ThyFriendlyFox/via/ee-agent-kit/docs/ARCHITECTURE.md

# Architecture

EE Workcenter is a toolchain installer, a Python command line, and a set
of skills that together run 4 gates on a KiCad 10 project. The table
has its 10 parts.

| Part | Folder | Task |
|---|---|---|
| Installer | `install.sh`, `requirements.txt` | Puts KiCad 10, ngspice, Java 21, FreeRouting, and a Python venv on an Ubuntu 24.04 machine. Idempotent. |
| CLI | `tools/workcenter` | Runs the engines against a project and reports 1 record per gate. `design` builds a design file, `render` makes images. Standard library only. |
| Generator | `tools/kicadgen.py` | Turns a Python design (parts from the KiCad libraries, nets, positions) into schematic, board, project, Specctra DSN, and merges the routed session back. Standard library only. |
| Skills | `.claude/skills/*/SKILL.md` | Tell the agent which gate comes next and how to read a report. Loaded by Claude Code from this repository or from a copy. |
| Fixture boards | `tests/boards/*`, `tests/test_gates.py` | The tests of the gates. 1 board passes everything; the others fail 1 named gate. |
| Manifest | `WORKCENTER.md` | The contract a project gets: tools, skills, gates, paths, requirements. |
| Templates | `templates/` | The files a project starts from: the verification package (`workcenter verify --init` copies `templates/verification/`), the brief and facts file for helpers on one package, and a first design file, a version's README and gates report (`templates/project/`). |
| Environment | `environment/`, `Dockerfile` | The 2 ways the installer reaches a machine: a Claude Code cloud environment setup script, or a Docker image on the official KiCad base. |
| Website | `site/` | 1 static page that says what the workcenter is, with real runs of its commands and a fixture board from its design file. Plain HTML, 1 stylesheet, 1 script; no install step. `site/build.sh` writes the folder a host serves. `site/media/` holds the pictures of the root `README.md`, each with the command that draws it. `tests/test_docs.py` holds the site's runs, its links and its build to the code, and each picture to the README that shows it. |
| Kit | `ee-agent-kit/` | How work on this repository is run. Process, not product. |

## Data flow

1. A cloud environment (or a Dockerfile, or CI) runs `install.sh`. It
   writes the KiCad PPA source, installs the packages, downloads the
   FreeRouting JAR, creates the venv, links `workcenter` onto `PATH`,
   and copies `WORKCENTER.md` to `/opt/workcenters/ee/`.
2. An agent opens a board repository in that environment. With 2
   repositories attached, the `attached-repos` skill assigns roles:
   the board is the project, this repository is the workcenter.
3. The agent runs `workcenter gates <project>`.
4. The CLI finds `<name>.kicad_pro` and its siblings, then calls
   `kicad-cli sch erc`, `kicad-cli pcb drc`, `ngspice -b`, and
   `kicad-cli pcb export ...` in that order, each writing into
   `<project>/build/`.
5. The CLI parses each JSON report or log into a gate record and stops
   at the first red gate. All records land in `build/gates.json` and on
   stdout, as text or `--json`.
6. The agent reads the red gate's report, fixes the schematic or board,
   commits, and runs step 3 again.
7. GREEN: `build/fab/` holds gerbers, drill files, the BOM, and the
   schematic PDF. `workcenter render` adds the images. The board is done.

A generated board enters at step 3 from `workcenter design design.py
--route`: the generator loads the libraries, writes the DSN, runs
FreeRouting, merges the session, and writes the `.kicad_*` files that the
gates then read like any other project. With `--seed <board>` the
generator first reads a previous board's tracks and vias (`board_copper`),
keeps the router copper that still fits the design (`seed_wiring`), and
writes it into the DSN, held where it connects and unfixed at its loose ends.

## CLI

| File | Task |
|---|---|
| `tools/workcenter` | `find_project`, 1 `gate_*` function per gate, `gate_render` (with `parts_without_body`), `gate_procure` (parts files, `order_for`), `cmd_gates` for the ordered run, `cmd_design` for design files and `check_design` for `--check`, `cmd_sim` for one deck (`--deck`, `--keep`), `cmd_doctor` for engine status, `emit` for output and exit codes. Tools that are not gates: `cmd_fetch` (a library file and its `sources.csv` row), `cmd_curve` (a PDF's curves on a plot's axes: `outline_middle`, `crossings`), `cmd_ci` (a GitHub workflow replayed), `cmd_mutate` (a firmware's mutation list). |
| `tools/pdfcurve.py` | One PDF page's vector paths and text lines as JSON, with pdfminer under the venv; `curve` reads its output. |
| `tools/kicadgen.py` | `parse`/`dumps` for S-expressions, `load_symbol`/`load_footprint`, `Design` with `schematic()` (stub-and-label, or wired by `SchRouter` when `sch_wires` is set), `board()`, `project()`, `dsn()` (with each layer's hole clearance from `hole_clearances()`), `merge_ses()`, `seed_wiring()`, `write()` (island stitching recorded in `stitches`); `load_design()`, `board_copper()` and `route()` for the CLI; `symbol_add()` for a symbol from a datasheet's pin table. |
| `tools/inspect_board.py` | The engine of `workcenter inspect`: a `Board` read with KiCad's `pcbnew` (items, rule areas, courtyards, the stackup, the project's net classes and `.kicad_dru`), `touch`/`groups` for connectivity, one `cmd_*` per view. The CLI runs it under the venv's Python with its arguments as JSON; it writes only `map`'s images. |
| `tools/stretch.py` | Grows a design file at a cut through Python's `ast`: board x-coordinates in code move, comments and strings never do. Standard library only. |
| `tools/doctools.py` | The document commands: `docs`, `costs`, `pictures`, `version new`, `diagram`, and `gates_report()` for `gates --report`. `register()` adds them to the workcenter's parser with the CLI module as `cli`, so they report through its `Result` and `emit` and reuse `gate_procure` and `gate_render`. Marked blocks (`fill_block`) are the only text they rewrite in a hand-written file. Standard library only. |
| `tools/scene.py` | Assembly scenes: a routed board loaded with KiCad's `pcbnew`, bodies on empty anchor footprints, stills from kicad-cli, the turning GIF from `workcenter render --views spin`. Runs under the venv's Python; a project's scene script imports it. |

## Boundaries

| Boundary | Rule |
|---|---|
| CLI ↔ engines | Subprocess only. The CLI reads the engines' report files; it never imports KiCad or ngspice libraries. A venv package (pcbnew, shapely, pdfminer, PyYAML) runs in a subprocess under the venv's Python and hands back text or JSON. |
| Workcenter ↔ project | The workcenter reads the project and writes only `<project>/build/` or `--out`. Project source files are never modified by a gate run. |
| Kit ↔ code | The kit is read by agents and humans. Nothing executes it. `verify/verify.sh` checks its invariants (placeholders, skill parity). |
| Installer ↔ everything else | Every other part assumes the installer ran. Nothing else installs software. |
