ThyFriendlyFox/via/ee-agent-kit/STATUS.md

# STATUS.md — where the project actually stands

The single source of truth for project state. Claims require evidence: a
passing gate, a linked run, a tag. Updated in the same commit as the
behavior change. The weekly cycle (WEEKLY.md step 5) refreshes it.

| Area | State | Evidence |
|---|---|---|
| `install.sh` on Ubuntu 24.04 | ✅ | CI run 1 on PR #1 green in 69 s; runs end to end in the cloud session. |
| Gates ERC, DRC, SIM, EXPORT | ✅ | `make verify`: fixture `pass-rc-divider` GREEN with `--strict`, `fail-drc-clearance` red at DRC, `fail-sim-spec` red at SIM. `tests/test_simgate.py` (39 tests): an `altermod` line with 2 parameters failing its deck with the one ngspice drops named, an analysis ngspice gave up on fails its deck though a later one completed, a corner ngspice does not finish fails with its first error line and its log named, a complex value is no measure, each way an expect file is refused (a bound that is no finite number and `"at": "nominal"` with no source among them), a value ngspice reads as another number failing its deck, a name printed 2 times judged on each value, a floating node warned and failing `--strict`, a `.spiceinit` in the user's home left out of a deck and of a corner, every warning printed with the verdict as the last line, a count of jobs under 0 a usage error, the verdict lines (`GREEN with N warnings`; `GREEN ... (nothing to run for: erc, drc, export)`; `SKIPPED (SIM: engine missing)` with exit code 2 and never GREEN; `REQUIREMENTS MET` only when every one passes at its corners). |
| SIM corners | ✅ | `sim/corners.json`, `tools/simcorners.py`. `tests/test_corners.py` (83 tests): an `altermod` line with several parameters named, the file's refusals (a range without its source, a `fill:` left in, an unknown key or deck), values found in elements, `.param` lines, a deck's own `.subckt` and 5 forms of `alter`, on a continuation line, behind `r=` and as an expression; each corner's text; 2 parts written from 1 parameter moving apart; each part alone at both ends and half-way; a measure that peaks inside a range closed in on (a series LC's gain 1.0 with its capacitor 13.4 % low, 0.239 and 0.072 at the ends); every combination of the ends (a bridge's 0.25 V with 4 resistors off together, 0.064 V with 1); the warning above 64 runs; a supply moved by its source; seeded draws that repeat, with their temperatures inside the named range; a deck that sets its own temperature and an element held at one; bounds held as written only; the word-named parts a tolerance run left at their written value. Fixtures: `pass-rc-divider` 46 corner runs, `vout` 2.4605 to 2.54175 V inside 2.45 to 2.55, margin 8.25 mV; `fail-sim-corner` inside both bounds as written, 32 corner runs, `vref` 0.4216 V at 85 C with R1 +5 % and 5 more corners, `vout` 2.625 V at R1 -5 %, R2 +5 % and 9 more. On a scratch copy of Last Hit v0.16, 1 % resistors and 20 % capacitors: 12 decks, 678 corner runs where the first search made 153, 0 failures and 22 warnings over the board's 0 to 40 C; over -20 to 85 C, 5 failures: the 6 A current-sense reading 1.0763 V at 85 C with R7 and R16 1 % low (and 8 more corners) against 1.14 to 1.26 V, 3 more bounds of that deck, and the MOSFET deck's transient aborting at -20 C. The second run took 454 s on 4 processors. |
| Frequency plan | ✅ | `sim/frequency-plan.json`, `tools/freqplan.py`, P30. `tests/test_freqplan.py` (43 tests): a source read in every form a deck writes it and named when its frequency is no number, bands from a guard or from Q, a harmonic in a band, 2 sources that can run at 1 frequency, an answer that needs a bounded measure and the element that drives it, a stale answer, a stimulus outside every source, resonances read across the corners, a resonance that meets its source between the ends of its parts (22.0 mV against 17 mV, 13.2 mV at most at the ends), a resonance from a deck with no corner refused, a plan's measure missing at a corner refused. Fixtures: `pass-lc-filter` GREEN with `--strict` (3 decks, 94 corner runs, the 15.9 kHz resonance between 13.26 and 19.84 kHz over its parts' 20 %, the clock's overlap answered by a deck run with L stepped against C); `fail-freq-overlap` red on the plan alone: the load's third harmonic in the band, the rail swinging 6.78 V while its average holds. |
| Deck bundles | ✅ | `workcenter sim --bundle DIR`. 7 tests in `tests/test_simgate.py`: a bundle run from another folder with an empty home gives the gate's numbers, the deck alone does not, a bundle that gives another number is named, a model's own includes come along, a deck that reads a file beside it runs from anywhere, a path with a space runs, a folder that is no bundle is refused and left as it was. On a scratch copy of Last Hit v0.16 the 12 decks' bundles each give the gate's measures from another folder, and no file in them names a path of the machine; run bare, 3 of those decks stop with an error and 3 print other numbers with exit code 0 (M105). |
| `workcenter next` | ✅ | `tools/guide.py`. `tests/test_guide.py` (72 tests): the crowded `altermod` failure sent to the simulate skill's rule, every hint points at a file and a heading that exist, each kind of failure line gets its fix, no sentence it prints is over 20 words, a path to a file answered with its project's folder, a folder with 2 project files told to name 1, a folder that is not there made first, an empty folder given the 2 ways to start and no RUN line, the gates run first and again when an input is newer, a red gate gets its first failure, GREEN with a warning is not done, an absent engine gets the install step and a report from a run without it is run again once it is found, a package is done only with its requirements met, a design file that is refused answered with its first problem, a finished project given no command, the project left as it was, the fixtures walked to their answers. On 2026-11-11 the smallest model took a supply filter from a paragraph to `gates --strict` GREEN with it (131 corner runs; it moved the filter's resonance off the PWM when the plan failed), then a filter board: ERC 0 errors, DRC 0 errors and 0 unconnected, 1 deck over 14 corner runs, 22 gerber files, in 38 tool calls. |
| A first design file | ✅ | `templates/project/design.py` and the generator's refusals. `tests/test_designfile.py` (14 tests): the template generates, routes and passes ERC and DRC as it stands; a part added to it without its simulation is refused; a namespace that is no UUID, `power_nets` that is no dict, a flagged net with no power symbol and a symbol the library lacks each stop with the line to write; a part placed from another origin is a `part:` line with its place in board coordinates; a part that overhangs the edge is kept; a route that joins nothing is exit 1; the `pull:` line ends with its entry; a refused design file is 1 `file:` line with its line number. Both designs of Last Hit v0.16 regenerate to their committed bytes. |
| Documents held to the code | ✅ | `tests/test_docs.py` (21 tests): each example page is what `site/examples.py` writes from the example's files; each value a check's drawing marks is a number of its test circuit's files or of a run on the page; every flag a document gives a command against that command's `--help`, the site's page and `site/media/README.md` among the documents; `--json` on either side of the command; every command in `README.md` and `WORKCENTER.md`, every skill, every tool file, every fixture's row, every cited mistake and process, the repository's name, root `AGENTS.md` equal to `CLAUDE.md` (`make verify` checks that too); each of the 8 runs the README, the site and the Open Graph page show (1 on the example project) against a fresh run of its command, the seconds and the checkout's folder apart; every picture and link in the README and in `site/media/README.md`, each picture in `site/media/` shown there, and the code the site's page and the first picture show a run of lines of the fixture's design file; the count of commands the README states; no commit in the history of the checked-out branch names an assistant as its author or credits one in its message (the owner's decision of 2026-11-11); older branches of the remote still hold such commits until the owner deletes them. |
| Example project, a motherboard | 🚧 | `examples/threadripper-matx/`, Basalt: a microATX board for Threadripper on sTR5 in version folders, built in a loop logged in its `LOOP.md`. v0.1 (the floor plan, the 4844-land socket, 14 phases, every supply in a pour), v0.2 (the DDR5 buses, 576 traces) and v0.3 (77 parts of ports and headers): `workcenter gates` GREEN with no warning on each. The PCI Express and M.2 lanes are not drawn: 151 of 234 route on a scratch copy (its v0.3 README, "Open items"). Not ordered. |
| Example projects | ✅ | `examples/universal-controller/v0.2`, Rosetta on an Xbox 360-style board: `workcenter gates .` GREEN with 6 warnings (silkscreen at the edge: the 2 USB receptacles, the ESP32 module, the regulator); 6 decks, 370 corner runs; `render --strict`; `make -C firmware test`. v0.1 is archived. Not ordered; firmware is the knob's decoder only (its README, "What is open"). Signet, `examples/ring-mouse` (v0.1 to v0.4, a version per pass of its loop): every tile of v0.4 GREEN, the radio with 2 legend warnings (the module's outline over its antenna edge) and the power tile with 1 (the charger's pin-1 mark at a joint pad); 1 deck, 52 corner runs; `make -C firmware test`; `ring.py` refuses a ring whose neighbours miss their shared corner. Not ordered; the module's datasheet and the IMU's axes not read (its README, "Open items"). `examples/fire-alarm-communicator/v0.1`, Herald: `workcenter gates .` GREEN with 7 warnings (the silkscreen of the 5 terminal blocks and the USB receptacle at the edge they face); 8 decks, 573 corner runs; `make -C firmware test` (the inputs, the hook, a DTMF decoder held to ITU-T Q.24's limits, a whole Contact ID call). Not ordered; the station's protocol and the radios' firmware are not written (its README, "What is open"). `examples/anc-speaker/v0.1`, Hush: `workcenter gates .` GREEN with 6 warnings (the silkscreen of the jack and the switch crossing the edge they hang over, and TI's model warning in the deck that checks the fitted one against it); 7 decks, 986 corner runs. Not ordered, no verification package yet (its README, "Open items"). `examples/snapdragon-dev-board/v0.2`, Wyvern, one flat board with a QCS6490 module soldered on by its 662 pads: `workcenter gates .` GREEN with 16 warnings (5 silkscreen outlines at the edge, 4 vias with nothing past them, 7 decks with no temperature term): DRC 0 errors and 0 unconnected; 7 decks, 397 corner runs, a frequency plan with no overlap; v0.1, the Snapdragon 845 module on 3 sockets, is archived; laid out as a board repository (series README, `parts/` priced by `workcenter costs`, `library/sources.csv`, `CONTENTS.md` by `workcenter docs`, pictures by `workcenter pictures`). Not ordered; no firmware (its README, "Open items"). |
| Website | ✅ | `site/`: a home page with 4 runs: the owner's headline under the wordmark, built as a board is; a strip of the 21 agents Via works with; the example project Herald (a drawing of its routed board, copper first, its 127 parts labelled from the design file, 4 at a time, 1 of them swapped for the next every 3 seconds, KiCad's library with 12 datasheets' first pages, its README and its gates report, a 3D model the reader turns, loaded only as the reader nears it, its gates run); a card in 3D for each of Herald, Hush, Signet, Rosetta, Wyvern and Agentcast; the 4 checks as 6 drawings of test circuits a check stopped; and Herald's supervised inputs as code, schematic and routed board. A page for each of the 6 examples in `examples/`, written by `site/examples.py` from its README, its versions' TIMELINE.md or "What changed" sections and its board: a turntable, a board explorer drawn from its `.kicad_pcb`, its checks, its steps and what is open. The redrawn site is on the branch `claude/wonderful-planck-hz2c8o`, in a preview, until it merges; copy written to the website section of `docs/STYLE.md`, no fixture board shown as a product; the Via wordmark; motion with Motion 14.6.0, still for a reader who asks for reduced motion; `og.png` (1280 x 640); live at <https://via-kappa-five.vercel.app>. On 2026-11-11 that address answered 200 with the canonical link and the Open Graph tags of its own address, every file the page names answered 200, and an unknown path answered 404 with the site's own page. Production follows `main`: on 2026-11-11 Vercel built it from `main` after the push that collapsed the branches. On 2026-11-12 <https://via.reagent-systems.com>, the address the canonical link names, answered 200 through Cloudflare, which keeps a stylesheet, a script or a picture 4 hours and the page 0. `tests/test_docs.py`: every link names a file, an id or a path in the tree; `site/build.sh` builds with an address and without one, names `site.css`, `site.js` and `effects.js` with their checksum, copies every file a built page names and every datasheet page a label names, at the size the label reserves, and refuses a folder that is not empty and an address that is none; the image has the size the page states. |
| `kicadgen` design generator | ✅ | `tests/test_kicadgen.py` (87 tests): wired schematics (pin positions at each angle as KiCad's ERC reports them, crossings and ends the router keeps, a wired divider ERC-clean with its declared netlist and no parity warning, labels where asked, off-grid pins refused, the stub-and-label default unchanged, a symbol drawn as banks wired between its banks, an A0 sheet wired across its width), the hand-via check's grid finding what holding each via to everything finds, in the same order, parser, derived symbols, open-pin nets, DSN with planes and fixed wiring, session scale and echo handling, pours filled and stitched, hand routes, rounded corners and stadiums, a radius per corner, board thickness and the two-layer stackup, project footprints, keep-outs in both via placers, non-plated holes in the via check and in the router file, four-layer boards (inner layers, stackup, a plane the router never sees, a real route on three layers, island vias to the plane and clear of tracks on the layers they pass), custom pads mirrored onto the bottom face, sized from their shapes, and handed to the router as their outline, the hand-via check and the design command's refusal, via sizes against the board's rules, the no-`cd` hook, the hook against scripted test edits and the installer of both, per-part 3D bodies, `wrlgen` bodies. Real boards GREEN in their own repository; the latest is 38.0 x 12.7 mm on four layers, two 510 connectors and a 10440 cell in a line, keep-outs under the collars, every chip on the bottom face, and a two-layer 0.8 mm display board standing on its flat end. |
| A generated schematic that simulates | ✅ | `d.sim`, `d.no_sim`, `d.sim_directives`, `d.check_sim` in `kicadgen`; `Design.sim_problems()`; the `sim:` lines of `workcenter design`. `tests/test_simfields.py` (21 tests): the values KiCad reads as numbers, a library read for its subcircuits and models, the fields on each symbol and, hidden, on its footprint, a bound part on a board with no parity warning, each wrong binding's line, a map that is not whole bound by position by KiCad 10.0.8 with exit code 0 and refused by the check, the ERC reporting a library that is not there, the exported netlist run in ngspice against 4 voltages computed by hand, `workcenter design` exit 1 with its `sim:` lines. On a scratch copy of Last Hit v0.16: 0 placeholder lines in the exported netlist where there were 29, and its current-sense reading 1.198 V at 27 C, 1.099 V at 85 C, as the hand-typed deck gives. Not checked: KiCad's own simulator window, which has no command line. |
| Autoroute, generated designs | ✅ | `workcenter design --route --rounds [--seed BOARD]`: DSN writer, FreeRouting, session merge, pour islands stitched or re-routed, each stitching via named with its island, a red run's last line naming its failures. Two round-trip tests make DRC GREEN when FreeRouting is installed. `tests/test_routing.py` (11 tests): each layer's hole clearance read from the fab's rules, written into the DSN as grown via and pad copper and held by every via check; a fixture where the old DSN put a router via 0.3281 mm from an inner track (Sierra wants 0.3302) and the new one keeps 0.3581; a bus routed, a part moved onto a track and routed again from the seed with the five untouched lines kept; the seed's sifting by reason; both net forms read from a board; the stitch and red lines; a T-link the merge keeps. |
| Autoroute, hand-drawn boards | 🚧 | Produces a session from a KiCad-exported DSN; import is manual. ROADMAP item 3, "Headless autoroute for hand-drawn boards". |
| `workcenter render` | ✅ | Schematic, board top and bottom, 3D top, bottom and isometric images with part bodies when `kicad-packages3d` is installed, plus the project's own `wrlgen` bodies; every layer with something on it, one PNG each, and an overview sheet; on request a GIF of the 3D board turning round (FFmpeg). Each 3D view in the board's own stackup colours (since 2026-11-11; green before, whatever the stackup named). PNG through librsvg. `tests/test_gates.py` (27 tests): layers drawn and empty ones skipped on the fixture, the view list, the GIF's frames and loop, the skip without FFmpeg, the parts drawn without a 3D body and `--strict` failing on one, every 3D render asked for the stackup's colours. |
| `workcenter procure` | ✅ | A schematic's BOM priced from parts files: the cheapest order per line at each unit count, totals per supplier, lines not priced, short of stock or checked too long ago. `tests/test_gates.py`: the fixture priced to the cent, the failures and the skip. |
| Skills | ✅ | 9 skills with frontmatter, checked by `make verify`; `kistack` routes to 11 vendored kistack skills. |
| `workcenter placement` (kistack) | ✅ | `tests/test_placement.py` (6 tests): kistack's checks on its own synthetic board read through the pcbnew stand-in, with the answers kistack's tests expect (pin 1 VDD, a decoupler with its ground pad toward the pin, every local link routed together); `move` and unknown checks refused. |
| Pull-resistor check | ✅ | `tests/test_pulls.py` (6 tests): a gate only an MCU pin drives is reported; a pull to a rail or to the gate's own source holds it; a series resistor does not; an output pin drives the net; switches and I2C lines need a level and a declared net is taken; `workcenter design` lists them and fails only with `check_pulls`. On Last Hit v0.10 and v0.11 it reports the button (the MCU's internal pull-up) and the display's I2C lines (pulled up on the display board), and no gate or enable. |
| Fab rule sets | ✅ | `rules/sierra-circuits-web.kicad_dru` with its sources; `tests/test_fab.py` (9 tests): the fixture `fail-fab-sierra` GREEN plain and red with `--fab`, the passing divider within Sierra's limits and left untouched, an unknown fab refused, the board-wide minimums, `Design.fab` writing the rules and refusing a 0.6/0.3 mm via, a 0.3 mm net class still failing at 0.25 mm under the fab, the project rule file never looser than the board (M62). |
| Part sources and vendor models | ✅ | `workcenter sources`: a datasheet row for every part, a spice row for every U, Q and D, each kept file unchanged and printing its revision, each model loading in ngspice with its sub-models; `--fetch` under the workcenter's own name. The SIM gate runs a deck's listed vendor models translated into `build/` and holds each to its datasheet with `warn` bounds. `tests/test_sources.py` (13 tests): the reference prefixes, PSpice RES models folded and tolerances dropped, rows refused, a library that holds what its rows say and every file the command writes, each way one drifts, the skip with no library and the error on a bad row, a fetch from a local server (same, changed, refused, the agent named), a translated model in a deck run from its own folder, a warn bound failing only `--strict`. On Last Hit v0.12 both boards pass with 24 files kept; TI's TLV75533P model is 1.25% high and its light-load dropout ten times the datasheet's, Diodes' ZXCT1009 model inside every row of its table. |
| `workcenter inspect`, `tools/stretch.py`, parts keep-outs | ✅ | `tests/test_inspect.py` (21 tests) on the fixture `inspect-four-layer` (four layers, a 10 mm In2 run, a copper and a parts keep-out, Sierra's rule file, a pour island on purpose): a known run's resistance from first principles, a T-junction without a stackup, the 13 mil inner drill rule inside its 5 µm window, a keep-out and a courtyard overlap by name, a new part from its footprint, a net cut in two, the island, the crossed net left open, the window's items, one PNG per layer, the fixture regenerating byte for byte, `stretch.py` on code and not comments; `tests/test_kicadgen.py`: the parts keep-out in the board, the DRC and `workcenter design`. On Last Hit v0.16 the joint's In2 run reads 56.8 mOhm and C5 to U2 64.3 mOhm. |
| Verification packages | ✅ | `workcenter verify` and P28. `tests/test_verify.py` (32 tests): a complete package passing and its report; a check judged at its measure's least and greatest corner and failing there with the corner named, whatever the deck's own bound says; a requirement whose deck ran no corner judged as written only, not met and failing `--strict`; an expect file that is not JSON as 1 problem line; `--strict` failing a package with no corners; the last line `REQUIREMENTS MET` or `NOT MET`; `--strict` on an OPEN requirement; a quoted number off the run; a rounded quote that matches; a verdict against its check; a requirement with no row; a deck with no writeup; a writeup without its nodal analysis; a dead link; a requirement with no source; the skips with no package and no ngspice; `--init` writing and never overwriting, and leaving the helpers' `BRIEF.md` and `FACTS.md` out; units and checks parsed; the owner's decisions (a withdrawn requirement named and out of the counts, refused in the traceability table, in a requirements table and in an expect bound, its date and who made it required; a restated requirement's dated decision). The Last Hit v0.14 package passes: 60 requirements (40 PASS, 15 FAIL, 5 OPEN), 175 quoted values matching the run; v0.16's with REQ-USB-01 in a Withdrawn table: 64 requirements (56 PASS, 2 FAIL, 6 OPEN), REQ-USB-01 named, 276 quoted values matching the run. |
| Document commands | ✅ | `workcenter docs`, `costs`, `pictures`, `gates --report`, `version new`, `diagram` and `tools/scene.py`. `tests/test_doctools.py` (21 tests): a marker named in a sentence taken as prose, a version's contents and datasheets (series sheets, a part with no row, a stale copy removed, a hand-placed file kept, the refusal without a list), every board of two versions priced to the cent into two marked files and an unclosed block named, the gates report refreshed round hand-written prose, P22's steps on a git repository with its step 4 check, the diagram's routes and legend, the pictures manifest, its framing check and its copies, a scene placed, rendered and turned. On a copy of Last Hit: `costs` reproduces all 26 lists and the 16 versions' totals, `docs v0.16` the datasheet table, `version new v0.17` passes P22 step 4. |
| Datasheets, simulation and CI tools | ✅ | `workcenter fetch`, `curve`, `sim --deck --keep`, `design --check`, `ci`, `mutate`; `kicadgen.py symbol-add`. `tests/test_fetch.py` (6: a file and its row, the append in the file's own line ends, a duplicate refused before any request, a 403 asked once and nothing written, a file that differs left alone, a zip member), `test_curve.py` (7: an outline's middle, crossings in decades, malformed axes, a PDF the test writes listed and mapped through pdfminer, the venv's pins), `test_ci.py` (4: environment carried, `needs` ordered, red at the failing step, what cannot replay, working directories), `test_mutate.py` (3: caught, survived, did not build, a stale `build/` left out, anchors first, a Python list read as a literal), 2 in `test_sources.py` (one deck the gate's way, the hand-run command reproducing it), 4 in `test_kicadgen.py` (`--check` same, differs, the design step's own failure; `symbol-add` on the grid, appended, refused, ERC-clean in a design). On Last Hit v0.16: `fw_is` 0.505 V, `design --check` exit 0, 50 of 50 mutations caught; the board's firmware CI job replayed GREEN on a copy (12 versions); the fuse datasheet fetched once with the SHA256 its row records. |
| Chip gates, from RTL to a mask layout | ✅ | `workcenter chip gates` runs LINT, SIM, SYNTH, LAYOUT, STA, GLSIM, DRC, ANTENNA, LVS and EXPORT on the sky130A process. `tests/test_chipflow.py` (94 tests), `tests/test_chipfront.py` (32) and `tests/test_chipback.py` (45) hold the readers and each gate's judgement to real reports of its engine, kept under `tests/chips/samples/`. `tests/test_chips.py` (15 items) runs 9 fixture chips: 7 are red at 1 gate each, and `pass-counter` and the acceptance processor `pass-acc8` are GREEN with `--strict`. SIM proves the benches on every run: it makes each change of `rtl/mutations.json` in a copy of the RTL, and all 5 and all 18 are caught. `workcenter next` names a chip project's one next step (`tests/test_chipguide.py` (30 tests): its answers alone take the template from its first file to GREEN), and the skills `chip-design` and `chip-gates` hold the procedure. The processor is 760 cells and 132 flops on a die of 152.38 um by 152.38 um with a 40 ns clock. Its run takes 217 s on 4 processors; the least setup slack is 25.1717 ns at `max_ss_n40C_1v60` and the least hold slack 0.2974 ns at `min_ff_n40C_1v95`. Every gate leaves a record of the files it read and wrote, the project's files as its engine lists them, and EXPORT asks all 9 before it hands out the layout: a header changed after LINT passed, a bench's bounds added after SIM passed, or a layout built from an older netlist is refused. `workcenter next` holds the files to the same records before it says a chip is done. A small model built 2 chips of its own with `next` alone on 2026-11-12: an 8-bit PWM that passed all 10 gates and stopped at `--strict`, on a limit the guide did not explain; then, with that mended, a UART transmitter to GREEN with `--strict` in 13 answers. A reviewer who had not written the gates attacked their judgements (P14 step 6): 15 cases, each a test now (M169). GREEN says that the open engines found no fault: no foundry deck runs here. Shipped 2026-11-12. |
| Mistake log and processes | ✅ | `MISTAKES.md` M1 to M180, `PROCESSES.md` P1 to P34; `make verify` checks every entry names an existing process and every process has a "Done when" line. |
| Cloud environment | 🚧 | `environment/setup.sh` written; not yet set on an environment by a human. |
| Docker image | 🚧 | `Dockerfile` written; `release.yml` builds it on the first tag. On 2026-11-11 it was built in a cloud session (with the session proxy's CA added in a scratch Dockerfile), and the example project was designed, routed and gated in it: `workcenter doctor` all engines ok, KiCad 10.0.8, ngspice 44. Before `install.sh` added the full Java runtime on Debian, the image could not route. With ngspice 44, `tests/test_simgate.py::test_a_bundle_that_gives_another_number_than_the_gate_is_named` fails: it expects ngspice 42's 1 error line and gets 2. |
| CI | ✅ | `ci.yml` green on PR #1; runs on every PR and push to `main`. |

States: ✅ done (gated) · 🚧 in progress · ❌ not started · 🧊 frozen/won't do.

## Current week

- **Shipping:** out-of-band — corners, a frequency plan and bundles in the SIM gate, verdicts that say what ran, and `workcenter next`, from an engineer's review of Last Hit v0.16; then what 2 reviews of that work and 2 runs by a small model found. Chip design, from RTL to a mask layout, shipped on 2026-11-12: 10 gates from RTL to a GDSII layout on an open process, an 8-bit processor GREEN with `--strict`, and a small model's own chip built with `next` alone. The repository's public face (the website in `site/`, the Open Graph image, the README's head) shipped out of band on 2026-11-11. Later that day an example project, Rosetta, and a site that moves shipped out of band, and then a second, Signet, a mouse worn as a ring, and a third, Herald, a fire alarm communicator. The same day the owner had the branches collapsed into `main`: it holds the gates work and the site, 55 commits that name the owner alone.
- **Last release:** none
- **Known red:** none locally. The cloud setup script and the Docker build have not run yet.
