ThyFriendlyFox/via/ee-agent-kit/ROADMAP.md

# ROADMAP.md — the source of all work

**This file is not optional.** Every feature the agent builds flows down
from here. If it isn't on this roadmap, it doesn't get built; if it needs
building, it gets added here first. One item ships per weekly cycle
(see `WEEKLY.md`).

`provisional: true` — the queue below was seeded at setup by the agent.
The human re-orders it.

## North star

EE Workcenter is the environment an agent steps into to take a KiCad
project from schematic to fabrication outputs with every gate green,
without a human running a tool by hand. Everything here serves that:
the toolchain installs itself, the gates are the definition of done, and
the skills tell the agent which gate comes next.

The owner's measure, 2026-11-10: a small model reaches the same working
design as a large one, and no electrical engineer has to find afterwards
what the gates left out. So what an engineer would ask lives in a gate
that runs it (corners, the frequency plan), and what comes next lives in a
command that says it (`workcenter next`), never in the reader's judgement.

## Feature Queue — ordered; top unblocked item ships next

### 1. A circuit walked stage by stage
- **Promise:** A command writes 1 page for a power or signal path from the project's decks and their corner records. Each stage is a chain: given, equation, computed value, the deck's measure with its span over the corners, what follows, and what the stage hands on. The range a stage is given is the range the stage before it hands on, and the command fails a page where the 2 differ. A node table gives each node's value under each condition, and every stage states its margin.
- **Evidence:** The page the reviewing engineer wrote by hand for Last Hit v0.16's power path (9 stages and a summary, on the project's branch `community/power-path-breadboard-notes`), written again by the command from the project's files with every number matching a fresh run. The thin margin that page found, a hardware trip at 6.17 A over a firmware limit of 6 A, is named by the command.
- **Use case:** Review a board before the bench (a new use case).
- **Scope guard:** The designer writes each equation in a writeup (P28). The command checks the chain and assembles the page. It derives nothing.
- **Status:** ready

### 2. A bench plan with the readings the decks predict
- **Promise:** A command writes a bench plan for a board, stage by stage: the stand-in for each part a breadboard cannot hold, what the breadboard cannot prove and which deck or board test proves it instead, the stand-ins for the controller's lines, the instruments, and for each test point the reading the decks predict with its span over the corners.
- **Evidence:** The reviewing engineer's breadboard notes for Last Hit v0.16 (the same branch) written again by the command: the stage-by-stage substitutes, the list of what a breadboard cannot prove, and each expected reading taken from a corner record.
- **Use case:** Bring a board up on the bench (a new use case).
- **Scope guard:** A stand-in comes from a table a person fills, each row with its source and what differs from the board's part. The command never invents an equivalence.
- **Status:** ready

### 3. Headless autoroute for hand-drawn boards
- **Promise:** `workcenter autoroute --apply <project>` reads any `.kicad_pcb` (footprints, pads, outline, nets, existing tracks) into the DSN writer that `kicadgen` already has, runs FreeRouting, merges the session into the board file, and the new fixture `route-me` passes DRC with 0 unconnected items afterwards, with no KiCad GUI step.
- **Evidence:** `tests/test_gates.py::test_autoroute_apply_routes_fixture` green in `make verify`; the fixture's DRC report attached to the PR.
- **Use case:** Route a board (`docs/USE-CASES.md`).
- **Scope guard:** No routing heuristics of our own. No GUI automation. The generated-design path already works (`workcenter design --route`); this item is the board-file parser in front of it. Zones and arcs may be out of scope for the first cut and must be reported, not silently dropped.
- **Status:** ready

### 4. Board gates as a reusable GitHub workflow for board repositories
- **Promise:** A board repository that adds 1 workflow calling `ThyFriendlyFox/via/.github/workflows/board-gates.yml@main` gets `workcenter gates` run on every PR, with the gates table in the job summary and a red check on a red gate.
- **Evidence:** A run link from a board repository, plus `tests/boards/pass-rc-divider` run through the workflow in this repository's CI.
- **Use case:** Review a board PR.
- **Scope guard:** No comments posted to the PR; the check and the summary are the output.
- **Status:** ready

### 5. MCP server for hosts that are not Claude Code
- **Promise:** `workcenter mcp` serves `doctor`, `gates`, `erc`, `drc`, `sim`, `export`, and `autoroute` as MCP tools over stdio, and the MCP inspector lists all 7 with their schemas.
- **Evidence:** An inspector screenshot and a test that drives the server with a scripted JSON-RPC session.
- **Use case:** Build another workcenter from this one.
- **Scope guard:** stdio only; no HTTP transport, no auth.
- **Status:** ready

## Later — candidates, not yet specced

- Copper pours in `kicadgen` — a zone per power net with `kicad-cli pcb drc --refill-zones`, so heater returns stop depending on 0.4 mm tracks.
- Pad-entry width check before routing — warn in `workcenter design` when a net class is wider than its narrowest pad allows.
- SIM gate from the schematic — export the SPICE netlist automatically and apply a stimulus template, so a project without a hand-written deck still gets a simulation.
- `workcenter new <name>` — scaffold a board project with the `.gitignore`, `sim/`, and a passing starter board.
- Publish the workcenter as an account-level Claude Code plugin — skills and the MCP server arrive in every cloud session without touching board repositories.
- BOM availability gate — `workcenter procure --strict` already fails on a line short of stock; a gate would run it before export. Needs a project-wide parts file first.
- Digi-Key API refresh for `procure` — re-read every Digi-Key row's breaks and stock through Product Information v4 with the user's own credentials, instead of page by page.
- STEP export in the EXPORT gate by default once the fixture proves it runs headless in CI within the time budget.
- Per-run output folders for the gates, or a lock on `build/`: two runs on one project at once mix their reports (M73).
- `workcenter sources --fetch` compares PDFs by their bytes; onsemi serves each download with a new trailer ID, so an unchanged datasheet reads as changed. Compare the page content, not the trailer.
- `workcenter placement route_check` at a heater class's widths (0.6 mm) fails links the router and the DRC pass on a dense board; let it take a class per net, as the DRC does.
- `workcenter verify` reads a calculation's verdict as written; an equation checker for the calculations (each numbered line recomputed) would close the gap that M71 fell into.
- `design --check` holds the board too: the committed board without its tracks and vias against the board the design file generates. Today it compares the schematic and the project file; a board whose outline was changed by hand to 30 x 20 mm passed the check and the fixture's test (a review of 2026-11-12).
- A first picture for a phone: at 390 px GitHub draws the README's first picture 324 px wide, and its code is 3.7 px high. A second capture with the 3 cards stacked, chosen by a `media` width in the `picture` element.
- A capture held to its page: `hero.png` is a capture of `hero.html`, and a test holds the page, not the picture. A record of the sources' hashes at capture time would fail a stale capture.
- The CLI's counts in the singular: `1 decks`, `1 errors, 1 warnings` are on the README's first screen.
- EXPORT's count of files: `22 gerber files` counts the drill file, the job file and 11 layers with nothing on them for a 2-layer board of 4 parts.
- Deck values held to the schematic: `kicad-cli sch export netlist --format spice` gives every R and C with its value, so a deck element named like a board reference can be compared with the part it models, a derated value needing its reason. Last Hit's decks write C5 as 2.5 uF in two decks and 4.7 uF in a third.
- A maker's own tolerances as corners: the `tolerance` fix deletes the LOT and DEV specs of a vendor model; kept as a side table they would move the model's internal parts too (`alter r.xu4.r1` reaches one). Last Hit's current sense crosses its bound inside 0 to 40 C once the monitor's 1.5 % is counted.
- What a model carries, declared: a `sources.csv` column, or a probe at 2 temperatures, saying whether a model has temperature in it, so a requirement that rests on one that has none is named. The gate today warns only when no measure of a whole deck moves.
- A requirement that rests on a model off its datasheet: a `warn` bound that fails names the model, and every traceability row whose deck includes that model would carry the name. Last Hit's REQ-REG-01 passes by 13 mV on a dropout its own warn bound calls wrong.
- Accepted warnings as a file the gates read: each warning a project keeps, with its reason, who accepted it and when, so `--strict` passes on those and fails on a new one or on an entry that no longer matches.
- Measures from ngspice's own data: a `wrdata` or raw file the gate reads, so a deck's `echo "vout = 2.5"` cannot stand for a measure.
- A rail's impedance deck written from the board: the capacitors with their ESR and bias, the track's resistance from `inspect resistance`, an inductance from its geometry, so the frequency plan's resonances are not typed by hand.
- Ratings as data: each part's absolute maximum, voltage rating and power in a parts column, so a pin's worst net voltage, a capacitor's derating and a resistor's dissipation are checked by a command, not in a calculation's prose.
- The board as one netlist: a generated schematic now carries its models (`d.sim`), so the SIM gate can export the board's netlist with `kicad-cli` and a deck becomes that netlist plus an overlay of sources and measures; the 12 retyped circuits of a project become 1. Until then nothing holds a deck to the board's parts: a small model's filter passed every gate with its op-amp written as 2 controlled sources in the deck. The design template now turns `check_sim` on, so the design file names each part's model or says why it has none; the deck is still typed by hand. On a copy of Last Hit v0.16 the exported netlist gave the current-sense reading of the hand-typed deck, 1.198 V at 27 C and 1.099 V at 85 C.
- A maker's model KiCad cannot read, at a path a schematic can name: the gate translates a vendor's file into `build/`, which is not committed, and `Sim.Library` needs a file the project keeps. A checked, translated copy beside the library row (its source, its fixes and its SHA256 recorded) would let `d.sim` name it; Diodes' current monitor file fails KiCad's parser as shipped.
- Every register of the RTL held to the netlist: SYNTH names a flop that the mapping removes, and says nothing of a flop that Yosys's `synth` pass removed before it. A view of the design before any cleaning would name each register bit the chip does not hold, for an answer in `chip.json`. 2 things make it more than a comparison of names: a state machine that Yosys writes with other bits, and a memory that becomes flops under other names.
- A part's pin map in its library row: a `Pins` cell in `sources.csv` (`1=VOUT 2=GND 3=EN 4=VIN`), so `d.sim` takes a part's binding from the row of its MPN and the map is written once, where the datasheet is open.

## Shipped

| Week | Feature | Release | Evidence |
|---|---|---|---|
| 2026-11-12 | A chip from RTL to a mask layout (queue item 1 of 2026-11-11): `workcenter chip gates` takes RTL, benches, constraints and `chip.json` through LINT, SIM, SYNTH, LAYOUT, STA, GLSIM, DRC, ANTENNA, LVS and EXPORT on the sky130A process; `chip init` and `chip render`; `workcenter next` for a chip; the skills `chip-design` and `chip-gates`; the engines and the process kit by `install.sh --chip` | unreleased | 9 fixture chips (`tests/test_chips.py`, 15 items): 7 red at 1 gate each, `pass-counter` and the acceptance processor `pass-acc8` GREEN with `--strict` (760 cells and 132 flops on a die of 152.38 um by 152.38 um, 217 s on 4 processors, least setup slack 25.1717 ns at `max_ss_n40C_1v60`, least hold slack 0.2974 ns at `min_ff_n40C_1v95`); 171 tests on the readers and each gate's judgement (`tests/test_chipflow.py`, `tests/test_chipfront.py`, `tests/test_chipback.py`) and 30 on the chip's next step (`tests/test_chipguide.py`); a small model's own UART transmitter GREEN with `--strict` in 13 answers of `next`; a reviewer's 15 cases against the gates, each a test (M169). GREEN says the open engines found no fault: no foundry deck runs here |
| 2026-11-12 | Wyvern v0.2 (`examples/snapdragon-dev-board/v0.2`): one flat board with a QCS6490 OSM Size-L module soldered on by its 662 pads, a buck-boost for its 5.0 V, an HD3SS3220 for its USB 3 lane, the RP2350 on the pins; P14, P16 and P28 extended (M166, M163, M164) | unreleased | the example's `workcenter gates v0.2` GREEN with 16 warnings (5 silkscreen outlines at the edge, 4 vias with nothing past them, 7 decks with no temperature term): DRC 0 errors, 0 unconnected, 0 parity; 7 decks, 397 corner runs, a frequency plan with no overlap; `workcenter design --check` same; `workcenter sources` 0 problems; `make verify` GREEN; `DEVLOG.md` 2026-11-12 |
| 2026-11-11 | A fifth example project, Wyvern (`examples/snapdragon-dev-board`): a Teensy-sized 6-layer board carrying a Snapdragon 845 module, an RP2350 on the pins and USB 3.1 with DisplayPort on 1 USB-C port, laid out as a board repository; its frequency plan; P4 step 11 (M146) | unreleased | the example's `workcenter gates v0.1` GREEN with 13 warnings (5 silkscreen outlines at the edge, 2 vias with nothing past them, 6 decks with no temperature term): DRC 0 errors and 0 unconnected; 6 decks, 488 corner runs; `make verify` GREEN; `DEVLOG.md` 2026-11-11 |
| 2026-11-11 | The repository's public face (out of band): the website in `site/`, 1 static page in the look of the apparatus site with real runs of `gates`, `next` and `sim`; the mark; the Open Graph image `site/og.png` with a dark twin; `site/build.sh` for any static host and `site/vercel.json` for Vercel; the README's head with the picture and 2 runs | unreleased | `tests/test_docs.py` (14 tests): each run a document shows against a fresh run of its command, every link on the site, the build with an address and without one, the image's size; 20 mutants, 18 caught and the 2 masks holding; `DEVLOG.md` 2026-11-11 |
| 2026-11-11 | The front page (out of band): the README opens with the fixture board `pass-first-design` as lines of its design file, its schematic and its routed board, then 2 runs, the board turning and its layers; the pictures in `site/media/` with the command that draws each | unreleased | `tests/test_docs.py` (16 tests) and `tests/test_designfile.py`: the fixture against a fresh build, its gates GREEN, the first picture's code against the design file; `DEVLOG.md` 2026-11-11 |
| 2026-11-11 | A small model builds a board with `next` alone (queue item 1 of 2026-11-11): a first design file starts from `templates/project/design.py`; each trap of a first design file stops with the line to write (`file:`, `part:`, "N unrouted", the `pull:` entry); `workcenter next` gives a command that runs in every state; 2 reviews of the SIM gate and of `next` closed (43 findings) | unreleased | The smallest model a session can start took a second-order low-pass on an op-amp from a paragraph to ERC 0 errors, DRC 0 errors and 0 unconnected, SIM 1 deck with 14 corner runs, EXPORT 4 of 4 outputs, in 38 tool calls, reading what `next` named. Its 8 frictions are closed in `tools/kicadgen.py`, `tools/guide.py`, the template and the skills. `tests/test_designfile.py` (14 tests), `test_guide.py` (71), `test_corners.py` (82), `test_simgate.py` (38), `test_freqplan.py` (43), `test_verify.py` (32); `DEVLOG.md` 2026-11-11, the second entry |
| 2026-11-11 | A generated schematic that simulates (queue item 1 of 2026-11-10): `d.sim`, `d.no_sim`, `d.sim_directives` and `d.check_sim` in `kicadgen`; KiCad's Sim fields written on the symbols; `Design.sim_problems()` and the `sim:` lines of `workcenter design`; `simulation_model_issue` raised to an error in the generated project; `workcenter next` answers a refused design file with its first problem | unreleased | `tests/test_simfields.py` (16 tests): the netlist `kicad-cli` exports from a generated design runs in ngspice and gives 4 voltages computed by hand (a divider 2.5 V, a subcircuit on a 5-pin part 1.75 V, a diode 0.692888 V, a MOSFET on); a map that is not whole is bound by position by KiCad with exit code 0 and refused by the check; a design that says nothing writes none of it, and `inspect-four-layer` regenerates to its bytes. On a scratch copy of Last Hit v0.16 with 10 parts declared and the rest left out with a reason: 0 placeholder lines where there were 29, and the exported netlist gives the current-sense reading 1.198 V at 27 C and 1.099 V at 85 C; `DEVLOG.md` 2026-11-11 |
| 2026-11-10 | The SIM gate asks an engineer's questions: corners (`sim/corners.json`: each temperature, each tolerance, a worst case per bound, Monte Carlo draws), a frequency plan (`sim/frequency-plan.json`, P30), bundles that run on any machine (`sim --bundle`); an analysis ngspice gave up on and a malformed expect file refused; verdicts that say what ran (`GREEN with N warnings`, `SKIPPED (SIM: engine missing)`, `REQUIREMENTS MET` or `NOT MET`); `workcenter next`; a root `AGENTS.md`; the documents held to the code by tests | unreleased | `tests/test_corners.py` (58 tests), `test_freqplan.py` (38), `test_simgate.py` (29), `test_guide.py` (42), `test_docs.py` (9), 4 in `test_verify.py`; fixtures `fail-sim-corner`, `pass-lc-filter`, `fail-freq-overlap`; a scratch copy of Last Hit v0.16: 153 corner runs, the reviewing engineer's 85 C finding found by the gate (1.0763 V against 1.14 to 1.26 V), 12 bundles giving the gate's numbers from another folder; `MISTAKES.md` M103 to M114; `DEVLOG.md` 2026-11-10 |
| 2026-11-07 | The Last Hit work's conventions: `templates/project/` (a version's README and gates report), `templates/verification/BRIEF.md` and `FACTS.md` for helpers on one package, the owner's decisions in `workcenter verify` (a Withdrawn table, "the owner's decision of <date>"), P22 and P28 extended, the verification skill's "Helpers" and traps | unreleased | `tests/test_verify.py` (8 new tests, 24 in all); the Last Hit v0.16 package with REQ-USB-01 in a Withdrawn table: 64 requirements, the withdrawn ID named, its old traceability row refused, 276 quoted values matching the run; `MISTAKES.md` M92 to M98; `DEVLOG.md` 2026-11-07 |
| 2026-11-07 | Router and generator gaps: `workcenter design --route --seed <board>` (a previous route held as the router's starting wiring, loose ends unfixed, what no longer fits dropped and counted, M89); each layer's hole clearance in the DSN as grown via and drilled-pad copper and in every via check (the Later item for M79; FreeRouting 1.9.0 ignores a structure `via_wire` clearance and holds a class's to that class); a `stitch:` line per island via; the red last line of `workcenter design` (M85); the merge keeps a T-link onto a hand track | unreleased | `tests/test_routing.py` (11 tests): the M79 fixture's router via 0.3281 mm from an inner track before, 0.3581 after; a moved part rerouted from the seed with the five untouched lines kept. Last Hit v0.16 seeded from v0.15: base board 76 of 87 router tracks kept (63 unseeded), display 116 of 117 (116 unseeded; 85 with the seed all unfixed), DRC 0 errors and 0 unconnected on both either way; `DEVLOG.md` 2026-11-07 |
| 2026-11-11 | Another example project, Basalt (`examples/threadripper-matx`): a microATX Threadripper motherboard in 3 versions built in a logged loop: the floor plan and every supply in a pour, the DDR5 buses drawn by rule, the ports and headers routed by a 2-layer grid router; `kicadgen` wires banked symbols on an A0 sheet and checks a socket's 3457 vias in 0.3 s | unreleased | `workcenter gates` GREEN with no warning on v0.1, v0.2 and v0.3; `make verify` GREEN; `DEVLOG.md` 2026-11-11 |
| 2026-11-11 | An example project, Rosetta (`examples/universal-controller/v0.1`): a controller-shaped 4-layer board with a 5-position knob that picks the console, its decks and its knob decoder; the website shows it with a drawing of the routed board and moves with Motion; `install.sh` installs the full Java runtime where the headless one cannot run FreeRouting | unreleased | the example's `workcenter gates .` GREEN; 6 decks, 370 corner runs; `make -C firmware test`; the Docker image built with the fixed `install.sh` routes the example; `DEVLOG.md` 2026-11-11 |
| 2026-11-11 | A second example project, Signet (`examples/ring-mouse`, v0.1 to v0.4): a mouse worn as a ring, 6 small boards on a hexagonal prism round the finger, soldered edge to edge, kept as version folders from a loop; `workcenter render` and `tools/scene.py` in the stackup's colours; `install.sh`'s PPA key from Launchpad when the keyserver does not answer; P34 | unreleased | every tile of v0.4 GREEN (the radio with 2 legend warnings, the power tile with 1), in `docs/gates.md`; the gauge's deck over 52 corner runs; `make -C firmware test`, 8 strip and 7 air tests; `ring.py` refuses a ring whose neighbours miss their corner; a new test in `tests/test_gates.py` for the stackup colours; `DEVLOG.md` 2026-11-11 |
| 2026-11-11 | A third example project, Herald (`examples/fire-alarm-communicator/v0.1`): a fire alarm communicator on an 84.4 x 64 mm 4-layer board with every part on the front, red with a white legend and black terminals; it captures a panel's dialer, reads 3 supervised inputs, holds a fail-safe trouble relay, and reports over LTE-M and Wi-Fi; its decks and its firmware's DTMF decoder and Contact ID call; `workcenter render` draws a board in its stackup's colours | unreleased | the example's `workcenter gates .` GREEN with 7 warnings; 8 decks, 573 corner runs; `make -C firmware test`; `tests/test_gates.py` (the stackup colours); 5 rounds of the board, 3 reviewed by a fresh reader of the renders; `DEVLOG.md` 2026-11-11 |
| 2026-11-07 | Document curation: `workcenter docs`, `costs`, `pictures`, `gates --report`, `version new`, `diagram`, and `tools/scene.py`, from Last Hit's scripts | unreleased | `tests/test_doctools.py` (20 tests); on a copy of Last Hit: `docs v0.16` and `costs` reproduce the committed `CONTENTS.md` datasheet table and every list and total ($61.76 and $396.86 for v0.16), `version new v0.17` passes P22 step 4, `pictures v0.16` redraws the README's images; `DEVLOG.md` 2026-11-07 |
| 2026-11-07 | Datasheets, simulation and CI from the Last Hit work: `workcenter fetch` (a library file and its `sources.csv` row), `workcenter curve` (a datasheet's curve from the PDF's vectors), `workcenter sim --deck --keep` (one deck the gate's way, and its hand-run command), `workcenter design --check`, `workcenter ci` (a GitHub workflow replayed), `workcenter mutate` (a firmware's mutation list), `kicadgen.py symbol-add` | unreleased | `tests/test_fetch.py`, `test_curve.py`, `test_ci.py`, `test_mutate.py`, and new tests in `test_sources.py` and `test_kicadgen.py` (26 tests); on Last Hit v0.16: `fw_is` 0.505 V through `sim --deck heater_pulse`, `design --check` exit 0, AccuGuard's 1.0 A curve 0.310 s at 2.5 A and 24.2 µs at 17.7 A, 50 of 50 mutations caught, the firmware CI job replayed GREEN on a copy; `DEVLOG.md` 2026-11-07 |
| 2026-11-07 | Board inspection: `workcenter inspect` (map, list, probe, net, islands, resistance, crossed) reads a routed board with KiCad's geometry and the board's own rules; `tools/stretch.py` grows a design at a cut; `d.keepout(..., parts=True)` keeps parts out of an area; P29 | unreleased | `tests/test_inspect.py` (21 tests) on the new fixture `inspect-four-layer`, `tests/test_kicadgen.py` (parts keep-outs, `parse_all`); Last Hit v0.16: its In2 run to the joint 56.8 mOhm, C5 to U2 64.3 mOhm, M90's overlap and M91's keep-out found again; `DEVLOG.md` 2026-11-07 |
| 2026-11-05 | Verification packages: `workcenter verify` (every quoted number against a fresh ngspice run, every traceability check recomputed), `templates/verification/`, P28, the `verification` skill; project-fitted models in `sim/models/`; `"req"` on expect bounds | unreleased | `tests/test_verify.py` (16 tests), `tests/test_sources.py` (the own-model rule); the Last Hit v0.14 package: 60 requirements, 175 quoted values matching the run; `DEVLOG.md` 2026-11-05 |
| 2026-10-29 | Pull-resistor check: `Design.undefined_inputs()`, `check_pulls`, `defined_nets` | unreleased | `tests/test_pulls.py`; Last Hit v0.11 checked; `DEVLOG.md` 2026-10-29 |
| 2026-10-29 | Fabrication house rule sets: `rules/sierra-circuits-web.kicad_dru`, `workcenter drc|gates --fab`, `Design.fab` | unreleased | `tests/test_fab.py` (fixture `fail-fab-sierra` GREEN plain, red with the fab; the board-wide minimums; the project untouched); Last Hit v0.11 checked: 47 errors under Sierra's limits; `DEVLOG.md` 2026-10-29 |
| 2026-10-29 | kistack vendored with the `kistack` skill; `workcenter placement` runs its placement checks headless | unreleased | `tests/test_placement.py`; `third_party/kistack/VENDORED.md`; `DEVLOG.md` 2026-10-29 |
| 2026-10-27 | `workcenter procure` and the `procurement` skill: a schematic's BOM priced from a parts file, cheapest order per line, totals per supplier | unreleased | `tests/test_gates.py` (the fixture priced to the cent at 1 and 10 units; unmatched, unpriced and short-of-stock lines; the skip); the Last Hit parts lists; `DEVLOG.md` 2026-10-27 |
| 2026-10-27 | Wired schematics in `kicadgen` (`sch_wires`, `sch_rot`); `render` names parts drawn without a 3D body; `wrlgen` `leadless` and `gullwing` bodies | unreleased | `tests/test_kicadgen.py` and `tests/test_gates.py` (wired divider ERC-clean with its declared netlist and no parity warning; pin positions at each angle as KiCad's ERC reports them; the bare-part report); Last Hit v0.10's two schematics; `DEVLOG.md` 2026-10-27 |
| 2026-10-23 | `kicadgen` design-as-code generator; `workcenter design --route` headless autoroute for generated boards; `workcenter render`; `board-design` skill | unreleased | `tests/test_kicadgen.py` incl. the routed round trip; the first real board, GREEN in its own repository; `DEVLOG.md` 2026-10-23 |
| 2026-10-22 | Install the kit; `install.sh`; gates ERC, DRC, SIM, EXPORT; fixture boards; skills | unreleased | `make verify` green at the install commit; `DEVLOG.md` 2026-10-22 |

## Explicitly not doing

- Reverse engineering KiCad with REA or similar — KiCad is open source with an official IPC API and CLI. REA belongs to workcenters built on closed tools.
- GUI or screen automation of KiCad — every operation goes through `kicad-cli` or the IPC API.
- Bundling a patched KiCad — the workcenter installs the upstream PPA build or uses the upstream image.
- Installing `kicad-packages3d` by default — 3.3 GB for 3D models no gate reads.

## Queue changes

- 2026-10-22 — queue seeded at setup, 4 items, provisional.
- 2026-10-27 — `workcenter procure` shipped out of band: the user asked for every prototype's parts sourced from Digi-Key with the full cost, as a workcenter skill.
- 2026-10-27 — the Later item "`kicadgen` schematic layout" shipped out of band: the user found the Last Hit schematics unreadable (M51).
- 2026-10-23 — item 1 re-scoped: the generated-design half shipped out of band while building the first board; the remaining half is a `.kicad_pcb` reader in front of the same DSN writer.
- 2026-10-29 — kistack shipped out of band: the user asked for it in the workflow.
- 2026-10-29 — item 3 (fab rule sets) re-scoped from JLCPCB to Sierra Circuits' Web PCB, the user's fab, and shipped; `Design.fab` added so a generated board carries its fab's rules for good. The MCP server moves up to 3.
- 2026-11-05 — verification packages shipped out of band: the user asked for requirements fit for a MIL-STD or DO-160 inspection, simulations traced to the requirements' sources, cited nodal analysis, and this method in the workcenter.
- 2026-10-29 — the pull-resistor check shipped out of band: the user asked for pull-downs wherever one is needed, in case one was missed.
- 2026-11-07 — the Last Hit work's conventions, templates and verification rules shipped out of band: the owner asked for every tool and convention of the Last Hit work in the workcenter.
- 2026-11-07 — router and generator gaps (`design --route --seed`, the inner drill clearance in the DSN from the Later list, the stitching report, the red last line) shipped out of band: the owner asked for every tool and convention of the Last Hit work in the workcenter.
- 2026-11-07 — document curation (`workcenter docs`, `costs`, `pictures`, `gates --report`, `version new`, `diagram`, `tools/scene.py`) shipped out of band: the owner asked for every tool and convention of the Last Hit work in the workcenter.
- 2026-11-07 — `workcenter fetch`, `curve`, `sim --deck`, `design --check`, `ci`, `mutate` and `kicadgen.py symbol-add` shipped out of band: the owner asked for every tool and convention of the Last Hit work in the workcenter.
- 2026-11-07 — board inspection (`workcenter inspect`, `tools/stretch.py`, parts keep-outs, P29) shipped out of band: the owner asked for every tool and convention of the Last Hit work in the workcenter.
- 2026-11-10 — corners, the frequency plan, bundles, the verdict lines and `workcenter next` shipped out of band: an engineer's review of Last Hit v0.16 found what the gates left out, and the owner asked for a core a small model can follow to the same working design as a large one. Items 1 (a generated schematic that simulates) and 2 (a small model builds a board with `next` alone) enter at the top for the same reason; the autoroute, workflow and MCP items move to 3, 4 and 5. Nine candidates join Later.
- 2026-11-11 — item 1 (a generated schematic that simulates) shipped the day after it entered; the small-model run, autoroute, workflow and MCP items are now 1 to 4. Two candidates join Later: a translated model at a path a schematic can name, and a part's pin map in its library row.
- 2026-11-11 — item 1 (a small model builds a board with `next` alone) shipped. 3 items enter above the rest. The owner asked for chip design, from RTL to the mask layout, on its own branch: item 1. The owner pointed at the reviewing engineer's notes on Last Hit's branch `community/power-path-breadboard-notes`: a power path walked stage by stage and a breadboard plan, items 2 and 3. The autoroute, workflow and MCP items are now 4 to 6.
- 2026-11-11 — the repository's public face (the website, the Open Graph image, the README's head) shipped out of band: the owner asked for a professional open-source face that relies on the kit, and for a site in the look of the apparatus site.
- 2026-11-11 — the owner had every branch collapsed into `main`, and every commit name the owner alone (P33). Work still starts on a branch and lands on `main` when `make verify` is GREEN on it. The chip branch (item 1) lands when its gates are tested.
- 2026-11-11 — the front page (a fixture board from a design file, and its pictures at the head of the README) shipped out of band: the owner asked again for the repository to look good.
- 2026-11-11 — an example project shipped out of band: the owner found the site's examples poor and asked for a prototype like Agentcast and Last Hit, a universal controller with a switch that picks the console, with ideas that are hard to do, and a site that moves with Motion.
- 2026-11-11 — the favicon fix shipped out of band: the owner found the favicon was not the site's current logo, the wordmark.
- 2026-11-11 — a second example project shipped out of band: the owner asked for an example of what people can make with the workcenter, a compact board that looks great, made with a loop that keeps iterating: a ring that is a mouse, worn on the finger, its circuit on small boards on the surface of the cylinder, kept the way Last Hit keeps its prototypes.
- 2026-11-11 — Rosetta v0.2 shipped out of band: the owner asked for a proper Xbox 360-style controller, with the joysticks, the Hall-effect sensors and the Bluetooth module on a curved board.
- 2026-11-11 — a third example project shipped out of band: the owner asked for a fire alarm communicator made with Via, compact and good to look at, iterated in a review loop and merged to `main` in its own folder.
- 2026-11-12 — the site's cards for Signet, Herald and Hush shipped out of band: the owner asked for the branches consolidated and for more examples on the site, then for the finished examples' current state, and for Herald in Rosetta's place as the site's example.
- 2026-11-12 — the website's professional copy shipped out of band: the owner found the headlines read like an assistant's, asked for a professional tone and display, and for the page to say what Via does for the reader, without the fixture boards.
- 2026-11-12 — Herald's labelled parts shipped out of band: the owner found the highlighted signal paths made up, and asked for every part labelled with a leader, a few at a time, with its documents and what Via gathered on it.
- 2026-11-12 — a review of the README's front page by a reader who had not written it shipped out of band, with what it found in the tools (the router's 20 s wait, a doubled track segment, `doctor`'s first line). 5 candidates join Later from it.
- 2026-11-12 — Herald as a 3D model on the site, its labels 1 every 3 seconds with their datasheets' first pages, and the owner's headline shipped out of band: the owner asked for the board in 3D without a slower page, the labels played 1 at a time with 2-run leaders, and for the headline, the footer and justified paragraphs in their words.
- 2026-11-12 — item 1 (a chip from RTL to a mask layout) shipped: the chip branch is on `main`. The walked circuit, the bench plan, autoroute, the workflow and the MCP server are now items 1 to 5. A candidate joined Later on the way: every register of the RTL held to the netlist.
- 2026-11-12 — a redrawn website shipped out of band, on a branch: the owner asked for the site to look better, with the text-to-cad site as the reference: a page for each example with how it was built, the agents' strip with every agent text-to-cad lists, and the boards in 3D.
- 2026-11-14 — Herald's section and the 6 boards shipped out of band on the redrawn site's branch, below the agents' strip: the owner liked the redrawn site and asked for the new set of boards and the way the current site shows Herald, below "Works with any agent". `main` merged into the branch for it; each of the 6 examples has a page.
