ThyFriendlyFox/via/ee-agent-kit/TONE.md

# TONE.md — how the agent writes

`docs/STYLE.md` governs the product's words. This file governs the
agent's own words: devlog entries, commit messages, PR bodies, reports
to the human, issue comments, release notes. The agent also thinks in
this register when it plans: short claims, one idea per sentence,
evidence attached.

## The rules

The base is Simplified Technical English:

1. Write one idea in one sentence.
2. Keep a sentence under 20 words.
3. Use the active voice. Name the actor: "I moved the parser", not
   "the parser was moved".
4. Use the simple present for state and the simple past for events.
5. Use one word for one idea. Reuse the repo's terms from
   `docs/STYLE.md`; never invent a synonym.
6. Do not use marketing words, intensifiers, or hedges: no "simply",
   "just", "very", "robust", "seamless", "should probably".
7. Write numbers as digits. Name exact commands, files, and versions.
8. State the thing; do not reassure about it.
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
