ThyFriendlyFox/via/examples/anc-speaker/v0.1/docs/board-3d-iso.png

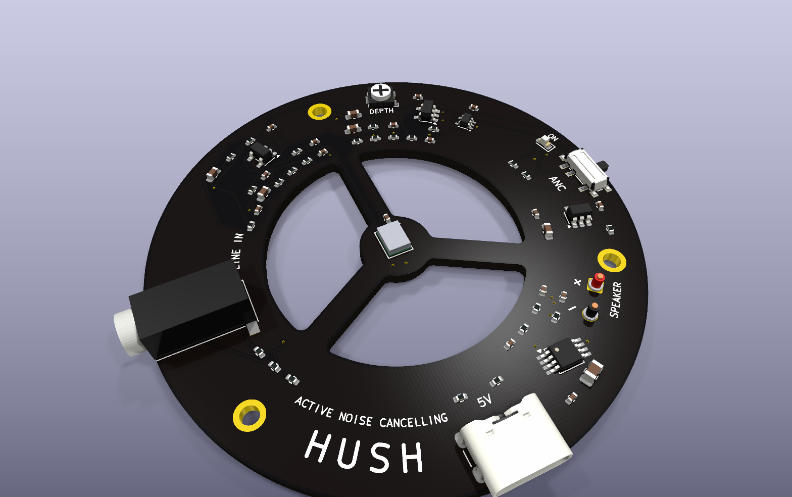
examples/anc-speaker/v0.1/docs/board-3d-iso.png
