ThyFriendlyFox/via/examples/anc-speaker/v0.1/docs/board-bottom.png

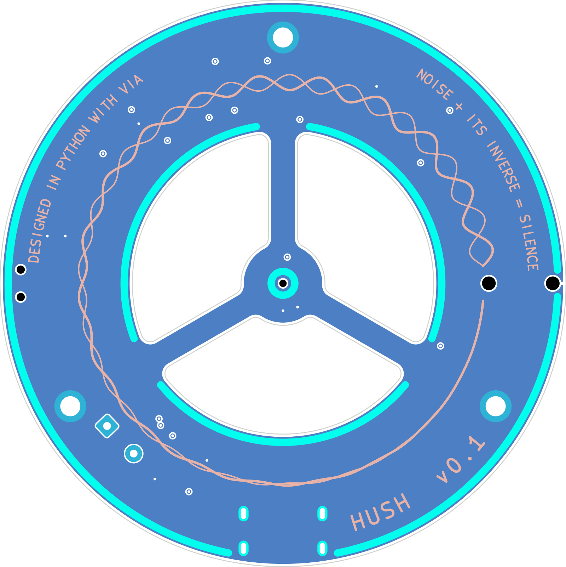
examples/anc-speaker/v0.1/docs/board-bottom.png
