ThyFriendlyFox/via/examples/anc-speaker/v0.1/docs/board-top.png

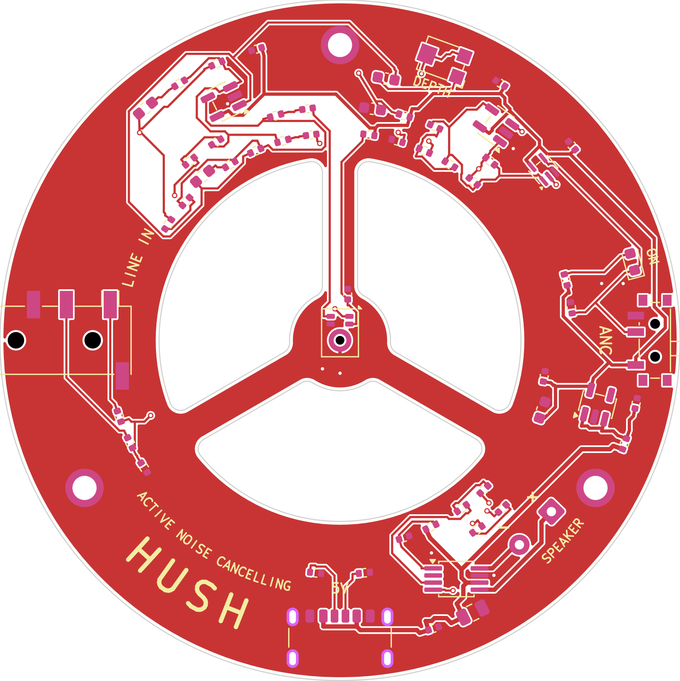
examples/anc-speaker/v0.1/docs/board-top.png
