ThyFriendlyFox/via/examples/anc-speaker/v0.1/docs/layers/hush-B-Cu.png

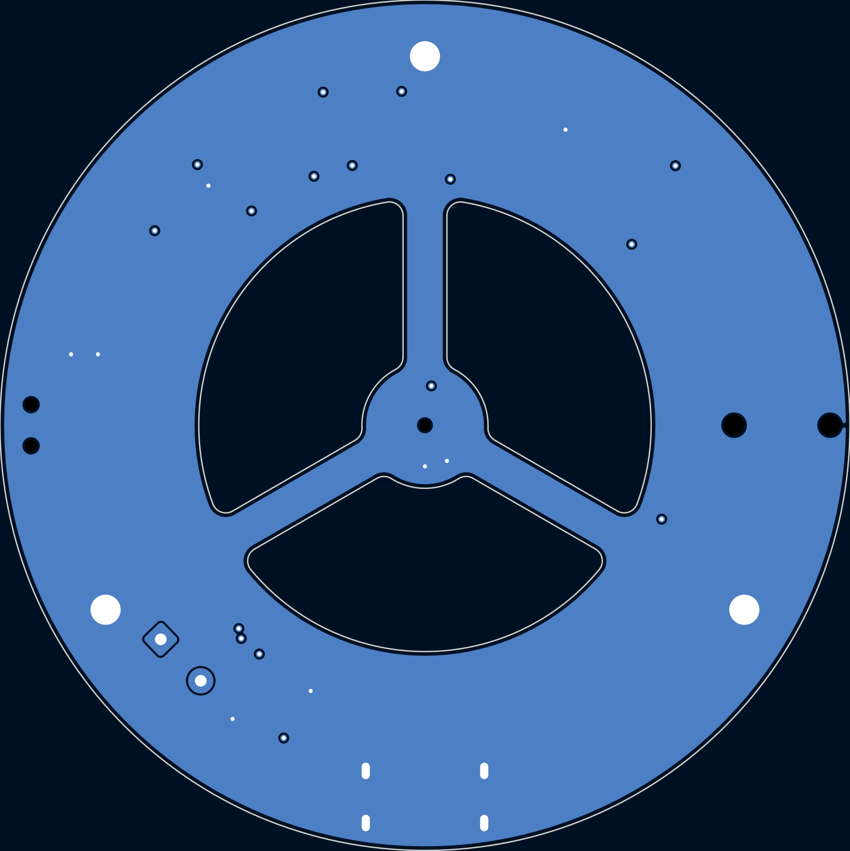
examples/anc-speaker/v0.1/docs/layers/hush-B-Cu.png
