ThyFriendlyFox/via/examples/anc-speaker/v0.1/docs/layers/hush-Edge-Cuts.png

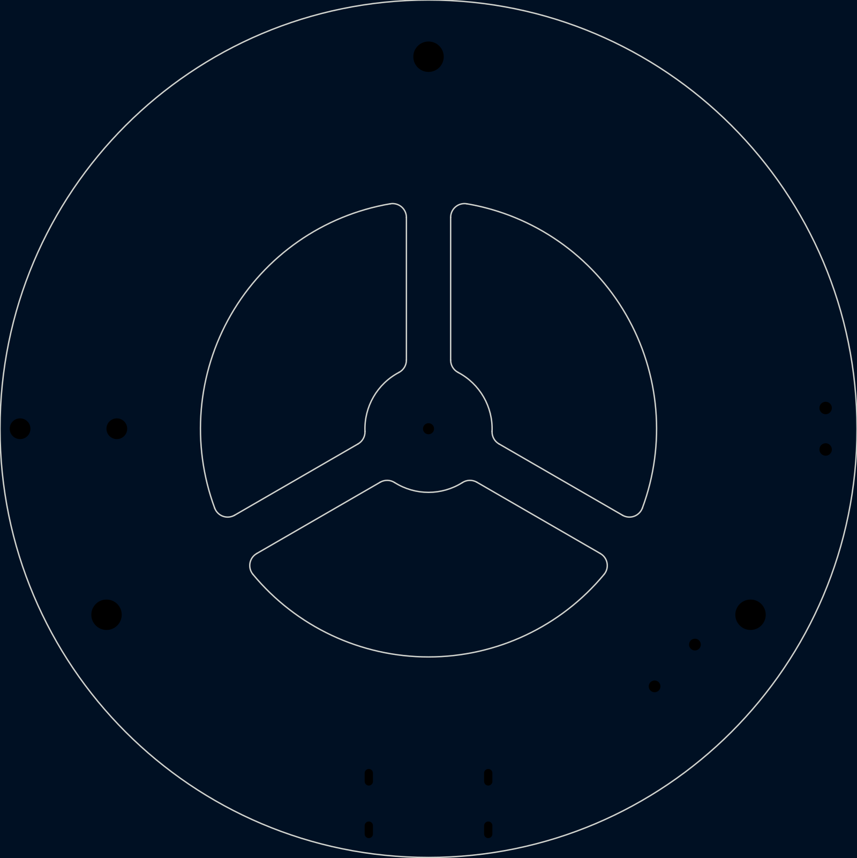
examples/anc-speaker/v0.1/docs/layers/hush-Edge-Cuts.png
