ThyFriendlyFox/via/examples/anc-speaker/v0.1/docs/layers/hush-F-Cu.png

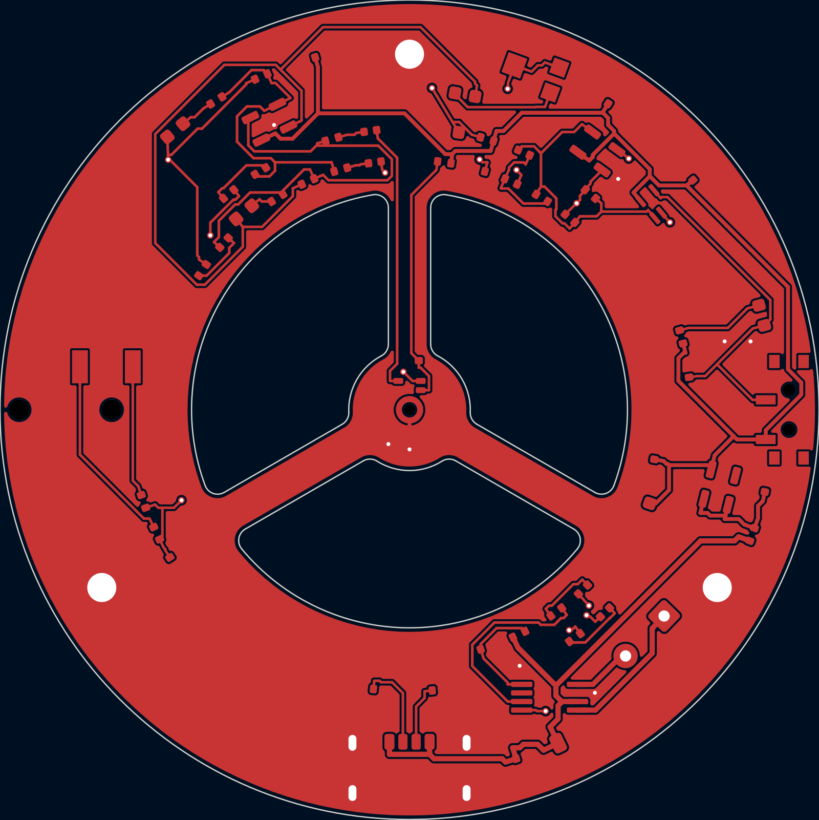
examples/anc-speaker/v0.1/docs/layers/hush-F-Cu.png
