ThyFriendlyFox/via/examples/anc-speaker/v0.1/docs/layers/hush-F-Mask.png

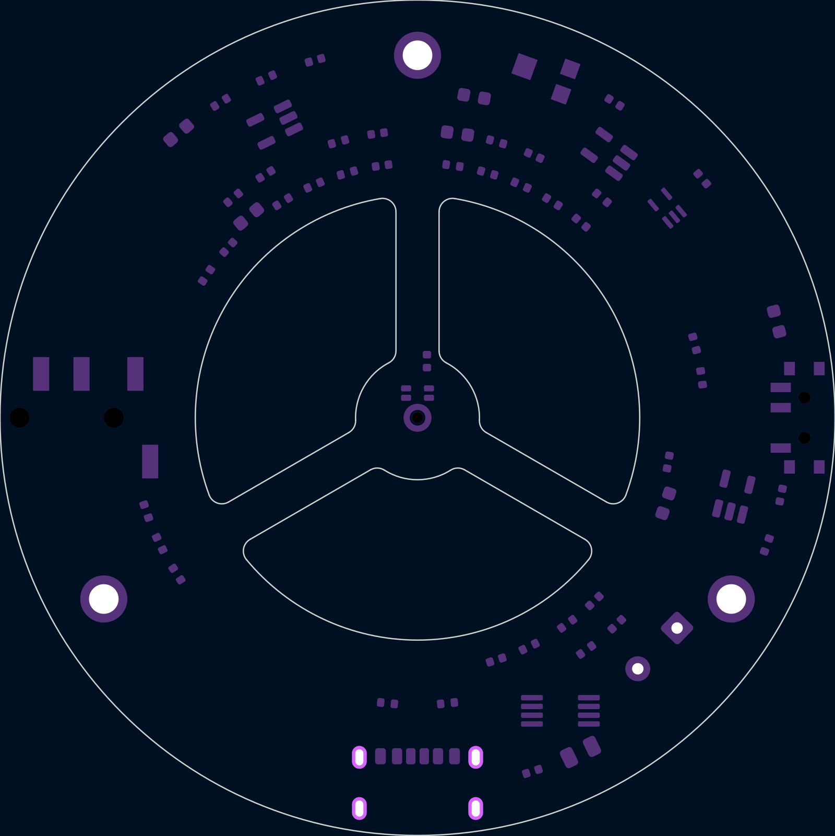
examples/anc-speaker/v0.1/docs/layers/hush-F-Mask.png
