ThyFriendlyFox/via/examples/anc-speaker/v0.1/docs/layers/hush-In2-Cu.png

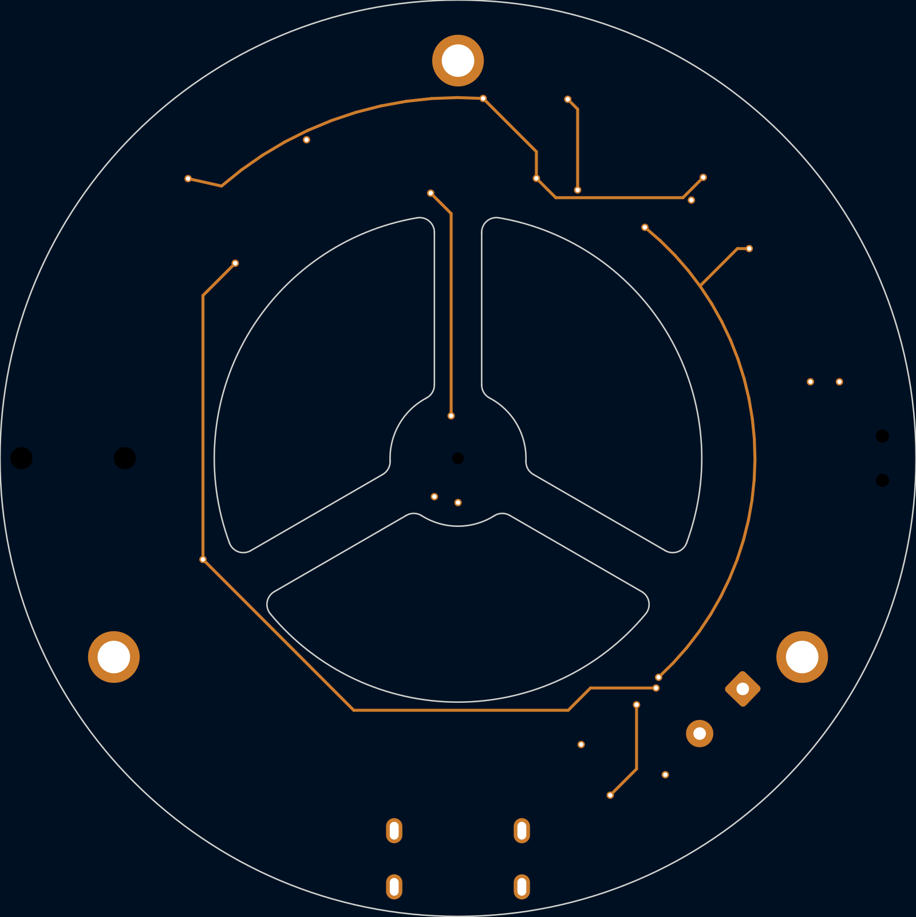
examples/anc-speaker/v0.1/docs/layers/hush-In2-Cu.png
