ThyFriendlyFox/via/examples/ring-mouse/v0.4/docs/cell-schematic.png

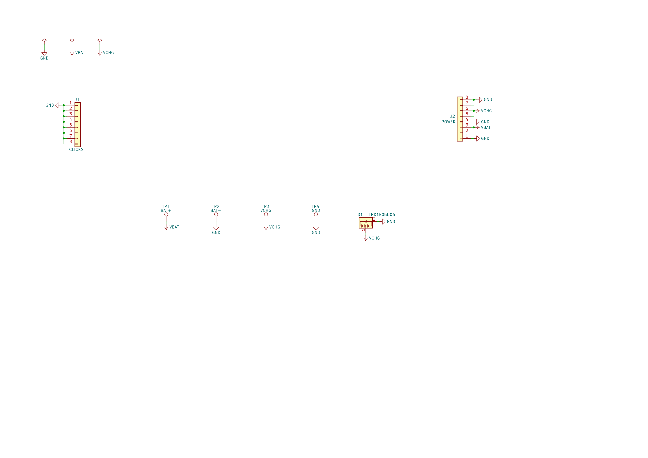
examples/ring-mouse/v0.4/docs/cell-schematic.png
