ThyFriendlyFox/via/examples/ring-mouse/v0.4/docs/clicks-schematic.png

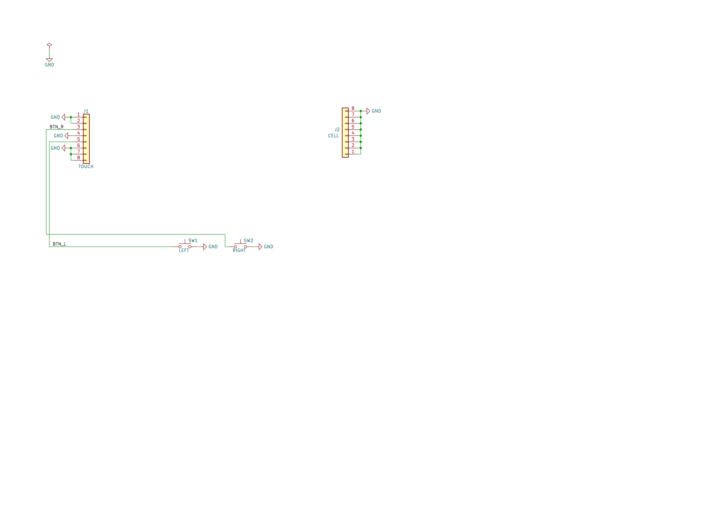
examples/ring-mouse/v0.4/docs/clicks-schematic.png
