ThyFriendlyFox/via/examples/ring-mouse/v0.4/docs/layers-cell.png

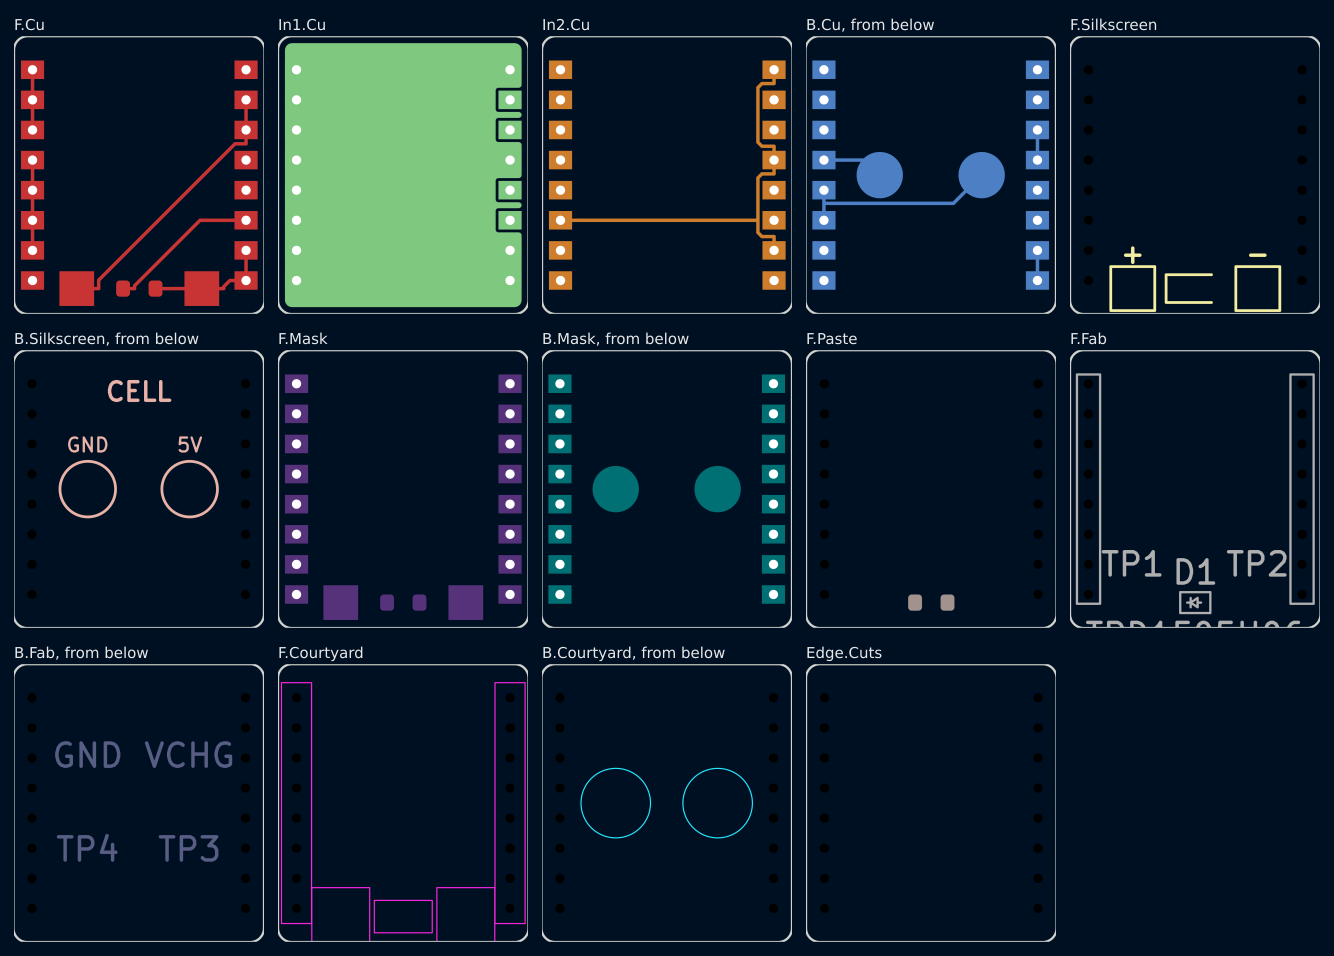
examples/ring-mouse/v0.4/docs/layers-cell.png
