ThyFriendlyFox/via/examples/ring-mouse/v0.4/docs/layers-clicks.png

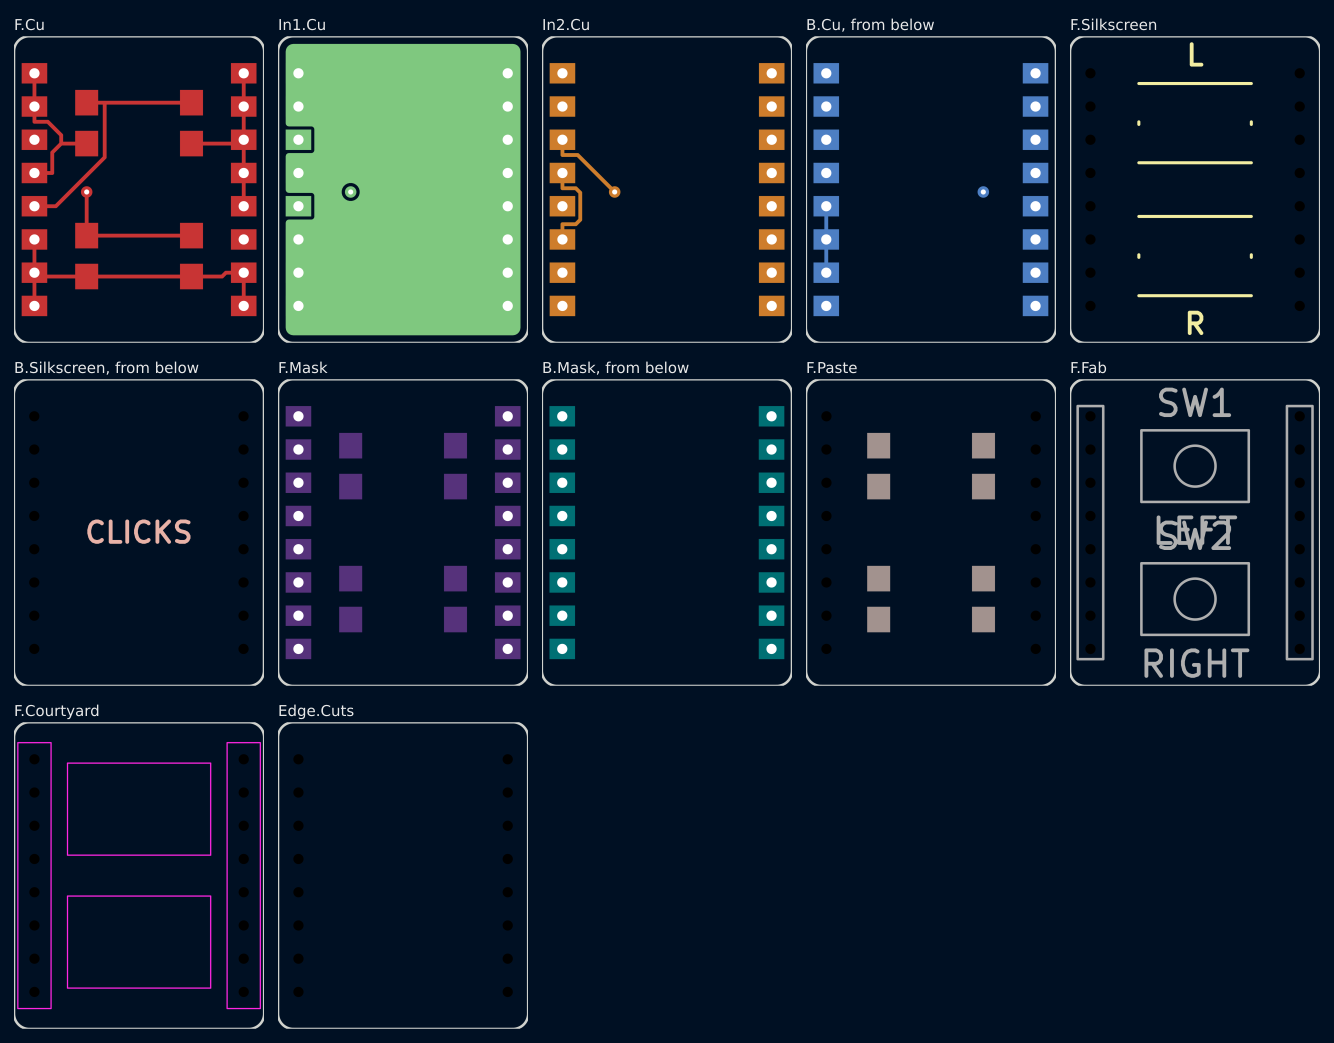
examples/ring-mouse/v0.4/docs/layers-clicks.png
