ThyFriendlyFox/via/examples/ring-mouse/v0.4/docs/layers-motion.png

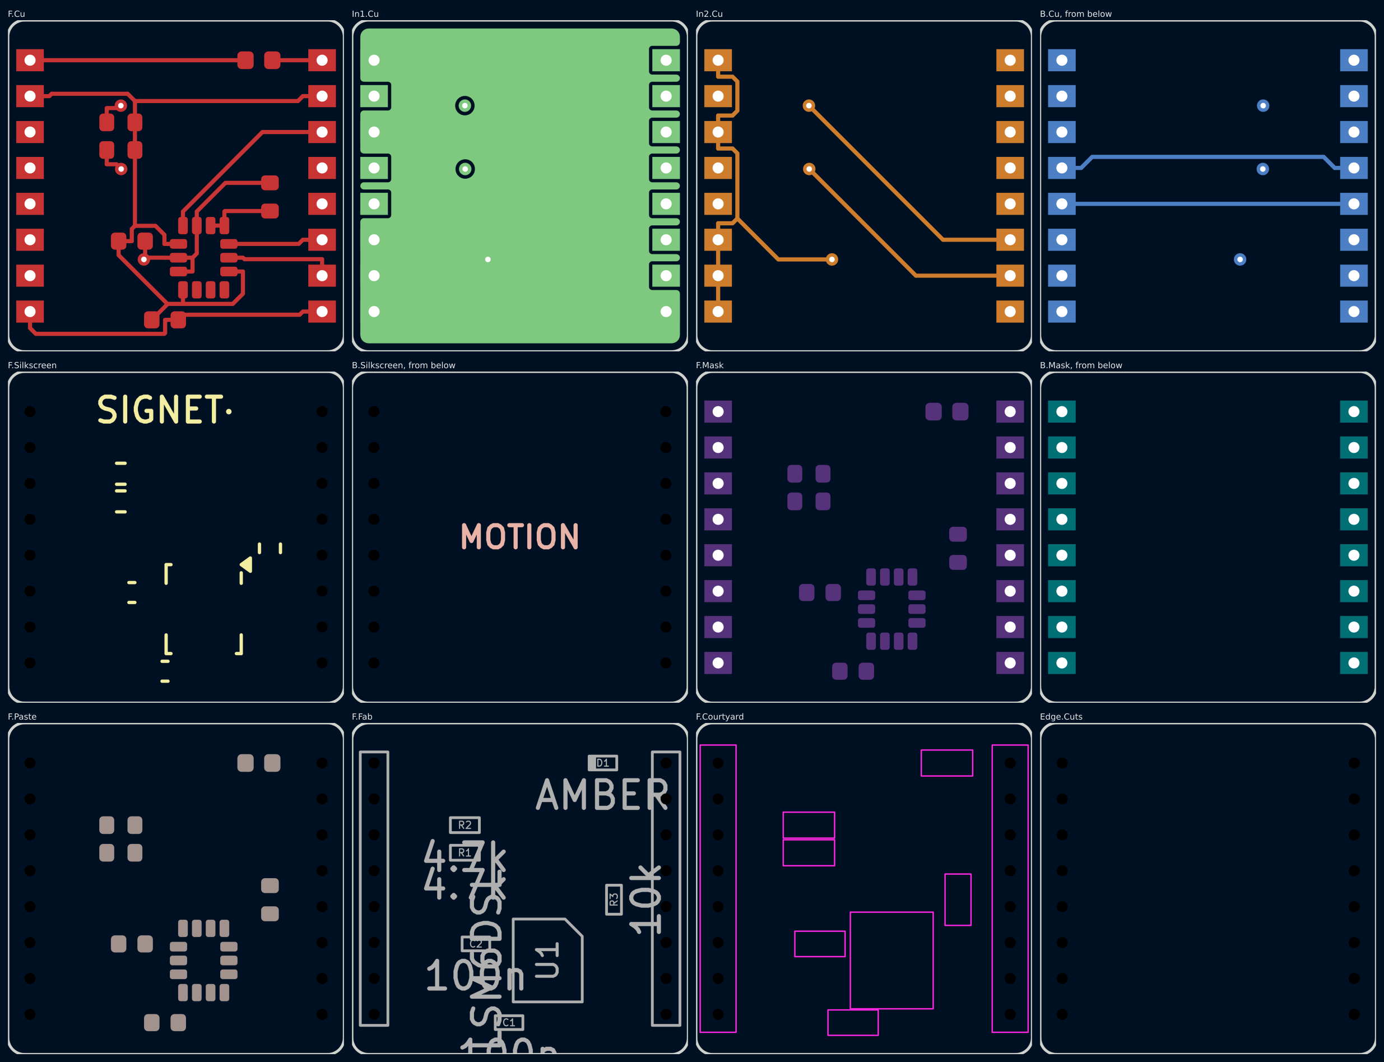
examples/ring-mouse/v0.4/docs/layers-motion.png
