ThyFriendlyFox/via/examples/ring-mouse/v0.4/docs/layers-power.png

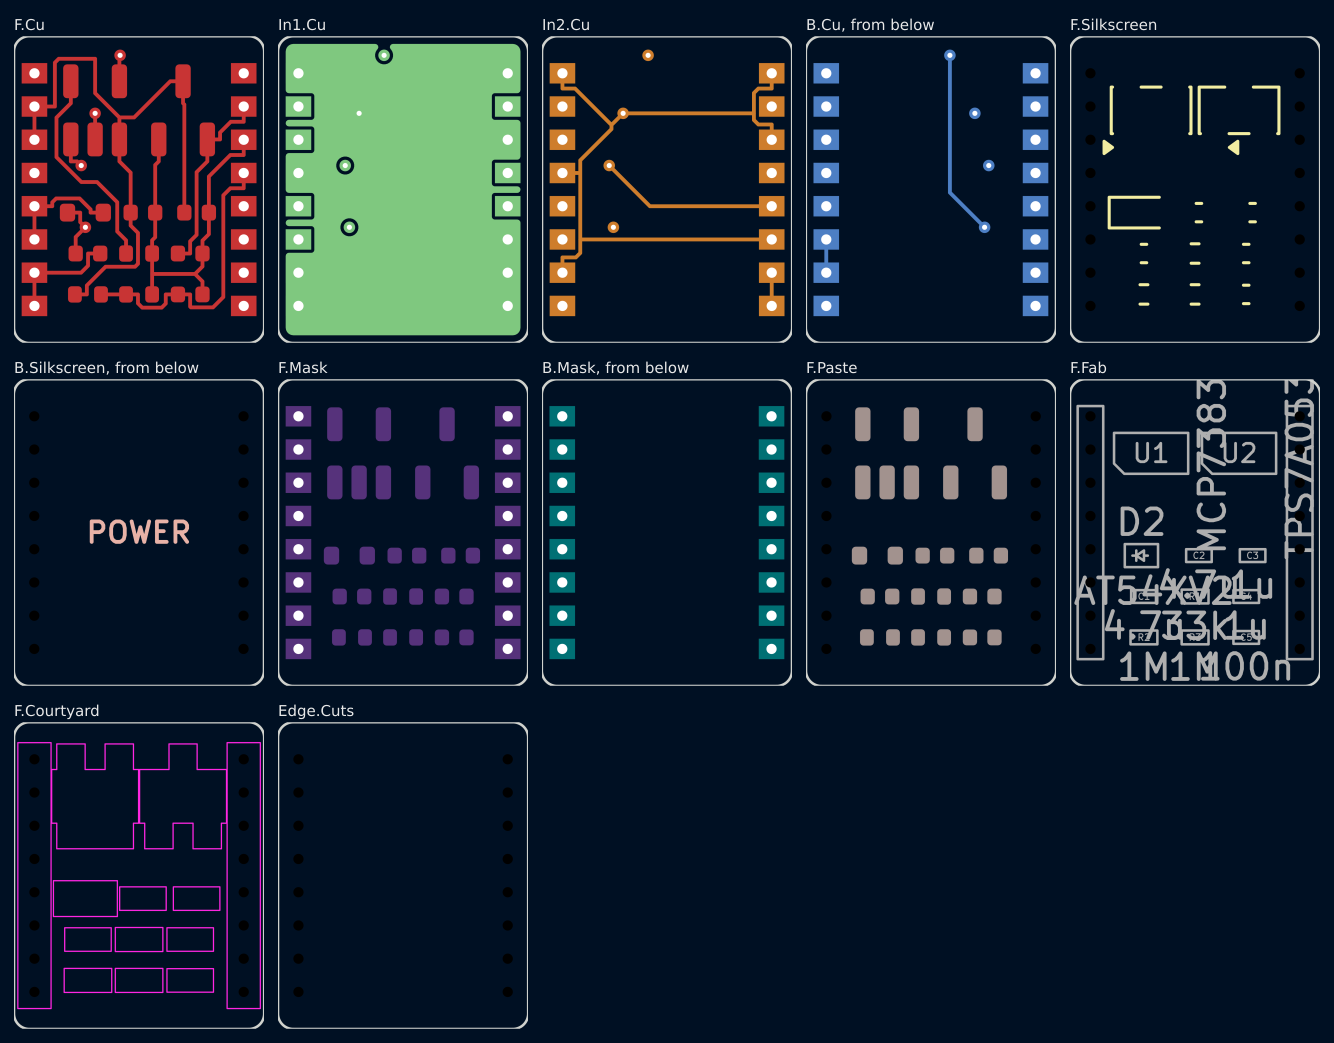
examples/ring-mouse/v0.4/docs/layers-power.png
