ThyFriendlyFox/via/examples/ring-mouse/v0.4/docs/layers-radio.png

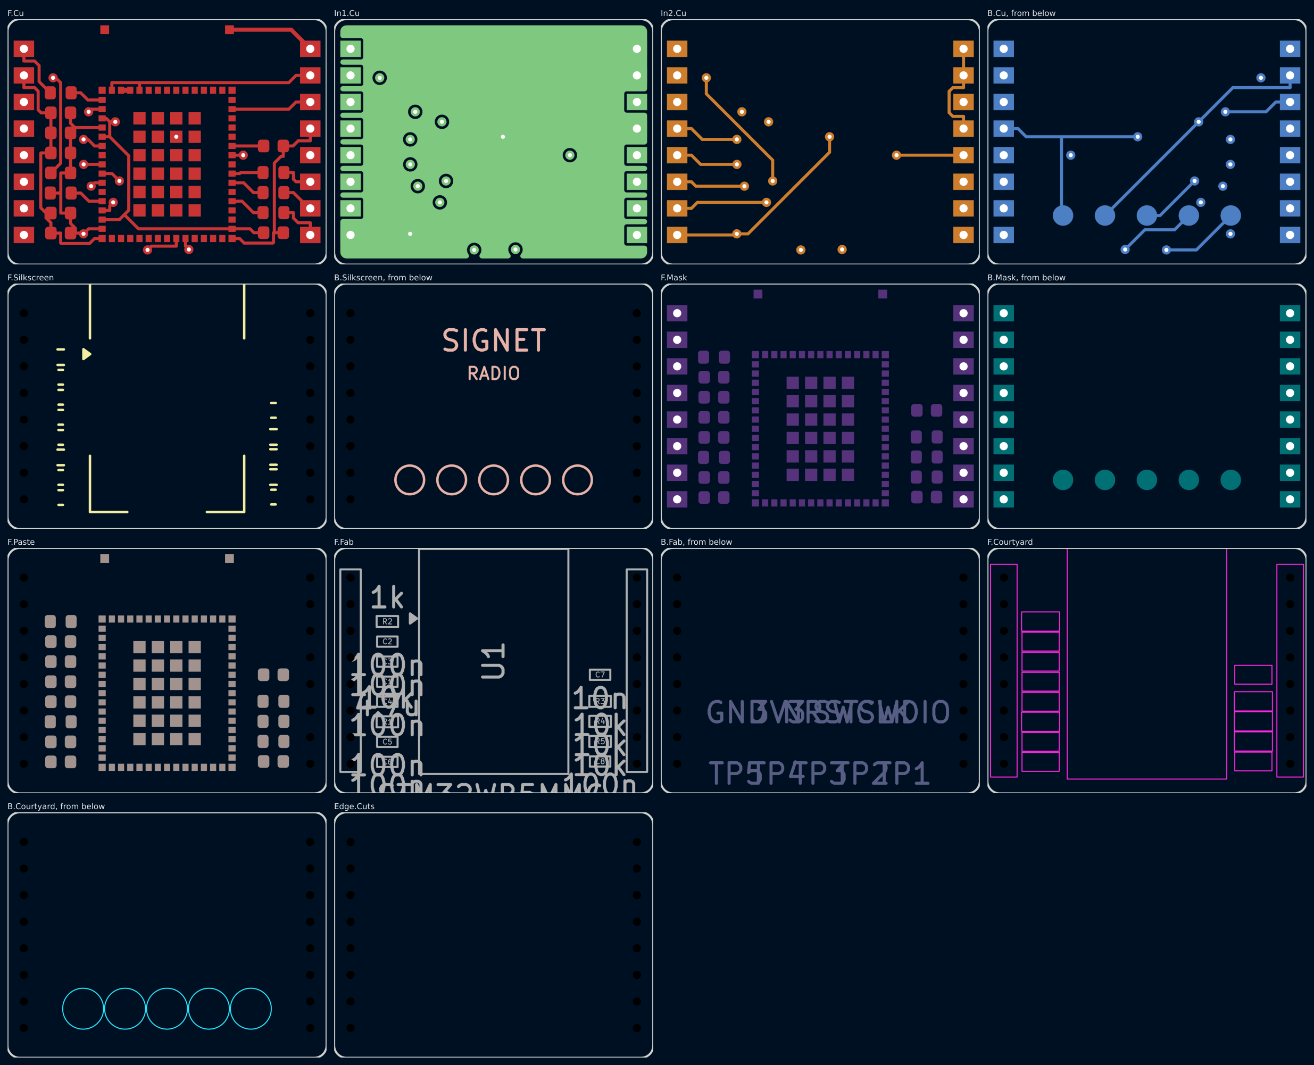
examples/ring-mouse/v0.4/docs/layers-radio.png
