ThyFriendlyFox/via/examples/ring-mouse/v0.4/docs/layers-touch.png

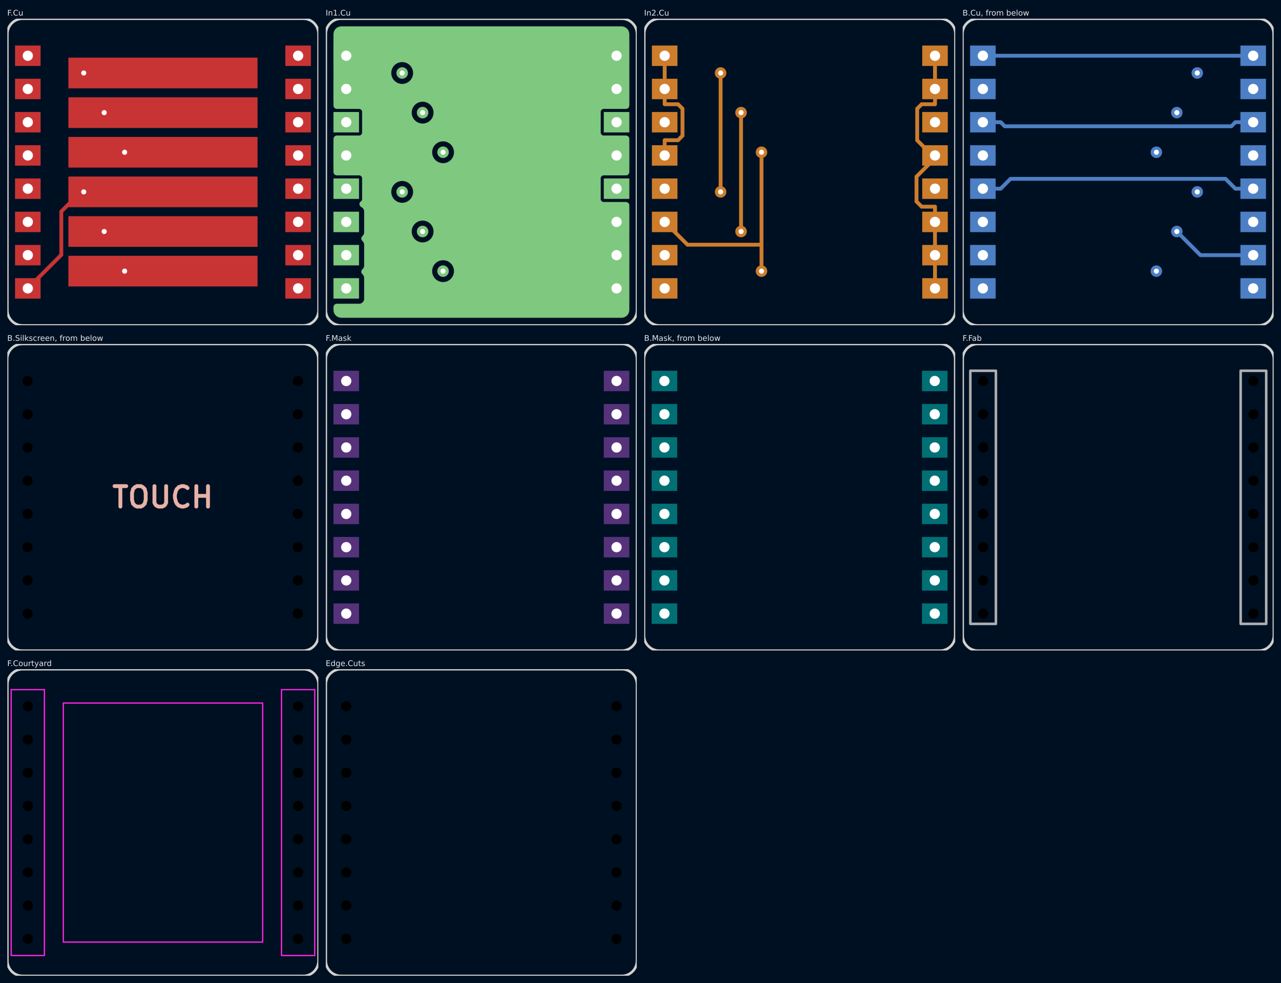
examples/ring-mouse/v0.4/docs/layers-touch.png
