ThyFriendlyFox/via/examples/ring-mouse/v0.4/docs/layers/cell-B-Courtyard.png

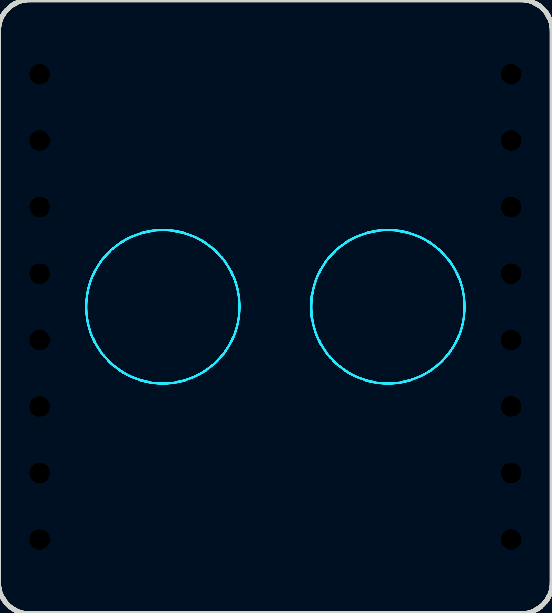
examples/ring-mouse/v0.4/docs/layers/cell-B-Courtyard.png
