ThyFriendlyFox/via/examples/ring-mouse/v0.4/docs/layers/cell-B-Cu.png

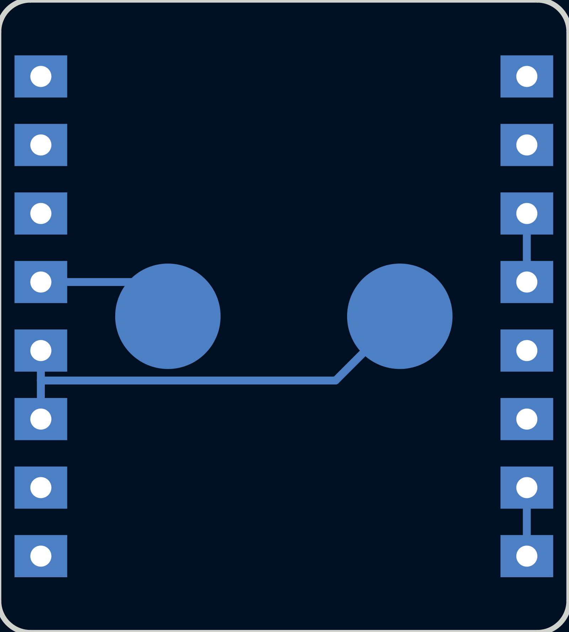
examples/ring-mouse/v0.4/docs/layers/cell-B-Cu.png
