ThyFriendlyFox/via/examples/ring-mouse/v0.4/docs/layers/cell-B-Silkscreen.png

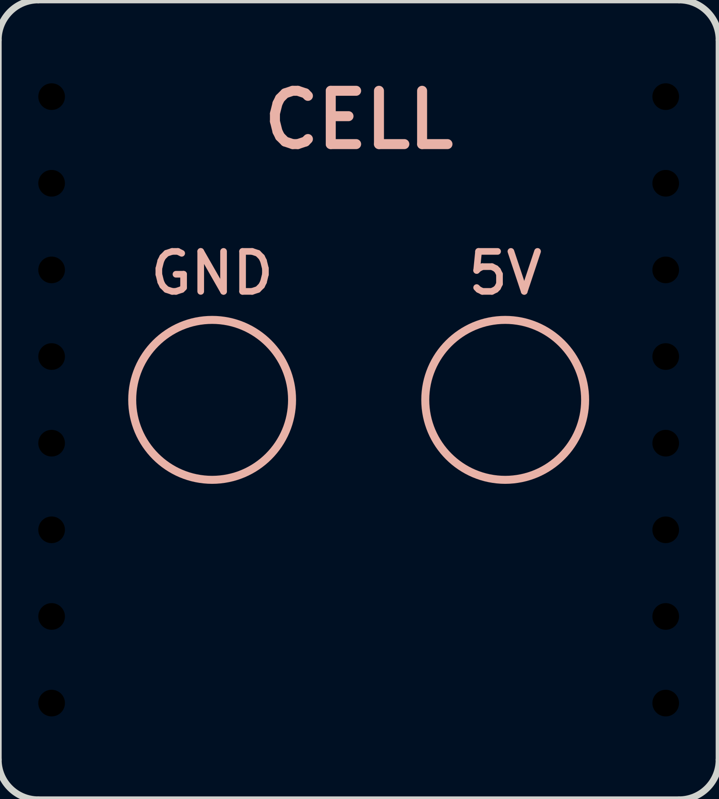
examples/ring-mouse/v0.4/docs/layers/cell-B-Silkscreen.png
