ThyFriendlyFox/via/examples/ring-mouse/v0.4/docs/layers/cell-Edge-Cuts.png

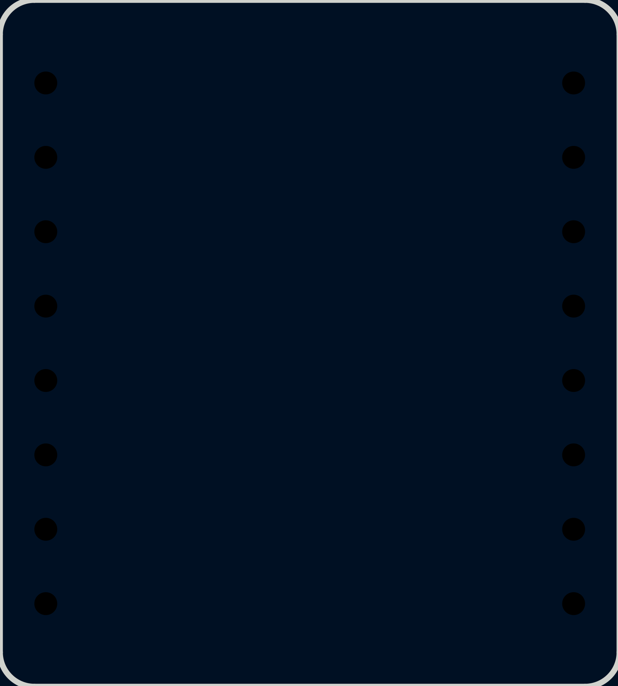
examples/ring-mouse/v0.4/docs/layers/cell-Edge-Cuts.png
