ThyFriendlyFox/via/examples/ring-mouse/v0.4/docs/layers/cell-F-Silkscreen.png

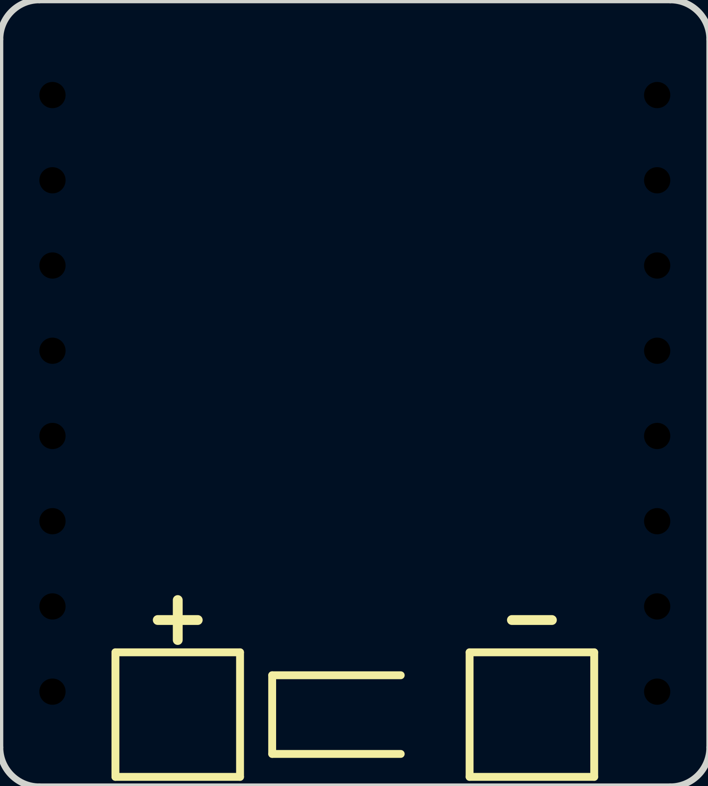
examples/ring-mouse/v0.4/docs/layers/cell-F-Silkscreen.png
