ThyFriendlyFox/via/examples/ring-mouse/v0.4/docs/layers/cell-In1-Cu.png

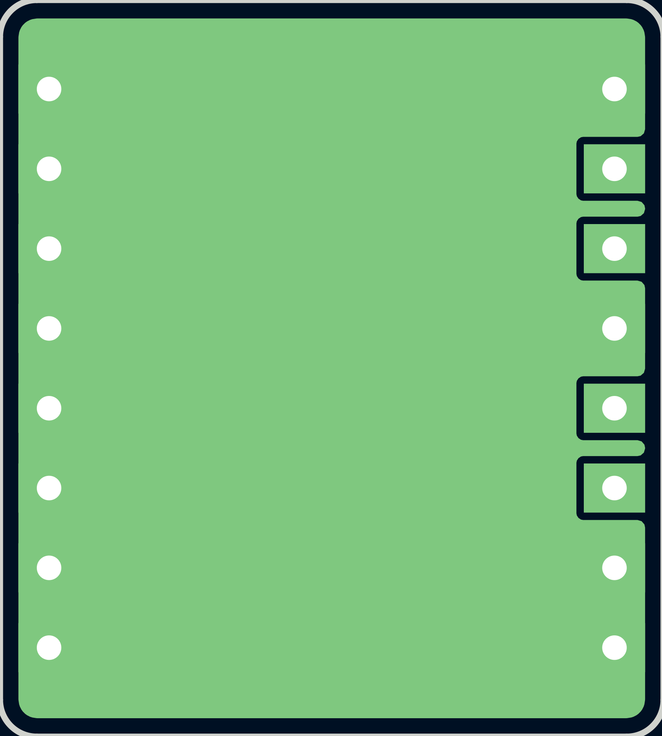
examples/ring-mouse/v0.4/docs/layers/cell-In1-Cu.png
