ThyFriendlyFox/via/examples/ring-mouse/v0.4/docs/layers/clicks-B-Silkscreen.png

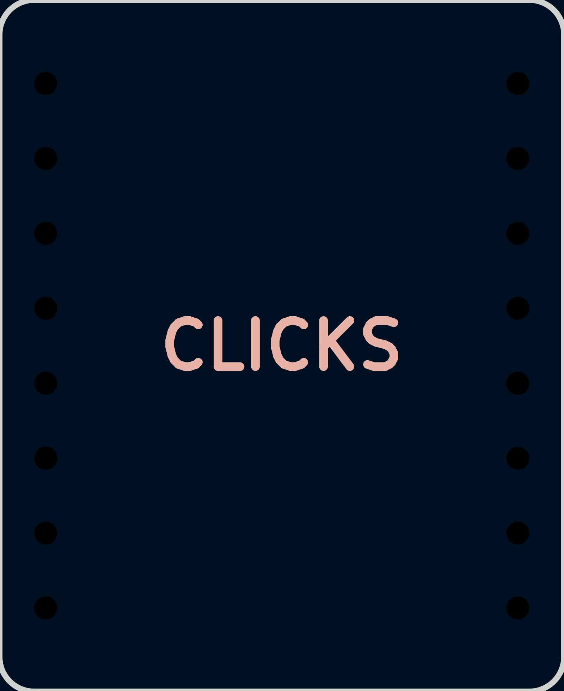
examples/ring-mouse/v0.4/docs/layers/clicks-B-Silkscreen.png
