ThyFriendlyFox/via/examples/ring-mouse/v0.4/docs/layers/clicks-F-Cu.png

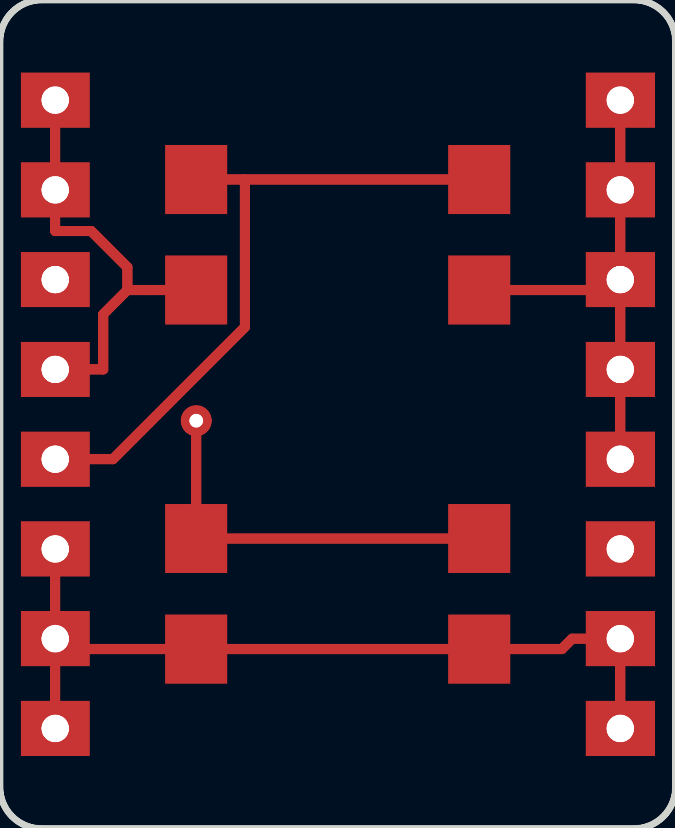
examples/ring-mouse/v0.4/docs/layers/clicks-F-Cu.png
