ThyFriendlyFox/via/examples/ring-mouse/v0.4/docs/layers/clicks-F-Fab.png

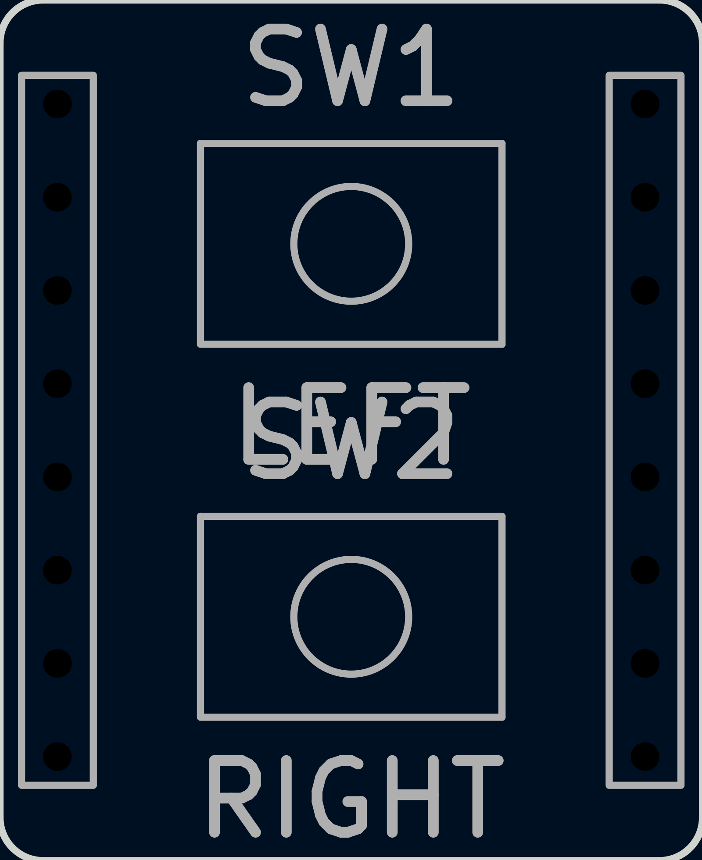
examples/ring-mouse/v0.4/docs/layers/clicks-F-Fab.png
