ThyFriendlyFox/via/examples/ring-mouse/v0.4/docs/layers/clicks-In1-Cu.png

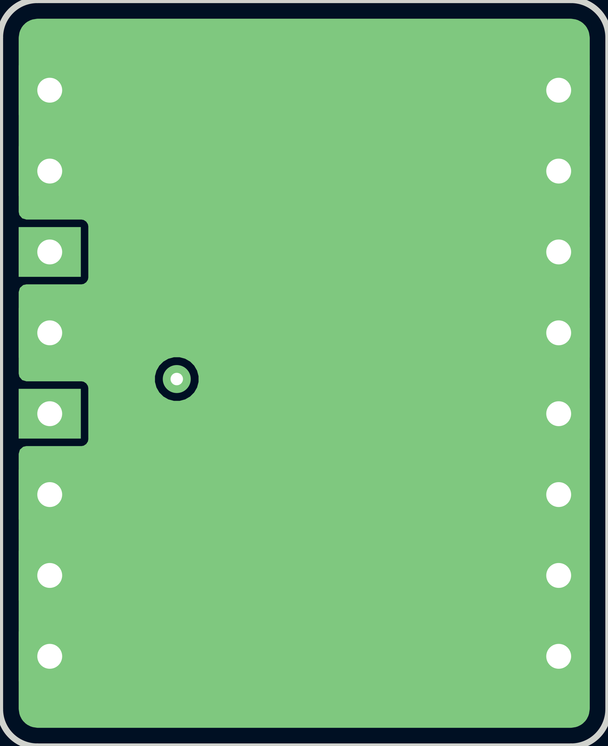
examples/ring-mouse/v0.4/docs/layers/clicks-In1-Cu.png
