ThyFriendlyFox/via/examples/ring-mouse/v0.4/docs/layers/motion-B-Cu.png

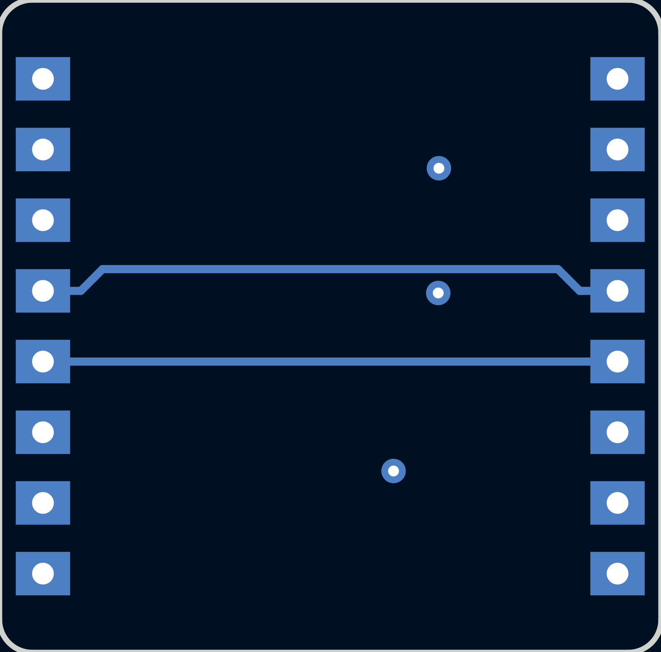
examples/ring-mouse/v0.4/docs/layers/motion-B-Cu.png
