ThyFriendlyFox/via/examples/ring-mouse/v0.4/docs/layers/motion-F-Silkscreen.png

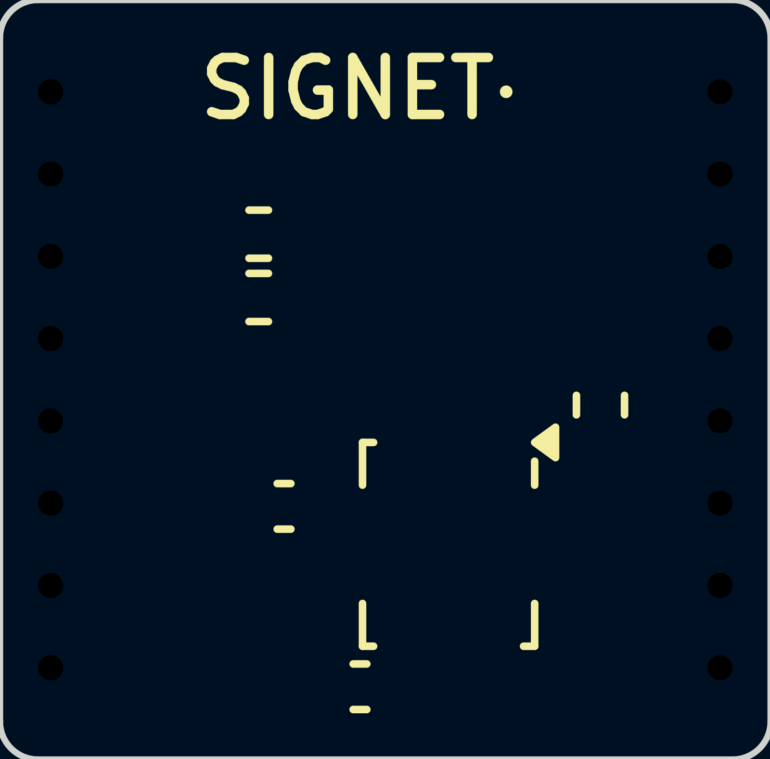
examples/ring-mouse/v0.4/docs/layers/motion-F-Silkscreen.png
