ThyFriendlyFox/via/examples/ring-mouse/v0.4/docs/layers/motion-In1-Cu.png

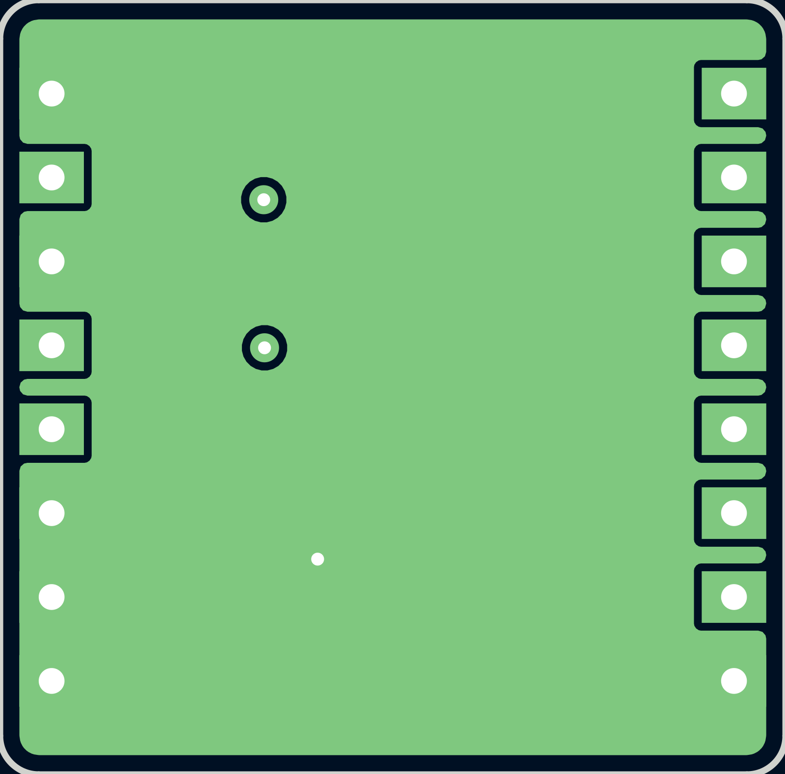
examples/ring-mouse/v0.4/docs/layers/motion-In1-Cu.png
