ThyFriendlyFox/via/examples/ring-mouse/v0.4/docs/layers/power-F-Cu.png

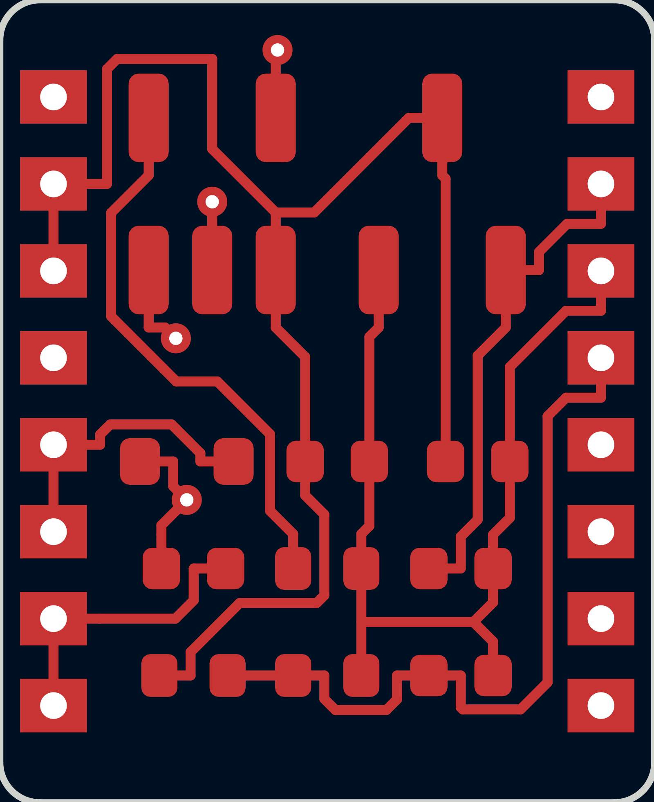
examples/ring-mouse/v0.4/docs/layers/power-F-Cu.png
