ThyFriendlyFox/via/examples/ring-mouse/v0.4/docs/layers/power-In2-Cu.png

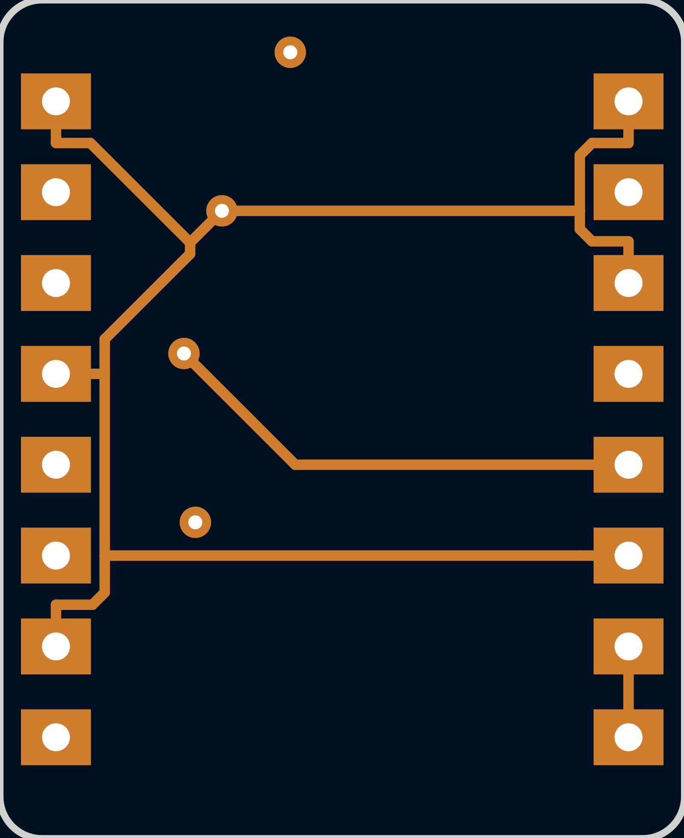
examples/ring-mouse/v0.4/docs/layers/power-In2-Cu.png
