ThyFriendlyFox/via/examples/ring-mouse/v0.4/docs/layers/radio-B-Courtyard.png

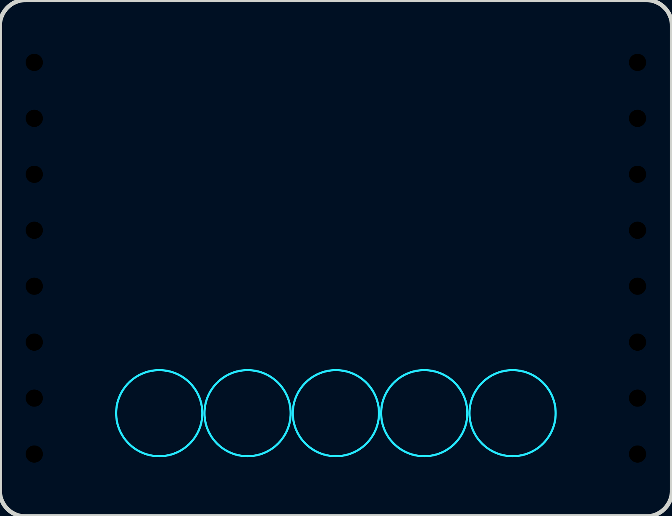
examples/ring-mouse/v0.4/docs/layers/radio-B-Courtyard.png
