ThyFriendlyFox/via/examples/ring-mouse/v0.4/docs/layers/radio-B-Cu.png

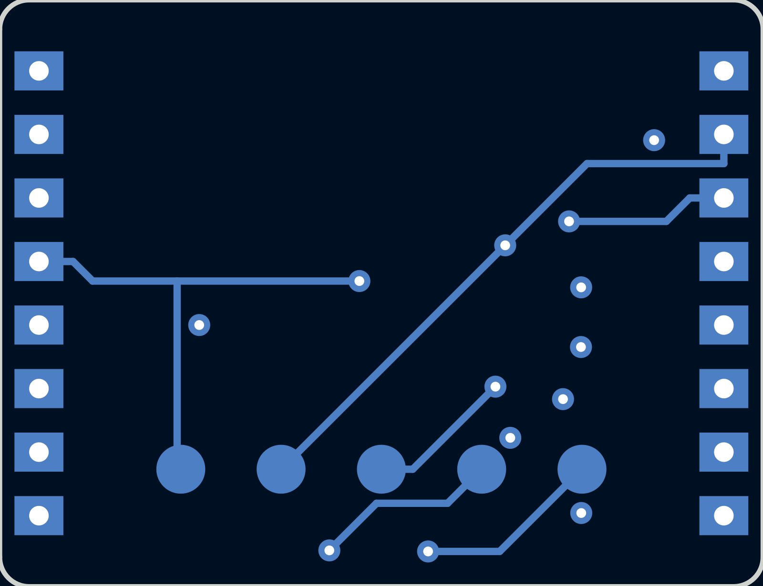
examples/ring-mouse/v0.4/docs/layers/radio-B-Cu.png
