ThyFriendlyFox/via/examples/ring-mouse/v0.4/docs/layers/radio-F-Cu.png

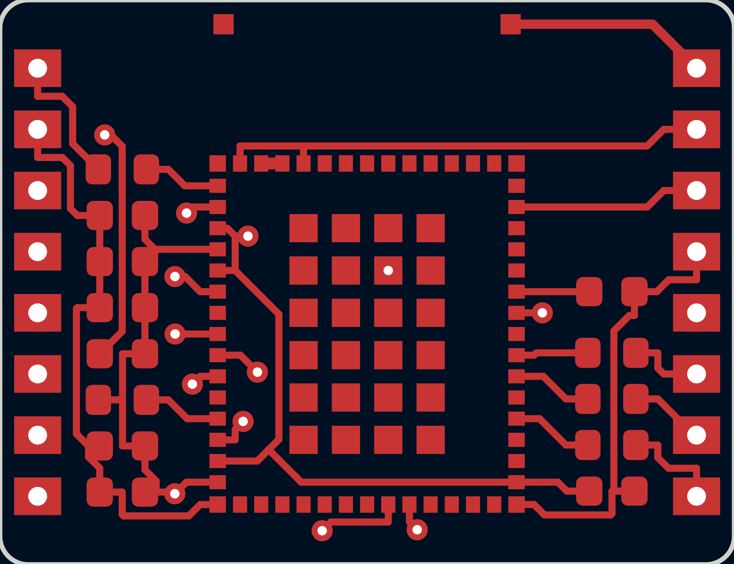
examples/ring-mouse/v0.4/docs/layers/radio-F-Cu.png
