ThyFriendlyFox/via/examples/ring-mouse/v0.4/docs/layers/radio-F-Fab.png

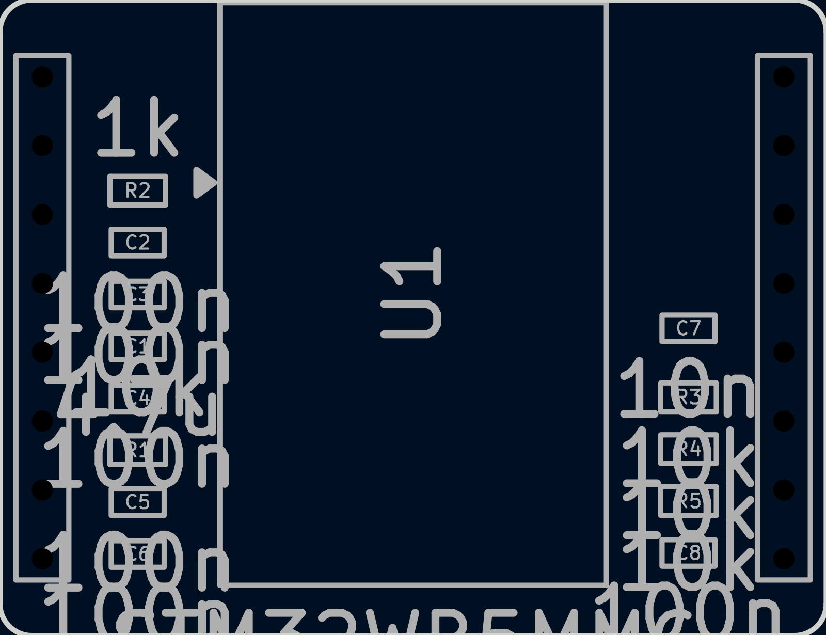
examples/ring-mouse/v0.4/docs/layers/radio-F-Fab.png
