ThyFriendlyFox/via/examples/ring-mouse/v0.4/docs/layers/radio-F-Mask.png

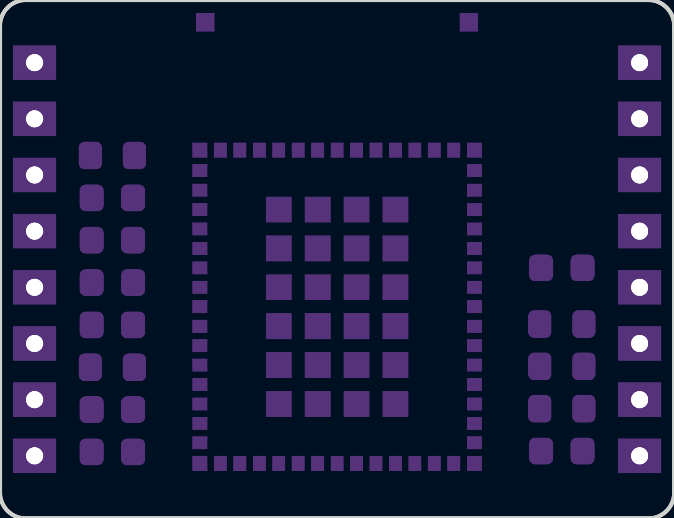
examples/ring-mouse/v0.4/docs/layers/radio-F-Mask.png
