ThyFriendlyFox/via/examples/ring-mouse/v0.4/docs/layers/radio-F-Paste.png

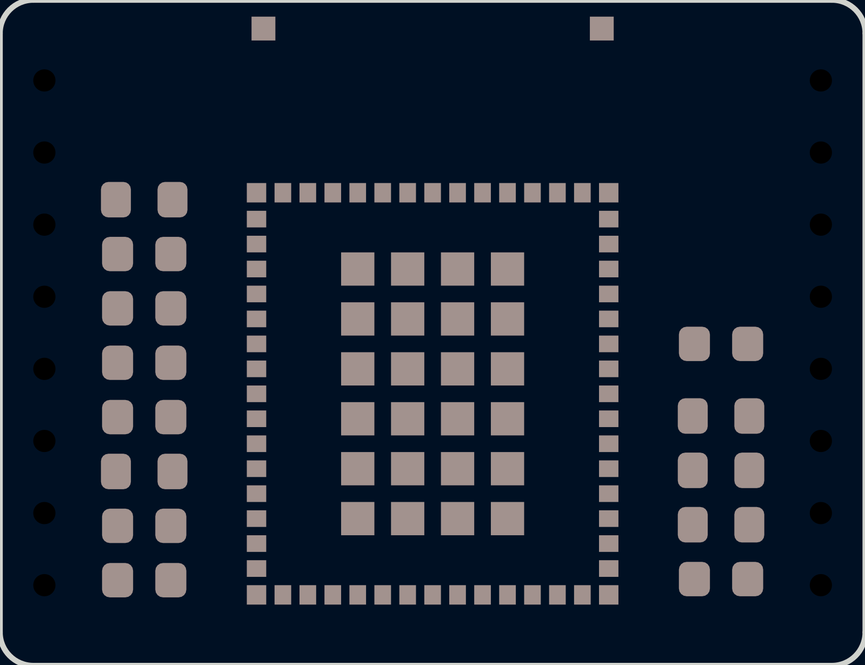
examples/ring-mouse/v0.4/docs/layers/radio-F-Paste.png
