ThyFriendlyFox/via/examples/ring-mouse/v0.4/docs/layers/radio-In1-Cu.png

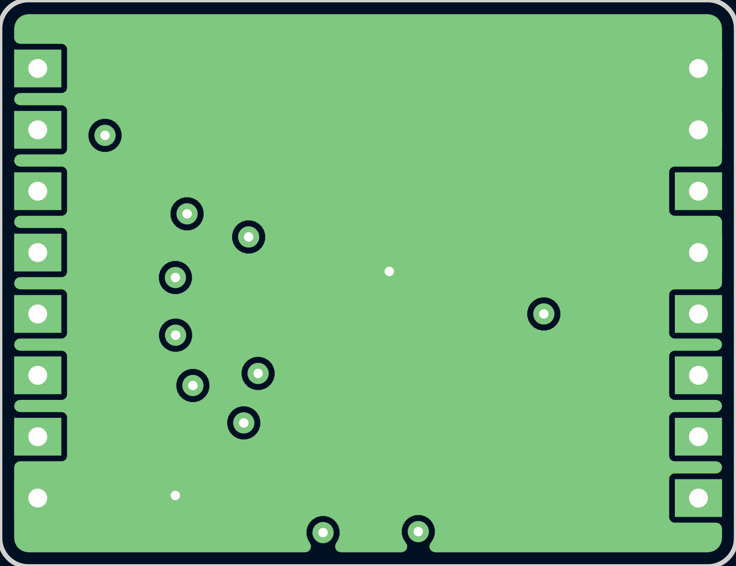
examples/ring-mouse/v0.4/docs/layers/radio-In1-Cu.png
