ThyFriendlyFox/via/examples/ring-mouse/v0.4/docs/motion-schematic.png

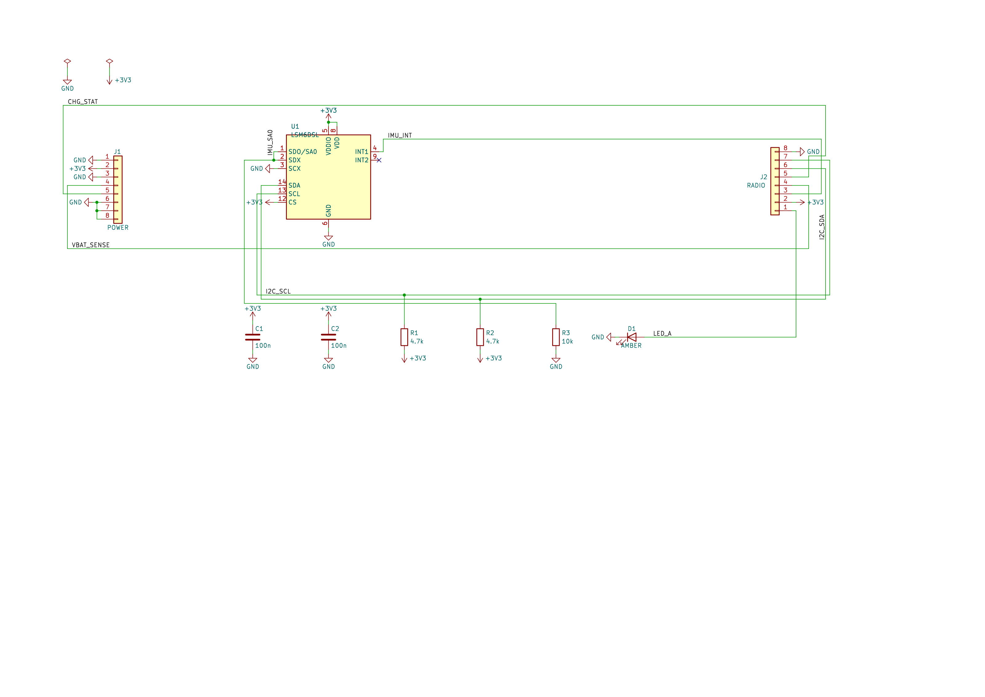
examples/ring-mouse/v0.4/docs/motion-schematic.png
