ThyFriendlyFox/via/examples/ring-mouse/v0.4/docs/power-schematic.png

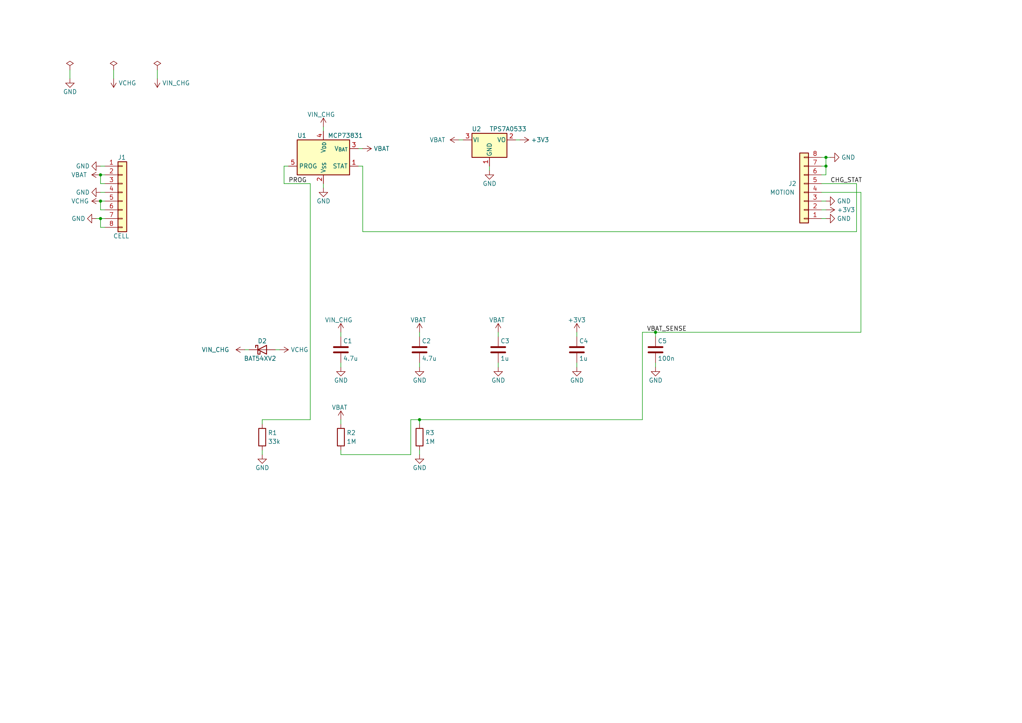
examples/ring-mouse/v0.4/docs/power-schematic.png
