ThyFriendlyFox/via/examples/ring-mouse/v0.4/docs/radio-schematic.png

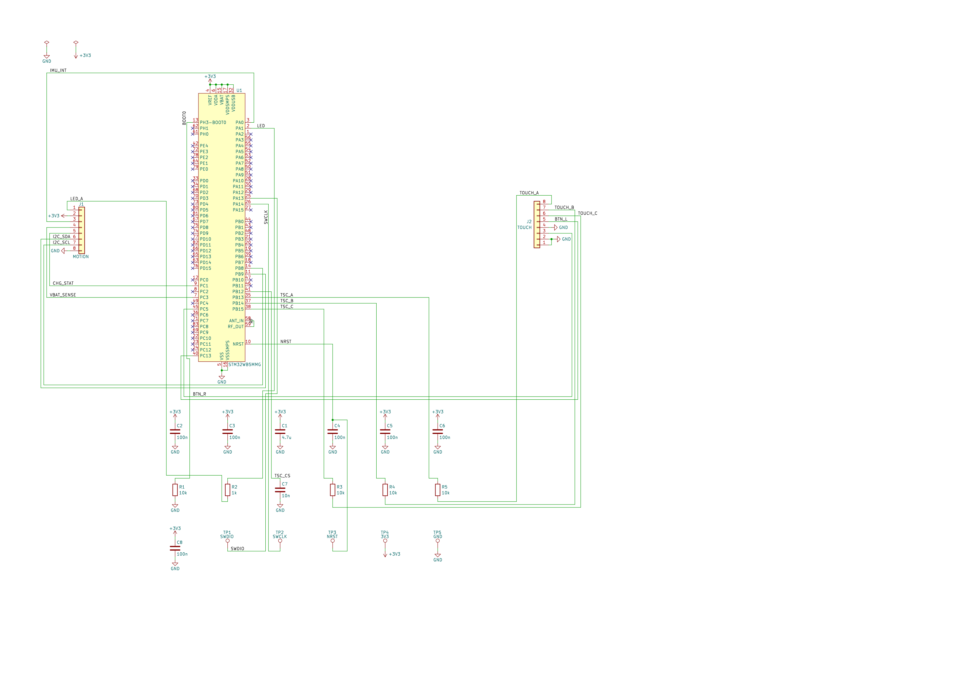
examples/ring-mouse/v0.4/docs/radio-schematic.png
