ThyFriendlyFox/via/examples/ring-mouse/v0.4/docs/touch-board-3d-iso.png

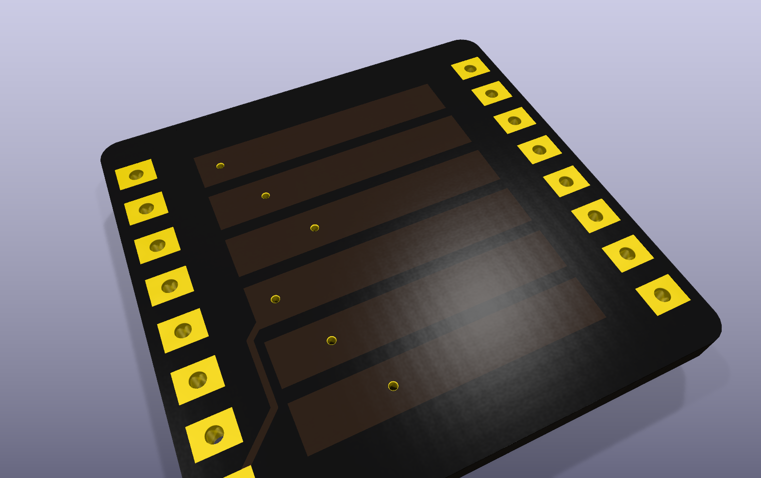
examples/ring-mouse/v0.4/docs/touch-board-3d-iso.png
