ThyFriendlyFox/via/examples/ring-mouse/v0.4/docs/touch-schematic.png

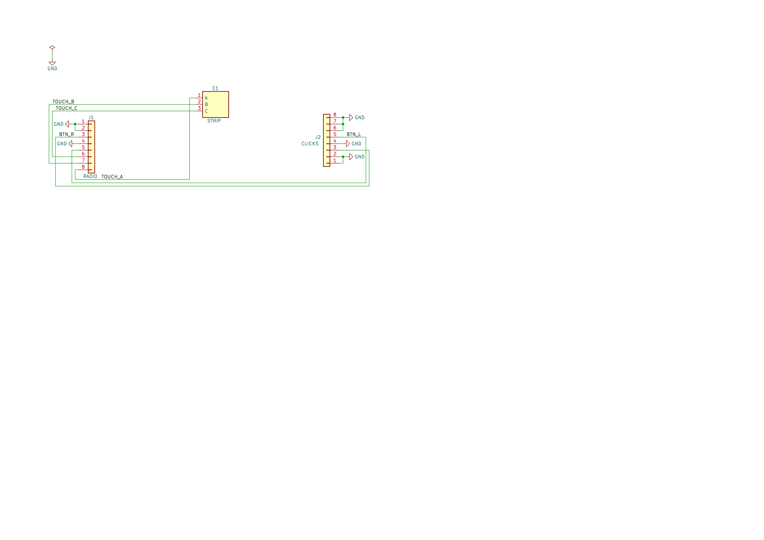
examples/ring-mouse/v0.4/docs/touch-schematic.png
