ThyFriendlyFox/via/examples/snapdragon-dev-board/v0.2/docs/layers/wyvern-B-Fab.png

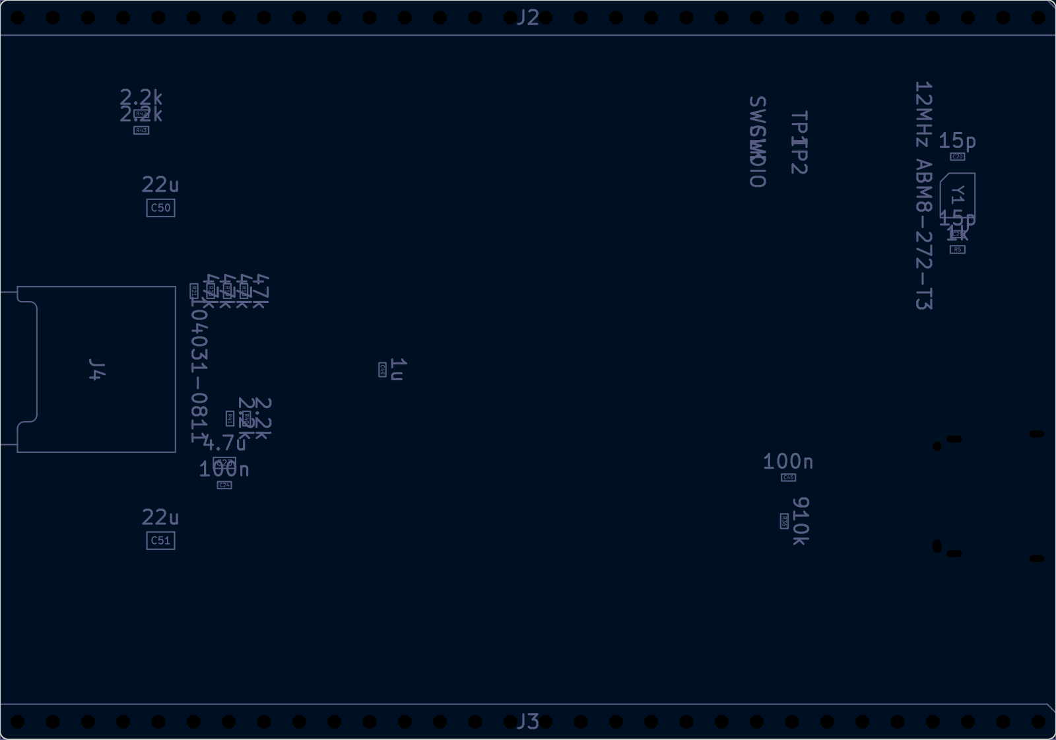
examples/snapdragon-dev-board/v0.2/docs/layers/wyvern-B-Fab.png
