ThyFriendlyFox/via/examples/snapdragon-dev-board/v0.2/docs/layers/wyvern-F-Fab.png

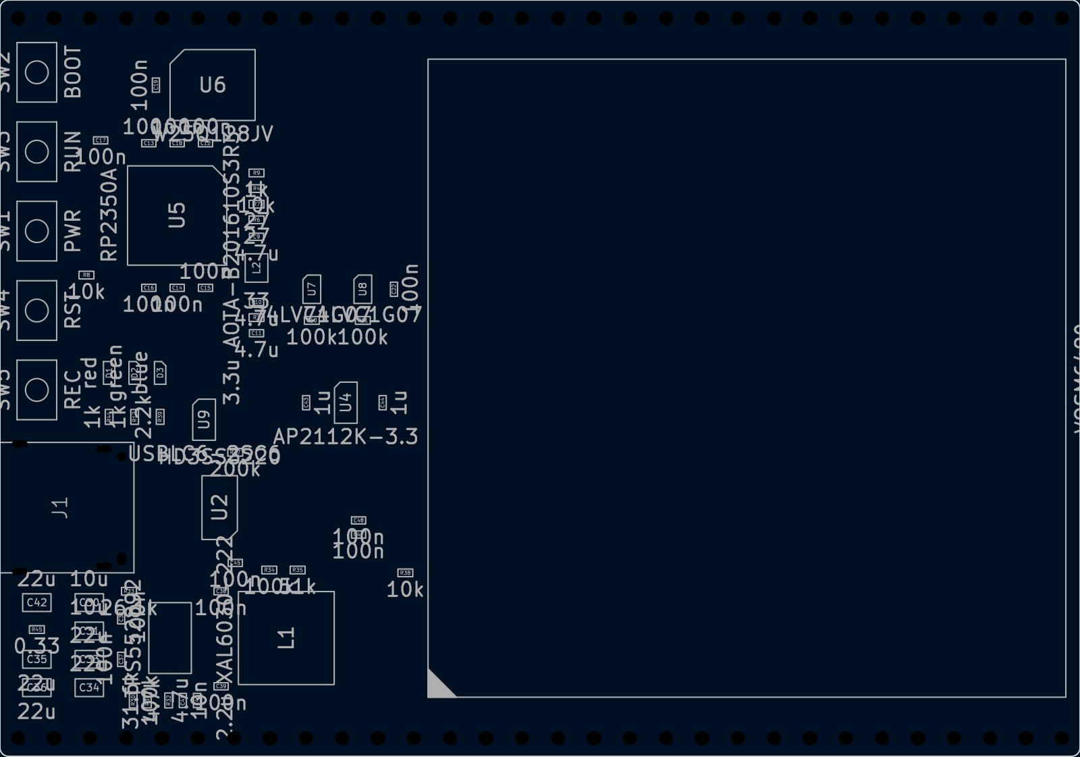
examples/snapdragon-dev-board/v0.2/docs/layers/wyvern-F-Fab.png
