ThyFriendlyFox/via/examples/snapdragon-dev-board/v0.2/docs/layers/wyvern-F-Mask.png

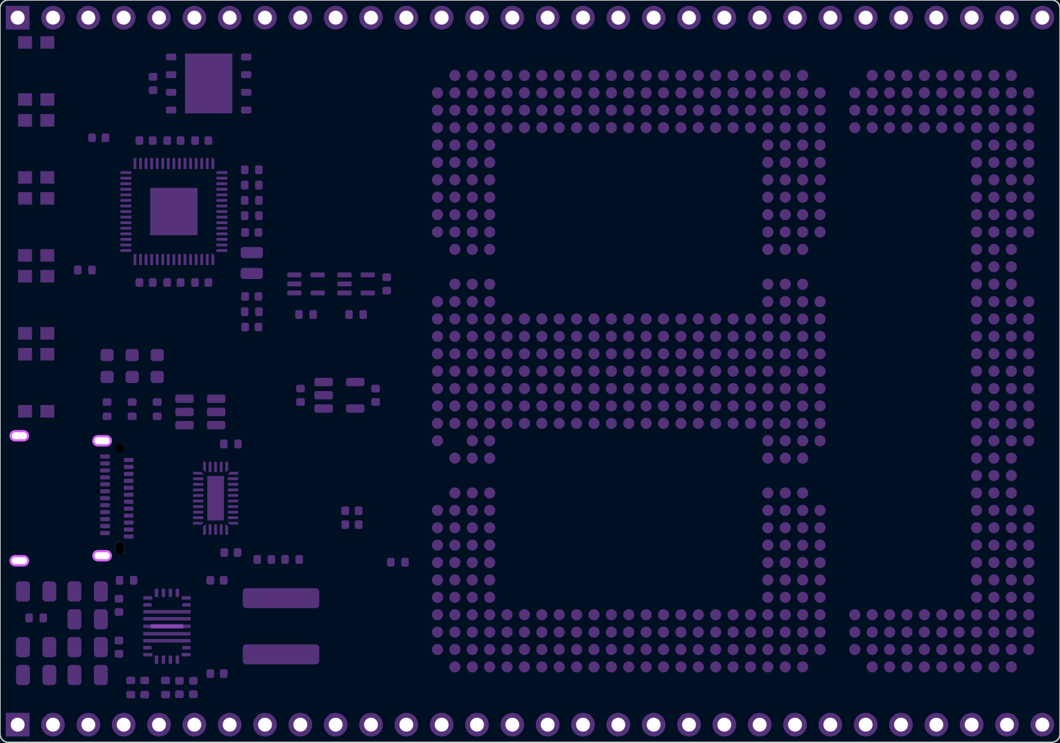
examples/snapdragon-dev-board/v0.2/docs/layers/wyvern-F-Mask.png
