ThyFriendlyFox/via/examples/snapdragon-dev-board/v0.2/docs/layers/wyvern-F-Silkscreen.png

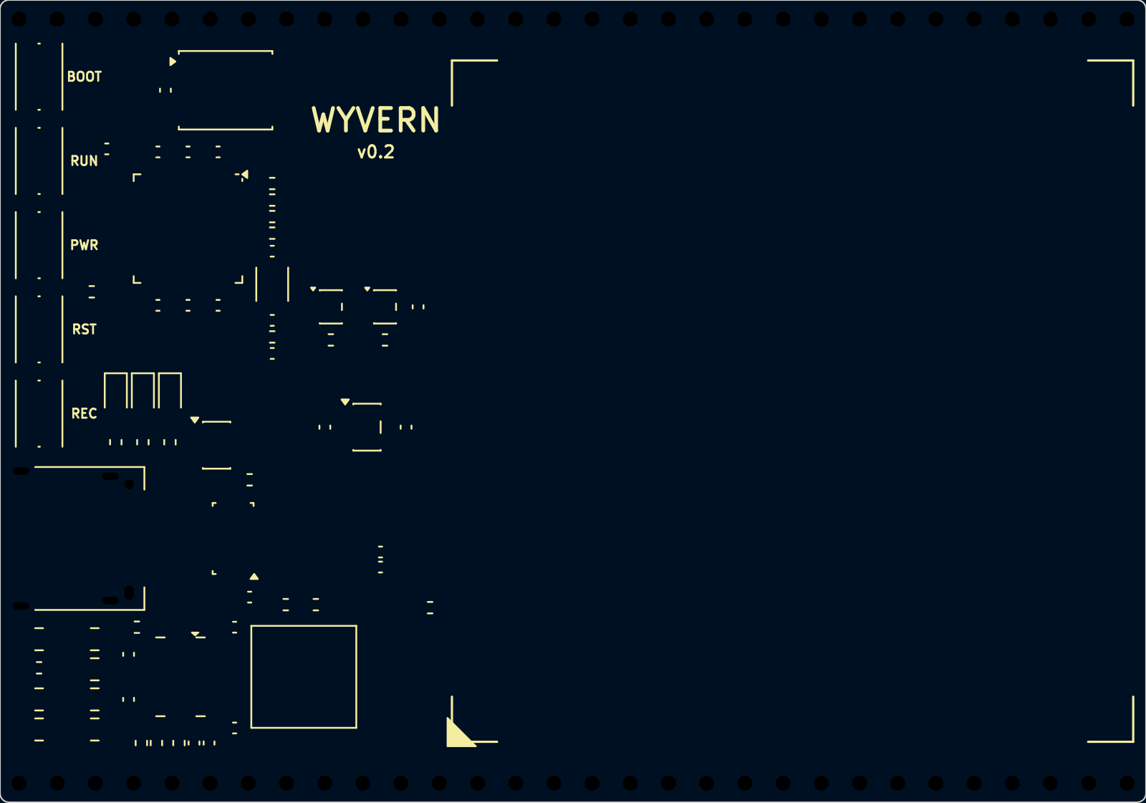
examples/snapdragon-dev-board/v0.2/docs/layers/wyvern-F-Silkscreen.png
