ThyFriendlyFox/via/examples/snapdragon-dev-board/v0.2/docs/layers/wyvern-In1-Cu.png

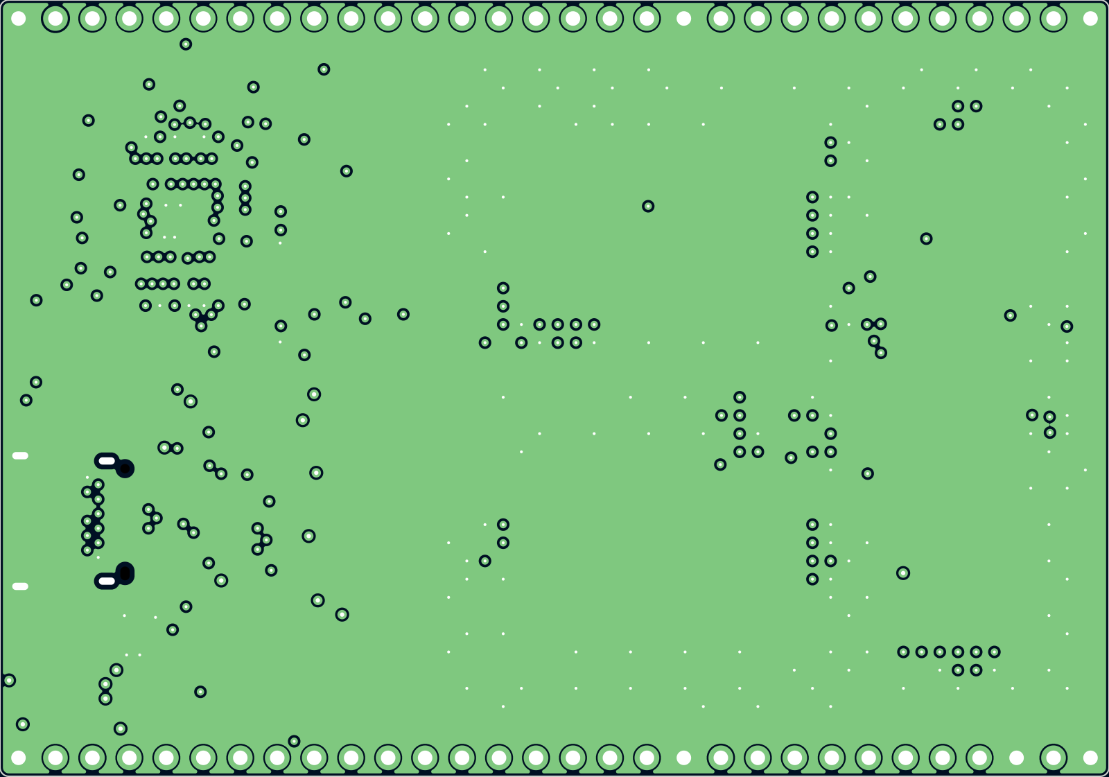
examples/snapdragon-dev-board/v0.2/docs/layers/wyvern-In1-Cu.png
