ThyFriendlyFox/via/examples/snapdragon-dev-board/v0.2/docs/layers/wyvern-In3-Cu.png

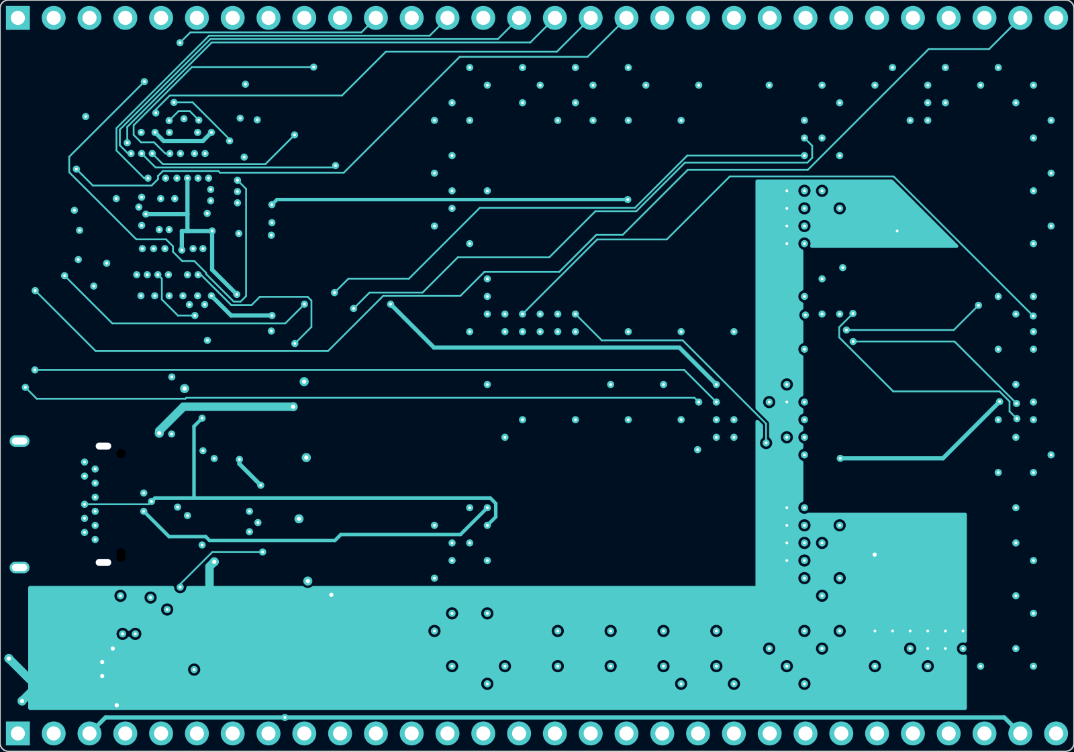
examples/snapdragon-dev-board/v0.2/docs/layers/wyvern-In3-Cu.png
