ThyFriendlyFox/via/examples/threadripper-matx/v0.3/docs/board-3d-iso.png

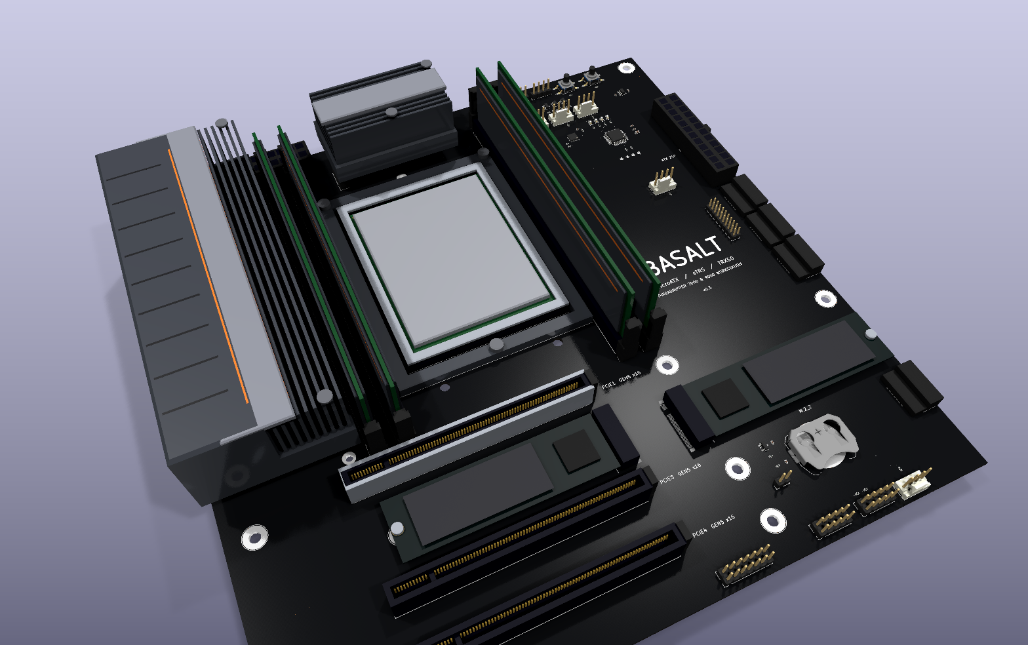
examples/threadripper-matx/v0.3/docs/board-3d-iso.png
