ThyFriendlyFox/via/examples/threadripper-matx/v0.3/docs/schematic.png

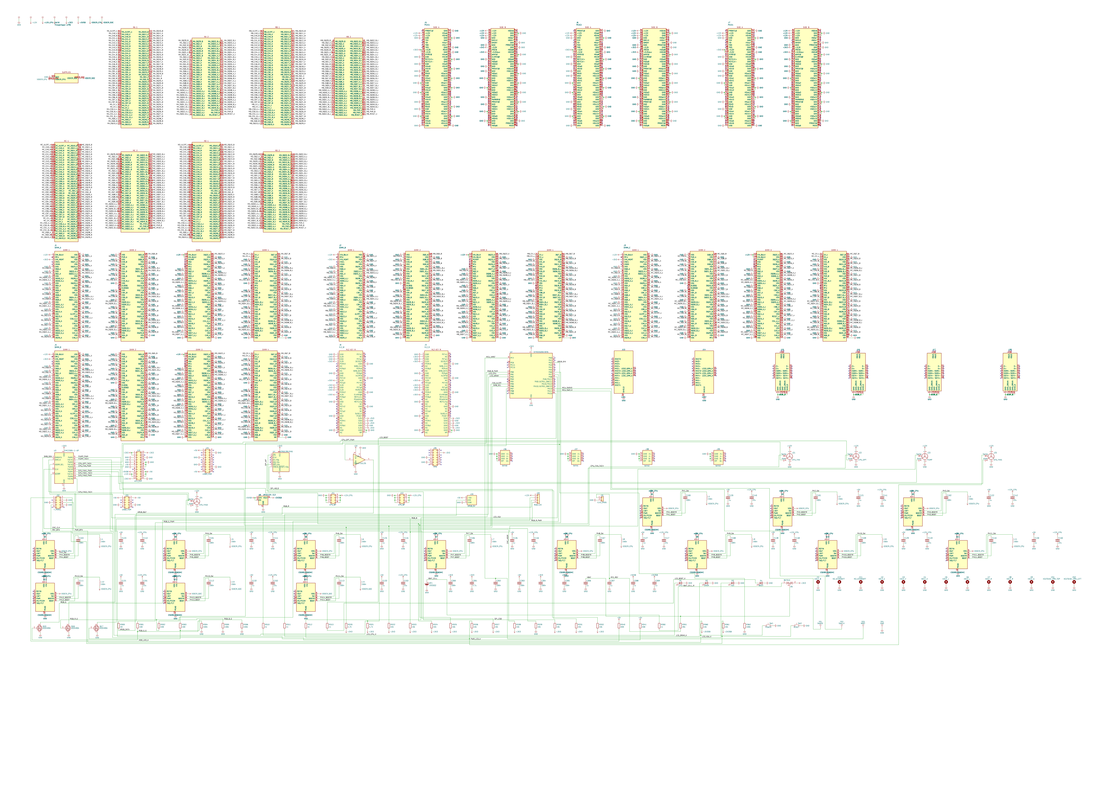
examples/threadripper-matx/v0.3/docs/schematic.png
