ThyFriendlyFox/via/examples/universal-controller/v0.2/docs/board-3d-iso.png

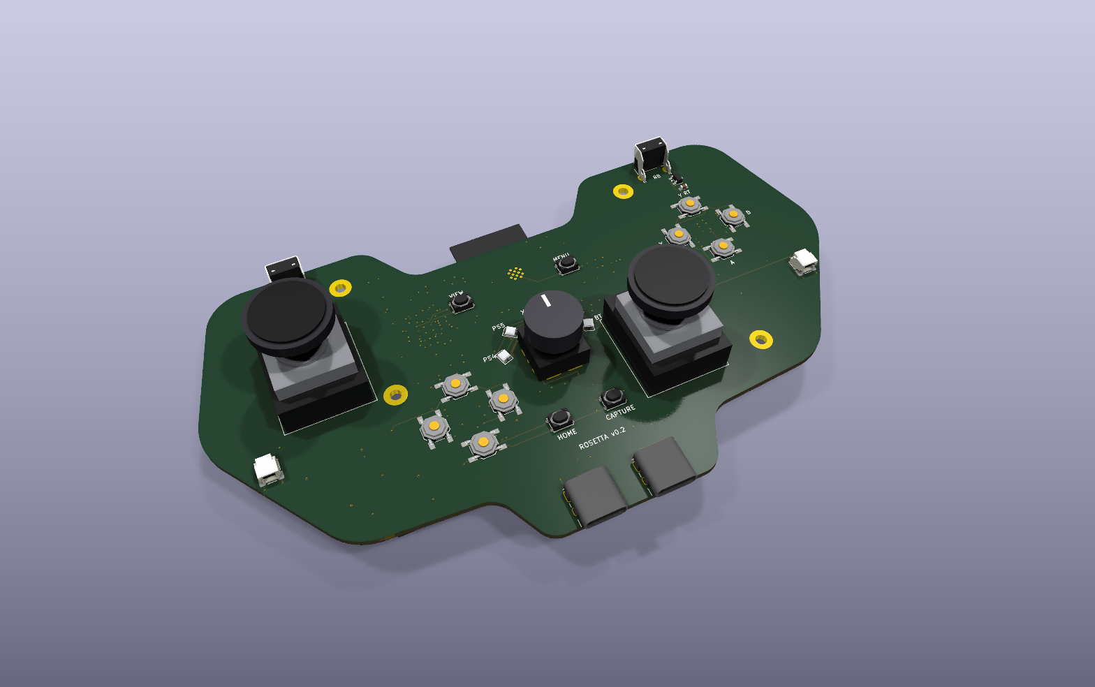
examples/universal-controller/v0.2/docs/board-3d-iso.png
