ThyFriendlyFox/via/site/examples/basalt/bottom.png

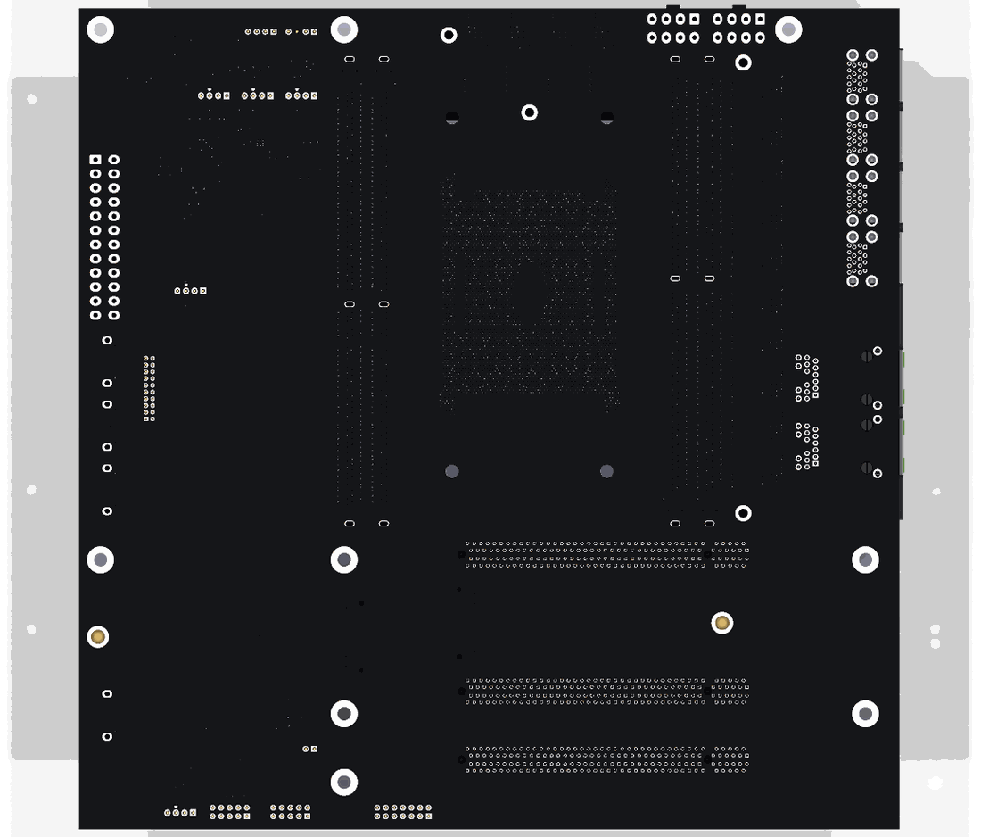
site/examples/basalt/bottom.png
