ThyFriendlyFox/via/site/examples/basalt/card.png

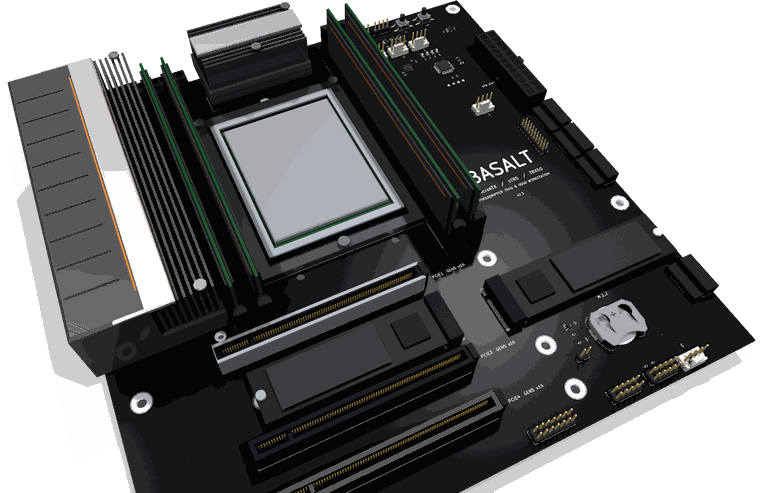
site/examples/basalt/card.png
