ThyFriendlyFox/via/site/examples/basalt/spin.webp

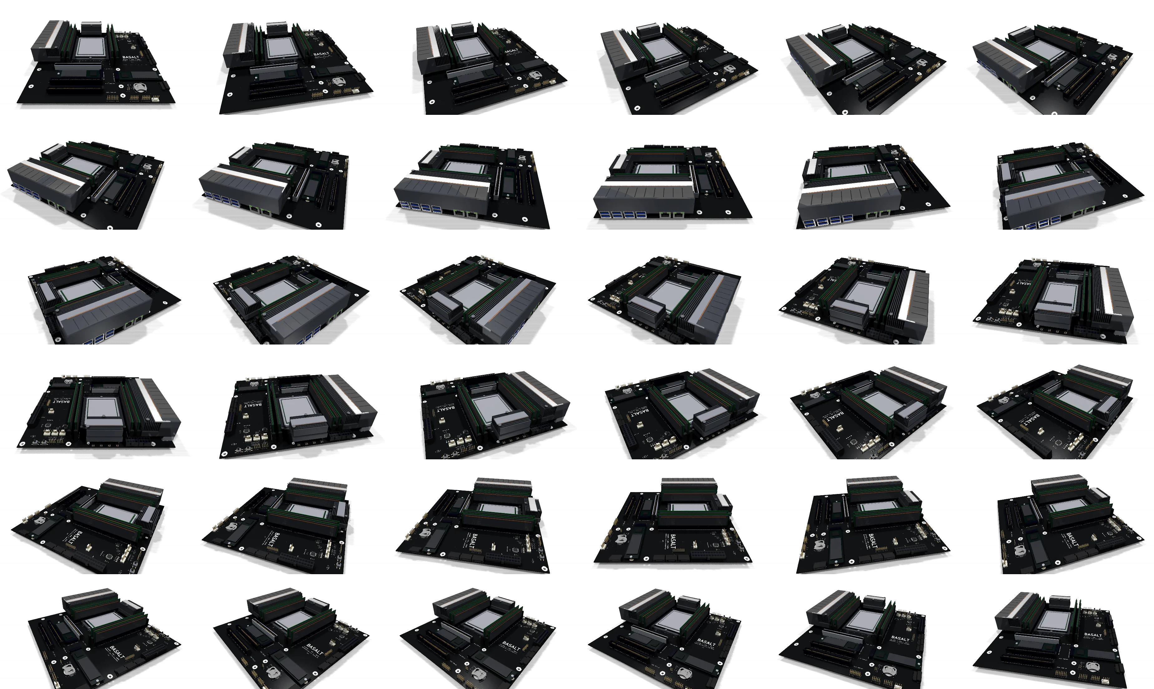
site/examples/basalt/spin.webp
