ThyFriendlyFox/via/site/examples/basalt/top.png

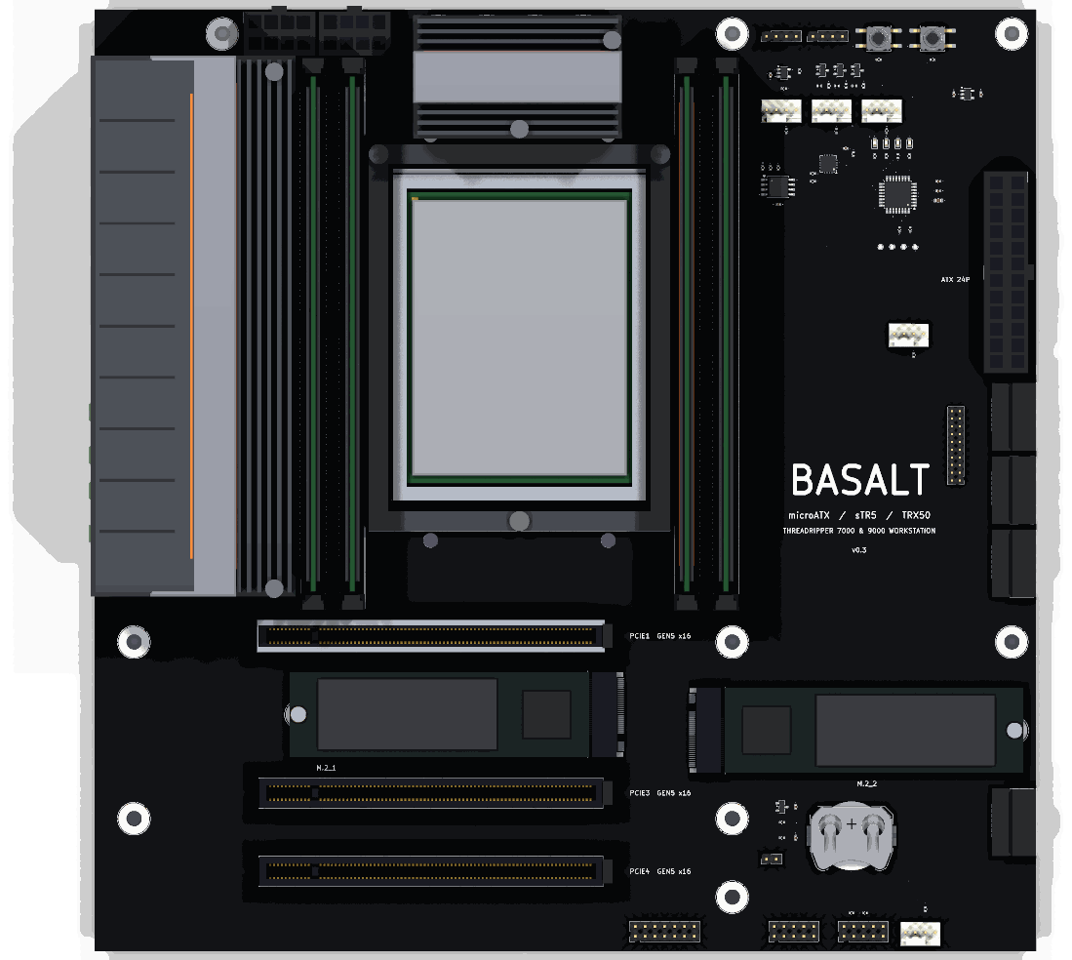
site/examples/basalt/top.png
