ThyFriendlyFox/via/site/examples/herald/bottom.png

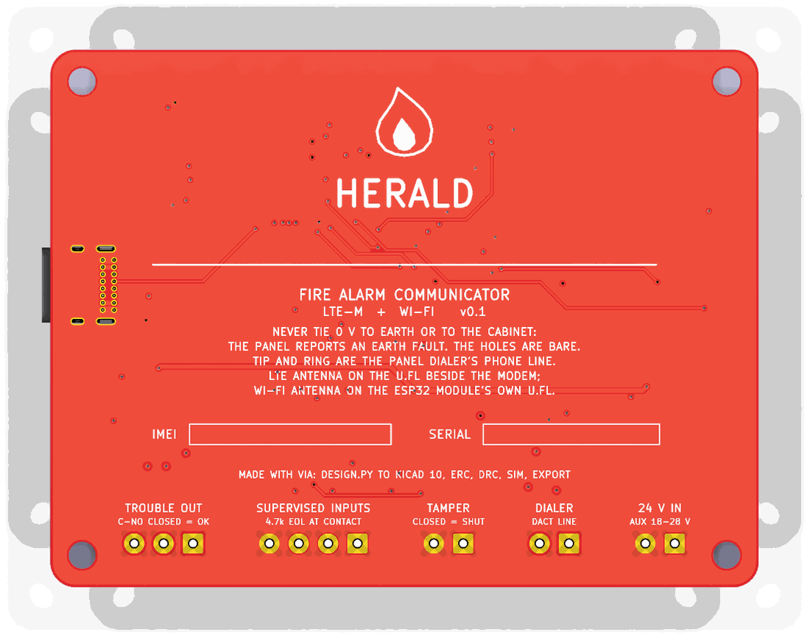
site/examples/herald/bottom.png
