ThyFriendlyFox/via/site/examples/herald/card.png

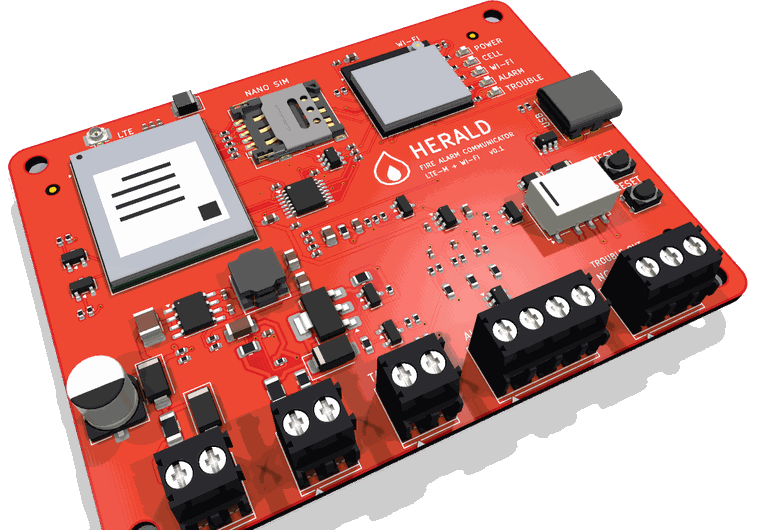
site/examples/herald/card.png
