ThyFriendlyFox/via/site/examples/herald/spin.webp

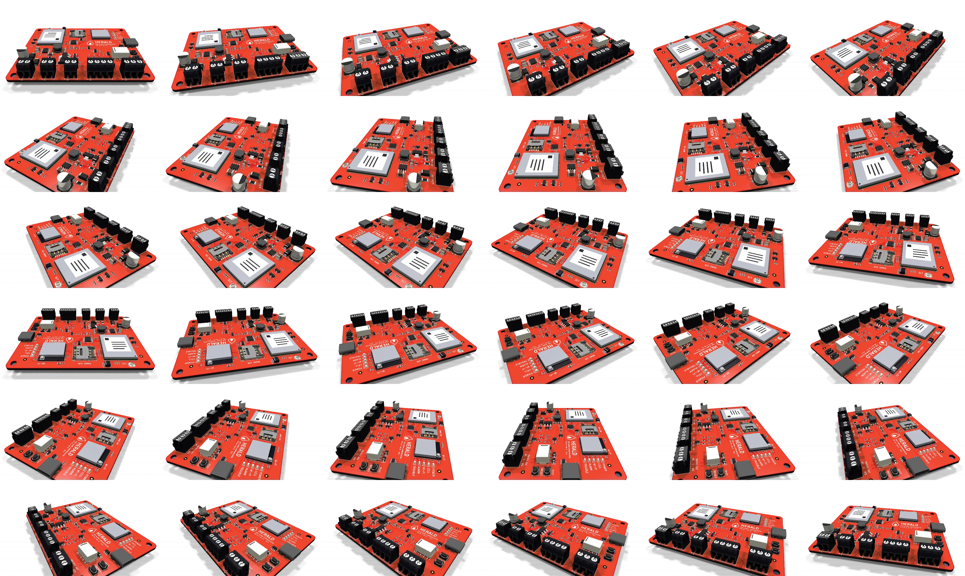
site/examples/herald/spin.webp
