ThyFriendlyFox/via/site/examples/herald/top.png

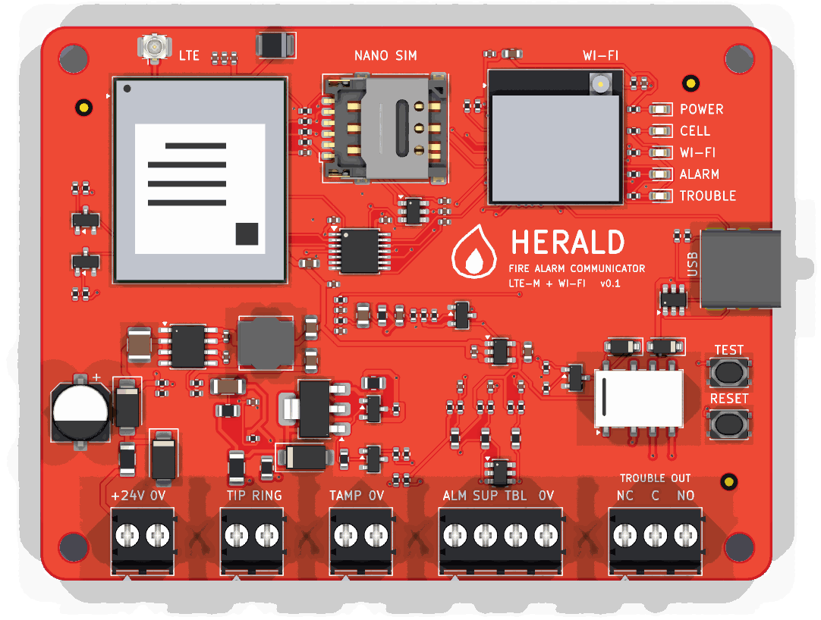
site/examples/herald/top.png
