ThyFriendlyFox/via/site/examples/hush/bottom.png

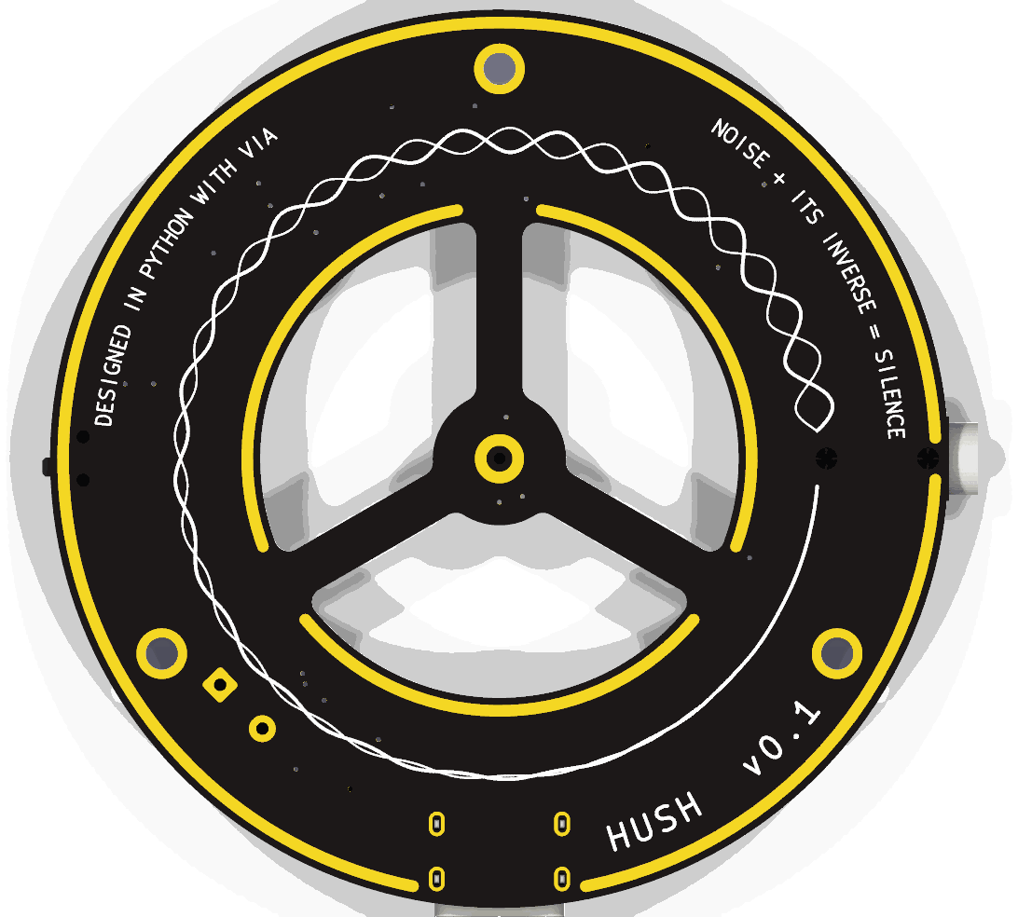
site/examples/hush/bottom.png
