ThyFriendlyFox/via/site/examples/hush/card.png

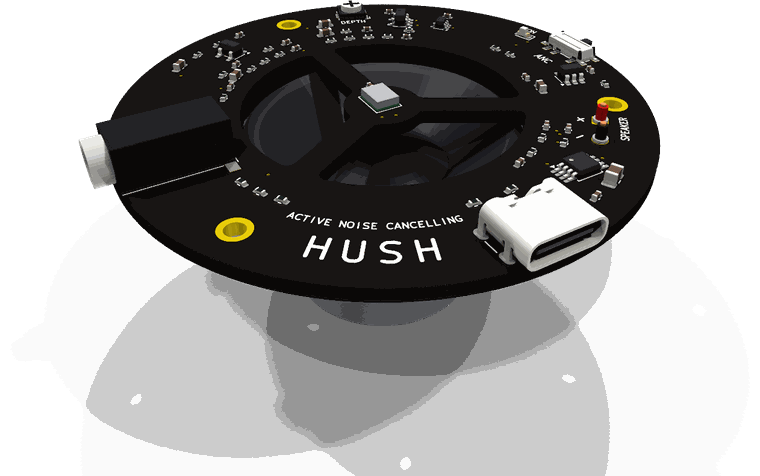
site/examples/hush/card.png
