ThyFriendlyFox/via/site/examples/hush/spin.webp

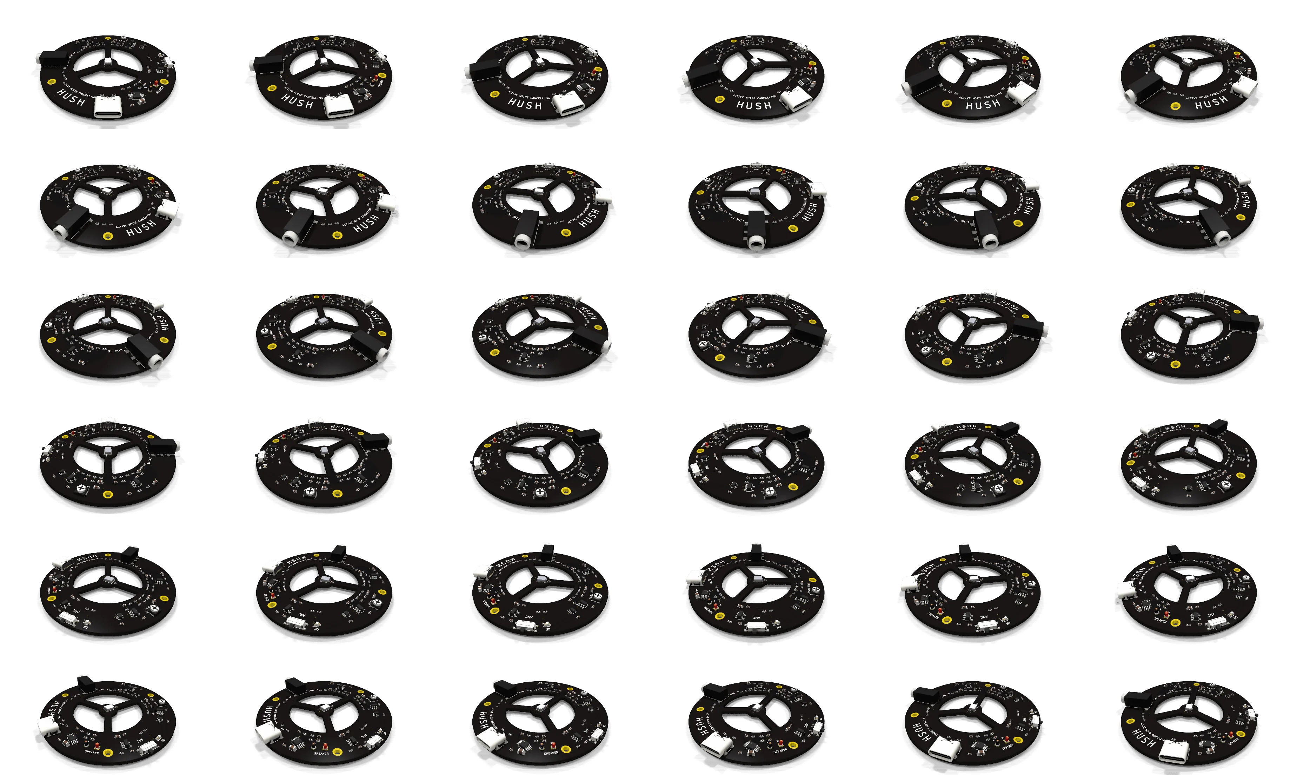
site/examples/hush/spin.webp
