ThyFriendlyFox/via/site/examples/hush/top.png

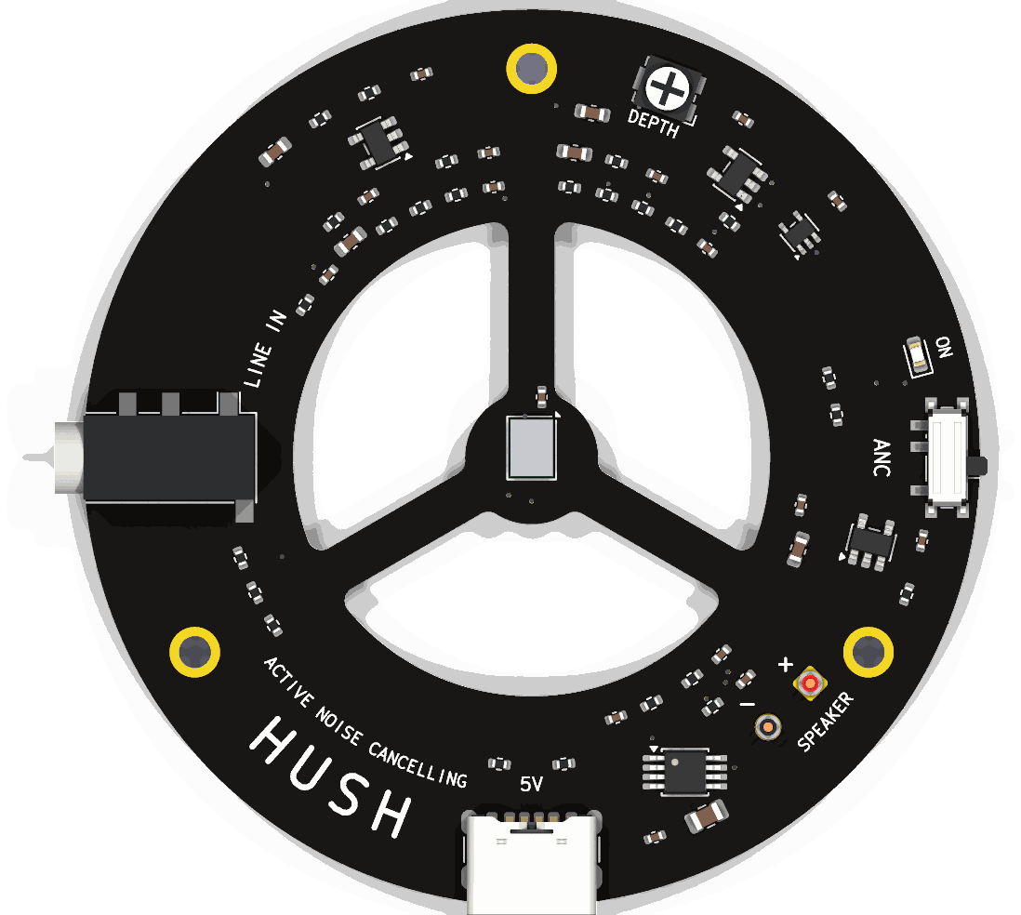
site/examples/hush/top.png
