ThyFriendlyFox/via/site/examples/rosetta/bottom.png

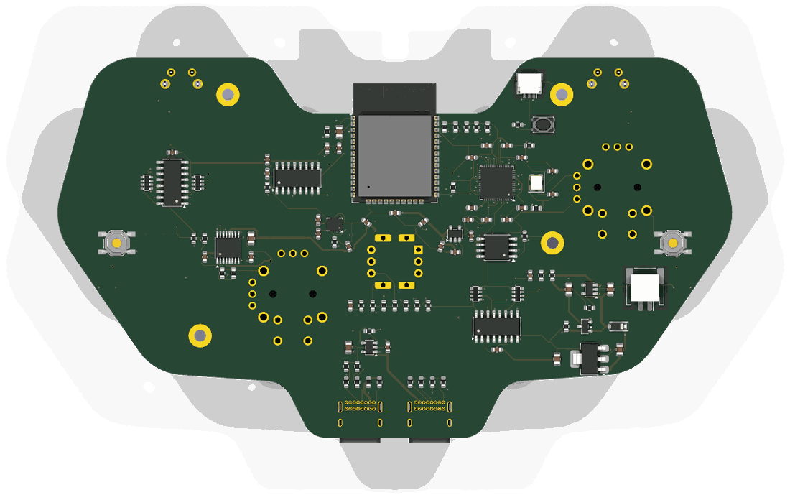
site/examples/rosetta/bottom.png
