ThyFriendlyFox/via/site/examples/rosetta/card.png

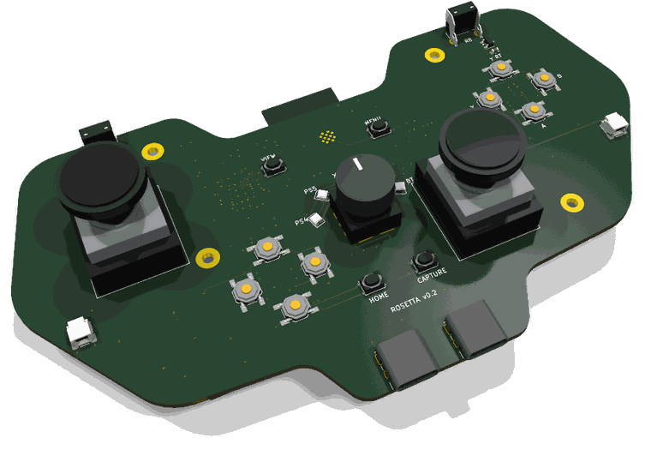
site/examples/rosetta/card.png
