ThyFriendlyFox/via/site/examples/rosetta/top.png

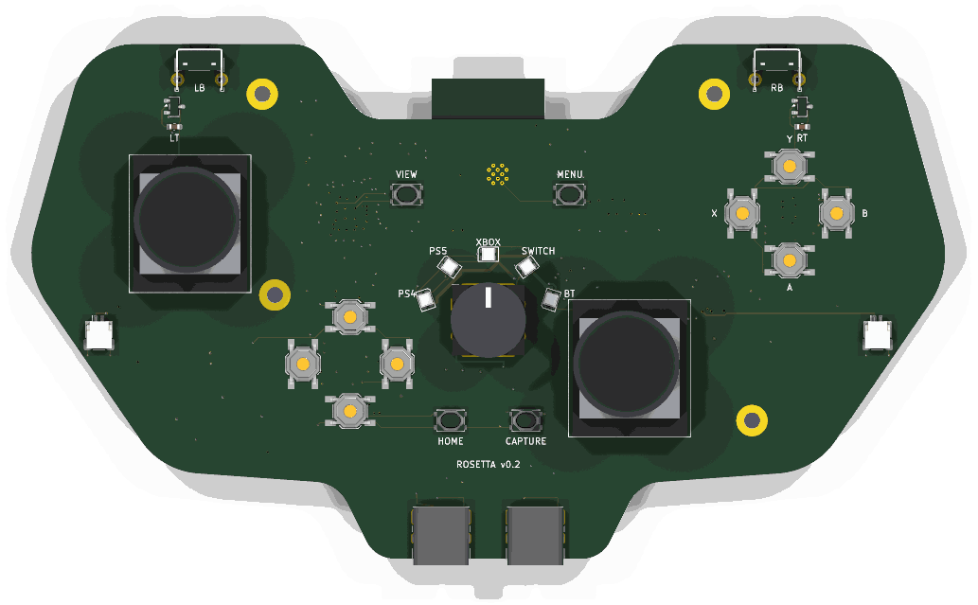
site/examples/rosetta/top.png
