ThyFriendlyFox/via/site/examples/signet/bottom.png

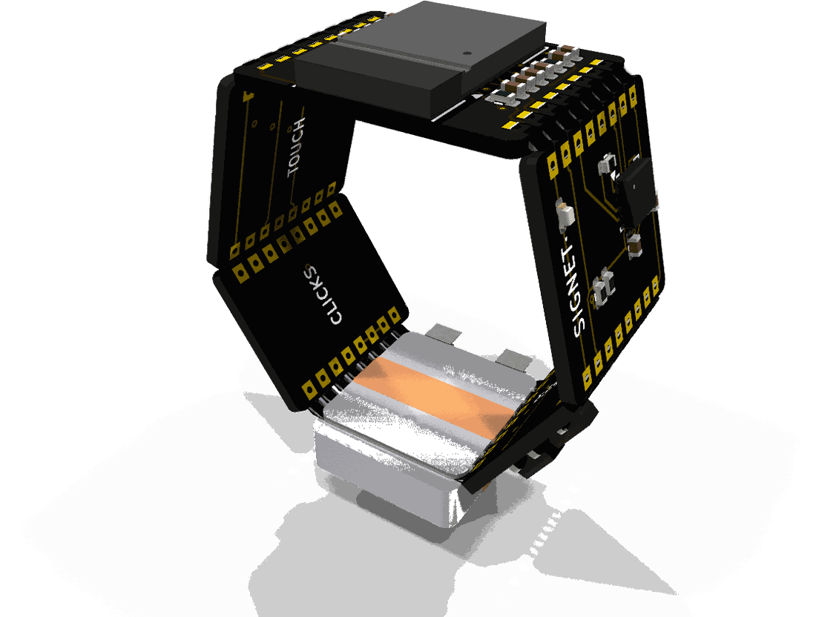
site/examples/signet/bottom.png
