ThyFriendlyFox/via/site/examples/signet/top.png

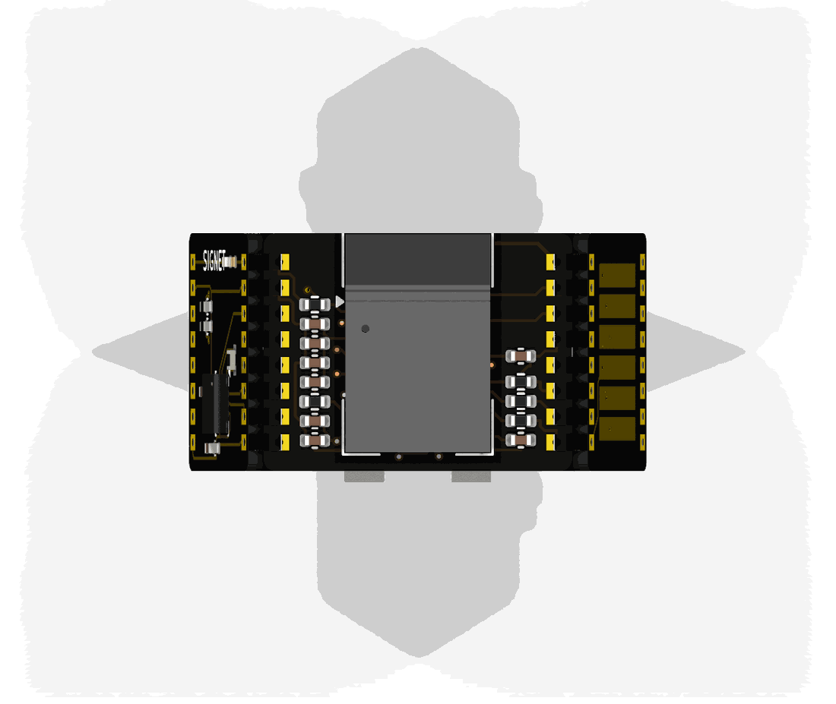
site/examples/signet/top.png
