ThyFriendlyFox/via/site/examples/wyvern/bottom.png

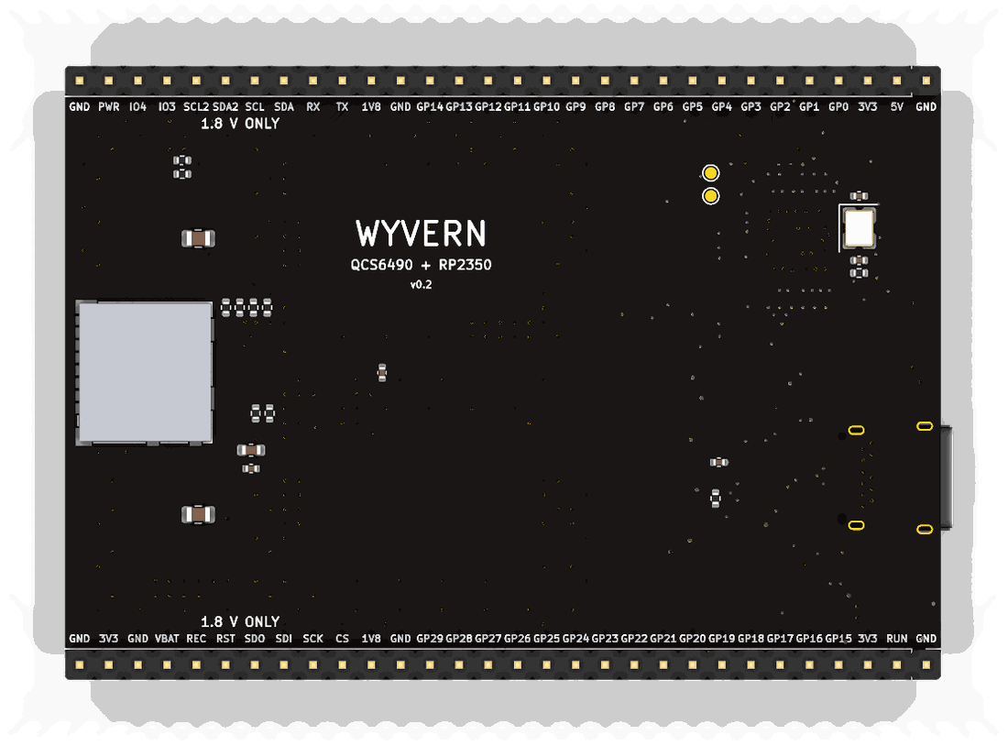
site/examples/wyvern/bottom.png
