ThyFriendlyFox/via/site/examples/wyvern/card.png

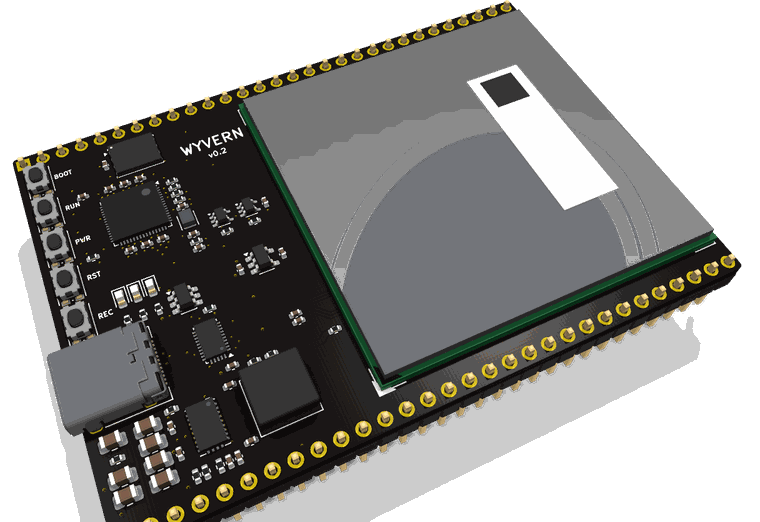
site/examples/wyvern/card.png
