ThyFriendlyFox/via/site/examples/wyvern/top.png

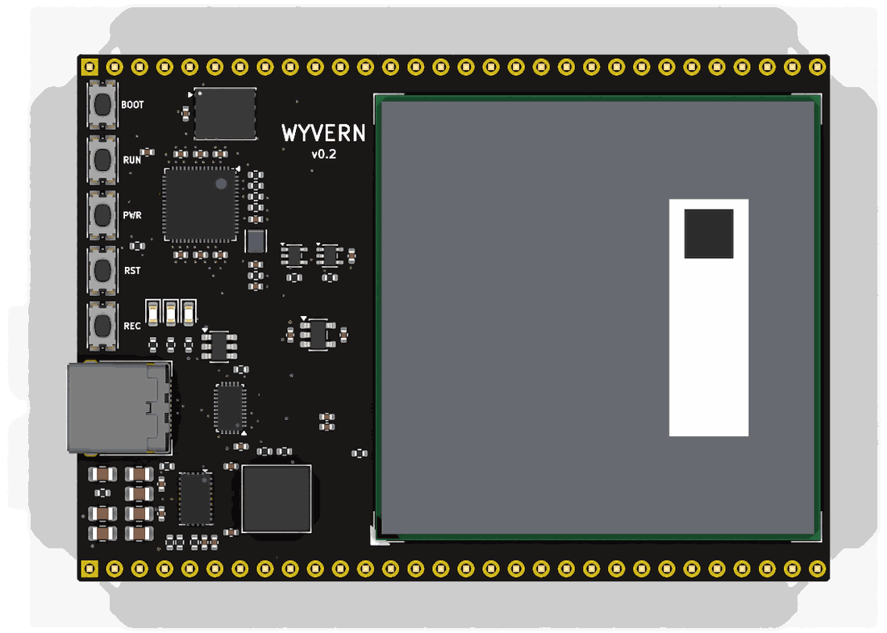
site/examples/wyvern/top.png
