ThyFriendlyFox/via/site/media/diagram-dark.png

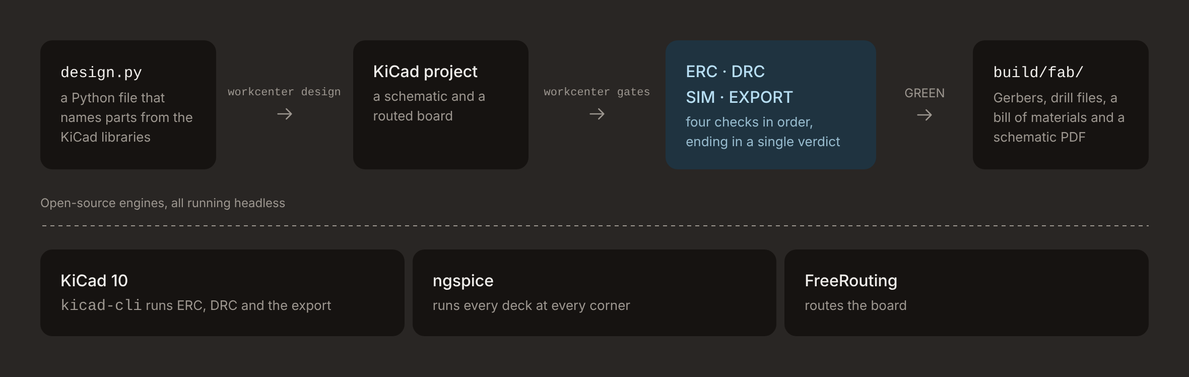
site/media/diagram-dark.png
