ThyFriendlyFox/via/site/media/hero-dark.png

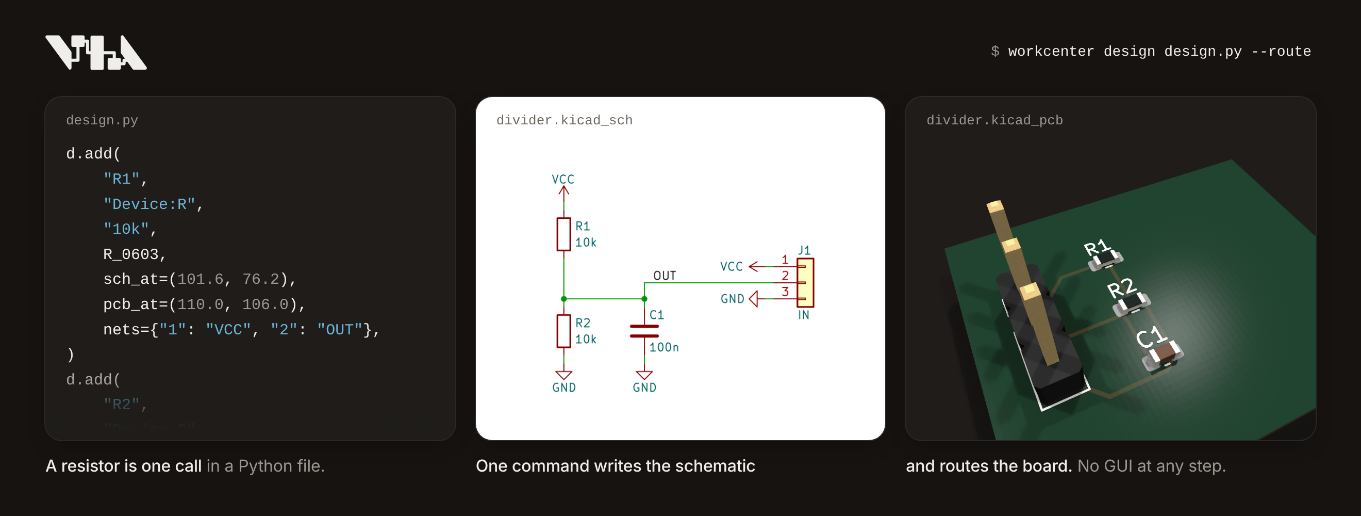
site/media/hero-dark.png
