ThyFriendlyFox/via/site/og.png

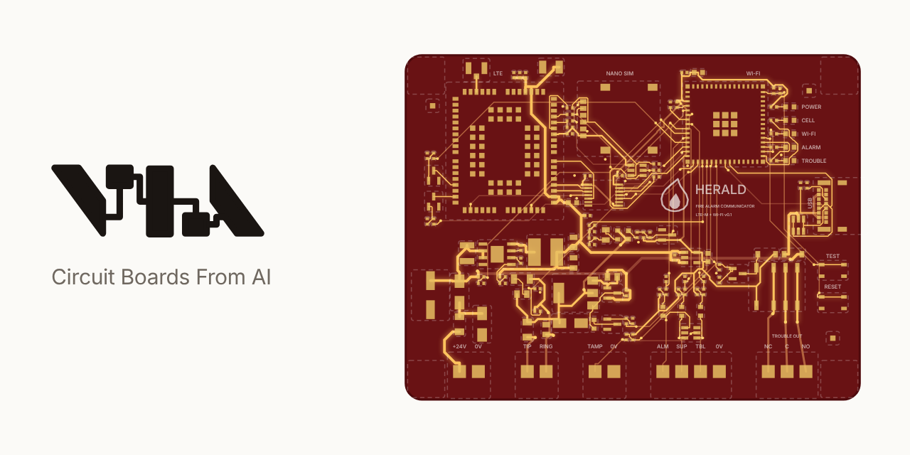
site/og.png
