ThyFriendlyFox/via/site/showcase/agentcast.png

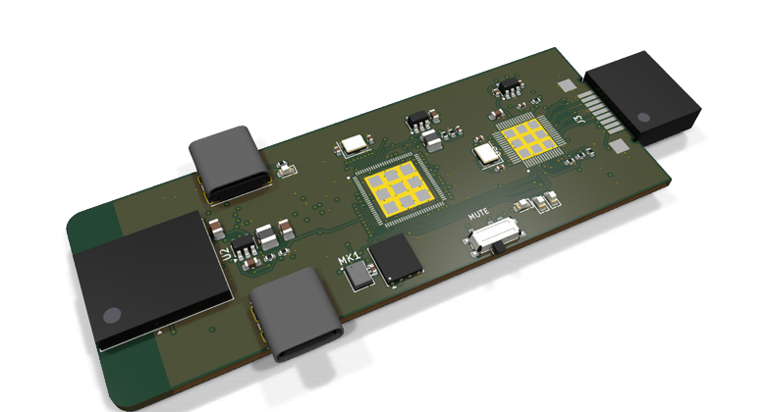
site/showcase/agentcast.png
