ThyFriendlyFox/via/site/showcase/datasheets/1c3925f167f8.png

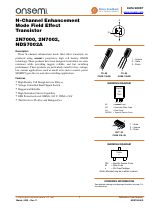
site/showcase/datasheets/1c3925f167f8.png
