ThyFriendlyFox/via/site/showcase/datasheets/3f67e1783915.png

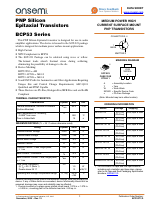
site/showcase/datasheets/3f67e1783915.png
