ThyFriendlyFox/via/site/showcase/datasheets/7ef8a9f9193f.png

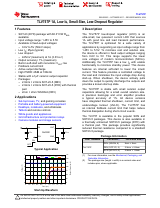
site/showcase/datasheets/7ef8a9f9193f.png
