ThyFriendlyFox/via/site/showcase/datasheets/742bdb9cdfd8.png

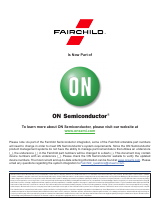
site/showcase/datasheets/742bdb9cdfd8.png
