ThyFriendlyFox/via/site/showcase/datasheets/776b8935614d.png

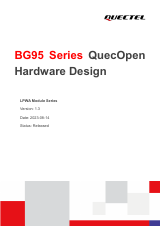
site/showcase/datasheets/776b8935614d.png
