ThyFriendlyFox/via/site/showcase/datasheets/18655e3f2cb4.png

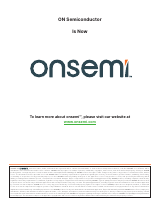
site/showcase/datasheets/18655e3f2cb4.png
