ThyFriendlyFox/via/site/showcase/datasheets/c9af4c04793f.png

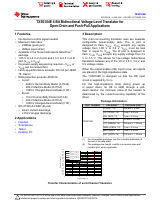
site/showcase/datasheets/c9af4c04793f.png
