ThyFriendlyFox/via/site/showcase/datasheets/c34bda30695a.png

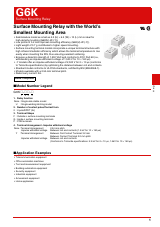
site/showcase/datasheets/c34bda30695a.png
