ThyFriendlyFox/via/site/showcase/datasheets/e6a4317b54dc.png

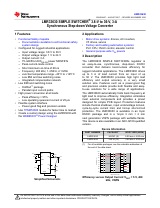
site/showcase/datasheets/e6a4317b54dc.png
