ThyFriendlyFox/via/site/showcase/datasheets/ff93b62cf93b.png

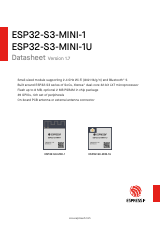
site/showcase/datasheets/ff93b62cf93b.png
