ThyFriendlyFox/via/site/showcase/herald-schematic.png

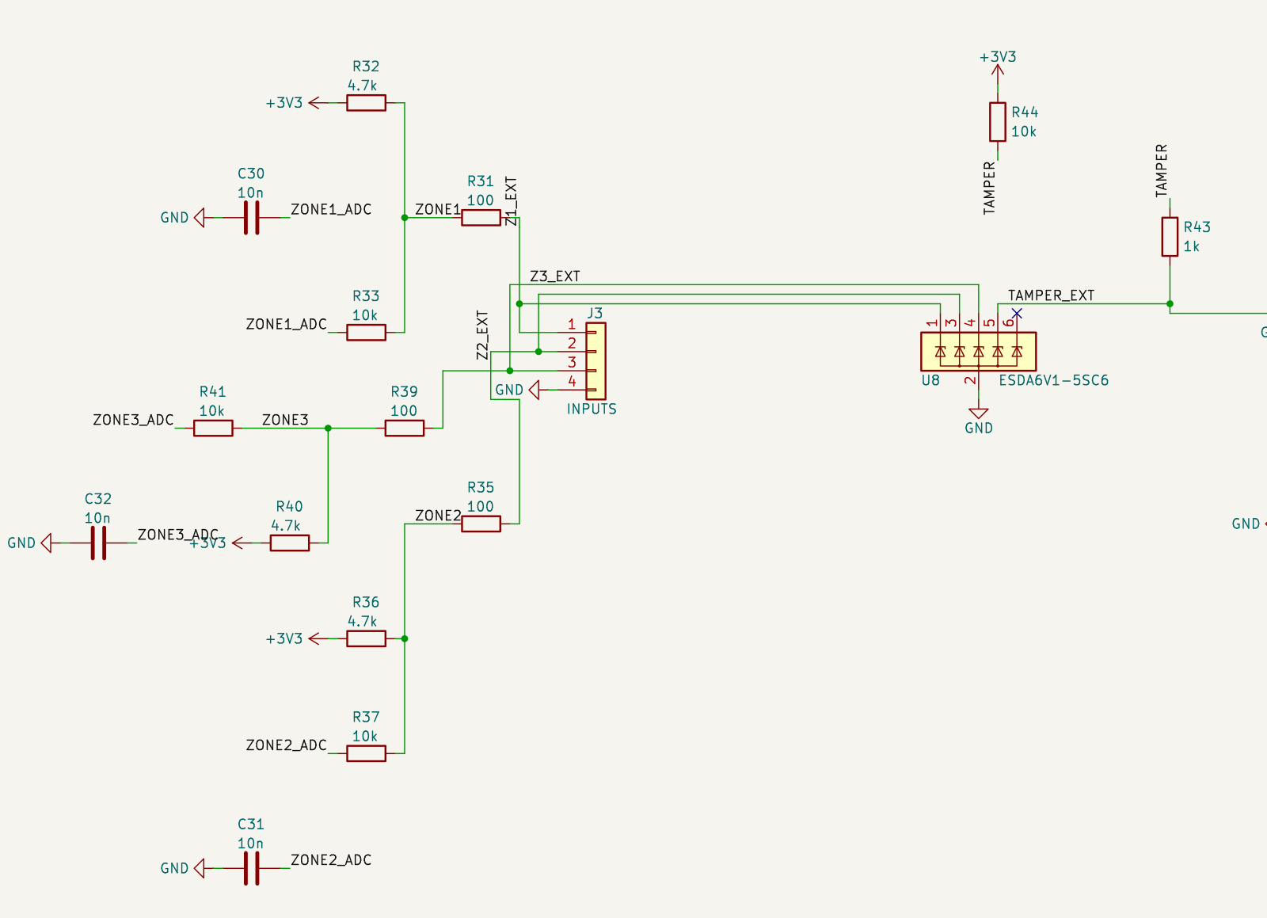
site/showcase/herald-schematic.png
