ThyFriendlyFox/via/site/showcase/herald-top.png

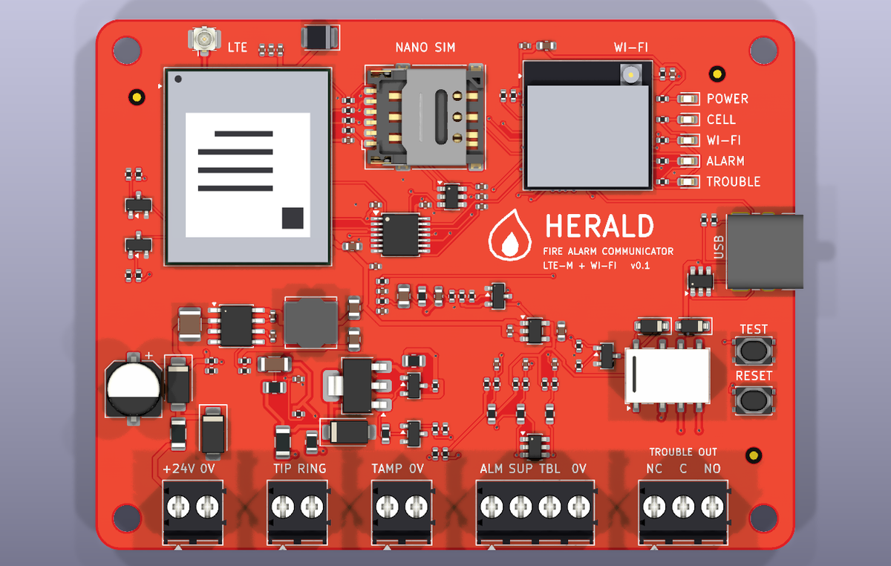
site/showcase/herald-top.png
