ThyFriendlyFox/via/examples/snapdragon-dev-board/parts/lists/v0.2.md

# Parts: wyvern

From the schematic (`wyvern.kicad_sch`, grouped by value and footprint) and `catalog.csv`, `v0.2.csv`. Prices in USD, as each supplier's page showed them on the date in the row, before shipping and tax.

## On the board

| Refs | Qty | Value | Part | Supplier | Supplier number | Unit at 1 | Stock | Checked | Note |
|---|---|---|---|---|---|---|---|---|---|
| C9-C11,C40 | 4 | 4.7u | Murata GRM155R61A475MEAAD | Digi-Key | [490-14306-1-ND](https://www.digikey.com/en/products/detail/murata-electronics/GRM155R61A475MEAAD/6234735) | $0.12 | 0 | 2026-11-11 | 10 V X5R 0402, the size Raspberry Pi's RP2350 design uses. Out of stock: 10,000 expected 16-Mar-2027; read through the fetch tool's summary of the page |
| C12-C19,C22,C24,C32,C37-C39,C45-C48 | 18 | 100n | Murata GRM155R71C104KA88D | Digi-Key | [490-3261-1-ND](https://www.digikey.com/en/products/result?keywords=GRM155R71C104KA88D) | $0.10 | 0 | 2026-11-11 | 16 V X7R. Out of stock: 10,000 expected 16-Dec-2026; read through the fetch tool's summary of the page |
| C20,C21 | 2 | 15p | Murata GRM1555C1H150JA01D | Digi-Key | [490-5888-1-ND](https://www.digikey.com/en/products/result?keywords=GRM1555C1H150JA01D) | $0.10 | 405,009 | 2026-11-11 | 50 V C0G, the crystal's load; read through the fetch tool's summary of the page |
| C23 | 1 | 4.7u | Murata GRM188R61A475KE15D | Digi-Key | [490-10477-2-ND](https://www.digikey.com/en/products/result?keywords=GRM188R61A475KE15D) | not priced | 0 | 2026-11-11 | Not priced: obsolete on Digi-Key, reel only; no 0603 4.7 uF 10 V X5R in its place read yet |
| C30,C31 | 2 | 10u | Murata GRM21BR61C106KE15L | Digi-Key | [490-3886-1-ND](https://www.digikey.com/en/products/result?keywords=GRM21BR61C106KE15L) | $0.12 | 0 | 2026-11-11 | 16 V X5R on the USB-C 5 V input. Out of stock: 3,000 expected 19-Feb-2027; read through the fetch tool's summary of the page |
| C33-C36,C42,C50,C51 | 7 | 22u | Murata GRM21BR61A226ME51L | Digi-Key | [490-10511-1-ND](https://www.digikey.com/en/products/result?keywords=GRM21BR61A226ME51L) | $0.20 | 0 | 2026-11-11 | 10 V X5R, bulk on rails of 5 V and under (v0.1's 3.8 V, v0.2's 5 V and VBUS). Out of stock, no date given; read through the fetch tool's summary of the page |
| C41 | 1 | 10n | Murata GRM155R71H103KA88D | Digi-Key | [490-4516-1-ND](https://www.digikey.com/en/products/result?keywords=GRM155R71H103KA88D) | $0.10 | 3,397,145 | 2026-11-12 | 50 V X7R, the buck-boost's compensation; read through the fetch tool's summary of the page |
| C43,C44,C49 | 3 | 1u | Murata GRM155R61A105KE15D | Digi-Key | [490-3890-2-ND](https://www.digikey.com/en/products/result?keywords=GRM155R61A105KE15D) | not priced | 0 | 2026-11-11 | Not priced: obsolete on Digi-Key, reel only. The page names YAGEO CC0402KRX5R6BB105 and KEMET C0402C105K8PACTU in its place; their voltage and dielectric are not yet read from their datasheets |
| D1 | 1 | red | Lite-On LTST-C191KRKT | Digi-Key | [160-1447-1-ND](https://www.digikey.com/en/products/result?keywords=LTST-C191KRKT) | $0.15 | 1,334,425 | 2026-11-11 | v0.2's power light, 3.3 V through 1k; on v0.1, the red of the PMI8998's RGB light; read through the fetch tool's summary of the page |
| D2 | 1 | green | Lite-On LTST-C191KGKT | Digi-Key | [160-1446-1-ND](https://www.digikey.com/en/products/detail/liteon/LTST-C191KGKT/386835) | $0.15 | 2,228,010 | 2026-11-11 | The GP25 light; on v0.1 also the green of the PMI8998's RGB light; read through the fetch tool's summary of the page |
| D3 | 1 | blue | Lite-On LTST-C191TBKT | Digi-Key | [160-1647-1-ND](https://www.digikey.com/en/products/detail/liteon/LTST-C191TBKT/388530) | $0.25 | 276,683 | 2026-11-11 | Vf 3.3 V typical; read through the fetch tool's summary of the page |
| J1 | 1 | 12401610E4#2A | Amphenol ICC 12401610E4#2A | Digi-Key | [12401610E4#2ACT-ND](https://www.digikey.com/en/products/result?keywords=12401610E4%232A) | $1.43 | 79,753 | 2026-11-11 | USB 3.1 Gen 2 Type-C receptacle, top mount dual SMT; read through the fetch tool's summary of the page |
| J2,J3 | 2 | 1x30 header | Sullins PRPC030SAAN-RC | Digi-Key | [35-PRPC030SAAN-RC-ND](https://www.digikey.com/en/products/result?keywords=PRPC030SAAN-RC) | $0.55 | 2,413 | 2026-11-12 | 1 x 30, 0.1 in, soldered underneath, pins down; read through the fetch tool's summary of the page |
| J4 | 1 | 104031-0811 | Molex 1040310811 | Digi-Key | [WM6357CT-ND](https://www.digikey.com/en/products/result?keywords=1040310811) | $2.21 | 29,741 | 2026-11-11 | Push-pull, 1.42 mm, card detect; read through the fetch tool's summary of the page |
| L1 | 1 | 2.2u XAL6030-222 | Coilcraft XAL6030-222MEC | Coilcraft |  | not priced |  | 2026-11-12 | Not priced: Digi-Key returned no results for XAL6030-222MEC (its XAL6030 search lists only XAL6030-102MEC); Coilcraft's page refused the fetch (HTTP 403) and Mouser's search returned HTTP 503. 2.2 uH, Isat 15.9 A (Coilcraft Document 887) |
| L2 | 1 | 3.3u AOTA-B201610S3R3 | Abracon AOTA-B201610S3R3-101-T | Digi-Key | [535-AOTA-B201610S3R3-101-TCT-ND](https://www.digikey.com/en/products/result?keywords=AOTA-B201610S3R3-101-T) | $0.21 | 3,426 | 2026-11-11 | The polarised 0806 inductor Raspberry Pi's RP2350 design asks for; read through the fetch tool's summary of the page |
| R3 | 1 | 33 | YAGEO RC0402FR-0733RL | Digi-Key | [311-33.0LRCT-ND](https://www.digikey.com/en/products/detail/yageo/RC0402FR-0733RL/726593) | $0.10 | 568,273 | 2026-11-11 | 1 % 1/16 W; read through the fetch tool's summary of the page |
| R4,R8,R38 | 3 | 10k | YAGEO RC0402FR-0710KL | Digi-Key | [311-10.0KLRCT-ND](https://www.digikey.com/en/products/result?keywords=RC0402FR-0710KL) | $0.10 | 6,509,272 | 2026-11-11 | 1 % 1/16 W; read through the fetch tool's summary of the page |
| R5,R9,R12,R44 | 4 | 1k | YAGEO RC0402FR-071KL | Digi-Key | [311-1.00KLRCT-ND](https://www.digikey.com/en/products/result?keywords=RC0402FR-071KL) | $0.10 | 2,715,933 | 2026-11-11 | 1 % 1/16 W; read through the fetch tool's summary of the page |
| R6,R7 | 2 | 27 | YAGEO RC0402FR-0727RL | Digi-Key | [YAG3086CT-ND](https://www.digikey.com/en/products/result?keywords=RC0402FR-0727RL) | $0.10 | 459,607 | 2026-11-11 | 1 % 1/16 W; read through the fetch tool's summary of the page |
| R10,R11,R30,R34 | 4 | 100k | YAGEO RC0402FR-07100KL | Digi-Key | [311-100KLRCT-ND](https://www.digikey.com/en/products/result?keywords=RC0402FR-07100KL) | $0.10 | 4,532,396 | 2026-11-11 | 1 % 1/16 W; read through the fetch tool's summary of the page |
| R18-R21 | 4 | 47k | YAGEO RC0402FR-0747KL | Digi-Key | [311-47.0KLRCT-ND](https://www.digikey.com/en/products/result?keywords=RC0402FR-0747KL) | $0.10 | 440,041 | 2026-11-11 | 1 % 1/16 W; read through the fetch tool's summary of the page |
| R31 | 1 | 31.6k | YAGEO RC0402FR-0731K6L | Digi-Key | [YAG3115CT-ND](https://www.digikey.com/en/products/result?keywords=RC0402FR-0731K6L) | $0.10 | 1,202,391 | 2026-11-12 | 1 % 1/16 W; read through the fetch tool's summary of the page |
| R32 | 1 | 4.7k | YAGEO RC0402FR-074K7L | Digi-Key | [311-4.7KLRCT-ND](https://www.digikey.com/en/products/result?keywords=RC0402FR-074K7L) | $0.10 | 6,665 | 2026-11-12 | 1 % 1/16 W; read through the fetch tool's summary of the page |
| R33 | 1 | 26.1k | YAGEO RC0402FR-0726K1L | Digi-Key | [311-26.1KLRCT-ND](https://www.digikey.com/en/products/result?keywords=RC0402FR-0726K1L) | $0.10 | 121,475 | 2026-11-12 | 1 % 1/16 W; read through the fetch tool's summary of the page |
| R35 | 1 | 51k | YAGEO RC0402FR-0751KL | Digi-Key | [311-51.0KLRCT-ND](https://www.digikey.com/en/products/result?keywords=RC0402FR-0751KL) | $0.10 | 338,264 | 2026-11-12 | 1 % 1/16 W; read through the fetch tool's summary of the page |
| R36 | 1 | 910k | YAGEO RC0402FR-07910KL | Digi-Key | [YAG3257CT-ND](https://www.digikey.com/en/products/result?keywords=RC0402FR-07910KL) | $0.10 | 0 | 2026-11-12 | 1 % 1/16 W. Out of stock: 10,000 past due, expected 09-Nov-2026; read through the fetch tool's summary of the page |
| R37 | 1 | 200k | YAGEO RC0402FR-07200KL | Digi-Key | [311-200KLRCT-ND](https://www.digikey.com/en/products/result?keywords=RC0402FR-07200KL) | $0.10 | 1,147,977 | 2026-11-12 | 1 % 1/16 W; read through the fetch tool's summary of the page |
| R39-R43 | 5 | 2.2k | YAGEO RC0402FR-072K2L | Digi-Key | [311-2.20KLRCT-ND](https://www.digikey.com/en/products/result?keywords=RC0402FR-072K2L) | $0.10 | 6,075 | 2026-11-11 | 1 % 1/16 W; read through the fetch tool's summary of the page |
| R45 | 1 | 0.33 | Panasonic ERJ-2BQFR33X | Digi-Key | [P.33AKCT-ND](https://www.digikey.com/en/products/result?keywords=ERJ-2BQFR33X) | $0.35 | 225,526 | 2026-11-12 | 1 % 1/6 W thick film, the VBUS damper's resistor; YAGEO RL0402FR-070R33L was out of stock; read through the fetch tool's summary of the page |
| SW1 | 1 | PWR | C&K KMR221GLFS | Digi-Key | [108-KMR221GLFSCT-ND](https://www.digikey.com/en/products/result?keywords=KMR221GLFS) | $0.67 | 106,572 | 2026-11-11 | C&K KMR2, 4.6 x 2.8 mm; read through the fetch tool's summary of the page |
| SW2 | 1 | BOOT | C&K KMR221GLFS | Digi-Key | [108-KMR221GLFSCT-ND](https://www.digikey.com/en/products/result?keywords=KMR221GLFS) | $0.67 | 106,572 | 2026-11-11 | C&K KMR2, 4.6 x 2.8 mm; read through the fetch tool's summary of the page |
| SW3 | 1 | RUN | C&K KMR221GLFS | Digi-Key | [108-KMR221GLFSCT-ND](https://www.digikey.com/en/products/result?keywords=KMR221GLFS) | $0.67 | 106,572 | 2026-11-11 | C&K KMR2, 4.6 x 2.8 mm; read through the fetch tool's summary of the page |
| SW4 | 1 | RST | C&K KMR221GLFS | Digi-Key | [108-KMR221GLFSCT-ND](https://www.digikey.com/en/products/result?keywords=KMR221GLFS) | $0.67 | 106,572 | 2026-11-12 | C&K KMR2, 4.6 x 2.8 mm; read through the fetch tool's summary of the page |
| SW5 | 1 | REC | C&K KMR221GLFS | Digi-Key | [108-KMR221GLFSCT-ND](https://www.digikey.com/en/products/result?keywords=KMR221GLFS) | $0.67 | 106,572 | 2026-11-12 | C&K KMR2, 4.6 x 2.8 mm; read through the fetch tool's summary of the page |
| U1 | 1 | VOSM6490 | Vantron VOSM6490 | Vantron |  | not priced |  | 2026-11-12 | Not priced: Vantron sells it by quote; Digi-Key's search returned no results. Its datasheet (V1.5, Ordering Information) lists VOSM6490 as the one module configuration: 8 GB LPDDR5, 64 GB eMMC, no wireless |
| U2 | 1 | HD3SS3220 | Texas Instruments HD3SS3220RNHR | Digi-Key | [296-48293-1-ND](https://www.digikey.com/en/products/result?keywords=HD3SS3220RNHR) | $4.17 | 1,254 | 2026-11-12 | USB Type-C DRP port controller with a SuperSpeed 2:1 mux; read through the fetch tool's summary of the page |
| U3 | 1 | TPS552892 | Texas Instruments TPS552892RYQR | Digi-Key | [296-TPS552892RYQRCT-ND](https://www.digikey.com/en/products/result?keywords=TPS552892RYQR) | $8.18 | 0 | 2026-11-12 | Buck-boost, 3 to 36 V in, 8 A. Out of stock: 2,442 expected 30-Nov-2026 and 558 on 13-Jan-2027; read through the fetch tool's summary of the page |
| U4 | 1 | AP2112K-3.3 | Diodes AP2112K-3.3TRG1 | Digi-Key | [AP2112K-3.3TRG1DICT-ND](https://www.digikey.com/en/products/result?keywords=AP2112K-3.3TRG1) | $0.28 | 406,515 | 2026-11-11 | SOT-25, the same 5 pins; read through the fetch tool's summary of the page |
| U5 | 1 | RP2350A | Raspberry Pi RP2350A |  |  | not priced |  | 2026-11-11 | Not priced: Digi-Key's search returned no listing under this name; Raspberry Pi sells it through its approved resellers |
| U6 | 1 | W25Q128JV | Winbond W25Q128JVPIQ | Digi-Key | [256-W25Q128JVPIQ-TUBE-ND](https://www.digikey.com/en/products/detail/winbond-electronics/W25Q128JVPIQ/6819668) | $6.27 | 27,700 | 2026-11-11 | Tube; read through the fetch tool's summary of the page |
| U7,U8 | 2 | 74LVC1G07 | Texas Instruments SN74LVC1G07DCKR | Digi-Key | [296-8486-1-ND](https://www.digikey.com/en/products/detail/texas-instruments/SN74LVC1G07DCKR/377457) | $0.10 | 0 | 2026-11-11 | Out of stock: 3,000 expected 25-Jan-2027; read through the fetch tool's summary of the page |
| U9 | 1 | USBLC6-2SC6 | STMicroelectronics USBLC6-2SC6 | Digi-Key | [497-5235-1-ND](https://www.digikey.com/en/products/detail/stmicroelectronics/USBLC6-2SC6/1040559) | $0.54 | 27,230 | 2026-11-11 | USB 2 ESD; read through the fetch tool's summary of the page |
| Y1 | 1 | 12MHz ABM8-272-T3 | Abracon ABM8-272-T3 | Digi-Key | [535-ABM8-272-T3CT-ND](https://www.digikey.com/en/products/result?keywords=ABM8-272-T3) | $0.69 | 23,471 | 2026-11-11 | The crystal Raspberry Pi tuned the RP2350's oscillator to; read through the fetch tool's summary of the page |

## Off the board, per unit

| Refs | Qty | Value | Part | Supplier | Supplier number | Unit at 1 | Stock | Checked | Note |
|---|---|---|---|---|---|---|---|---|---|
|  | 1 | PCB 76.2 x 53.34 mm, 6 layers, 1.6 mm | Sierra Circuits bare board to this version's gerbers |  |  | not priced |  | 2026-11-12 | Not priced: Sierra's Web PCB quotes by order; the board is made to its limits (rules/sierra-circuits-web.kicad_dru), with the vias under the module tented |
|  | 1 | Heatsink for the module, 40 x 40 mm, with thermal tape | no part chosen |  |  | not priced |  | 2026-11-12 | Not chosen: the VOSM6490 is rated 5 V / 3 A and its maker gives no thermal figures; a stick-on heatsink on its shield is the bench answer (README, Open items) |

## Cost

| Units | Digi-Key | Total | Per unit |
|---|---|---|---|
| 1 | $34.18 | $34.18 | $34.18 |
| 10 | $260.05 | $260.05 | $26.01 |

Each line orders the cheapest quantity that covers the need: at least the first price break, in whole packs, and more where a higher break costs less in all.

## Not priced

- C23: GRM188R61A475KE15D, at Digi-Key
- C43,C44,C49: GRM155R61A105KE15D, at Digi-Key
- L1: XAL6030-222MEC, at Coilcraft
- U1: VOSM6490, at Vantron
- U5: RP2350A, no supplier
- PCB 76.2 x 53.34 mm, 6 layers, 1.6 mm: bare board to this version's gerbers, no supplier
- Heatsink for the module, 40 x 40 mm, with thermal tape: no part chosen, no supplier

## Short of stock

- C9-C11,C40: 0 in stock at Digi-Key, 40 needed for 10
- C12-C19,C22,C24,C32,C37-C39,C45-C48: 0 in stock at Digi-Key, 180 needed for 10
- C30,C31: 0 in stock at Digi-Key, 20 needed for 10
- C33-C36,C42,C50,C51: 0 in stock at Digi-Key, 70 needed for 10
- R36: 0 in stock at Digi-Key, 10 needed for 10
- U3: 0 in stock at Digi-Key, 10 needed for 10
- U7,U8: 0 in stock at Digi-Key, 20 needed for 10
