ThyFriendlyFox/via/examples/snapdragon-dev-board/parts/catalog.csv

Value | Footprint | Qty | Manufacturer | MPN | Supplier | SKU | Pack | Breaks | Stock | Checked | URL | Note
0 | Resistor_SMD:R_0402_1005Metric |  | YAGEO | RC0402JR-070RL | Digi-Key | 311-0.0JRCT-ND |  | 1:0.10 10:0.01 25:0.0076 50:0.0066 100:0.0057 250:0.0048 500:0.00422 1000:0.00372 5000:0.00283 | 0 | 2026-11-11 | https://www.digikey.com/en/products/result?keywords=RC0402JR-070RL | Jumper. Out of stock: 10,000 were due 09-Nov-2026; read through the fetch tool's summary of the page
0.33 | Resistor_SMD:R_0402_1005Metric |  | Panasonic | ERJ-2BQFR33X | Digi-Key | P.33AKCT-ND |  | 1:0.35 10:0.193 25:0.1576 50:0.1374 100:0.1214 250:0.10516 500:0.09582 1000:0.08839 5000:0.07649 | 225526 | 2026-11-12 | https://www.digikey.com/en/products/result?keywords=ERJ-2BQFR33X | 1 % 1/6 W thick film, the VBUS damper's resistor; YAGEO RL0402FR-070R33L was out of stock; read through the fetch tool's summary of the page
100k | Resistor_SMD:R_0402_1005Metric |  | YAGEO | RC0402FR-07100KL | Digi-Key | 311-100KLRCT-ND |  | 1:0.10 10:0.023 25:0.0168 50:0.0134 100:0.0108 250:0.00828 500:0.00688 1000:0.00577 5000:0.00405 | 4532396 | 2026-11-11 | https://www.digikey.com/en/products/result?keywords=RC0402FR-07100KL | 1 % 1/16 W; read through the fetch tool's summary of the page
100k NCP15WF104 | Resistor_SMD:R_0402_1005Metric |  | Murata | NCP15WF104F03RC | Digi-Key | 490-4803-1-ND |  | 1:0.12 5:0.104 10:0.097 25:0.0892 50:0.0842 100:0.0795 500:0.07014 1000:0.06666 5000:0.0597 | 647846 | 2026-11-11 | https://www.digikey.com/en/products/result?keywords=NCP15WF104F03RC | 100k NTC, B 4250 K. Not for new designs: Murata's NCU15WF104F60RC is the listed successor; read through the fetch tool's summary of the page
100n | Capacitor_SMD:C_0402_1005Metric |  | Murata | GRM155R71C104KA88D | Digi-Key | 490-3261-1-ND |  | 1:0.10 10:0.025 50:0.0164 100:0.0139 500:0.0097 | 0 | 2026-11-11 | https://www.digikey.com/en/products/result?keywords=GRM155R71C104KA88D | 16 V X7R. Out of stock: 10,000 expected 16-Dec-2026; read through the fetch tool's summary of the page
104031-0811 | Connector_Card:microSD_HC_Molex_104031-0811 |  | Molex | 1040310811 | Digi-Key | WM6357CT-ND |  | 1:2.21 10:1.878 25:1.76 50:1.6758 100:1.5957 250:1.49572 500:1.4243 1000:1.35632 | 29741 | 2026-11-11 | https://www.digikey.com/en/products/result?keywords=1040310811 | Push-pull, 1.42 mm, card detect; read through the fetch tool's summary of the page
10k | Resistor_SMD:R_0402_1005Metric |  | YAGEO | RC0402FR-0710KL | Digi-Key | 311-10.0KLRCT-ND |  | 1:0.10 10:0.023 25:0.0168 50:0.0134 100:0.0108 250:0.00828 500:0.00688 1000:0.00577 5000:0.00405 | 6509272 | 2026-11-11 | https://www.digikey.com/en/products/result?keywords=RC0402FR-0710KL | 1 % 1/16 W; read through the fetch tool's summary of the page
10n | Capacitor_SMD:C_0402_1005Metric |  | Murata | GRM155R71H103KA88D | Digi-Key | 490-4516-1-ND |  | 1:0.10 10:0.022 50:0.0146 100:0.0124 500:0.00862 | 3397145 | 2026-11-12 | https://www.digikey.com/en/products/result?keywords=GRM155R71H103KA88D | 50 V X7R, the buck-boost's compensation; read through the fetch tool's summary of the page
10u | Capacitor_SMD:C_0805_2012Metric |  | Murata | GRM21BR61C106KE15L | Digi-Key | 490-3886-1-ND |  | 1:0.12 10:0.069 50:0.048 100:0.0414 500:0.03062 | 0 | 2026-11-11 | https://www.digikey.com/en/products/result?keywords=GRM21BR61C106KE15L | 16 V X5R on the USB-C 5 V input. Out of stock: 3,000 expected 19-Feb-2027; read through the fetch tool's summary of the page
12401610E4#2A | Wyvern:USB_C_Receptacle_Amphenol_12401610E4-2A_Ring6mil |  | Amphenol ICC | 12401610E4#2A | Digi-Key | 12401610E4#2ACT-ND |  | 1:1.43 10:1.217 25:1.1408 50:1.0862 100:1.0343 250:0.96952 500:0.92322 | 79753 | 2026-11-11 | https://www.digikey.com/en/products/result?keywords=12401610E4%232A | USB 3.1 Gen 2 Type-C receptacle, top mount dual SMT; read through the fetch tool's summary of the page
12MHz ABM8-272-T3 | Crystal:Crystal_SMD_3225-4Pin_3.2x2.5mm |  | Abracon | ABM8-272-T3 | Digi-Key | 535-ABM8-272-T3CT-ND |  | 1:0.69 10:0.601 25:0.5684 50:0.5448 100:0.5223 250:0.49396 500:0.47352 1000:0.45393 | 23471 | 2026-11-11 | https://www.digikey.com/en/products/result?keywords=ABM8-272-T3 | The crystal Raspberry Pi tuned the RP2350's oscillator to; read through the fetch tool's summary of the page
15p | Capacitor_SMD:C_0402_1005Metric |  | Murata | GRM1555C1H150JA01D | Digi-Key | 490-5888-1-ND |  | 1:0.10 10:0.023 50:0.0152 100:0.0129 500:0.00898 | 405009 | 2026-11-11 | https://www.digikey.com/en/products/result?keywords=GRM1555C1H150JA01D | 50 V C0G, the crystal's load; read through the fetch tool's summary of the page
1k | Resistor_SMD:R_0402_1005Metric |  | YAGEO | RC0402FR-071KL | Digi-Key | 311-1.00KLRCT-ND |  | 1:0.10 10:0.023 25:0.0168 50:0.0134 100:0.0108 250:0.00828 500:0.00688 1000:0.00577 5000:0.00405 | 2715933 | 2026-11-11 | https://www.digikey.com/en/products/result?keywords=RC0402FR-071KL | 1 % 1/16 W; read through the fetch tool's summary of the page
1u | Capacitor_SMD:C_0402_1005Metric |  | Murata | GRM155R61A105KE15D | Digi-Key | 490-3890-2-ND |  |  | 0 | 2026-11-11 | https://www.digikey.com/en/products/result?keywords=GRM155R61A105KE15D | Not priced: obsolete on Digi-Key, reel only. The page names YAGEO CC0402KRX5R6BB105 and KEMET C0402C105K8PACTU in its place; their voltage and dielectric are not yet read from their datasheets
1x24 header | Connector_PinHeader_2.54mm:PinHeader_1x24_P2.54mm_Vertical |  | Sullins | PRPC024SAAN-RC | Digi-Key | 35-PRPC024SAAN-RC-ND |  | 1:0.45 10:0.384 100:0.3261 500:0.29102 1000:0.27712 5000:0.24736 | 887 | 2026-11-11 | https://www.digikey.com/en/products/result?keywords=PRPC024SAAN-RC | 1 x 24, 0.1 in, soldered underneath, pins down; read through the fetch tool's summary of the page
1x30 header | Connector_PinHeader_2.54mm:PinHeader_1x30_P2.54mm_Vertical |  | Sullins | PRPC030SAAN-RC | Digi-Key | 35-PRPC030SAAN-RC-ND |  | 1:0.55 10:0.469 100:0.3985 500:0.35562 1000:0.33864 5000:0.30227 10000:0.28785 | 2413 | 2026-11-12 | https://www.digikey.com/en/products/result?keywords=PRPC030SAAN-RC | 1 x 30, 0.1 in, soldered underneath, pins down; read through the fetch tool's summary of the page
2.2k | Resistor_SMD:R_0402_1005Metric |  | YAGEO | RC0402FR-072K2L | Digi-Key | 311-2.20KLRCT-ND |  | 1:0.10 10:0.023 25:0.0168 50:0.0134 100:0.0108 250:0.00828 500:0.00688 1000:0.00577 5000:0.00405 | 6075 | 2026-11-11 | https://www.digikey.com/en/products/result?keywords=RC0402FR-072K2L | 1 % 1/16 W; read through the fetch tool's summary of the page
2.2u XAL4020-222 | Inductor_SMD:L_Coilcraft_XAL4020-XXX |  | Coilcraft | XAL4020-222MEB | Coilcraft |  |  |  |  | 2026-11-11 | https://www.coilcraft.com/en-us/products/power/shielded-inductors/molded-inductor/xal/xal4020/ | Not priced: Digi-Key had no exact match and Coilcraft's page refused the fetch (HTTP 403); Coilcraft sells direct
2.2u XAL6030-222 | Inductor_SMD:L_Coilcraft_XAL6030-XXX |  | Coilcraft | XAL6030-222MEC | Coilcraft |  |  |  |  | 2026-11-12 | https://www.coilcraft.com/en-us/products/power/shielded-inductors/molded-inductor/xal/xal6030/ | Not priced: Digi-Key returned no results for XAL6030-222MEC (its XAL6030 search lists only XAL6030-102MEC); Coilcraft's page refused the fetch (HTTP 403) and Mouser's search returned HTTP 503. 2.2 uH, Isat 15.9 A (Coilcraft Document 887)
200k | Resistor_SMD:R_0402_1005Metric |  | YAGEO | RC0402FR-07200KL | Digi-Key | 311-200KLRCT-ND |  | 1:0.10 10:0.023 25:0.0168 50:0.0134 100:0.0108 250:0.00828 500:0.00688 1000:0.00577 5000:0.00405 | 1147977 | 2026-11-12 | https://www.digikey.com/en/products/result?keywords=RC0402FR-07200KL | 1 % 1/16 W; read through the fetch tool's summary of the page
22u | Capacitor_SMD:C_0805_2012Metric |  | Murata | GRM21BR61A226ME51L | Digi-Key | 490-10511-1-ND |  | 1:0.20 10:0.113 50:0.0802 100:0.07 500:0.05298 | 0 | 2026-11-11 | https://www.digikey.com/en/products/result?keywords=GRM21BR61A226ME51L | 10 V X5R, bulk on rails of 5 V and under (v0.1's 3.8 V, v0.2's 5 V and VBUS). Out of stock, no date given; read through the fetch tool's summary of the page
26.1k | Resistor_SMD:R_0402_1005Metric |  | YAGEO | RC0402FR-0726K1L | Digi-Key | 311-26.1KLRCT-ND |  | 1:0.10 10:0.023 25:0.0168 50:0.0134 100:0.0108 250:0.00828 500:0.00688 1000:0.00577 5000:0.00405 | 121475 | 2026-11-12 | https://www.digikey.com/en/products/result?keywords=RC0402FR-0726K1L | 1 % 1/16 W; read through the fetch tool's summary of the page
27 | Resistor_SMD:R_0402_1005Metric |  | YAGEO | RC0402FR-0727RL | Digi-Key | YAG3086CT-ND |  | 1:0.10 10:0.023 25:0.0168 50:0.0134 100:0.0108 250:0.00828 500:0.00688 1000:0.00577 5000:0.00405 | 459607 | 2026-11-11 | https://www.digikey.com/en/products/result?keywords=RC0402FR-0727RL | 1 % 1/16 W; read through the fetch tool's summary of the page
3.3n | Capacitor_SMD:C_0402_1005Metric |  | Murata | GRM155R71H332KA01D | Digi-Key | 490-3248-1-ND |  | 1:0.10 10:0.02 50:0.0134 100:0.0113 500:0.00786 | 100727 | 2026-11-11 | https://www.digikey.com/en/products/result?keywords=GRM155R71H332KA01D | 50 V X7R, the buck's soft start; read through the fetch tool's summary of the page
3.3u AOTA-B201610S3R3 | Inductor_SMD:L_Abracon_AOTA-B201610S |  | Abracon | AOTA-B201610S3R3-101-T | Digi-Key | 535-AOTA-B201610S3R3-101-TCT-ND |  | 1:0.21 10:0.173 100:0.142 1000:0.11674 | 3426 | 2026-11-11 | https://www.digikey.com/en/products/result?keywords=AOTA-B201610S3R3-101-T | The polarised 0806 inductor Raspberry Pi's RP2350 design asks for; read through the fetch tool's summary of the page
31.6k | Resistor_SMD:R_0402_1005Metric |  | YAGEO | RC0402FR-0731K6L | Digi-Key | YAG3115CT-ND |  | 1:0.10 10:0.023 25:0.0168 50:0.0134 100:0.0108 250:0.00828 500:0.00688 1000:0.00577 5000:0.00405 | 1202391 | 2026-11-12 | https://www.digikey.com/en/products/result?keywords=RC0402FR-0731K6L | 1 % 1/16 W; read through the fetch tool's summary of the page
33 | Resistor_SMD:R_0402_1005Metric |  | YAGEO | RC0402FR-0733RL | Digi-Key | 311-33.0LRCT-ND |  | 1:0.10 10:0.023 25:0.0168 50:0.0134 100:0.0108 250:0.00828 500:0.00688 1000:0.00577 5000:0.00405 | 568273 | 2026-11-11 | https://www.digikey.com/en/products/detail/yageo/RC0402FR-0733RL/726593 | 1 % 1/16 W; read through the fetch tool's summary of the page
374k | Resistor_SMD:R_0402_1005Metric |  | YAGEO | RC0402FR-07374KL | Digi-Key | YAG3136CT-ND |  | 1:0.10 10:0.023 25:0.0168 50:0.0134 100:0.0108 250:0.00828 500:0.00688 1000:0.00577 5000:0.00405 | 26956 | 2026-11-11 | https://www.digikey.com/en/products/result?keywords=RC0402FR-07374KL | 1 % 1/16 W; read through the fetch tool's summary of the page
4.7k | Resistor_SMD:R_0402_1005Metric |  | YAGEO | RC0402FR-074K7L | Digi-Key | 311-4.7KLRCT-ND |  | 1:0.10 10:0.023 25:0.0168 50:0.0134 100:0.0108 250:0.00828 500:0.00688 1000:0.00577 5000:0.00405 | 6665 | 2026-11-12 | https://www.digikey.com/en/products/result?keywords=RC0402FR-074K7L | 1 % 1/16 W; read through the fetch tool's summary of the page
4.7u | Capacitor_SMD:C_0402_1005Metric |  | Murata | GRM155R61A475MEAAD | Digi-Key | 490-14306-1-ND |  | 1:0.12 10:0.066 50:0.0456 100:0.0394 500:0.02904 | 0 | 2026-11-11 | https://www.digikey.com/en/products/detail/murata-electronics/GRM155R61A475MEAAD/6234735 | 10 V X5R 0402, the size Raspberry Pi's RP2350 design uses. Out of stock: 10,000 expected 16-Mar-2027; read through the fetch tool's summary of the page
4.7u | Capacitor_SMD:C_0603_1608Metric |  | Murata | GRM188R61A475KE15D | Digi-Key | 490-10477-2-ND |  |  | 0 | 2026-11-11 | https://www.digikey.com/en/products/result?keywords=GRM188R61A475KE15D | Not priced: obsolete on Digi-Key, reel only; no 0603 4.7 uF 10 V X5R in its place read yet
47k | Resistor_SMD:R_0402_1005Metric |  | YAGEO | RC0402FR-0747KL | Digi-Key | 311-47.0KLRCT-ND |  | 1:0.10 10:0.023 25:0.0168 50:0.0134 100:0.0108 250:0.00828 500:0.00688 1000:0.00577 5000:0.00405 | 440041 | 2026-11-11 | https://www.digikey.com/en/products/result?keywords=RC0402FR-0747KL | 1 % 1/16 W; read through the fetch tool's summary of the page
51k | Resistor_SMD:R_0402_1005Metric |  | YAGEO | RC0402FR-0751KL | Digi-Key | 311-51.0KLRCT-ND |  | 1:0.10 10:0.023 25:0.0168 50:0.0134 100:0.0108 250:0.00828 500:0.00688 1000:0.00577 5000:0.00405 | 338264 | 2026-11-12 | https://www.digikey.com/en/products/result?keywords=RC0402FR-0751KL | 1 % 1/16 W; read through the fetch tool's summary of the page
74LVC1G07 | Package_TO_SOT_SMD:SOT-353_SC-70-5 |  | Texas Instruments | SN74LVC1G07DCKR | Digi-Key | 296-8486-1-ND |  | 1:0.1 10:0.069 25:0.0604 100:0.0509 250:0.04628 500:0.04348 1000:0.04119 | 0 | 2026-11-11 | https://www.digikey.com/en/products/detail/texas-instruments/SN74LVC1G07DCKR/377457 | Out of stock: 3,000 expected 25-Jan-2027; read through the fetch tool's summary of the page
910k | Resistor_SMD:R_0402_1005Metric |  | YAGEO | RC0402FR-07910KL | Digi-Key | YAG3257CT-ND |  | 1:0.10 10:0.023 25:0.0168 50:0.0134 100:0.0108 250:0.00828 500:0.00688 1000:0.00577 5000:0.00405 | 0 | 2026-11-12 | https://www.digikey.com/en/products/result?keywords=RC0402FR-07910KL | 1 % 1/16 W. Out of stock: 10,000 past due, expected 09-Nov-2026; read through the fetch tool's summary of the page
AP2112K-3.3 | Package_TO_SOT_SMD:SOT-23-5 |  | Diodes | AP2112K-3.3TRG1 | Digi-Key | AP2112K-3.3TRG1DICT-ND |  | 1:0.28 10:0.191 25:0.1692 50:0.1558 100:0.1447 | 406515 | 2026-11-11 | https://www.digikey.com/en/products/result?keywords=AP2112K-3.3TRG1 | SOT-25, the same 5 pins; read through the fetch tool's summary of the page
BOOT | Button_Switch_SMD:SW_Push_1P1T_NO_CK_KMR2 |  | C&K | KMR221GLFS | Digi-Key | 108-KMR221GLFSCT-ND |  | 1:0.67 10:0.576 25:0.5368 100:0.4792 250:0.44384 500:0.41906 1000:0.39622 2500:0.36914 | 106572 | 2026-11-11 | https://www.digikey.com/en/products/result?keywords=KMR221GLFS | C&K KMR2, 4.6 x 2.8 mm; read through the fetch tool's summary of the page
DF40HC(3.0)-100DS-0.4V | Wyvern:Hirose_DF40HC(3.0)-100DS-0.4V_2x50_P0.4mm_SOM |  | Hirose | DF40HC(3.0)-100DS-0.4V(51) | Digi-Key | 26-DF40HC(3.0)-100DS-0.4V(51)CT-ND |  | 1:3.51 10:2.982 25:2.7944 50:2.661 100:2.5339 250:2.3752 500:2.26184 1000:2.2338 | 0 | 2026-11-11 | https://www.digikey.com/en/products/result?keywords=DF40HC%283.0%29-100DS-0.4V%2851%29 | The 3.0 mm stack with the SOM's DF40C-100DP-0.4V(51). Out of stock, no date (12 weeks' lead time); read through the fetch tool's summary of the page
EDL | Button_Switch_SMD:SW_Push_1P1T_NO_CK_KMR2 |  | C&K | KMR221GLFS | Digi-Key | 108-KMR221GLFSCT-ND |  | 1:0.67 10:0.576 25:0.5368 100:0.4792 250:0.44384 500:0.41906 1000:0.39622 2500:0.36914 | 106572 | 2026-11-11 | https://www.digikey.com/en/products/result?keywords=KMR221GLFS | C&K KMR2, 4.6 x 2.8 mm; read through the fetch tool's summary of the page
HD3SS3220 | Package_DFN_QFN:Texas_RNH0030A_WQFN-30-1EP_2.5x4.5mm_P0.4mm_EP1.2x3.2mm |  | Texas Instruments | HD3SS3220RNHR | Digi-Key | 296-48293-1-ND |  | 1:4.17 10:3.15 25:2.894 100:2.6128 250:2.47864 500:2.4619 1000:2.32254 | 1254 | 2026-11-12 | https://www.digikey.com/en/products/result?keywords=HD3SS3220RNHR | USB Type-C DRP port controller with a SuperSpeed 2:1 mux; read through the fetch tool's summary of the page
PWR | Button_Switch_SMD:SW_Push_1P1T_NO_CK_KMR2 |  | C&K | KMR221GLFS | Digi-Key | 108-KMR221GLFSCT-ND |  | 1:0.67 10:0.576 25:0.5368 100:0.4792 250:0.44384 500:0.41906 1000:0.39622 2500:0.36914 | 106572 | 2026-11-11 | https://www.digikey.com/en/products/result?keywords=KMR221GLFS | C&K KMR2, 4.6 x 2.8 mm; read through the fetch tool's summary of the page
REC | Button_Switch_SMD:SW_Push_1P1T_NO_CK_KMR2 |  | C&K | KMR221GLFS | Digi-Key | 108-KMR221GLFSCT-ND |  | 1:0.67 10:0.576 25:0.5368 100:0.4792 250:0.44384 500:0.41906 1000:0.39622 2500:0.36914 | 106572 | 2026-11-12 | https://www.digikey.com/en/products/result?keywords=KMR221GLFS | C&K KMR2, 4.6 x 2.8 mm; read through the fetch tool's summary of the page
RP2350A | Package_DFN_QFN:QFN-60-1EP_7x7mm_P0.4mm_EP3.4x3.4mm |  | Raspberry Pi | RP2350A |  |  |  |  |  | 2026-11-11 | https://www.digikey.com/en/products/result?keywords=RP2350A | Not priced: Digi-Key's search returned no listing under this name; Raspberry Pi sells it through its approved resellers
RST | Button_Switch_SMD:SW_Push_1P1T_NO_CK_KMR2 |  | C&K | KMR221GLFS | Digi-Key | 108-KMR221GLFSCT-ND |  | 1:0.67 10:0.576 25:0.5368 100:0.4792 250:0.44384 500:0.41906 1000:0.39622 2500:0.36914 | 106572 | 2026-11-12 | https://www.digikey.com/en/products/result?keywords=KMR221GLFS | C&K KMR2, 4.6 x 2.8 mm; read through the fetch tool's summary of the page
RUN | Button_Switch_SMD:SW_Push_1P1T_NO_CK_KMR2 |  | C&K | KMR221GLFS | Digi-Key | 108-KMR221GLFSCT-ND |  | 1:0.67 10:0.576 25:0.5368 100:0.4792 250:0.44384 500:0.41906 1000:0.39622 2500:0.36914 | 106572 | 2026-11-11 | https://www.digikey.com/en/products/result?keywords=KMR221GLFS | C&K KMR2, 4.6 x 2.8 mm; read through the fetch tool's summary of the page
SWCLK | TestPoint:TestPoint_Pad_D1.0mm |  |  |  | none |  |  |  |  | 2026-11-11 |  | Copper on the board: a 1 mm pad for the RP2350's SWD probe; nothing to buy
SWDIO | TestPoint:TestPoint_Pad_D1.0mm |  |  |  | none |  |  |  |  | 2026-11-11 |  | Copper on the board: a 1 mm pad for the RP2350's SWD probe; nothing to buy
TPS552892 | Wyvern:Texas_RYQ0021A_VQFN-HR-21_5x3mm_P0.5mm |  | Texas Instruments | TPS552892RYQR | Digi-Key | 296-TPS552892RYQRCT-ND |  | 1:8.18 10:6.331 25:5.8696 100:5.3619 250:5.23108 | 0 | 2026-11-12 | https://www.digikey.com/en/products/result?keywords=TPS552892RYQR | Buck-boost, 3 to 36 V in, 8 A. Out of stock: 2,442 expected 30-Nov-2026 and 558 on 13-Jan-2027; read through the fetch tool's summary of the page
TPS62130 | Package_DFN_QFN:VQFN-16-1EP_3x3mm_P0.5mm_EP1.68x1.68mm |  | Texas Instruments | TPS62130RGTR | Digi-Key | 296-37682-1-ND |  | 1:1.99 10:1.467 25:1.3356 100:1.1913 250:1.12252 500:1.08172 | 0 | 2026-11-11 | https://www.digikey.com/en/products/detail/texas-instruments/TPS62130RGTR/2833429 | Out of stock: 2,000 expected 04-Jan-2027; read through the fetch tool's summary of the page
USBLC6-2SC6 | Package_TO_SOT_SMD:SOT-23-6 |  | STMicroelectronics | USBLC6-2SC6 | Digi-Key | 497-5235-1-ND |  | 1:0.54 10:0.329 50:0.2384 100:0.2088 500:0.15662 | 27230 | 2026-11-11 | https://www.digikey.com/en/products/detail/stmicroelectronics/USBLC6-2SC6/1040559 | USB 2 ESD; read through the fetch tool's summary of the page
VOL- | Button_Switch_SMD:SW_Push_1P1T_NO_CK_KMR2 |  | C&K | KMR221GLFS | Digi-Key | 108-KMR221GLFSCT-ND |  | 1:0.67 10:0.576 25:0.5368 100:0.4792 250:0.44384 500:0.41906 1000:0.39622 2500:0.36914 | 106572 | 2026-11-11 | https://www.digikey.com/en/products/result?keywords=KMR221GLFS | C&K KMR2, 4.6 x 2.8 mm; read through the fetch tool's summary of the page
VOSM6490 | Wyvern:OSM_L_LGA-662_45x45mm_P1.25mm |  | Vantron | VOSM6490 | Vantron |  |  |  |  | 2026-11-12 | https://vantrontech.us/product/3339-VOSM6490QualcommQCS6490Module | Not priced: Vantron sells it by quote; Digi-Key's search returned no results. Its datasheet (V1.5, Ordering Information) lists VOSM6490 as the one module configuration: 8 GB LPDDR5, 64 GB eMMC, no wireless
W25Q128JV | Package_SON:WSON-8-1EP_6x5mm_P1.27mm_EP3.4x4.3mm |  | Winbond | W25Q128JVPIQ | Digi-Key | 256-W25Q128JVPIQ-TUBE-ND |  | 1:6.27 10:5.841 25:5.666 50:5.5334 100:5.401 300:5.193 500:5.09742 1000:4.96927 | 27700 | 2026-11-11 | https://www.digikey.com/en/products/detail/winbond-electronics/W25Q128JVPIQ/6819668 | Tube; read through the fetch tool's summary of the page
blue | LED_SMD:LED_0603_1608Metric |  | Lite-On | LTST-C191TBKT | Digi-Key | 160-1647-1-ND |  | 1:0.25 10:0.17 100:0.1193 500:0.09586 1000:0.08809 2000:0.08147 | 276683 | 2026-11-11 | https://www.digikey.com/en/products/detail/liteon/LTST-C191TBKT/388530 | Vf 3.3 V typical; read through the fetch tool's summary of the page
green | LED_SMD:LED_0603_1608Metric |  | Lite-On | LTST-C191KGKT | Digi-Key | 160-1446-1-ND |  | 1:0.15 10:0.104 100:0.0715 500:0.05666 1000:0.05171 2000:0.04747 | 2228010 | 2026-11-11 | https://www.digikey.com/en/products/detail/liteon/LTST-C191KGKT/386835 | The GP25 light; on v0.1 also the green of the PMI8998's RGB light; read through the fetch tool's summary of the page
red | LED_SMD:LED_0603_1608Metric |  | Lite-On | LTST-C191KRKT | Digi-Key | 160-1447-1-ND |  | 1:0.15 10:0.104 100:0.0715 500:0.05666 1000:0.05171 2000:0.04747 | 1334425 | 2026-11-11 | https://www.digikey.com/en/products/result?keywords=LTST-C191KRKT | v0.2's power light, 3.3 V through 1k; on v0.1, the red of the PMI8998's RGB light; read through the fetch tool's summary of the page
