ThyFriendlyFox/via/examples/snapdragon-dev-board/parts/offboard/v0.2.csv

Value | Footprint | Qty | Manufacturer | MPN | Supplier | SKU | Pack | Breaks | Stock | Checked | URL | Note
PCB 76.2 x 53.34 mm, 6 layers, 1.6 mm |  | 1 | Sierra Circuits | bare board to this version's gerbers |  |  |  |  |  | 2026-11-12 | https://www.protoexpress.com/ | Not priced: Sierra's Web PCB quotes by order; the board is made to its limits (rules/sierra-circuits-web.kicad_dru), with the vias under the module tented
Heatsink for the module, 40 x 40 mm, with thermal tape |  | 1 |  |  |  |  |  |  |  | 2026-11-12 |  | Not chosen: the VOSM6490 is rated 5 V / 3 A and its maker gives no thermal figures; a stick-on heatsink on its shield is the bench answer (README, Open items)
