ThyFriendlyFox/via/examples/fire-alarm-communicator/v0.1/models/pt15_3_bk.step

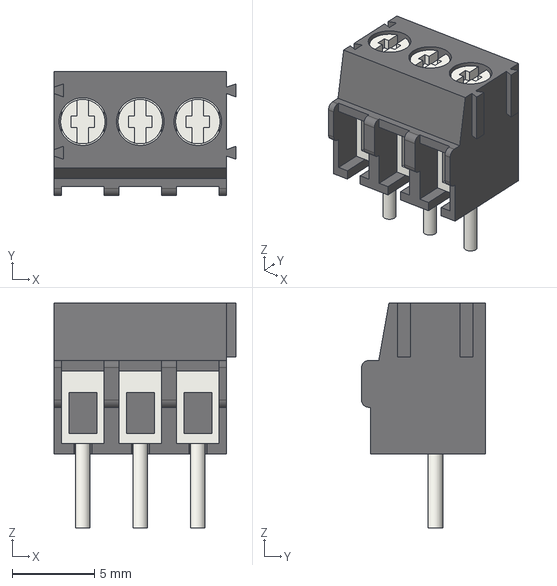
[picture p211: CAD file, 2026-11-14]
examples/fire-alarm-communicator/v0.1/models/pt15_3_bk.step
11.1 x 7.55 x 13.7 mm
