ThyFriendlyFox/via/examples/fire-alarm-communicator/v0.1/models/pt15_4_bk.step

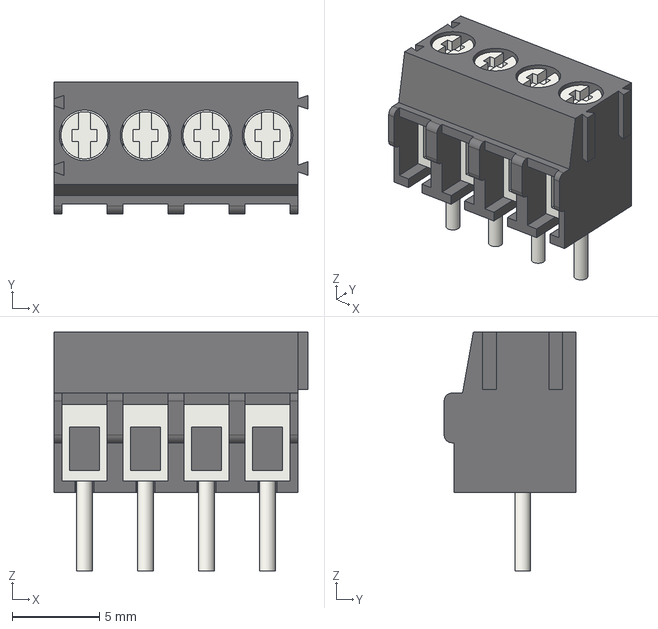
[picture p212: CAD file, 2026-11-14]
examples/fire-alarm-communicator/v0.1/models/pt15_4_bk.step
14.6 x 7.55 x 13.7 mm
