ThyFriendlyFox/via/examples/fire-alarm-communicator/v0.1/models/pt15_2_bk.step

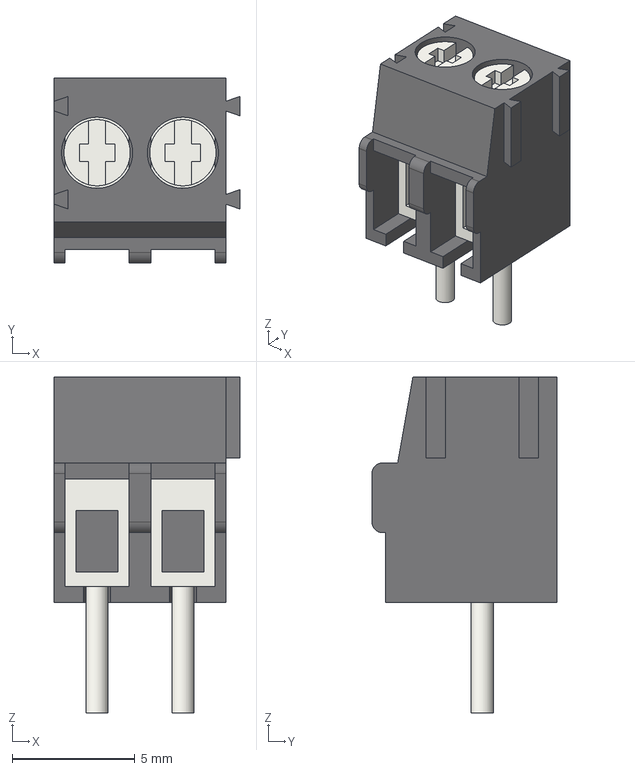
[picture p213: CAD file, 2026-11-14]
examples/fire-alarm-communicator/v0.1/models/pt15_2_bk.step
7.57 x 7.55 x 13.7 mm
