ThyFriendlyFox/via/examples/anc-speaker/v0.1/docs/assembly-back.png

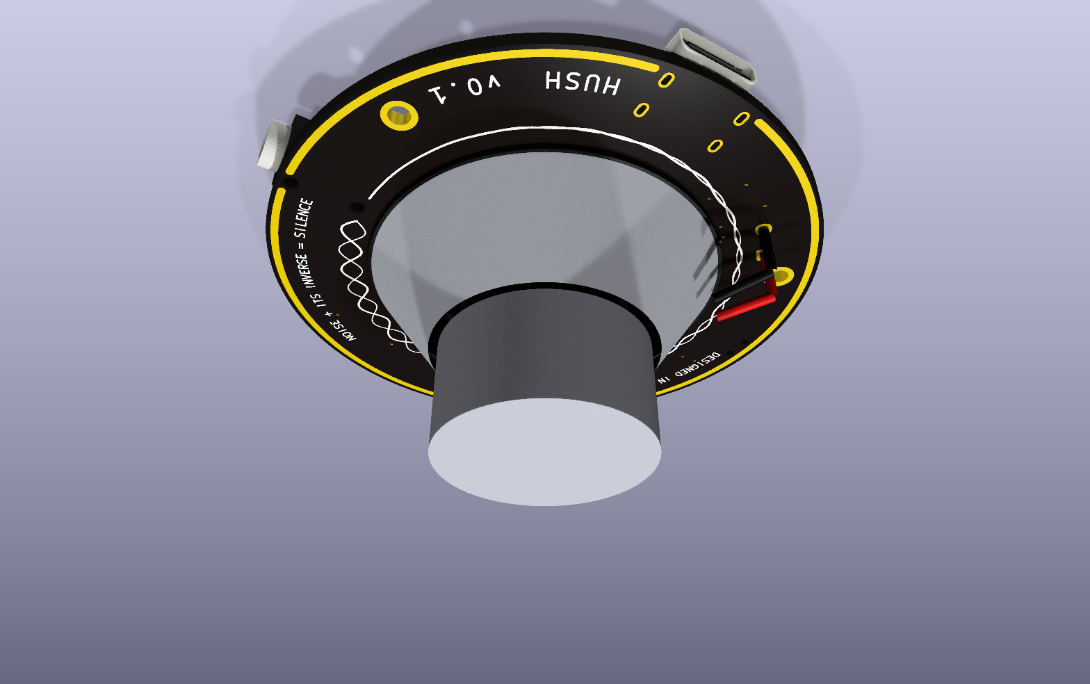
examples/anc-speaker/v0.1/docs/assembly-back.png
