ThyFriendlyFox/via/examples/anc-speaker/v0.1/docs/assembly-front.png

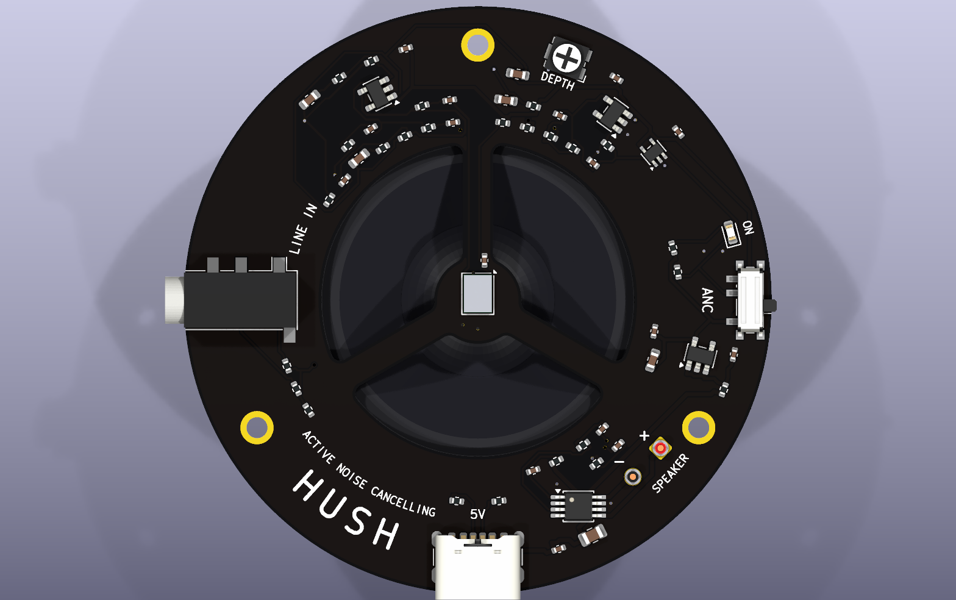
examples/anc-speaker/v0.1/docs/assembly-front.png
