ThyFriendlyFox/via/templates/verification/system/README.md

# The system

Block diagram

<!-- fill: draw block-diagram.svg from block-diagram.json (`workcenter diagram system/block-diagram.json --out system/block-diagram.svg --png`): every block, every power path with its net name, the switches, and where each current is measured. Then write one caption per mode below. -->

## Modes

Each caption says where the charge comes from, which path it takes,
which parts conduct, which parts are off, and what stops the mode.

### Charging

<!-- fill -->

### In use

<!-- fill -->

### Idle

<!-- fill -->

### Shutdown

<!-- fill -->

### Faults

<!-- fill: one caption per fault: what detects it, how fast, and which switch opens. -->

## Frequencies on the board

<!-- fill: a table of every periodic signal and switching edge: its frequency, its source, and why it is there. -->
