ThyFriendlyFox/via/templates/verification/calculations/README.md

# Calculations

Each calculation that no simulation covers: the inputs and their
sources, the equations with their sources, and the result against its
requirement.

<!-- fill: for example the power budget of each mode, the standby current and the shelf time, the charge time, each part's temperature rise, each conductor's current, and each capacitor's voltage against its rating. -->
