ThyFriendlyFox/via/ee-agent-kit/CHANGELOG.md

# Changelog

All notable changes to EE Workcenter are documented here.
Format: [Keep a Changelog](https://keepachangelog.com/) · Versioning: [SemVer](https://semver.org/).

## [Unreleased]
### Changed
- The Open Graph image shows Herald's board as the home page draws it, from its file, its copper over the board on the page's own paper, where it showed KiCad's 3D render in a frame on KiCad's lavender. `draw_face.py` writes the drawing into `og.html` too; `showcase/herald.png`, which only `og.html` showed, is gone.
- The website's Herald section labels 4 of its parts at all times, 2 to a side, where it labelled a group of up to 4, 1 every 3 s, and then cleared them: every 3 s the sides take turns, and a side's older label gives way to its next part, which takes its number. A side's labels stand in the order of their parts down the board, or the other way up where their leaders would cross; a label that stays slides to its place with its leader. Beside the board a label stands at most half the board's height and ends in an ellipsis where it is cut, at the owner's word: 40 of the 127 are cut at 1280 px, and a side's 2 always fit, so the board never moves. Each label's number orders it only where the labels stack under the board: beside it, the number had put label 1 on top whatever its part's place. The hero's paragraph and the design-as-code section's headline are the owner's words of 2026-11-14 ("Via is our dream for lowering the difficulty to getting to electronics design ...", "How a Python File Becomes a Board"), the only exceptions in `docs/STYLE.md` with the hero's headline.
- The website is redrawn, with the text-to-cad site as the owner's reference. Under the owner's headline, "Circuit Boards From AI", the home page opens with the wordmark built as a board is: sketched, its corners set, its copper laid, its traces run. Then the install line and a strip of the 21 agents Via works with, which drifts and which a mouse, a swipe or the arrow keys move. Below the strip: Herald's section as it was (its labelled parts, its hard parts, its 3D model, its gates run), then the 6 boards as cards in 3D, each linked to its own page. The 4 checks are 6 drawings in ink on dotted paper, each of a check catching a fault in a test circuit, with the numbers its run printed: an ERC fault from Rosetta's first wired sheet, a 0.05 mm clearance, a reference that leaves its window at 85 C, a harmonic on a filter's peak, a route, the fab's layers; then `workcenter next` and the 2 runs of the gates. The sections "Process", "Simulation" and "Works with any agent" leave the page; the strip and the drawings say what they said. The accent is a steel blue. The 404 page and the README's first picture carry the wordmark.
- Each of the 6 examples in `examples/` has its own page, written by `site/examples.py` from the example's files: the newest README's name, line and first paragraph, "What is hard about it" and "What is open" or "Open items"; every version's steps, from its `TIMELINE.md` (a new one for Rosetta v0.1) or the README's "What changed" sections; the checks of its last run or of `docs/gates.md`; and the board file. Each page has the board in 3D that a drag turns (KiCad's turning render, the backdrop taken out by `site/showcase/key.py`), its front and back, a board explorer drawn from its `.kicad_pcb` (every copper layer on and off, zoom and pan, a net followed through its tracks, vias and pads, a part named), its checks, its steps and what is open. Signet, 6 boards in folders of their own, gives each board's verdict and no explorer; its turning render cuts the ring off at the top and the bottom, so its page leads with the ring at an angle instead. Hush's ring shows the page through its 3 openings: `key.py` takes out the backdrop a board with openings encloses, with the shadow round it. Each picture is in 256 colours, at most twice as wide as a page shows it: a card is 23 to 78 KB, from up to 944 KB. `site/examples.html` lists them.
- `tests/test_docs.py` holds the new pages: their runs against fresh runs (8 runs in 3 documents), every link and picture of each page, the build's copy and checksum of each page's stylesheet and scripts, each example page against what `site/examples.py` writes, and each value a check's drawing marks against its test circuit's files or a run on the page.
- `workcenter design --route` and `workcenter autoroute` start FreeRouting with `-dct 0`. Release 1.9.0 waited 20 s before each route for a click on a dialog that asks to confirm the start, on a headless display too. The same session file comes out: a board of 4 parts routes in 6 s where it took 25 s, and each test that routes loses the wait. The landmine map said that 1.9.0 has no network code; its log shows a version check that fails, and the row says so now.
- `workcenter doctor`: the first line names what is absent (`workcenter ee: degraded, without freerouting`), and an absent Claude Code hook no longer makes it `degraded`. After a clean `sudo ./install.sh` the line read `degraded` for 2 hooks that the install does not write. Each hook keeps its line.
- The README's front page after a review by a reader who had not written it (32 findings, M160): what `--help` prints, the row "Decks" (nothing holds a deck typed by hand to the schematic's parts yet), the first board in a folder outside the checkout, what `autoroute` writes, when the image is published, the part bodies that the 3D views need, 4 rows more in the repository map, the kit's terms. `hero.png`, `hero-dark.png` and the 2 pictures of the diagram are drawn again, the diagram from the site's new words. `site/media/README.md` fetches the 3 part bodies at 1 commit of KiCad's library, each held to its SHA256, into a folder of `mktemp`. STATUS.md: 2 stale pointers to roadmap items, its stale counts of tests, and the range of the mistake log.
- `tests/test_docs.py` gains 3 tests and holds more: the README's quick start runs line by line as written, in a copy, and ends as its comments say; each count of tests that STATUS.md states is what pytest collects, and its ranges of mistakes and processes are the logs'; each pointer to a roadmap item carries the item's number and its title. A link with a `#` part is held to its file. `tests/test_designfile.py` holds the fixture's 2 bounds and the 4 numbers of its row to the corner runs.
- P5 gains 2 steps (M160): a sentence about what a command prints is checked against that command's output, and a pointer to a roadmap item gives its title. P8 gains 2 (M159, M161): commands that depend on each other are joined with `&&`, and a read-only repository is read with `git --no-optional-locks`. P9 gains 2 (M158, M161): the texts of an edit end on a visible character, and a script that holds shell text or a heredoc runs from a file. P7 gains 1 (M167): a number a gate prints about a file is counted in that file.
### Added
- The SIM gate fails a deck with more than 1 parameter on an `altermod` line and names the ones ngspice drops: ngspice 42 applies the first and says nothing of the rest, so a corner that switches a part to its maximum model moved 1 parameter of 5 in Last Hit's heater deck from v0.14 to v0.16 (M172). `workcenter next` points at the simulate skill's rule.
- Wyvern v0.2 (`examples/snapdragon-dev-board/v0.2`): one flat board, 76.2 x 53.34 mm, 6 layers, 2 rows of 30 pins. A Qualcomm QCS6490 on Vantron's VOSM6490 is soldered straight on by its 662 OSM Size-L pads, generated from SGET's contact map (`osm_l.py`) and equal pad for pad to Antmicro's open footprint; its symbol draws the 662 pins as 13 banks. A TPS552892 buck-boost holds the module's 5.0 V from any USB-C cable, an HD3SS3220 owns the plug's CC and switches the module's USB 3 lane to the plug's side, and the RP2350 block is v0.1's, turned a quarter turn. `workcenter gates v0.2` is GREEN with 16 warnings: DRC 0 errors, 0 unconnected, 0 parity; 7 decks, 397 corner runs, and a frequency plan with no overlap. The website's Wyvern card shows v0.2.
- `kicadgen` writes an A0 sheet (`sheet="A0"`): a processor of a thousand pins drawn as banks, with its memory and expansion slots, does not fit A1.
- `kicadgen` wires a symbol drawn as banks (2 or more body rectangles side by side, none touching another) round each bank on its own. The wiring blocked the banks' whole bounding box, and a pin that faced the next bank had no free cell beside its end, so the sheet stopped with "cell beside its end is taken". A symbol with any other drawing, a connector's pin rectangles inside its outline among them, keeps its one box.
- `Design.check_vias` holds each via to the pads, vias and tracks filed in its cell of a grid, each item filed within the farthest distance any rule asks of a via. It held every via to every item, and a processor socket's 3457 vias took 63 s; they take 0.3 s, with the same 27 problems in the same order when 9 vias were moved onto others.
- Another example project, `examples/threadripper-matx`: Basalt, a microATX motherboard for an AMD Threadripper on sTR5, kept as version folders and built in a loop logged in its `LOOP.md`. v0.1 places the 4844-land socket (a stand-in pin map; AMD's is under NDA), 4 DDR5 slots, 3 PCI Express x16 slots, 2 M.2 sockets and 14 phases, with every supply in a pour drawn by the design; v0.2 draws the 4 memory channels' 576 traces by rule; v0.3 adds 77 parts of ports and headers (SATA, 5 fan headers and an EMC2305, RGB and ARGB headers and an STM32G0B1 to drive them, the CMOS battery, front panel, USB and TPM headers, the BIOS flash) routed by the project's own 2-layer grid router. Each version `workcenter gates` GREEN with no warning.
- Another example project, `examples/anc-speaker/v0.1`: Hush, a speaker that cancels noise. A ring 62 mm across sits on the face of a 40 mm driver; a MEMS mic on its hub listens 4 mm in front of the cone, and an analog feedback loop (a balanced error amplifier, an integrator with a lead network, a class-D amplifier) plays the inverse wave. Music from a line input plays through the loop as its target. 4 layers, 62 parts, all on the front; the back is a whole ground pour with the noise and its inverse drawn round it, shrinking to one line, and gold rims round the windows over the cone. 7 decks hold the cancelling (3 dB at 50 Hz to 12 dB from 200 to 300 Hz at every corner, 18.8 dB on a 150 Hz hum), the loop's margins, the music's response, the rail against the amplifier's switching, and the 2 models written for it, over 986 corner runs. An assembly scene puts the ring on its driver.
- The website's words are rewritten for the person deciding whether to use Via: each headline is 1 plain sentence that says what the reader gets ("Four checks before any board is released"), with no slogans, under the owner's own hero headline, "Circuit Boards From AI" on 3 lines, and the text names each check by what it does. The fixture boards are gone from the page: the hero shows Herald, the design-as-code section shows Herald's supervised inputs as code, schematic and routed board, and the gallery holds the 6 example boards with a specification line each. The 2 runs on a test circuit that fails at 85 °C stay, captioned as a test circuit. The Open Graph image carries the headline and Herald; the 404 page carries the wordmark. `docs/STYLE.md` gains a section with the website's rules.
- The website's example is Herald, the fire alarm communicator, where Rosetta was. Its board is drawn from its design file and routed board (`site/showcase/draw_face.py`), the copper first: every track of the 3 signal layers in copper of its own depth, swept in a layer at a time, the parts as faint outlines. Every one of its 127 parts is labelled in turn, 1 label every 3 seconds while the board is on screen, a section of the design file at a time, with a leader from the part to its label in 2 runs, a diagonal and then a level line: the value, footprint and nets from the design file, the description and datasheet from KiCad's library with the datasheet's first page beside it where its maker serves the PDF to a script (`site/showcase/datasheets.py`), the problem it answers and the reason for it from the README, and each deck that varies it with what the deck measured at every corner of the gates' report. A click on a part shows its section's labels at once. Below it: 8 hard parts, Herald as a 3D model the reader turns, and the gates run on it. The model is KiCad's VRML export of the routed board as a 0.6 MB meshopt GLB (`site/showcase/make_glb.mjs`), shown with model-viewer 4.4.0 (Apache-2.0) vendored in `site/vendor/`; the page loads neither until the reader comes within 600 px of it, and KiCad's render of the top stands in until the model draws. Paragraphs are justified to their column. The footer says the site is built under the MIT License.
- The website's section of boards built with Via ("Boards, not demos.") has a card for Herald, Hush and Signet, beside Rosetta, Wyvern and Agentcast: 4 to a row on a wide screen. Each card is cropped from the example's own 3D render and links to its README. `site/README.md` gives the steps that put the next example on the page.
- A third example project, `examples/fire-alarm-communicator/v0.1`: Herald, a fire alarm communicator. An 84.4 x 64 mm 4-layer board, 127 parts, all on the front, red with a white legend, black terminals, and a back that tells an installer what to wire. It answers a fire panel's dialer as its phone line (a current-limited loop feed, off-hook sense, tones from a PWM pin, DTMF read by an ADC), reads 3 supervised inputs, holds a fail-safe trouble relay, and reports over a Quectel BG95-M1 (LTE-M) with an ESP32-S3's Wi-Fi as the second path. 8 decks hold the inputs, the hook, the DTMF path and the tones at every corner (573 runs); the first tone filter read 28 mV on the line and the deck found it. The firmware's Goertzel decoder takes and refuses what ITU-T Q.24 Table A-1 says, and a host test plays a whole Contact ID call through it. `design.py` lays the schematic out with each support part beside the pin it serves, and draws until the generator's wiring accepts the sheet.
- A second example project, `examples/ring-mouse`: Signet, a mouse worn as a ring, kept as version folders the way Last Hit keeps its prototypes (v0.1 to v0.4, each from a pass of a loop in `LOOP.md`). The ring is 6 small 4-layer boards on the faces of a hexagonal prism round the index finger, each soldered to the next by a row of 8 plated edge pads: an STM32WB5MMG for Bluetooth LE and a touch controller, a 3-channel scroll strip read as a 3-phase encoder, 2 click switches, an LSM6DSL for an air mouse, a charger, a 3.3 V rail, a cell gauge with its deck (52 corner runs) and a 20 mAh pouch cell. Each tile is its own KiCad project from its own `design.py`, GREEN; `ring.py` holds the ring's geometry and checks that every 2 neighbours share their inner corner; an assembly on `tools/scene.py` draws the ring with its solder and its cell; the firmware's scroll decoder and air mouse are C with host tests.
- Rosetta v0.2 (`examples/universal-controller/v0.2`): the example controller laid out like an Xbox 360 pad's main board, 148 x 82 mm, 6 layers, 135 parts, GREEN. The thumbsticks solder on: a project footprint for the ALPS RKJXV122400R written from its catalog's mounting-hole drawing (`footprints/make_footprints.py`), which Hall-effect drop-in sticks share, with the drawing's prohibited wiring area as keep-outs. Linear Hall sensors on the shoulder horns read the triggers, right-angle bumpers stand on the horns' edge, 2 rumble motors plug in at the grips, and both USB-C ports open through a tab at the bottom. The site shows v0.2; v0.1 stays as the archived first version.
- An example project, `examples/universal-controller/v0.1`: Rosetta, a game controller with a 5-position knob that picks a PS4, a PS5, an Xbox, a Switch or Bluetooth. A routed 4-layer board in a controller's outline (160 x 92 mm, 140 parts): an RP2040, an ESP32 for Bluetooth Classic and BLE with its antenna over the notch between the grips, a USB host port that relays a console's signature to a licensed donor, Hall-effect sticks and triggers on a 12-bit ADC, trigger motors, 2 haptic drivers, an IMU, a ring of RGB LEDs round the knob. 6 decks hold each knob position inside its window at every corner (370 runs), with the ADC's worst input leakage; the knob's decoder is C with host tests. The outline is a filleted polygon (`ControllerDesign`) whose inset is exact, so the router's boundary, the pours and the DRC agree.
- The website shows the example: a drawing of the routed board written from its design file and its board (`site/showcase/draw_face.py`), with the knob turnable to each console, the path its data takes, and the readings the decks measured; KiCad's 3D renders, front and back; the gates run on it; a strip of boards built with Via. The page moves with Motion 14.6.0 (motion.dev, MIT), vendored in `site/vendor/`: the logo draws itself, sections rise into view, runs type out, the board leans toward the pointer. A reader who asks for reduced motion gets the page still. The header, the footer and the Open Graph image carry the Via wordmark.
- Another example project, `examples/snapdragon-dev-board/v0.1`: Wyvern, a development board the size of a Teensy (60.96 x 30.48 mm, 2 rows of 24 pins) with a Snapdragon 845 on it. The Snapdragon arrives on Lantronix's Open-Q 845 uSOM on 3 DF40 sockets, its 300 pins named from the public datasheet; an RP2350 under the module drives the pins at 3.3 V, and the Snapdragon resets and flashes it over USB. One USB-C port carries power, USB 3.1 and DisplayPort: its 4 SuperSpeed pairs and its USB 2 pair are drawn by hand in the design file as coupled 90 ohm pairs over ground on a 6-layer board in black mask and ENIG, wired the way a plug turned over sees them so no 2 pairs cross. A TPS62130 makes the module's 3.8 V. 6 decks with a frequency plan: the buck's power-save pulses against the USB cable's resonance, and the cable's peak impedance against the buck's negative input resistance at the module's boot peak. It is laid out as a board repository is (a series README, a version folder, `parts/`, `docs/gates.md`, pictures with the module on its sockets).

### Fixed
- `workcenter costs` and `gates --report` take a block marker only alone on its line, as they write it. A sentence that names the marker (`` the `<!-- workcenter costs -->` markers ``) failed `costs` with `has no closing marker` (M176).
- A phone showed the new page with the stylesheet of the page before: the custom domain's cache keeps a stylesheet or a script 4 hours and asks again for each page (M157). `site/build.sh` names `site.css`, `site.js` and `effects.js` with their checksum, and a test holds the built page to it.
- A custom pad reaches the router as its outline, the hull of its shapes turned with the pad. It went as a rectangle, and a mic's sealing ring covered its other 4 pads, which the router then left open (M140).
- A part bound to a model (`d.sim`) carries its Sim fields on its footprint too, hidden. The DRC's parity check warned `Missing symbol field 'Sim.Library' in footprint` for each one (M141).
- The website said Rosetta v0.2 is a 4-layer board, in its section and on its card. Its board has 6 copper layers, and the page says 6.
- `workcenter render` and `tools/scene.py` draw a board in its stackup's colours (`--use-board-stackup-colors`): kicad-cli drew every board in its preset's green with tin pads, whatever its stackup named (M134). A test holds every 3D render the gate asks for to the flag.
- `install.sh` fetches the KiCad PPA's signing key from Launchpad's API when keyserver.ubuntu.com does not answer; some proxies reset every connection to the keyserver. The fingerprint check decides either way (M133).
- The site's favicon is the Via wordmark of `site/logo.svg`, centred in a square. It was the old mark, a via in cross-section, after the header and the footer moved to the wordmark. `favicon-32.png` and `apple-touch-icon.png` are drawn again from it; the touch icon's wordmark is 148 px wide on its 180 px square.
- `install.sh` fetches the KiCad PPA's signing key from Launchpad's API when keyserver.ubuntu.com does not answer, and checks it against the same fingerprint. A cloud session's network reset every connection to the keyserver, and the install stopped before apt.
- `install.sh` installs `openjdk-21-jre` when the Java runtime has no `libawt_xawt.so`. Debian's headless runtime, the base of the official KiCad image and so of the Dockerfile, has none, and FreeRouting stopped there with a `HeadlessException`: the image could not route. Ubuntu's headless runtime carries the library and is left as it is.

### Changed
- P4 gains step 10: a part of 0.65 mm pitch or finer stands at a multiple of 90 degrees (M142). P19 reads a custom pad's padstack in the router file (M140). P27 holds a model written for the project to its own deck first, bounds a loop deck's operating point, and fixes a stalled deck's step control instead of skipping it at the corners (M139, M143, M144). P30 searches a rail's peak from below where its L and C can put it (M145). 2 rows in the landmine map: FreeRouting at an angle, ngspice's step control in a loop.
- P3 step 4: a keep-out added to a placed board is checked for the pads inside its polygon, on every layer, a ground pad's via included (M137, M138).
- P34 (the form of a new product) is new: the form in 2 sentences in the first message, before the first design file, and boards that join into a solid checked by the project's own code for shared corners (M129, M130). P4 gains a step for a route that leaves a link open (M132); P23 a step for an assembly's first body and a line on stackup colours (M131, M134).
- P4 (before every route) gains step 11: each supply pin of a fine-pitch part gets a way out before the first route, past its pad or inward to a via inside the ring of pads, with no other net's pad across it; where none is left, the rail is drawn by hand (M146); step 6 says a seeded route can lose connections its seed had. M147 to M149 record a route started against P4's step 6, `cd` and `pkill -f` against P8, and back-face rotations against P19.
- P31 (work handed to helpers) gains 3 steps after a message to 2 helpers started a copy of each (M125): the signal that the health gate runs is a lock file the brief names, no message goes to a helper that a workflow runs, and a helper has stopped when its task says so. The root `README.md` links each document it names, and its table of parts has a header row.
- `README.md` opens with a board: the first picture, 2 runs of the gates, the board turning and the sheet of its layers. What the workcenter does is a table, a diagram shows how a run goes, and the quick start takes a first board from the template to its gates. The 24 commands and the repository map fold away; a test holds that count to the CLI's own.
- The SIM gate's corner search, after 2 reviews found bounds that held at every run the gate made and failed between them. Each part runs alone at both ends of its tolerance and half-way to each, and a measure that peaks between the ends is followed toward its peak: a series LC's gain at 10 kHz is 0.147 as written, 0.239 and 0.072 at the ends of its 20 % capacitor, and 1.0 with the capacitor 13.4 % low, against a 0.5 ceiling. Every combination of the ends runs when that is 64 runs or fewer: a bridge whose imbalance is 0.064 V at most with 1 resistor off reads 0.25 V with 4 off together. Above 64 runs the gate runs 1 worst case for each bound and warns that 2 parts off together can hide a miss, until the project names `monte_carlo`. Fixture `pass-rc-divider` runs 46 corners where it ran 18 (M116).
- A tolerance moves every place a deck writes a part's value: on a continuation line, behind `r=`, `c=` or `l=`, in atto (`5a`), as `{expr}`, `'expr'` or a parameter's name. An expression is scaled where it stands, so 2 resistors written from 1 `.param` move apart (2.375 and 2.625 V on a divider that read 2.5 V at every corner before). `tolerance.parts` also takes the DC value of a V or I source, and a `.param`, which moves as one with the parts written from it. A name there that no corner can move fails the deck. A value set again in `.control` follows its part through `alter r 1k`, `alter r = 1k`, `alter @r[resistance] = 1k`, `alter r resistance = 1k` and `alterparam`; one set from a variable fails the deck with the line.
- The SIM gate fails a deck on 6 things it passed in silence: a value ngspice reads as another number (`4k7` is 4 k, M117); an element held at its own temperature (`temp=`) in a project with temperature corners; a deck that sets a temperature among its netlist lines, which now runs at each temperature the project names; a name printed 2 times with 2 values, each of which is judged; a bound that is NaN or infinite; `"at": "nominal"` with no `source`.
- The frequency plan reads a periodic source in every form a deck writes it: `SINE`, a braced argument with spaces or parentheses in it (read before as 1000 MHz, or as no source), a quoted argument, a comma, a stimulus on a V, I or B source. A comment that holds a stimulus is no source. A source whose frequency is no number in the text (a parameter, an expression, a PWL that repeats, SFFM, AM, a B source of `time`) is named in a warning. A deck that answers an overlap is also run with L stepped against C between their ends, 2 % of a value at a step: a 16 kHz clock on a filter whose resonance crosses it inside its parts' 20 % moves the rail 22.0 mV against a 17 mV bound, and 13.2 mV at most at the ends. A resonance read from a deck that runs no corner fails the plan, as does a measure of the plan that some corner does not print.
- `workcenter verify` judges a requirement's check at the corners whatever its deck's own bound says: `warn` and `"at": "nominal"` are about that bound. A requirement whose deck ran no corner is "judged as written only": the summary and the last line count it, the requirements are not met, and `--strict` fails with the deck and the reason. An expect file that is not JSON is 1 problem line; it ended in a traceback.
- `workcenter gates` and each gate print every failure and every warning (5 of each were printed), and the verdict is the last line with `--report` too. A project with decks and no board ends `GREEN ... (nothing to run for: erc, drc, export)`: a small model read the plain `GREEN` as a finished board. A failure names how many more corners miss (`(and 9 more corners)`). `workcenter sim --deck` prints each bounded value's `margin`, its least distance to a limit over the corners. `--jobs` takes a whole number, 0 or more; `--jobs -1` ended in a traceback.
- A bundle (`sim --bundle`) holds the other files of the deck's folder, and its `run.sp` changes to its own folder before it reads the deck: a deck that reads a file beside it (`source print_it.sp`, a file source) ran at the gate and stopped in its bundle. An include path with a space is written in quotes, at a corner and in a bundle. `DIR/<deck>/` that holds no `run.sp` is refused; the command replaced any folder of that name. A missing include is a problem line.
- `workcenter design` stops a first design file's traps with the line to write, after a small model met each one on its first board: `Design("name")` with no namespace or with a string; `power_nets` as a list; a flagged net `power_nets` does not name; a power symbol KiCad's library lacks; a part with every pad outside the outline, placed from (0, 0) instead of the board's corner (a `part:` line with the place in board coordinates); a route that joins nothing, where FreeRouting exits 0 ("N unrouted", exit 1). The `pull:` line ends with the `defined_nets` entry it asks for. A design file the generator refuses is 1 `file:` line with the file's line number and exit 1, in place of a traceback.
- `workcenter next` gives a command that runs in every state. A path to a file is answered with the project's folder; before, each later answer named paths under the file. The first answer has no RUN line, since 2 commands joined by "or" are not a command. A folder with 2 project files is told to name 1, and a folder that is not there to make it. A report from a run without an engine is run again once the engine is found; it asked for the install for good. A finished project gets no RUN line. `next` leaves no bytecode in the project. Every sentence it prints is 20 words or fewer, and a test holds that.
- The `simulate` skill's "Corners", "The frequency plan" and "A deck on another machine", the `verification` and `board-gates` skills, `WORKCENTER.md` and `CONFIGURATION.md` say what the gate does after these changes. P7, P8, P9, P14 and P31 gain steps (M116 to M120).
- The SIM gate fails a deck when one of its analyses stops (`doAnalyses: TRAN:  Timestep too small`, `tran simulation(s) aborted`). ngspice exits 0 when a later analysis completes, and the measures taken on the cut-short vectors passed (M103). A complex value (`h = 1.63e+00,-1.69e-01`) is no longer read as its real part.
- The SIM gate refuses an expect file it cannot hold a deck to: an unknown key (`"mx"`), a bound with neither `min` nor `max`, a `min` above its `max`, a limit written as text, a measure named with a capital, which ngspice never prints (M104). A misspelt key passed as a bound that held nothing.
- Every ngspice run of the SIM gate has its own home folder, so a `.spiceinit` in the user's home changes no deck. The gate warns on a deck with no expect bound, on an operating point ngspice doubts (`Warning: singular matrix`, `source stepping failed`), on a project with no `sim/corners.json`, and on periodic sources with no `sim/frequency-plan.json`; `--strict` fails on each.
- Verdicts say what ran. `workcenter gates` prints `GREEN with N warnings` when a gate named warnings and `SKIPPED (SIM: engine missing)` with exit code 2 when an engine is absent; it printed `GREEN` for both (M106, M109). Each gate's warnings print under it as `- warning:` lines. `workcenter verify` ends with `REQUIREMENTS MET (n of n pass)` or `REQUIREMENTS NOT MET (...)`; it printed `PASS` beside failed requirements. The gates report carries the same verdict and a "Corner runs" column in its deck table.
- `workcenter verify` judges each traceability check at the least and the greatest value the corners gave and names the corner in a failure; `--strict` fails a package whose project has no `sim/corners.json`.
- P7, P12, P14, P27 and P28 gain steps: a parser keeps a sample of each way its tool fails, and a file a person writes is read against the keys it may hold (M103, M104); a gate tells a skip with nothing to run from an absent engine (M106); a report gives each verdict as the command printed it, the whole line (M109); a deck leaves the project as a bundle (M105); `sim/corners.json` is written before a requirement is judged (M107). `AGENTS.md` gains invariants 13 to 16 and six landmines about ngspice and expect files.
- A run ngspice did not finish names its first error line and its log in the failure (`cross: at R2 -5 %: ngspice exit 0, 1 error lines: Error: measure  v_at  when(WHEN) : out of interval (log <path>)`); it gave only the count, and a reader opened each corner's log to find the one.
- `workcenter sim --deck` lists the R, C and L elements no tolerance moved (`at its written value in every run: LCABLE`), and the deck's corner record carries them as `fixed`.
- The `simulate` skill measures a resonance's half height above the rail's low-frequency floor; taken from zero the crossing does not exist on a rail with series resistance, and the `meas` fails at a corner. It also says where a limit "at every moment" is measured from, what a changed part value brings with it, and what the source of a frequency from a spec is.
- `--json` is read before the command or after it. `workcenter gates <project> --json`, as the `board-gates` skill writes it, ended in a usage error with exit code 2 (M18, M114). `tests/test_docs.py` holds each flag a document gives a command to that command's own `--help`; P10 gains the step.
- The repository's name is `ThyFriendlyFox/via` in `environment/setup.sh`, in the name `workcenter fetch` gives a server, and in `ROADMAP.md`.
- `README.md` lists every command, the corners, the frequency plan and the repository's folders; `tests/test_docs.py` fails when a command, a skill, a tool file or a fixture is missing from the documents that list them.
- `workcenter docs` lists a firmware's mutation list (`firmware/mutations.py` or `.json`, what `workcenter mutate` runs) and the version's `pictures.json` in `CONTENTS.md`; both were left out, found moving Last Hit v0.16 onto the workcenter's commands.
- P8, P18, P23 and P27 gain a step each from the Last Hit v0.16 mistakes: a helper writes only under its worktree (M102); the mutation list reruns after every firmware change (M101); an assembly scene draws every body its boards name, through `tools/scene.py` (M99); a curve's value comes from `workcenter curve`, the middle of the drawn line (M100).
- P22: `workcenter version new` makes the next version's folder, the version's README keeps the layout of `templates/project/README-version.md`, and generated tables are never edited by hand: the cost totals in every copy that carries the `workcenter costs` markers (M97), the gates tables through `workcenter gates --report`, `CONTENTS.md` and `datasheets/` through `workcenter docs`.
- P28 and the `verification` skill: a measurement behind a series part lists every current through it in both directions (M92); every track resistance a deck uses comes from `workcenter inspect resistance` (M93); one deck runs by hand only through `workcenter sim --deck` (M94); a fuse is checked at every event that moves charge through it (M95); helpers work from a brief that asks questions, names files that exist and points at one facts file (M95, M96, M98). The skill gains a "Helpers" section with two checks for a brief, and the traps.
- The router keeps each layer's hole clearance: `kicadgen` reads the fab's layer rules (`Design.hole_clearances()`, Sierra's 13 mil inner drill to copper) and writes every via and drilled pad into the DSN with its copper grown by that rule on the layers where it exceeds the copper clearance (a 0.6/0.25 mm via is 0.6104 mm on In2 at 0.15 mm). FreeRouting 1.9.0 ignores a `via_wire` clearance in the DSN's structure and applies one in a net class to that class's own pairs only, both measured on a fixture. Hand vias, the via placers and island stitching hold the same rule (M79, P17).
- `workcenter design` ends a red run (exit 1) with a line that names each failure and says the files are written for inspection only and a CI regenerate check fails on that exit code; `--json` adds `red` (M85).
- P23 runs through `workcenter pictures <version>` and its `pictures.json`: the framing check is `--frames 4`, the assembly a scene script on `tools/scene.py`; the `board-gates`, `verification` and `procurement` skills name the new commands.
- The `simulate` skill runs a deck by hand only through `workcenter sim --deck`, reads a datasheet's curve with `workcenter curve` and fetches a new model with `workcenter fetch`; the `procurement` skill keeps a chosen part's datasheet with `workcenter fetch --row`. P14 names `design --check` and `ci`, P18 `mutate`, P27 `fetch`.
- `kicadgen.parse_all` parses every top-level form of a file, as its docstring said; it returned only the first, so a rule file read through it lost every rule after `(version 1)`.
- `workcenter design` lists each part whose courtyard enters a parts keep-out as a `part:` line and exits 1 (M87).
- `install.sh`: apt's progress lines reach the log as they happen (the filter flushes per line and matches apt's `Get:<n>` lines, which it never did), and a silent mirror times out after 60 s and is retried (M86).
- P4 reads a route's verdict from `workcenter design`'s exit code, which is 1 on a refused hand via although every file is written; P14 runs a board repository's own CI checks locally before the push (M85).
- `workcenter sources` refuses a `sources.csv` row with more fields than its header (an unquoted comma in a note) instead of dropping the extra fields (M76).
- P8 names `pgrep -f` in a wait loop beside `pkill -f`; P9 writes a rewritten file to a new file first and reads a script's ranges from the file it edits; the verification skill's ngspice traps add `let`'s missing SI suffixes and `meas` results living in their own plot (M74 to M80).
- P28 and the verification skill: a limit computed from parts' values carries their tolerances; a fitted model's value away from the datasheet's rows is no maximum; a stand-in never clamps at an absolute maximum, and every output driving a capacitor has its peak current bounded; citations in code comments come from the document's text too (M81 to M84).

### Added
- `workcenter chip`: a chip project from RTL to a GDSII layout on the sky130A process. `chip init <dir> --top NAME` starts a project from the template. `chip gates <project>` runs 10 gates in order and stops at the first that fails: LINT (Verilator), SIM (Icarus Verilog), SYNTH (Yosys), LAYOUT (OpenROAD, Magic), STA (OpenSTA, at every corner the project names), GLSIM (the benches on the routed netlist), DRC (Magic and KLayout), ANTENNA, LVS (Netgen) and EXPORT. Each gate also runs alone (`chip sta <project>`). Each gate writes `build/chip/<gate>/passed.json` when it passes: the hash of each file it read or wrote. EXPORT copies the layout into `build/chip/tapeout/` only when all 9 gates before it passed the files as they are now: the RTL and each header it includes, the benches and their bounds, the constraints, `chip.json`, the mapped netlist the layout was built from, and the layout. A file that changed while a gate ran fails that gate, and a file that came after a gate passed fails EXPORT. A record takes the project's files from the engine itself (Verilator's XML, the list Icarus Verilog writes, the rule Yosys writes), so a header is held however the RTL names it, and it names a file the same way wherever `--out` points. LINT fails text that speaks to 1 engine alone: a `lint_off` comment in any spelling, a `verilator_config` block, an `` `ifdef `` on `VERILATOR`, `SYNTHESIS`, `YOSYS` or `__ICARUS__`, `translate_off`, `full_case`, and `$readmemh` in the RTL. It holds the constraints to a delay for setup and for hold on each bit of each port, each option 1 time, and no margin that gives time away (a clock uncertainty under 0, a late derate under 1). SIM refuses a bench that reads a file while it runs. The layout build reads every library corner the project's ranges select; it repairs slew and capacitance after the placement with a wire capacitance measured on routed wires, and antennas after the global route. SYNTH maps without the cells the process kit lists as not to use, counts the flops of the netlist and names each flop the mapping removed. SIM proves the benches: it makes each change of `rtl/mutations.json` in a copy of the RTL, and a change that every bench passes on, or one that does not compile, fails the gate; a change is made in a file the RTL alone reads. `workcenter next <project>` names a chip project's one next step, from `chip.json` to GREEN, and says a chip is done only when each gate's record holds the files as they are and `build/chip/tapeout/` holds what its manifest names; the skills `chip-design` and `chip-gates` write the project and drive the gates. 1 layout has 1 hash: the GDS carries no date of the run. `chip render <project>` draws the layout. The engines install on request: `sudo ./install.sh --chip`. `tests/chips/` holds 9 fixture chips. The acceptance processor, 760 cells on a die of 152.38 um by 152.38 um, is GREEN with `--strict` in 217 s on 4 processors (the roadmap's item "A chip from RTL to a mask layout", shipped 2026-11-12).
- The landmine map gains 6 rows: 6 ways OpenSTA, OpenROAD, Magic and Netgen let a fault read as none.
- The fixture board `tests/boards/pass-first-design`: the first design file, built. Its `design.py` is `templates/project/design.py` to the byte, its schematic and its project file are what `workcenter design` writes from that file, and its board is the routed result of the same command. It is the 1 fixture that goes from a design file through all 4 gates: GREEN with `--strict`, 46 corner runs on a deck with 2 bounds. `tests/test_designfile.py` compares the 2 files with a fresh build and runs the fixture's gates.
- `site/media/`: the pictures of the root `README.md`, with the command that draws each in its own `README.md`. `hero.png` and its dark twin show 12 lines of the fixture's design file, its schematic and its routed board in 3D. `board-spin.gif` turns the board, `layers.png` is the sheet of every layer, and `diagram.png` with its dark twin is the site's diagram. `site/index.html` takes `?theme=dark` and `?shot=diagram` for the captures. `tests/test_docs.py` grows from 15 to 16 tests: the code a page shows is a run of lines of the design file, every picture in the folder is shown by its README, and every link of both READMEs names a file.
- The site's page gains a section, "A Python file becomes a board.": the 3 cards of the README's first picture, as HTML. `site/build.sh` copies the 2 pictures the section shows, and the page states each picture's size.
- A commit names the repository's owner as its author. `tests/test_docs.py` fails on a commit of the checkout that names an assistant as author or committer, or whose message credits one; it proves itself first on a history it builds. The root instruction files, `ee-agent-kit/AGENTS.md`, `CONTRIBUTING.md` and `TONE.md` say so (the owner's decision of 2026-11-11). P33 holds the steps for rewriting a history that is already pushed (M123).
- The website, `site/`, live at <https://via-kappa-five.vercel.app>: 1 static page that says what the workcenter is, with 4 real runs (`gates` GREEN and red, `next`, `sim` at its corners) and the project's aim with its dated evidence, in the look of the apparatus site: paper and ink, 1 ink-blue accent, Inter at weights 400 and 500, light and dark. Plain HTML, 1 stylesheet and 1 script; no install step. `site/build.sh OUT [ORIGIN]` writes the folder a host serves and puts the site's address into the canonical link and the Open Graph tags, or leaves those lines out when it has none. `site/vercel.json` is the Vercel project's whole configuration. The mark is a via in cross-section; it is the favicon as SVG and as PNG, and a phone's touch icon. `site/og.png` (1280 x 640) is the Open Graph image and the repository's social preview; `site/og-dark.png` is its dark twin. The README opens with that picture, 2 runs, and a CI and a license badge, and gains The website, Where things stand and License. `tests/test_docs.py` grows from 9 to 14 tests: each run a document shows is compared with a fresh run of its command, so the 46 corner runs on the page cannot go stale.
- `tools/hooks/install_hooks.py` installs both agent hooks into a user's settings: the one that refuses `cd` and the one that refuses a test edited by a script. It knew only the first, so a session with 2 repositories ran without the second (M119). `workcenter doctor` gains the `test hook` row. A settings file with the first hook gets the second on the next run.
- `templates/project/design.py`: the smallest complete design file, a divider with a filter capacitor behind a 3-pin header. As it stands it generates, routes (21 segments) and passes ERC and DRC with 0 errors and 0 warnings. It turns `check_sim` on: a part added to it says how it simulates, or why it does not, before a file is written. A small model had proved a filter with its op-amp written as 2 controlled sources in the deck, and every gate passed.
- Tests that hold what the reviews found, each seen to fail on broken code: `tests/test_designfile.py` (14 tests), and new tests in `test_corners.py` (82 in all), `test_simgate.py` (38), `test_freqplan.py` (43), `test_guide.py` (71) and `test_verify.py` (32). The contract review's 6 mutants, each a stated behaviour broken in 1 line, all passed the suite before and are all caught now.
- A generated schematic that simulates (`kicadgen`): `d.sim(ref, library, name, pins, params)` binds a part to a `.subckt` or a `.model` in a file, `d.sim(ref, device, params)` gives it a value of its own, `d.no_sim(ref, reason)` leaves it out, `d.sim_directives` puts SPICE lines on the sheet. The generator writes KiCad's Sim fields on the symbols, so `kicad-cli sch export netlist --format spice` writes a netlist ngspice runs, and raises `simulation_model_issue` to an error in the project so the ERC gate reports a model KiCad cannot load. `Design.sim_problems()` refuses, without KiCad, a map that leaves out a pin of the symbol or a node of the model (KiCad 10.0.8 binds such a node by position with exit code 0), a node the model does not have, a file or a name that is not there, and a 4-terminal MOSFET model on a 3-pin part; `workcenter design` prints each as a `sim:` line and exits 1. `d.check_sim` asks for a `sim` or a `no_sim` on every part but an R, C or L whose value KiCad reads as a number. A design that says nothing about simulation regenerates byte for byte. `workcenter next` answers a refused design file with its first problem, where it said to regenerate.
- Corners in the SIM gate (`sim/corners.json`, `tools/simcorners.py`): each deck runs as written, then at each temperature (`.options temp`), at each end of each tolerance (R, C and L by kind for an element named like a board reference, any element or `.param` by name under `parts`), at a worst case per bound chosen from those runs, and at seeded Monte Carlo draws. A bound holds when it holds at every corner; a failure names the corner (`diode_ref:vref=0.4215933 at 85 C, R1 +5 %`). A range without its `source` is refused, a deck that sets its own temperature fails its temperature corners, and a deck no measure of which moves with temperature is named. `"at": "nominal"` and `warn` bounds hold as written only; `decks.<deck>.skip` says why a deck has no corners. Each corner is a copy of the deck in `build/sim/corners/<deck>/<corner>/` (M107).
- The frequency plan in the SIM gate (`sim/frequency-plan.json`, `tools/freqplan.py`): the board's periodic sources with their ranges, and its resonances read from `.ac` deck measures at every corner. The gate fails on a source's harmonic inside a resonance's band and on 2 sources that can run at 1 frequency, until an `overlaps` entry names a bounded measure and the deck element that drives it there. A deck stimulus outside every source's range fails. P30 (M108).
- `workcenter sim <project> --bundle DIR`: each deck as a folder that plain ngspice runs on any machine (`run.sp`, the deck, `models/` with each model translated as the gate reads it, the bounds, the gate's measures, a README with the ngspice version and each model's revision). The command runs each folder from a copy in another place and fails when a measure differs from the gate's (M105).
- `workcenter sim --nominal` (the decks as written only, named as such in the result) and `--jobs N` (corners run side by side).
- `workcenter next <project>` (`tools/guide.py`): the one next step for a project, as `NEXT`, `RUN`, `WHY`, `READ` and `DONE WHEN` lines, from the folder's state and its last gate run; for the first failure or warning it names the fix and the section of a skill or process to read. Exit 0 when nothing is left. `--trust-design` skips the regenerate check.
- `AGENTS.md` at the repository's root, the same text as `CLAUDE.md`, for a host that reads that name; `make verify` holds the 2 files equal.
- `templates/project/corners.json` and `frequency-plan.json`: both files with every key and `fill:` where a source goes; the gate refuses a `fill:` left in place.
- Fixtures `fail-sim-corner` (2 decks inside their bounds as written, outside at 85 C and at 5 % resistors), `pass-lc-filter` (a filter whose resonance a clock's harmonic meets, answered by a deck that drives it there) and `fail-freq-overlap` (a load at a third of a filter's resonance with only its average bounded); `pass-rc-divider` gains corners and temperature coefficients.
- P30 (a frequency plan) and P31 (work handed to helpers); `MISTAKES.md` M103 to M115.
- `workcenter verify` reads the owner's decisions. A requirement the owner withdrew sits in the requirements' Withdrawn table (`| ID | Date | Decision | By |`): the summary names it, the counts leave it out, and a traceability row, an expect bound or a requirements table that still names it fails the check. A requirement the owner restated names "the owner's decision of <date>" in its Source, and the date is checked.
- `templates/project/README-version.md` and `templates/project/gates.md`: the layout of a version's README (the status table, "What changed", the standing sections, Decisions, Open items) and of its gates report, with the marker comments `workcenter gates --report` fills.
- `templates/verification/BRIEF.md` and `FACTS.md`: the brief and the facts file for helpers who write parts of one verification package at the same time. `workcenter verify --init` leaves them out of the package.
- `workcenter design --route --seed <board>`: a previous routed board's router tracks and vias go to FreeRouting held (`shove_fixed`), so the paths that still fit stay and only the rest are routed; seed copper that hangs from nothing goes in unfixed, for the router to reuse or remove. Hand copper, stitching vias, lost nets and arcs are left out, and copper that now meets another net's pad or copper, a keepout or the board edge is dropped, each counted on a `seed:` line with how many seed tracks the new route kept (`kicadgen.board_copper()`, `Design.seed_wiring()`, M89).
- `workcenter design` prints each via it drops through a pour's island after routing as a `stitch:` line: the net, the island's layer and pads, the layer the via reaches (`Design.stitches`; `--json` `stitches`).
- `workcenter docs <version>`: the version's `CONTENTS.md` (its README's sections, design and KiCad files, scene scripts, decks, verification package, firmware, pictures, parts lists) and `datasheets/`, each part's datasheet copied from the library by `sources.csv` with its revision, or why there is none; `library/series.csv` names a part a series sheet covers; a stale copy is removed.
- `workcenter costs <repo>`: `procure` on every board of every version with `parts/version/<id>.csv`, `parts/catalog.csv` and `parts/offboard/<id>.csv`, the lists in `parts/lists/`, the totals table in every `<!-- workcenter costs -->` block and the list links in every `<!-- workcenter costs lists -->` block (M97).
- `workcenter pictures <version>`: P23 in one command from a `pictures.json` (written with defaults when absent): each board's stills and layers with `render --strict`, its turning GIFs, the scene scripts, the copies into `docs/` and `docs/layers/`; `--frames N` draws the framing check into `build/pictures/check/` and leaves `docs/` alone.
- `tools/scene.py`: an assembly scene (a routed board, bodies made or loaded and placed at board coordinates, stills from named views, a turning GIF), so a project's assembly script holds only its placements.
- `workcenter gates <project> --report <file>`: the gates table and the deck list written between `<!-- workcenter gates NAME -->` and `<!-- workcenter decks NAME -->` markers in a report, the prose kept.
- `workcenter version new <repo> <vNEXT> [--from <vPREV>]`: P22's mechanical steps (the copy without `build/`, both README banners, the root README's row and the previous row's commit, `CLAUDE.md`'s version references, the parts files) and a list of what stays by hand.
- `workcenter diagram <spec.json> --out <file.svg> [--png]`: a block diagram from a spec (blocks, rails, arrows styled by what flows, board groups, a legend); the starter spec `templates/verification/system/block-diagram.json`, which `verify --init` copies.
- `workcenter sim <project> --deck NAME`: one deck the gate's way, with every value it printed beside its bound; `--keep` runs each deck from `sim/run/<deck>/` (a deck run in place copied there with its folder's `.spiceinit`), leaves the folder, and prints the one command that reruns it by hand (M94).
- `workcenter fetch <url> --to <library>/<maker>/<file>`: one datasheet, model or body fetched once under the workcenter's own name; prints its `sources.csv` row (URL, file, SHA256, today, a model's `.SUBCKT`, the lines that may carry its revision); `--row` with `--mpn` appends it in the file's own line ends and refuses a second row of one kind for one part; `--member` reads a file out of a zip.
- `workcenter curve <pdf> --page N`: a page's vector paths grouped by kind, stroke width, paint and colour, with candidate frames and numeric labels; with `--frame`, `--x` and `--y`, each curve inside the frame on the plot's axes, `--at` and `--at-y` interpolated in decades on a log axis, a line drawn as a filled outline reduced to its middle. `tools/pdfcurve.py` reads the PDF with pdfminer under the venv.
- `workcenter design <design.py> --check`: regenerate into a temporary folder and compare the `.kicad_pro` and `.kicad_sch` with the design's own, as a board repository's CI does; exit 1 on a difference or on the design step's own failure (M85).
- `workcenter ci [repo]`: a repository's GitHub workflow replayed here, `run` steps in order under `bash -e` from the repository root, `$GITHUB_ENV` and `$GITHUB_PATH` carried between steps, `${{ env.X }}` read, `needs` ordered, install and upload steps skipped by name (`--skip`), each step's script and log in `build/ci/`; `CI REPLAY GREEN` only when every step it ran exited 0. PyYAML reads the workflow under the venv.
- `workcenter mutate <firmware> --mutations <file>`: each mutation in the project's list (JSON, or a Python file's `MUTATIONS` read as a literal) in its own copy of the firmware without `build/`; every anchor checked first, the tests run unmutated first, a survivor or a mutant a compiler stops fails the run; `--jobs` runs several at once. P18 step 4 names it.
- `python3 tools/kicadgen.py symbol-add <lib.kicad_sym> --from <pins.csv>`: a one-unit symbol from a datasheet's pin table, each pin on its side on the 1.27 mm grid, the body sized round its names, appended without touching the symbols already there.
- The venv gets pdfminer.six 20260107 and PyYAML 6.0.3 (`curve`, `ci`); a test fails where the venv is installed and either is missing or off its pin.
- `workcenter inspect <view> <board>`: a routed board read with KiCad's own geometry (`tools/inspect_board.py` under the venv). `map --box X0 X1 Y0 Y1` draws one PNG per copper layer of a window (pads with names and nets, tracks, vias, pours, keep-outs, courtyards, a 1 mm grid; back and inner layers seen from the top); `list` prints the items in a window, or `--json`; `probe` places a via, a track or a part (`--part REF --at X,Y`, a new one with `--footprint`) and lists every conflict: copper clearance by net class, hole to copper with the project's `.kicad_dru` layer rules, hole to hole, the edge, courtyard overlaps, keep-outs by name (M90, M91); `net` gives a net's connected groups; `islands` a pour's pieces and the islands no via reaches (M88); `resistance` a copper path's resistance from the stackup's thicknesses and the via barrels (M93); `crossed` the nets that crossed a window on an old board and which the new board leaves open (M89).
- `python3 tools/stretch.py design.py --cut X --grow G`: grows a design at a cut, moving every board x-coordinate east of it in the code, never in a comment or a string, and listing every number it left for a look by hand.
- `kicadgen`: `d.keepout(..., parts=True)` keeps footprints out of an area, written to KiCad as a rule area with footprints disallowed, and `copper=False` lets tracks and vias through it; `Design.check_parts()` (M87).
- P29 (placing a part on a routed board) and the `board-design` skill's inspection steps; fixture `tests/boards/inspect-four-layer`, generated from its own `design.py`.
- The venv's Pillow (12.3.0) pinned in `requirements.txt`, for `inspect map`.
- `workcenter verify <project>`: checks a verification package (`verification/`, P28): the files it holds, a requirements table with a source, method and inspection clause on every row, a writeup with every section for each circuit and for every deck, links that lead somewhere, a traceability row for every requirement; runs the SIM gate and compares every number quoted beside a `deck.meas` with the run (to half a unit of the quoted digit, SI prefixes understood) and recomputes each traceability check against its verdict. `--strict` fails on a FAIL or OPEN requirement; `--init` writes the skeleton from `templates/verification/`; `--package` names another folder. Writes `build/verify.json`.
- The `verification` skill and P28: conditions, sourced requirements judged at the corners, one cited nodal analysis per deck, models fitted to datasheets where the maker publishes none, a standards map (DO-160G, MIL-STD-461G, MIL-STD-810H, IEC 61000-4-2, USB, UM10204, EEE-INST-002 derating) with the editions read.
- The SIM gate takes a model under the deck's own folder (`sim/models/`) as the project's own: no library row is asked for it. An expect bound may name its requirement (`"req"`).
- `workcenter sources <project> --parts FILE`: every part on the schematic against the nearest `library/sources.csv` (datasheet, SPICE model and STEP rows: URL, file, revision as printed, date, `.SUBCKT`, ngspice fixes, SHA256): a datasheet for each part, a model or a note for each U, Q and D, each file present, unchanged and printing its revision, each model loading in ngspice with its sub-models, a model older than its datasheet named. `--fetch` reads each URL again under the workcenter's own name and records a refusal. P27, the `simulate` skill.
- The SIM gate runs a deck that includes a listed vendor model from `build/sim/run/<deck>/`, with the model translated where its row says (`res-model` folds PSpice RES models into their resistors, `tolerance` drops LOT and DEV, `ps` or `lt` mode in a `.spiceinit`); a model changed since its row fails the deck. An expect bound with `warn` holds a model to its datasheet and fails only `--strict`.
- The pull-resistor check: `kicadgen.Design.undefined_inputs()` finds every net with a gate, logic input, switch or I2C line that no output drives and no resistor holds at a rail (or a gate at its own source). `workcenter design` prints each as a `pull:` line and fails on them when the design sets `check_pulls`; `defined_nets` names a net held elsewhere with the reason. P16 step 5.
- Fabrication house rule sets in `rules/` (KiCad `.kicad_dru`), the first Sierra Circuits' Web PCB (`sierra-circuits-web`: 4 mil trace and gap, 6 mil hole and ring, 13 mil inner drill to copper, 5 mil legend text). `workcenter drc --fab NAME` and `gates --fab NAME` check a project against one on a copy; `kicadgen.Design.fab` writes it into the project as `<name>.kicad_dru` and raises the board's own minimums to its board-wide ones, so the via check refuses a via the fab would. Fixture `fail-fab-sierra`.
- kistack (American Embedded's KiCad agent skills) vendored at `641ade9` in `third_party/kistack/`, without its logo; the `kistack` skill names which of its skills to read at which step and where this workcenter's rules override it (no getting round bot protection, the design file is the source of truth, FreeRouting routes, the gates decide done).
- `workcenter placement <check> <board> [args]`: kistack's layout-placement checks (`pin_sides`, `placement_audit`, `route_check`, `local_search`, `group_search`) on a board file, headless. `tools/kistack_board.py` answers kistack's IPC reader from the file with pcbnew, since KiCad 10.0 has no headless API server. `move` is refused.
- The venv gets shapely, numpy and pygerber (kistack's placement checks and Gerber review).
- `kicadgen`: project symbol libraries (`Design.symbol_dirs`, a `sym-lib-table` in the generated project, `pins --lib NAME=FILE`), for a part the KiCad library lacks or draws only in several units, such as a dual common-drain MOSFET.
- `workcenter procure <project> --parts FILE --boards 1,10`: prices the schematic's BOM from parts files and writes `procure/bom.csv`, `parts.csv` and `parts.md` with the cheapest order per line and totals per supplier; fails on a line with no part or no price, `--strict` also on a line short of stock or a price older than 90 days. The `procurement` skill and P25 say how a parts file is filled (M54, M55).
- `kicadgen`: wired schematics (`Design.sch_wires`): a grid router (`SchRouter`) draws each net's wires round the parts, with junctions at tees, power symbols pointing away from their pins, and each net's name on its wire; `sch_rot` turns a symbol, `sch_label_nets` keeps labels for chosen nets, `sheet` picks the paper. Off by default, so existing schematics regenerate byte for byte (M51, P24).
- `workcenter render` names every part the 3D views draw without a body; `render --strict` fails on one (M52).
- `wrlgen`: `leadless` (QFN, DFN, SON) and `gullwing` (SOT-23, SOT-523, SC-70) bodies for packages whose library body KiCad does not ship.
- `tools/kicadgen.py`: design a KiCad 10 schematic and board in Python from the installed libraries; writes project, schematic, board, Specctra DSN; merges a routed session.
- `workcenter design <design.py> [--route]`: build a design file, optionally route it headless with FreeRouting.
- `workcenter render <project>`: schematic, board top and bottom, 3D top and isometric images.
- `board-design` skill.
- `install.sh` installs librsvg (`rsvg-convert`) for PNG output.
- `install.sh`, gates ERC, DRC, SIM, EXPORT, fixture boards, skills, kit, CI, cloud environment setup script, Dockerfile (2026-10-22).
- `kicadgen`: parts on the bottom face (`pcb_layer`), free silkscreen text (`d.text`), design-rule overrides (`d.rules`), per-part zone connection (`zone_connect`).
- `kicadgen`: copper pours (`d.zone`), filled headless on write; the router sees them as planes.
- `kicadgen`: hand-routed copper (`d.track`, `d.via`) passed to the router as fixed wiring; `stitch_pads` and `reserve_vias` for ground vias beside pads.
- `kicadgen`: after routing, pour islands are read with KiCad's `pcbnew` module and stitched with vias; `workcenter design --route --rounds N` reserves a via beside what is left and routes again.
- `install.sh` creates the venv with `--system-site-packages` so the workcenter's Python sees `pcbnew`.
- `kicadgen`: project footprint libraries (`Design.footprint_dirs`, an `fp-lib-table` in the generated project, `footprint --lib NAME=DIR`); stadium outlines (corner radius up to half the short side); circle courtyards read as centre and radius (M24).
- `tools/wrlgen.py`: `connector-510` (M7 x 0.5 internal thread), `cartridge-510`, `pouch-cell`, `display-module` presets; material transparency.
- `PROCESSES.md` P18 (firmware that drives power) with M32; `board-design` skill: ground corridors against split pours.
- `.claude/settings.json`: a PreToolUse hook (`tools/hooks/no_cd.py`) refuses a Bash command that runs `cd` (P8, M31).
- `tools/hooks/install_hooks.py`: puts the no-cd hook into a Claude Code settings file, user-wide by default, merged and idempotent; run by hand, never by `install.sh`. `workcenter doctor` reports whether the user-wide hook is there (M35).
- `kicadgen`: keep-out areas (`Design.keepout(polygon, layers, name)`, with `Design.circle(cx, cy, r)` for round ones): a KiCad rule area with no tracks or vias, a Specctra keepout for the router, and a refusal in the via check.
- `kicadgen`: `Design.corner_radius` rounds the board corners (Edge.Cuts arcs, polygon boundary in the DSN, rounded default pour, corner-aware via check); `Design.model()` attaches a 3D body to a part's footprint.
- `tools/wrlgen.py`: parametric VRML bodies in KiCad's 0.1 inch units: `usb-c-vertical`, `threaded-stud`.
- `workcenter render` adds `board-3d-bottom.png`.
- `kicadgen`: `Design.check_vias()` lists every via that hits a pad or track of another net on any layer, another via, a keep-out (by name) or the board edge; `workcenter design` prints the list before routing and exits 1 when it is not empty (M40, M41).
- `tools/hooks/no_script_test_edits.py`: a PreToolUse hook that refuses a Bash command writing under `tests/` by script (P9 step 6, M43).
- `kicadgen`: `Design.corner_radius` takes four radii (top-left, top-right, bottom-right, bottom-left), so a board can be a half circle at one end and flat at the other; `Design.thickness` sets the finished board and writes a stackup on two layers too (a 0.8 mm daughter board).
- `PROCESSES.md` P21 (moving files in a project): self-relative paths listed before the move, every README command run after it, each folder diffed against its source commit (M44).
- `kicadgen`: `Design.check_via_rules()` lists every via size (default, net class, hand via) below the board's minimum hole, via or annular ring; `workcenter design` runs it before routing and exits 1 (M46, `PROCESSES.md` P3 step 5). `Design.board_rules()` is the rule set the project file carries.
- `PROCESSES.md` P7 also covers handing a tool a rotation or an axis; the `board-design` skill writes down KiCad 10's model rotation convention (M47).
- `PROCESSES.md` P22 (versions of a project): every new feature is a new version folder, copied before the first edit (M48).
- `PROCESSES.md` P13 walks a new process through the case that caused it; P22's check allows the archive banner it asks for (M49).
- `workcenter render`: every layer with something on it, one PNG each with the outline (bottom layers seen from below), in `build/render/layers/`, and an overview sheet `layers.png`; `--views spin` writes `board-spin.gif`, the 3D board turning round (`--spin-frames`, `--spin-tilt`, `--spin-zoom`, `--spin-pivot`); `--views` picks what to draw. `install.sh` installs FFmpeg for the GIF; `workcenter doctor` reports it.
- `PROCESSES.md` P23 (pictures of a finished board version): every board's layer sheet and turning GIF, from below too when it has parts on both faces, the assembly's GIF, the framing checked on four test frames, all in the version's `docs/` and README.
- `docs/CONFIGURATION.md`: the `tools/workcenter` flag table whole again, with `--rounds` and the render flags; a test fails a PR whose flag has no row (M50, P10).
- `kicadgen`: four-layer (and any even count) boards: `Design.copper_layers` adds `In1.Cu`.. with a 1.6 mm stackup; `Design.plane_layers` gives an inner layer whole to a pour, which the router never sees; through pads and vias carry copper on every routing layer in the DSN; island stitching lands vias on any layer and keeps clear of other nets' copper on the layers a via passes.
- `docs/CONFIGURATION.md` names the FreeRouting pin that `install.sh` has carried since the 1.9.0 pin (M21).
- `ee-agent-kit/MISTAKES.md` (every mistake, its cost, its process) and `ee-agent-kit/PROCESSES.md` (binding checklists P1 to P21); `make verify` checks that each mistake names an existing process and each process has a "Done when" line.
### Changed
- `autoroute` skill: FreeRouting's result shifts with every hand track added, even far from the nets it then drops; find the culprit on a scratch copy and copy a routing run's own tracks for a net the next run drops (Last Hit v0.11).
- M53 records a sixth `cd`.
- `PROCESSES.md` P20 (swapping a part) step 3: list what the old part did besides its ratings (protection, how it was held and connected) and name the part that does each now (M56).
- `install.sh` prints apt progress and runs it non-interactively; the KiCad download from the PPA is slow on GitHub runners and a silent step was cancelled as hung.
- `workcenter render` leaves the fabrication layer out of the 2D top image.
- `merge_ses` drops the router's echoes of fixed wires and splits a track where the router joined onto it.
- `autoroute` skill: the generated-design path is headless end to end; the hand-drawn path still supplies the DSN.
- `doctor` reports `rsvg-convert` and the KiCad symbol libraries.
### Deprecated
### Removed
- `site/og-dark.png`, and the dark twin of `og.html`: the README shows the board's pictures in its place.
### Fixed
- The session merge writes a track segment 1 time. FreeRouting 1.9.0 writes 2 wires of a net that share a stretch; each was split at the other's end, and the board file held the shared piece 2 times. The fixture `pass-first-design` held 22 segments, 21 of them distinct; it holds 21 now. KiCad's DRC reports no such double.
- The session merge keeps a short link that leaves a hand track at an angle, the joint of a T the router makes onto it. It took the link for an echo of the track and dropped it, and the wire after it ended off the track's centre line: Last Hit v0.16 routed with the new DSN showed one dangling HS_IN track.
- A fab's rule file no longer loosens a board: in KiCad a custom rule overrides every net class's clearance, so the Sierra set's board-wide 4 mil clearance and 6 mil hole had let pours fill 0.1 mm from pads and a 0.25 mm minimum hole pass at 0.1524 mm. Its board-wide limits are now the board's own minimums (`kicadgen.fab_project_rules`, the `--fab` copy's project file) and only its layer and condition rules are copied, each raised to the board's own setting (M62).
- `kicadgen`'s via check holds two nets to the larger of their net classes' clearances, as KiCad's DRC does, not to the board default (M62).
- FreeRouting session coordinates are read at the scale the session's placement block implies, not the declared resolution.
- FreeRouting pinned to 1.9.0: 2.1.0 hangs after routing in proxied environments because its GitHub version check fails.
- `kicadgen`'s via check treats a non-plated hole as board edge, as the DRC does; island stitching had put a via 0.2 mm from a receptacle's peg hole (M26).
- Island stitching after routing keeps its vias out of keepouts; one keepout check (`Design.in_keepout`) now serves both via placers (M30).
- The router sees a non-plated hole grown to the board-edge clearance the DRC applies to it, not the hole clearance (M33).
- Island stitching runs once per poured net, not once per zone: a net with two zones got two vias on one spot (M37).
- A custom pad on the bottom face is mirrored with its shapes, not only its position; its size is read from its shapes, not its anchor (M38).
- The generator's pad boxes leave out paste-only apertures, and measure a round pad as a circle, not as its box.
### Security
