ThyFriendlyFox/via/examples/ring-mouse/v0.1/radio/signet_radio.kicad_pcb

## KiCad design examples/ring-mouse/v0.1/radio/signet_radio.kicad_pcb (2026-11-14, an earlier design)

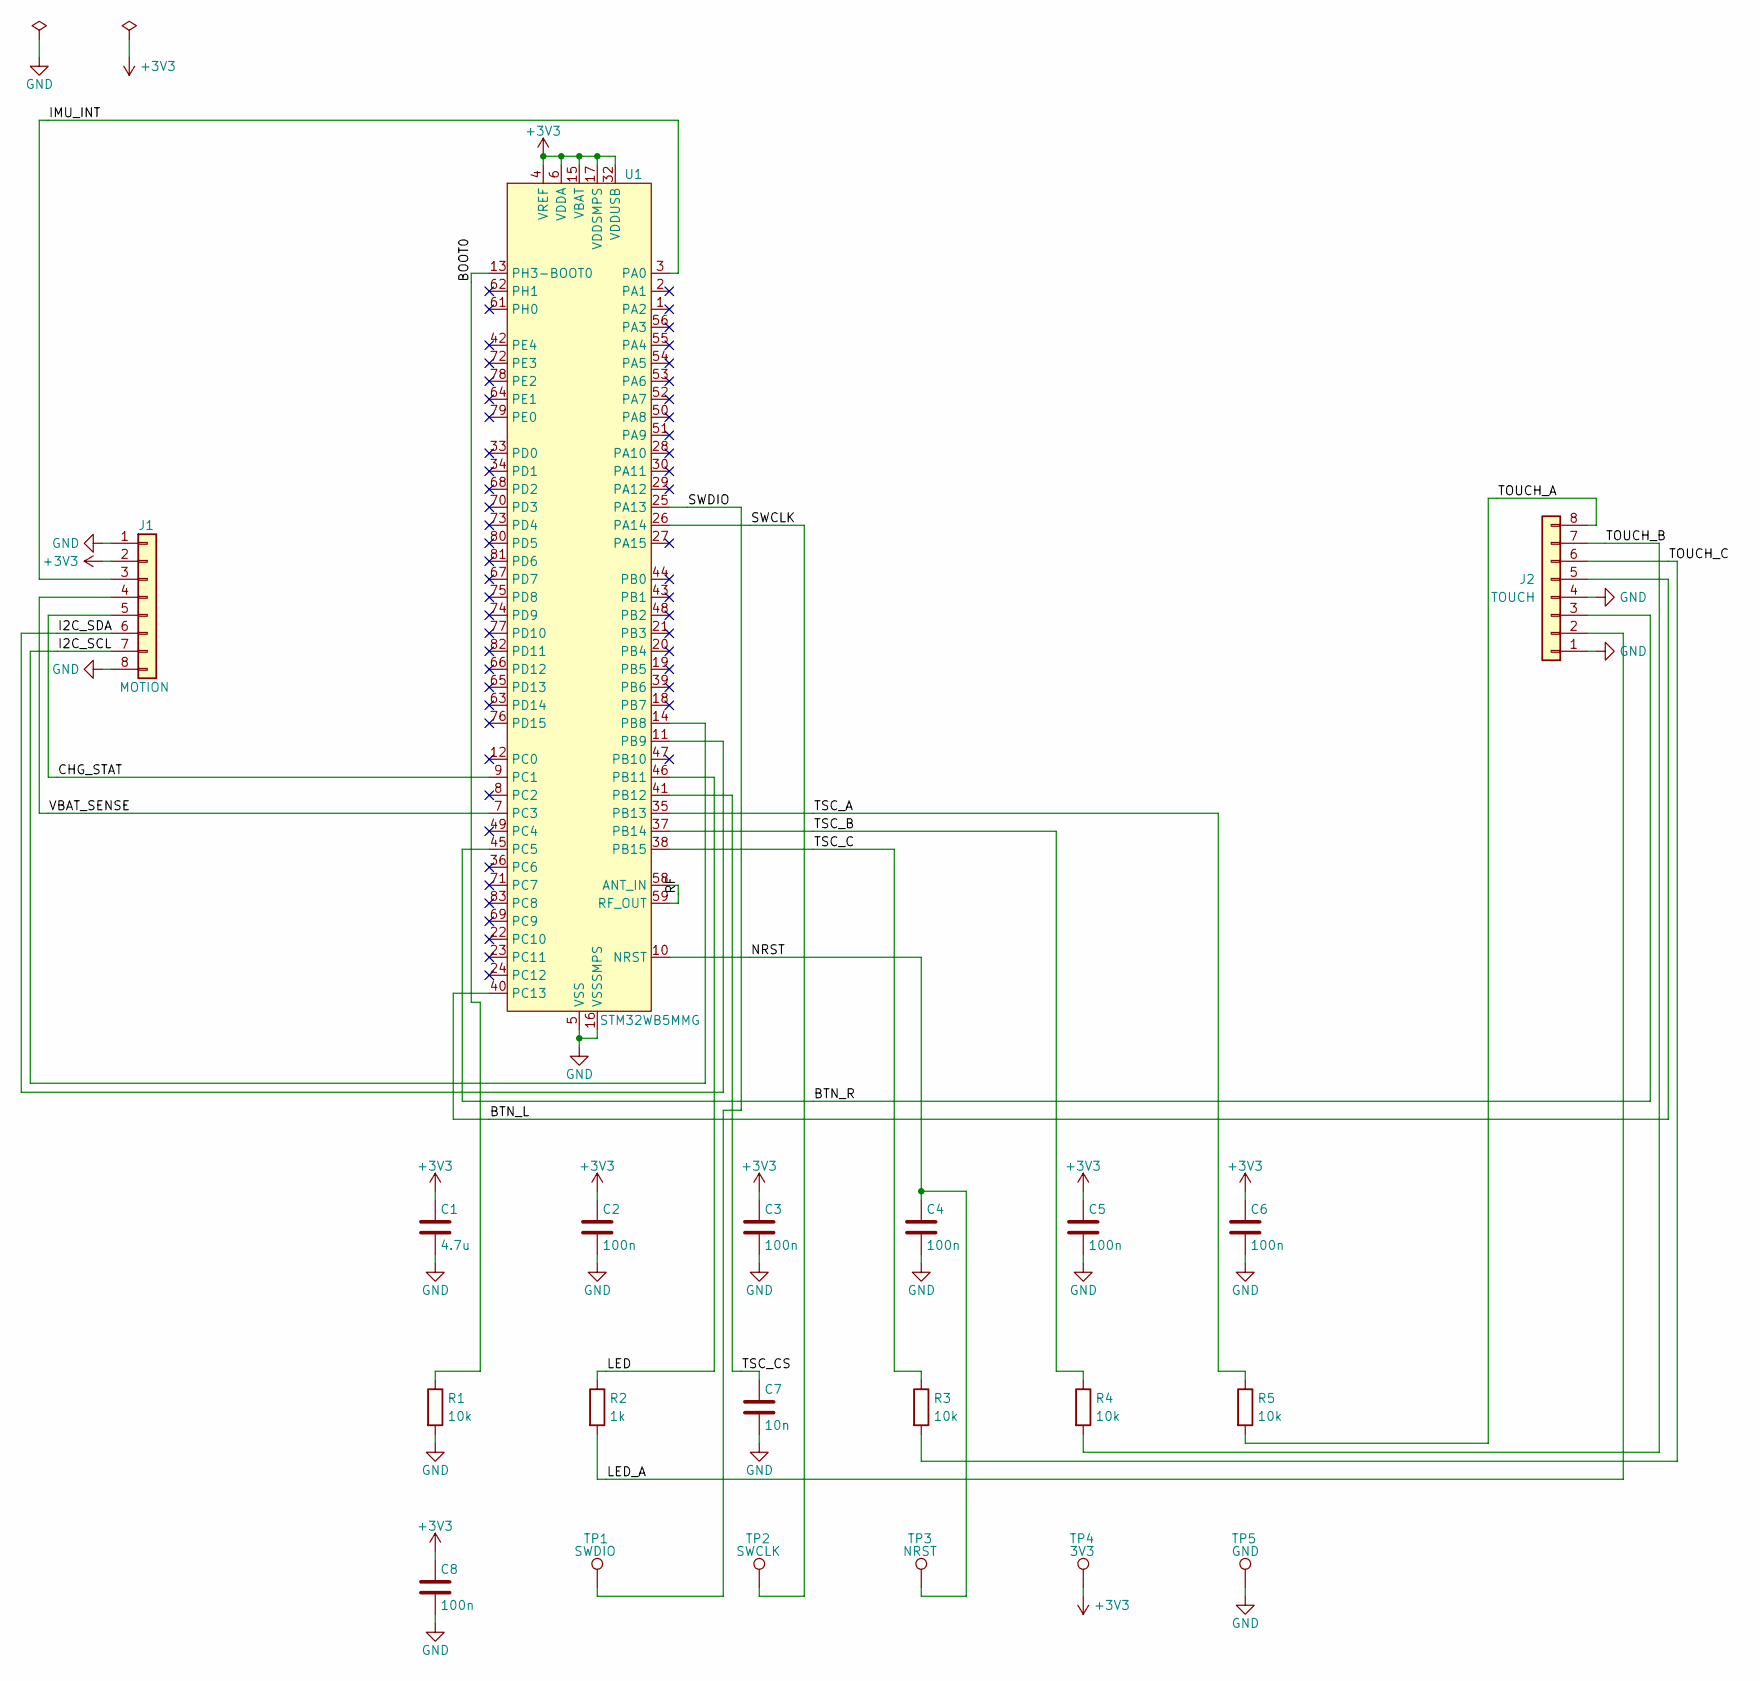
[picture p216: schematic signet_radio.kicad_sch]

Parts:
C1: 4.7u; C_0402_1005Metric
C2, C3, C4, C5, C6, C8: 100n; C_0402_1005Metric
C7: 10n; C_0402_1005Metric
J1: MOTION; Joint_Edge_1x08_P1.3mm
J2: TOUCH; Joint_Edge_1x08_P1.3mm
R1, R3, R4, R5: 10k; R_0402_1005Metric
R2: 1k; R_0402_1005Metric
TP1: SWDIO; TestPoint_Pad_D1.0mm
TP2: SWCLK; TestPoint_Pad_D1.0mm
TP3: NRST; TestPoint_Pad_D1.0mm
TP4: 3V3; TestPoint_Pad_D1.0mm
TP5: GND; TestPoint_Pad_D1.0mm
U1: STM32WB5MMG; ST-SiP-LGA-86-11x7.3mm

Connections:
+3V3: C1.1, C2.1, C3.1, C5.1, C6.1, C8.1, J1.2, TP4.1, U1.4 (VREF), U1.6 (VDDA), U1.15 (VBAT), U1.17 (VDDSMPS), U1.32 (VDDUSB)
/BOOT0: R1.1, U1.13 (PH3-BOOT0)
/BTN_L: J2.5, U1.40 (PC13)
/BTN_R: J2.3, U1.45 (PC5)
/CHG_STAT: J1.5, U1.9 (PC1)
/I2C_SCL: J1.7, U1.14 (PB8)
/I2C_SDA: J1.6, U1.11 (PB9)
/IMU_INT: J1.3, U1.3 (PA0)
/LED: R2.1, U1.46 (PB11)
/LED_A: J2.2, R2.2
/NRST: C4.1, TP3.1, U1.10 (NRST)
/RF: U1.58 (ANT_IN), U1.59 (RF_OUT)
/SWCLK: TP2.1, U1.26 (PA14)
/SWDIO: TP1.1, U1.25 (PA13)
/TOUCH_A: J2.8, R5.2
/TOUCH_B: J2.7, R4.2
/TOUCH_C: J2.6, R3.2
/TSC_A: R5.1, U1.35 (PB13)
/TSC_B: R4.1, U1.37 (PB14)
/TSC_C: R3.1, U1.38 (PB15)
/TSC_CS: C7.1, U1.41 (PB12)
/VBAT_SENSE: J1.4, U1.7 (PC3)
GND: C1.2, C2.2, C3.2, C4.2, C5.2, C6.2, C7.2, C8.2, J1.1, J1.8, J2.1, J2.4, R1.2, TP5.1, U1.5 (VSS), U1.16 (VSSSMPS), U1.31 (VSS), U1.57 (VSS), U1.60 (VSS), U1.84 (VSS), U1.86 (VSS)

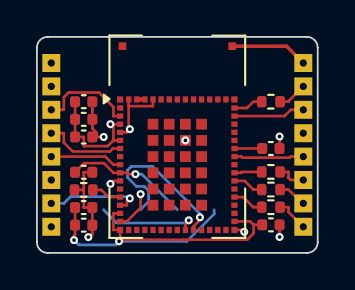
[picture p217: board signet_radio.kicad_pcb from above]

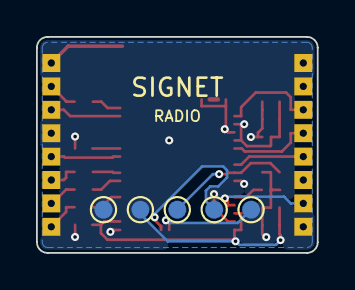
[picture p218: board signet_radio.kicad_pcb from below]

Board: 4 copper layers, 15.6 x 12.0 mm, 21 parts (5 on the bottom side), 23 nets.
