ThyFriendlyFox/via/examples/ring-mouse/v0.2/power/signet_power.kicad_pcb

## KiCad design examples/ring-mouse/v0.2/power/signet_power.kicad_pcb (2026-11-14, an earlier design)

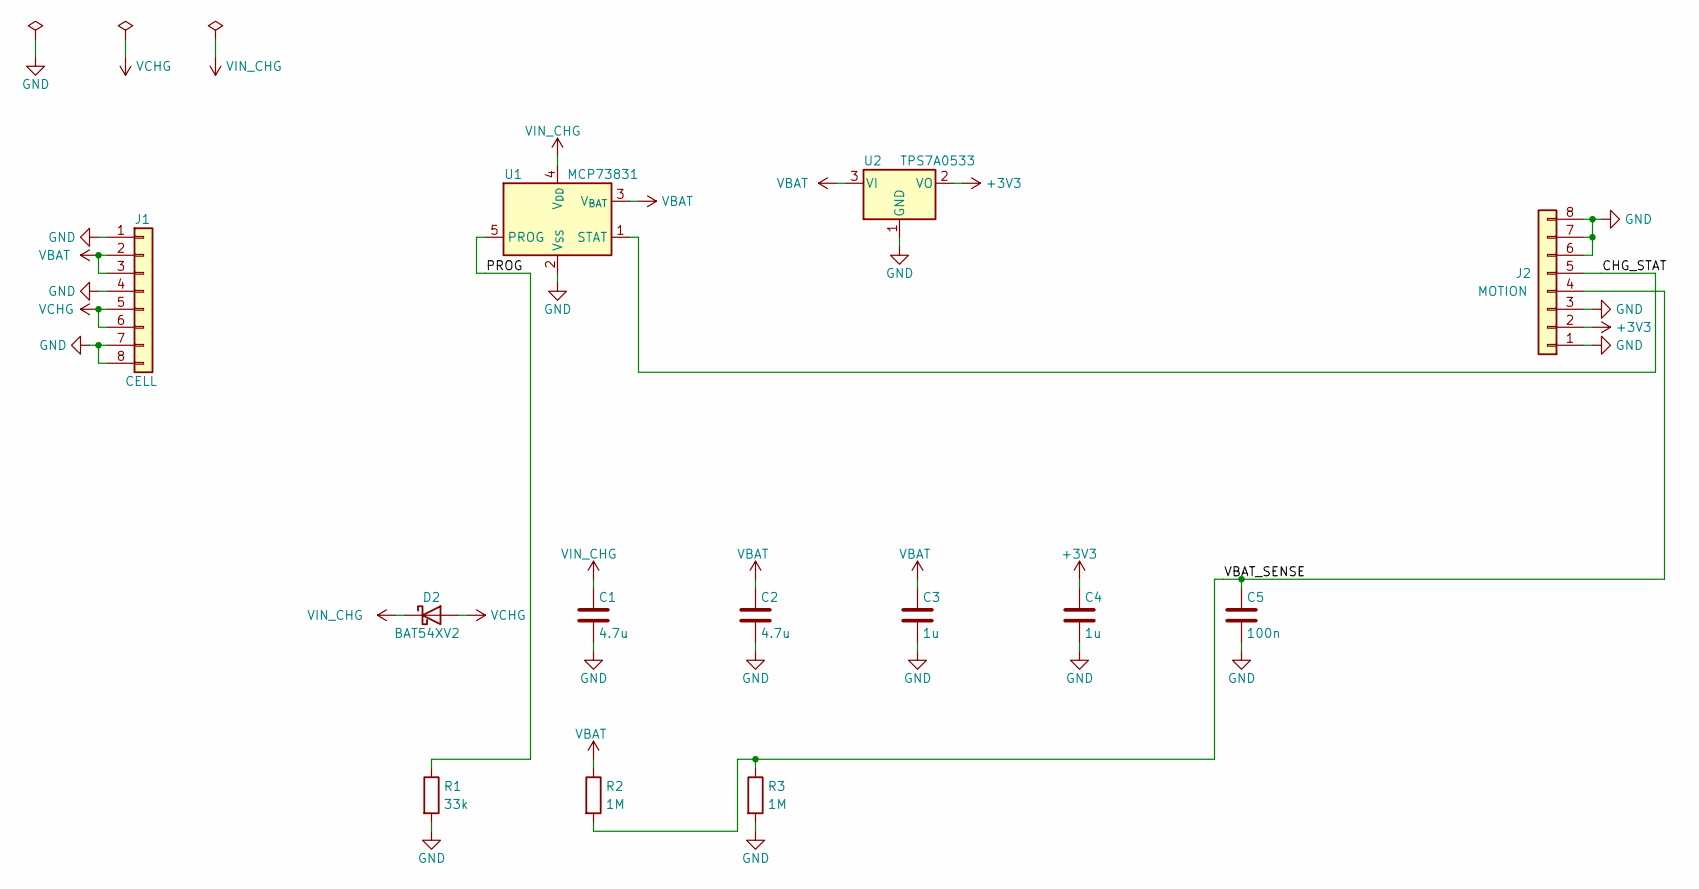
[picture p219: schematic signet_power.kicad_sch]

Parts:
C1, C2: 4.7u; C_0402_1005Metric
C3, C4: 1u; C_0402_1005Metric
C5: 100n; C_0402_1005Metric
D2: BAT54XV2; D_SOD-523
J1: CELL; Joint_Edge_1x08_P1.3mm
J2: MOTION; Joint_Edge_1x08_P1.3mm
R1: 33k; R_0402_1005Metric
R2, R3: 1M; R_0402_1005Metric
U1: MCP73831; SOT-23-5
U2: TPS7A0533; SOT-23-3

Connections:
+3V3: C4.1, J2.2, U2.2 (VO)
/CHG_STAT: J2.5, U1.1 (STAT)
/PROG: R1.1, U1.5 (PROG)
/VBAT_SENSE: C5.1, J2.4, R2.2, R3.1
GND: C1.2, C2.2, C3.2, C4.2, C5.2, J1.1, J1.4, J1.7, J1.8, J2.1, J2.3, J2.6, J2.7, J2.8, R1.2, R3.2, U1.2 (V_{SS}), U2.1 (GND)
VBAT: C2.1, C3.1, J1.2, J1.3, R2.1, U1.3 (V_{BAT}), U2.3 (VI)
VCHG: D2.2 (A), J1.5, J1.6
VIN_CHG: C1.1, D2.1 (K), U1.4 (V_{DD})

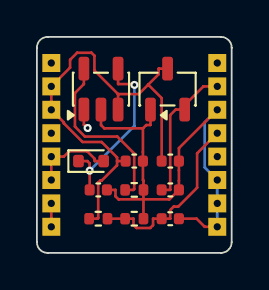
[picture p220: board signet_power.kicad_pcb from above]

Board: 4 copper layers, 10.8 x 12.0 mm, 13 parts (0 on the bottom side), 8 nets.
