ThyFriendlyFox/via/examples/ring-mouse/v0.1/clicks/signet_clicks.kicad_pcb

## KiCad design examples/ring-mouse/v0.1/clicks/signet_clicks.kicad_pcb (2026-11-14, an earlier design)

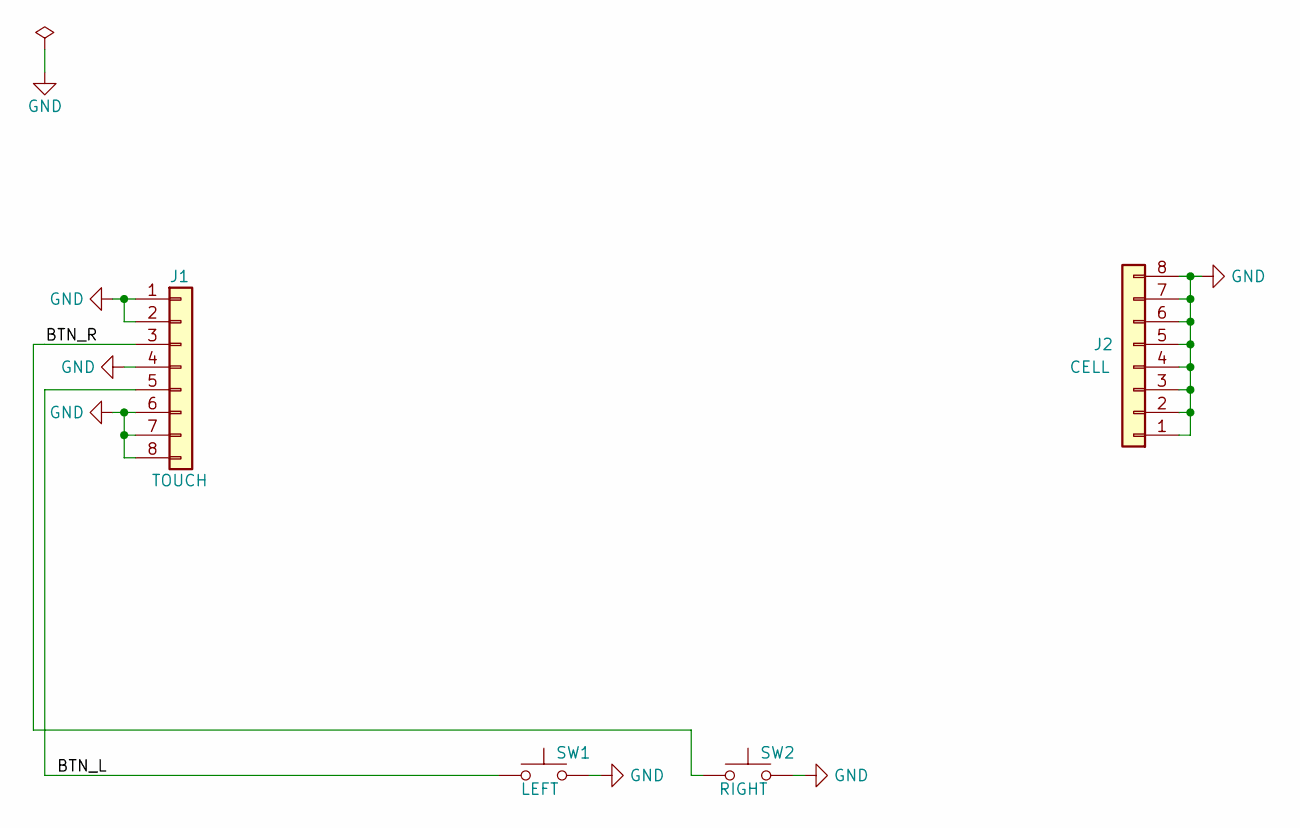
[picture p224: schematic signet_clicks.kicad_sch]

Parts:
J1: TOUCH; Joint_Edge_1x08_P1.3mm
J2: CELL; Joint_Edge_1x08_P1.3mm
SW1: LEFT; SW_Push_1P1T_NO_CK_KMR2
SW2: RIGHT; SW_Push_1P1T_NO_CK_KMR2

Connections:
/BTN_L: J1.5, SW1.1
/BTN_R: J1.3, SW2.1
GND: J1.1, J1.2, J1.4, J1.6, J1.7, J1.8, J2.1, J2.2, J2.3, J2.4, J2.5, J2.6, J2.7, J2.8, SW1.2, SW2.2

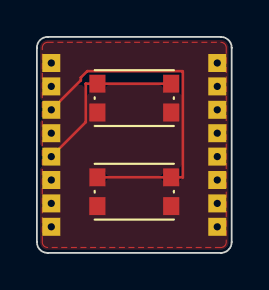
[picture p225: board signet_clicks.kicad_pcb from above]

Board: 2 copper layers, 10.8 x 12.0 mm, 4 parts (0 on the bottom side), 3 nets.
