ThyFriendlyFox/via/examples/snapdragon-dev-board/v0.2/wyvern.kicad_pcb

## KiCad design examples/snapdragon-dev-board/v0.2/wyvern.kicad_pcb (2026-11-14)

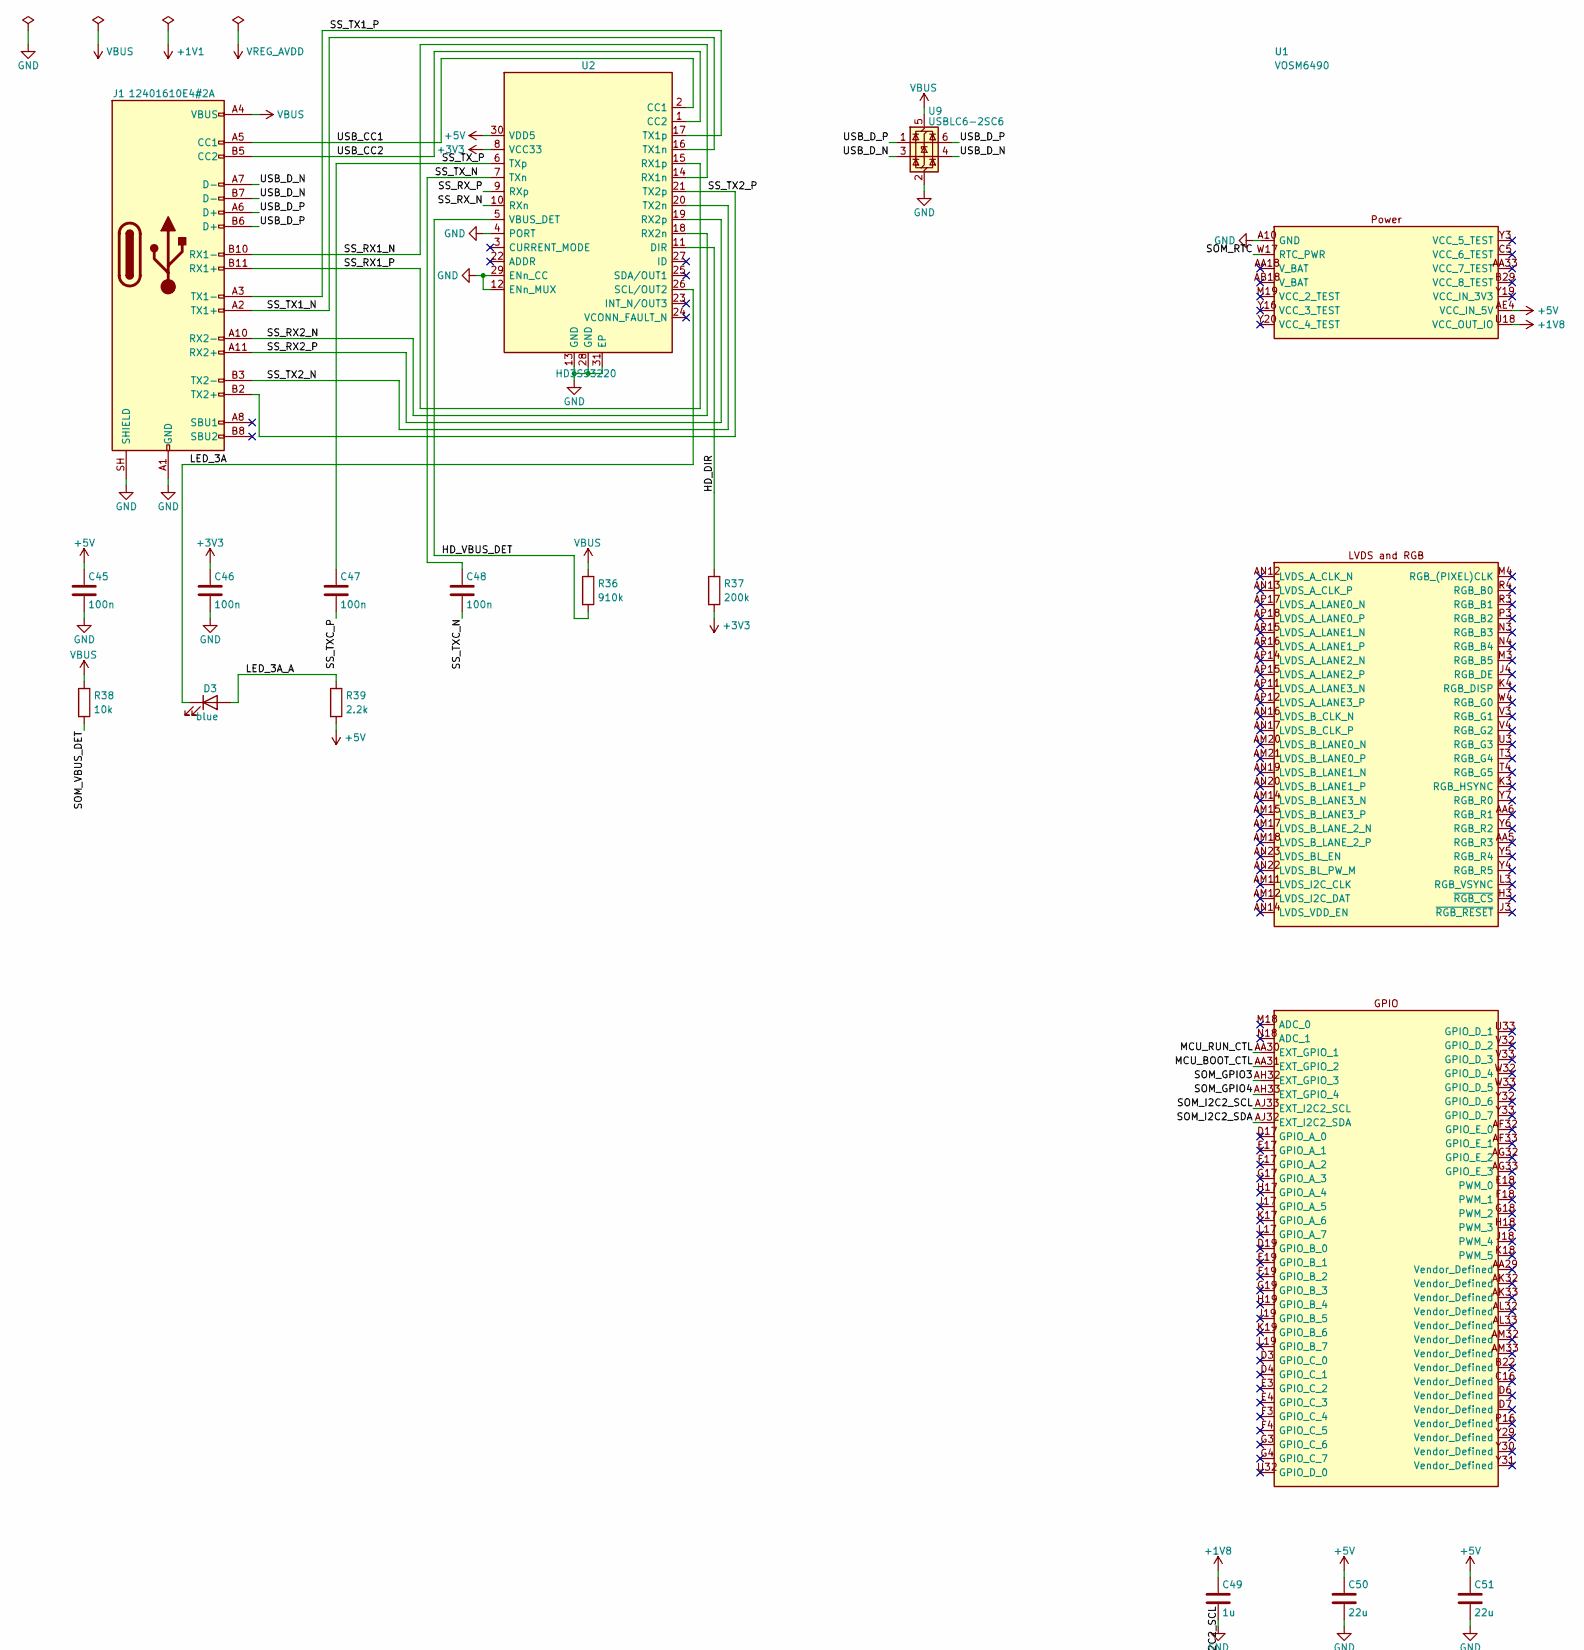
[picture p226: schematic wyvern.kicad_sch, part in row 1, column 1]

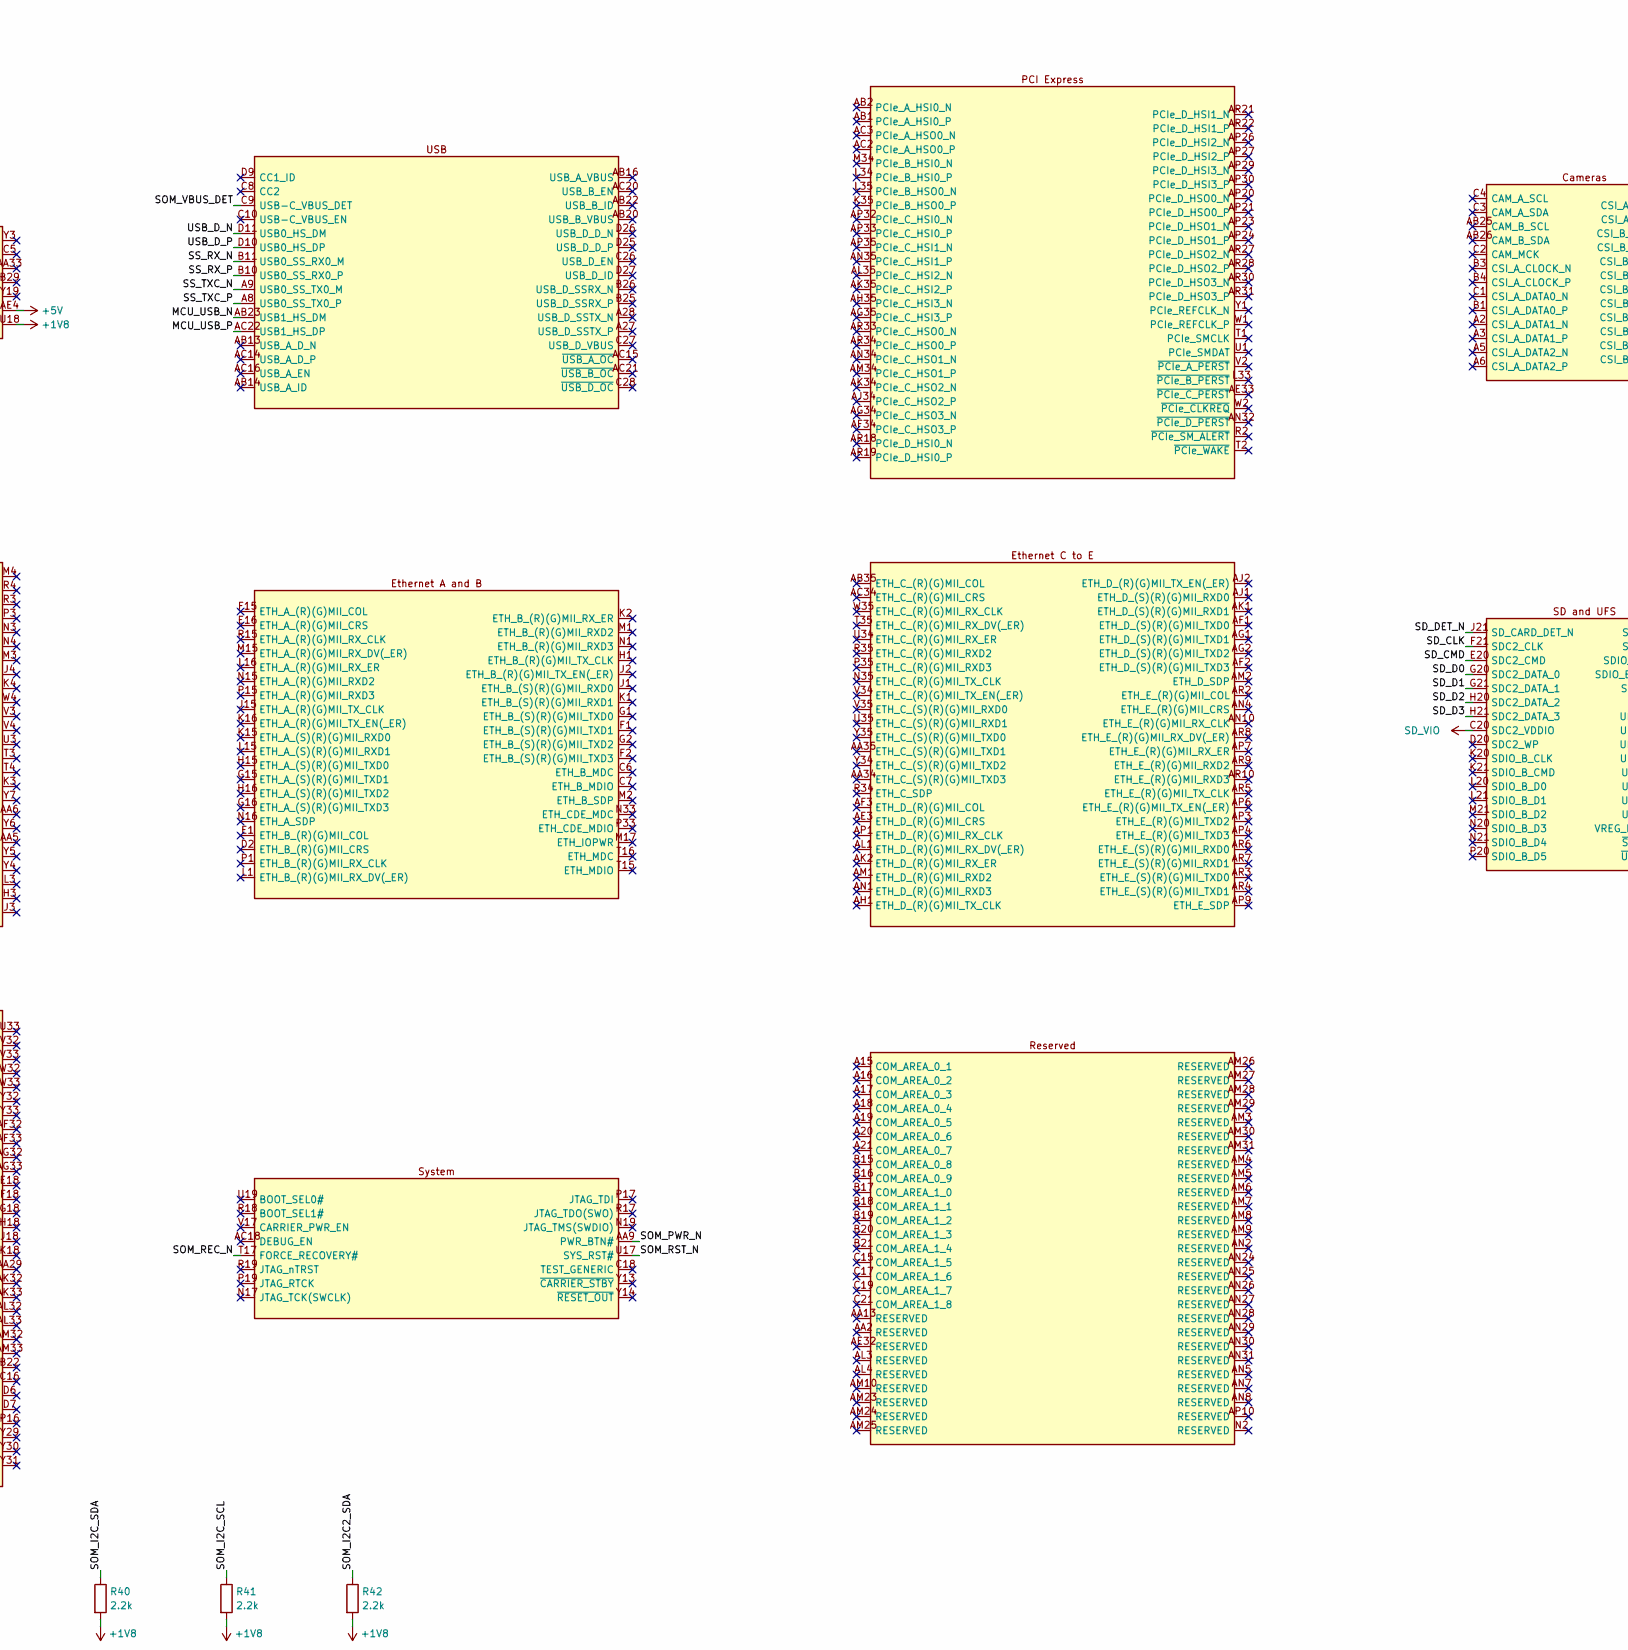
[picture p227: schematic wyvern.kicad_sch, part in row 1, column 2]

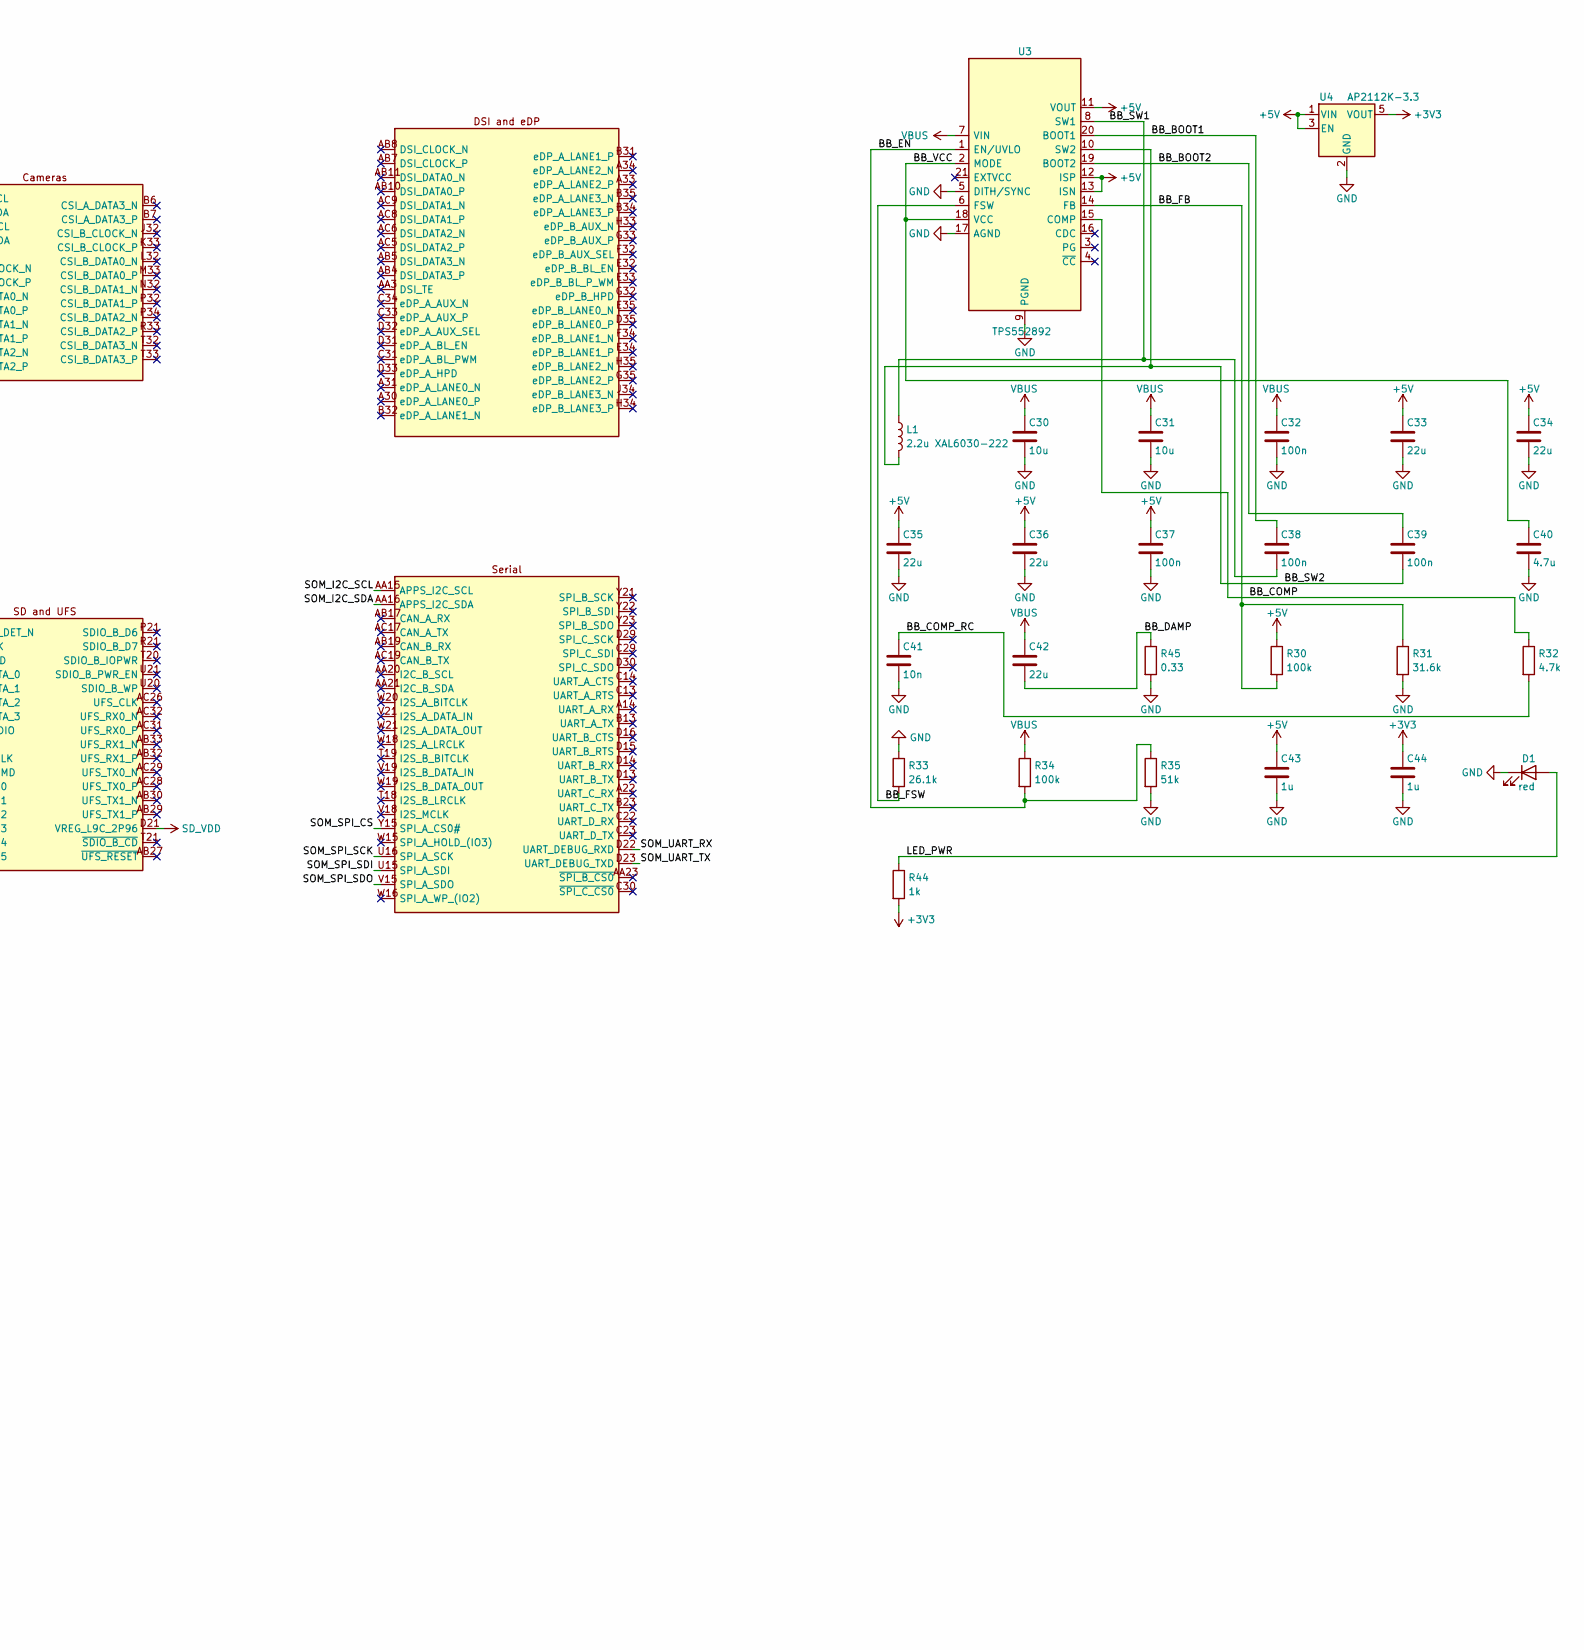
[picture p228: schematic wyvern.kicad_sch, part in row 1, column 3]

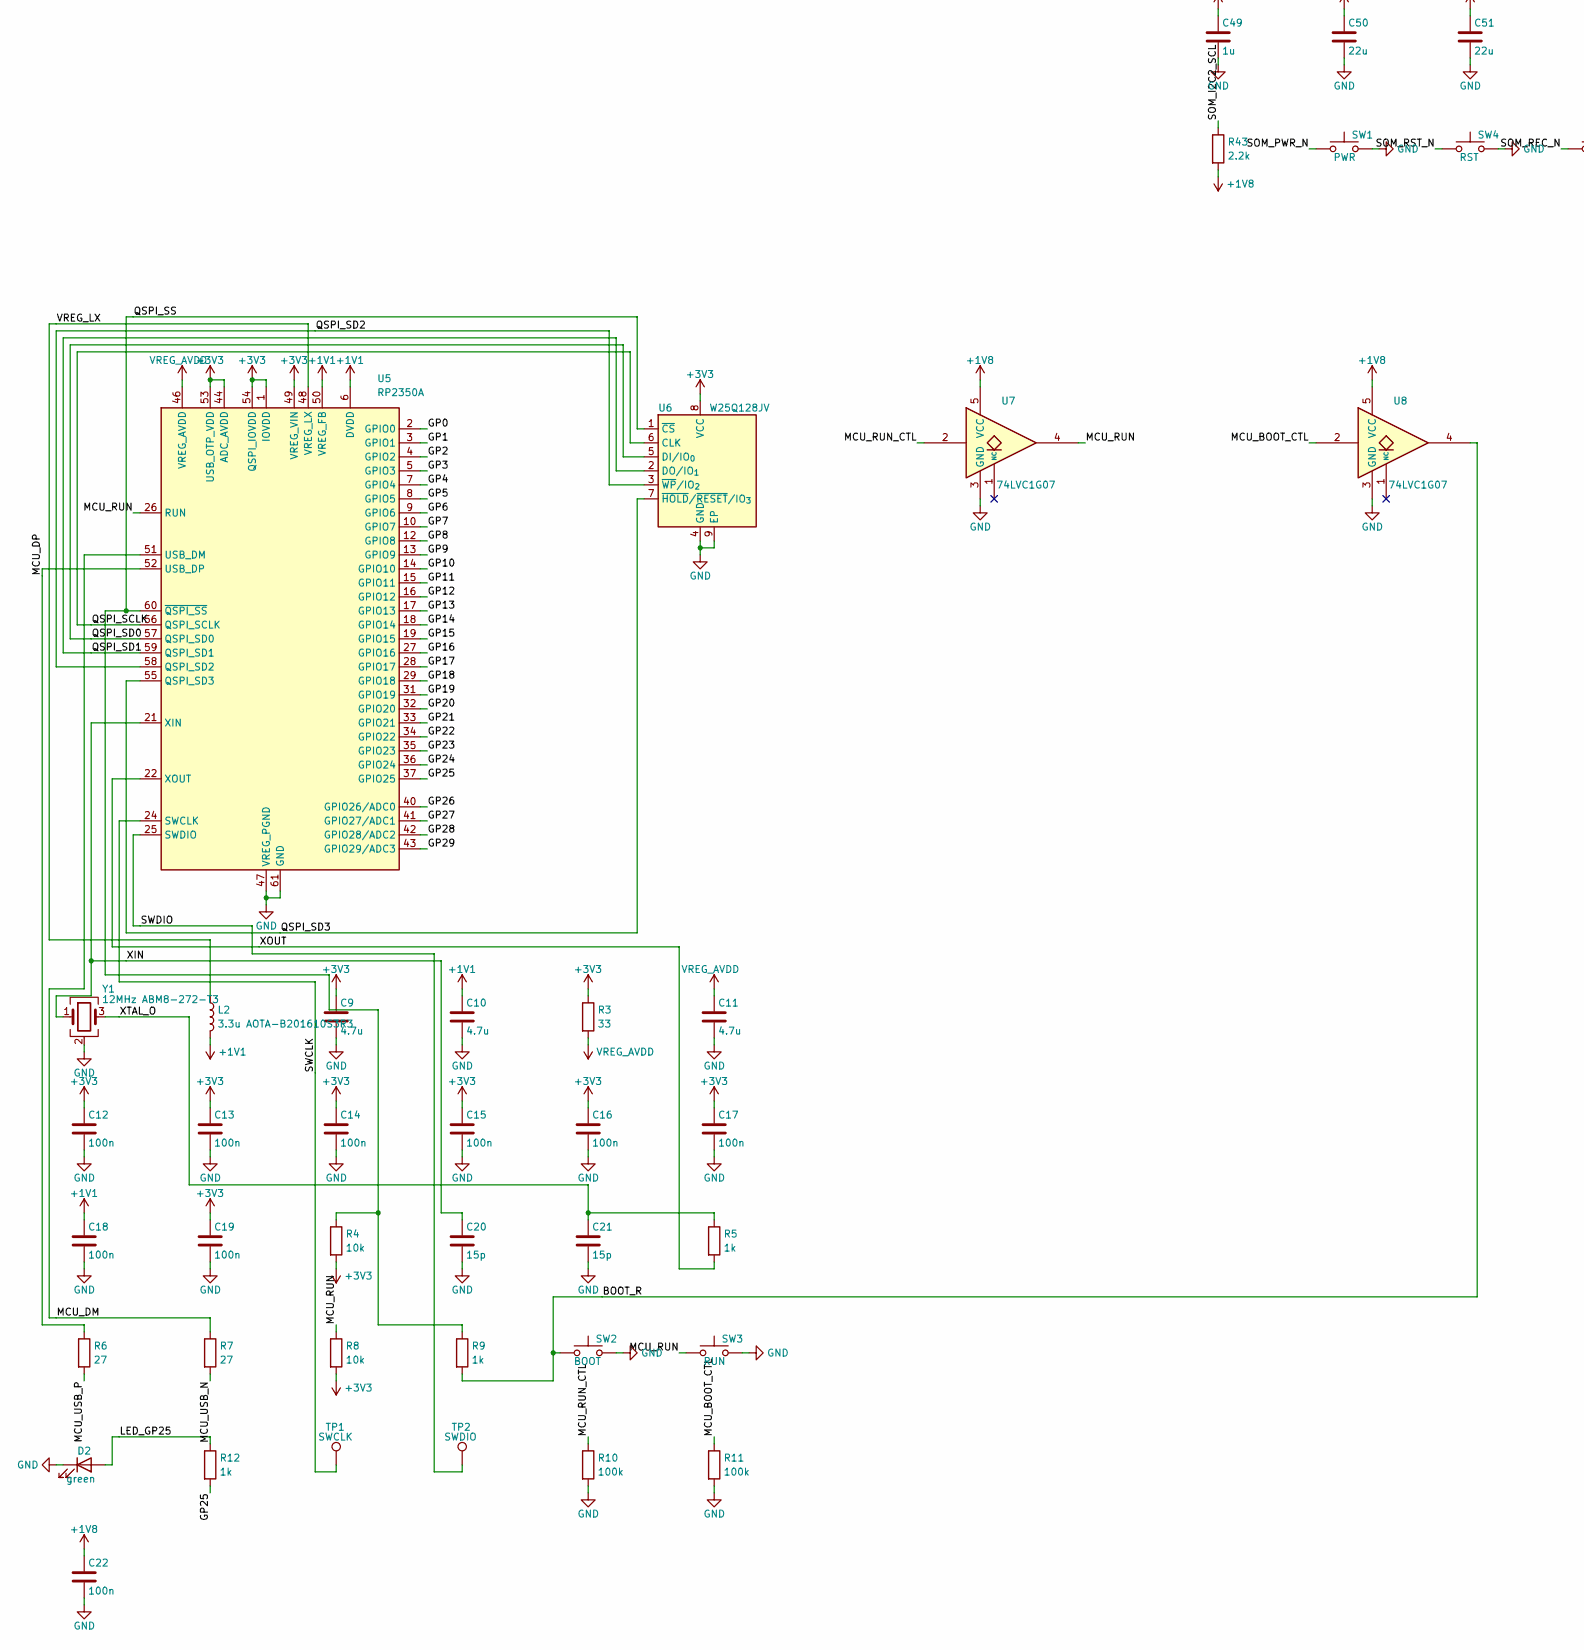
[picture p229: schematic wyvern.kicad_sch, part in row 2, column 1]

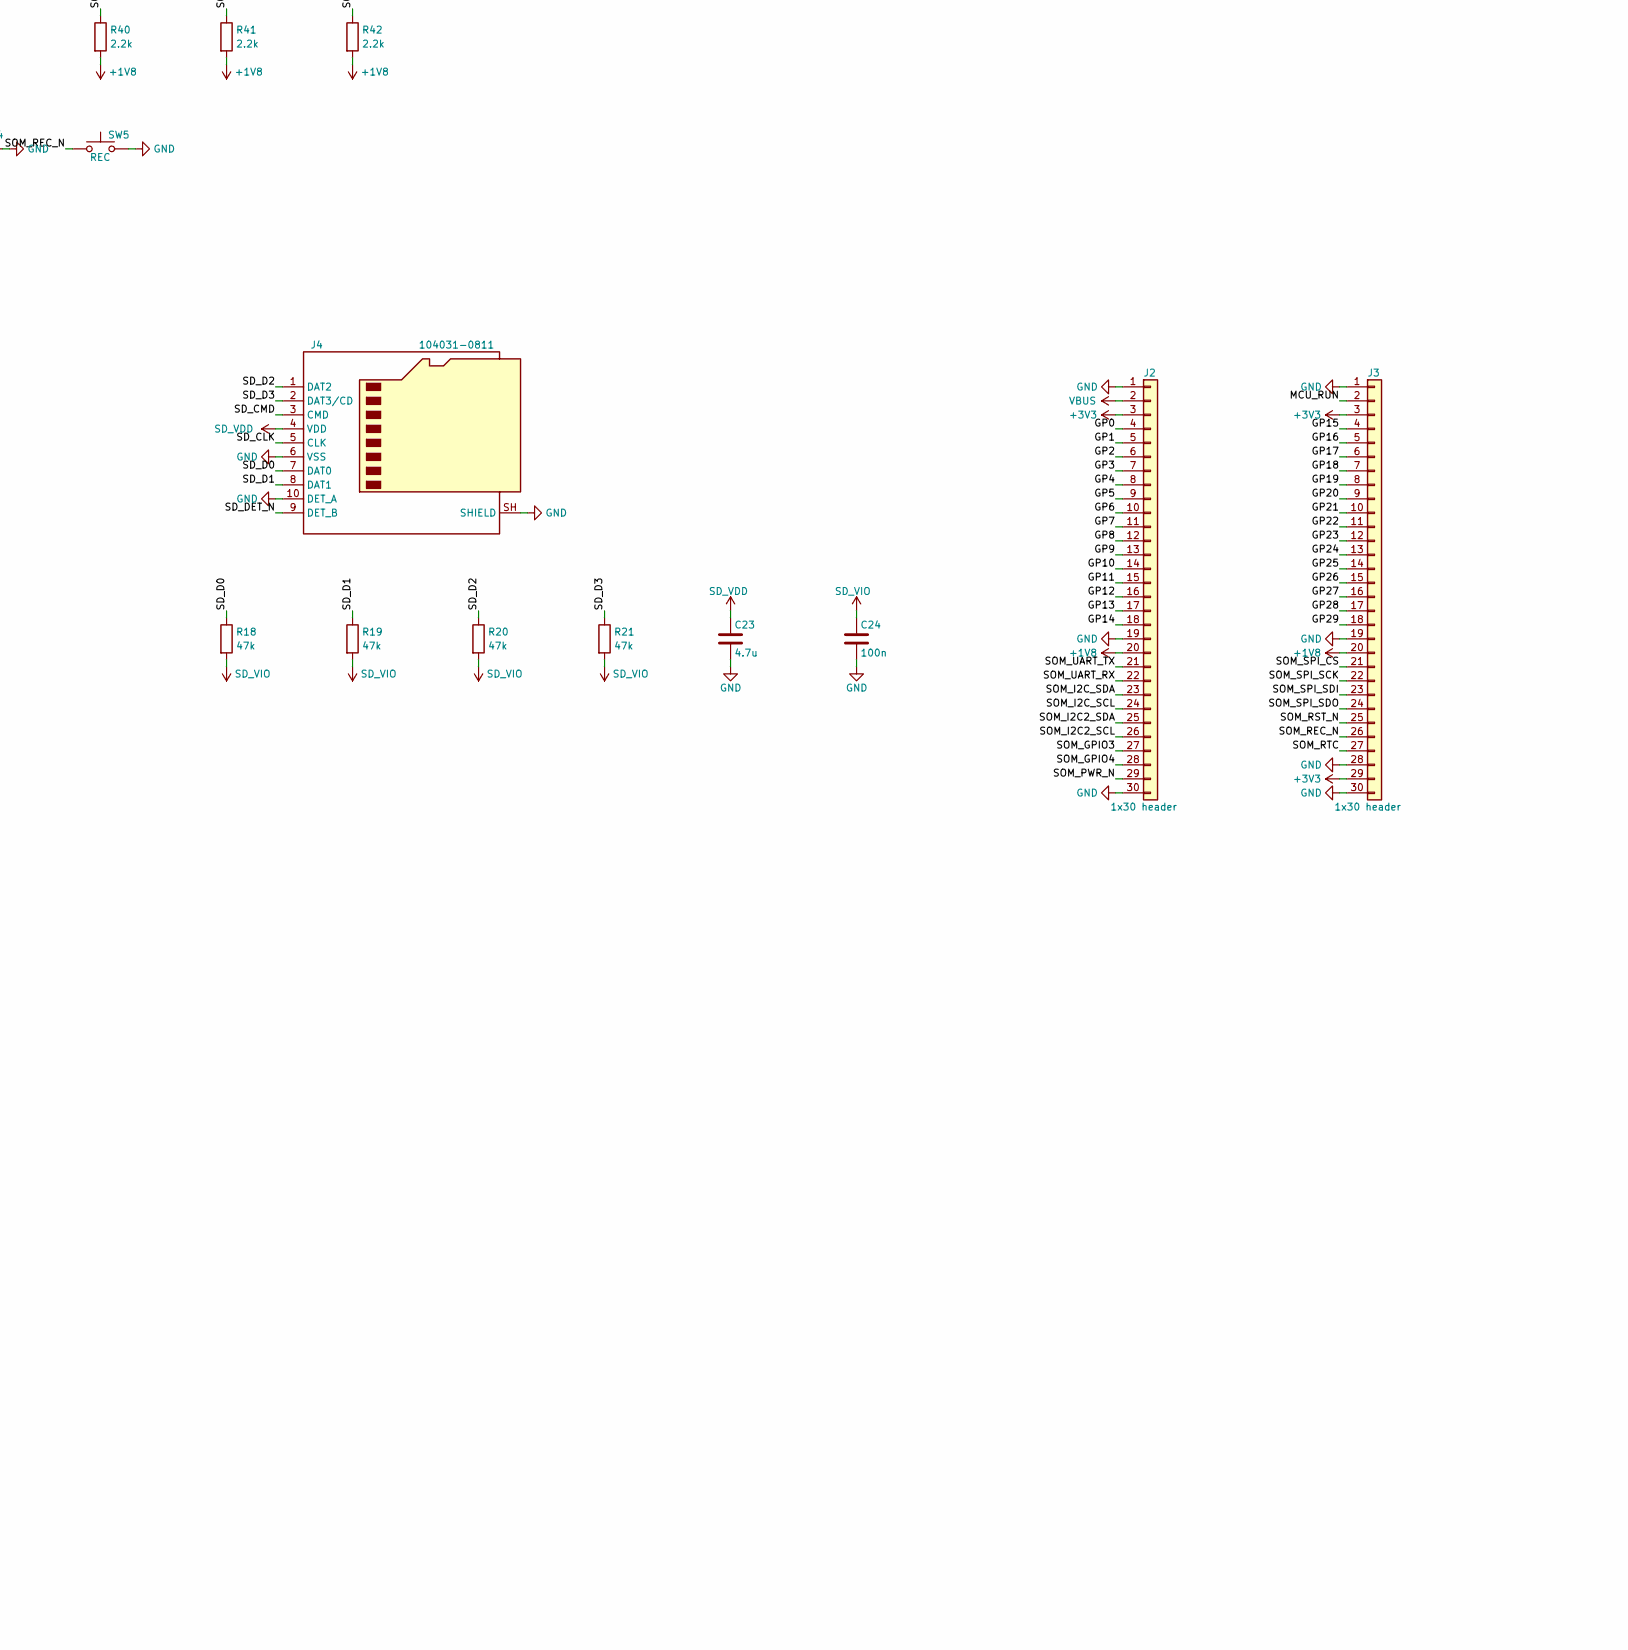
[picture p230: schematic wyvern.kicad_sch, part in row 2, column 2]

Parts:
C9, C10, C11, C40: 4.7u; C_0402_1005Metric
C12, C13, C14, C15, C16, C17, C18, C19, C22, C24, C32, C37, C38, C39, C45, C46, C47, C48: 100n; C_0402_1005Metric
C20, C21: 15p; C_0402_1005Metric
C23: 4.7u; C_0603_1608Metric
C30, C31: 10u; C_0805_2012Metric
C33, C34, C35, C36, C42, C50, C51: 22u; C_0805_2012Metric
C41: 10n; C_0402_1005Metric
C43, C44, C49: 1u; C_0402_1005Metric
D1: red; LED_0603_1608Metric
D2: green; LED_0603_1608Metric
D3: blue; LED_0603_1608Metric
J1: 12401610E4#2A; USB_C_Receptacle_Amphenol_12401610E4-2A_Ring6mil
J2, J3: 1x30 header; PinHeader_1x30_P2.54mm_Vertical
J4: 104031-0811; microSD_HC_Molex_104031-0811
L1: 2.2u XAL6030-222; L_Coilcraft_XAL6030-XXX
L2: 3.3u AOTA-B201610S3R3; L_Abracon_AOTA-B201610S
R3: 33; R_0402_1005Metric
R4, R8, R38: 10k; R_0402_1005Metric
R5, R9, R12, R44: 1k; R_0402_1005Metric
R6, R7: 27; R_0402_1005Metric
R10, R11, R30, R34: 100k; R_0402_1005Metric
R18, R19, R20, R21: 47k; R_0402_1005Metric
R31: 31.6k; R_0402_1005Metric
R32: 4.7k; R_0402_1005Metric
R33: 26.1k; R_0402_1005Metric
R35: 51k; R_0402_1005Metric
R36: 910k; R_0402_1005Metric
R37: 200k; R_0402_1005Metric
R39, R40, R41, R42, R43: 2.2k; R_0402_1005Metric
R45: 0.33; R_0402_1005Metric
SW1: PWR; SW_Push_1P1T_NO_CK_KMR2
SW2: BOOT; SW_Push_1P1T_NO_CK_KMR2
SW3: RUN; SW_Push_1P1T_NO_CK_KMR2
SW4: RST; SW_Push_1P1T_NO_CK_KMR2
SW5: REC; SW_Push_1P1T_NO_CK_KMR2
TP1: SWCLK; TestPoint_Pad_D1.0mm
TP2: SWDIO; TestPoint_Pad_D1.0mm
U1: VOSM6490; OSM_L_LGA-662_45x45mm_P1.25mm
U2: HD3SS3220; Texas_RNH0030A_WQFN-30-1EP_2.5x4.5mm_P0.4mm_EP1.2x3.2mm
U3: TPS552892; Texas_RYQ0021A_VQFN-HR-21_5x3mm_P0.5mm
U4: AP2112K-3.3; SOT-23-5
U5: RP2350A; QFN-60-1EP_7x7mm_P0.4mm_EP3.4x3.4mm
U6: W25Q128JV; WSON-8-1EP_6x5mm_P1.27mm_EP3.4x4.3mm
U7, U8: 74LVC1G07; SOT-353_SC-70-5
U9: USBLC6-2SC6; SOT-23-6
Y1: 12MHz ABM8-272-T3; Crystal_SMD_3225-4Pin_3.2x2.5mm

Connections:
+1V1: C10.1, C18.1, L2.2, U5.6 (DVDD), U5.23 (DVDD), U5.39 (DVDD), U5.50 (VREG_FB)
+1V8: C22.1, C49.1, J2.20, J3.20, R40.2, R41.2, R42.2, R43.2, U1.U18 (VCC_OUT_IO), U7.5 (VCC), U8.5 (VCC)
+3V3: C9.1, C12.1, C13.1, C14.1, C15.1, C16.1, C17.1, C19.1, C44.1, C46.1, J2.3, J3.3, J3.29, R3.1, R4.2, R8.2, R37.2, R44.2, U2.8 (VCC33), U4.5 (VOUT), U5.1 (IOVDD), U5.11 (IOVDD), U5.20 (IOVDD), U5.30 (IOVDD), U5.38 (IOVDD), U5.44 (ADC_AVDD), U5.45 (IOVDD), U5.49 (VREG_VIN), U5.53 (USB_OTP_VDD), U5.54 (QSPI_IOVDD), U6.8 (VCC)
+5V: C33.1, C34.1, C35.1, C36.1, C37.1, C43.1, C45.1, C50.1, C51.1, R30.1, R39.2, U1.AE4 (VCC_IN_5V), U1.AF4 (VCC_IN_5V), U1.AG4 (VCC_IN_5V), U1.AH3 (VCC_IN_5V), U1.AH4 (VCC_IN_5V), U1.AJ3 (VCC_IN_5V), U1.AJ4 (VCC_IN_5V), U1.AK4 (VCC_IN_5V), U1.Y8 (VCC_IN_5V), U1.Y9 (VCC_IN_5V), U1.Y10 (VCC_IN_5V), U1.Y11 (VCC_IN_5V), U1.Y17 (VCC_IN_5V), U1.Y25 (VCC_IN_5V), U1.Y26 (VCC_IN_5V), U1.Y27 (VCC_IN_5V), U1.Y28 (VCC_IN_5V), U2.30 (VDD5), U3.11 (VOUT), U3.12 (ISP), U3.13 (ISN), U4.1 (VIN), U4.3 (EN)
/BB_BOOT1: C38.1, U3.20 (BOOT1)
/BB_BOOT2: C39.1, U3.19 (BOOT2)
/BB_COMP: R32.1, U3.15 (COMP)
/BB_COMP_RC: C41.1, R32.2
/BB_DAMP: C42.2, R45.1
/BB_EN: R34.2, R35.1, U3.1 (EN/UVLO)
/BB_FB: R30.2, R31.1, U3.14 (FB)
/BB_FSW: R33.2, U3.6 (FSW)
/BB_SW1: C38.2, L1.1, U3.8 (SW1)
/BB_SW2: C39.2, L1.2, U3.10 (SW2)
/BB_VCC: C40.1, U3.2 (MODE), U3.18 (VCC)
/BOOT_R: R9.2, SW2.1, U8.4
/GP0: J2.4, U5.2 (GPIO0)
/GP1: J2.5, U5.3 (GPIO1)
/GP2: J2.6, U5.4 (GPIO2)
/GP3: J2.7, U5.5 (GPIO3)
/GP4: J2.8, U5.7 (GPIO4)
/GP5: J2.9, U5.8 (GPIO5)
/GP6: J2.10, U5.9 (GPIO6)
/GP7: J2.11, U5.10 (GPIO7)
/GP8: J2.12, U5.12 (GPIO8)
/GP9: J2.13, U5.13 (GPIO9)
/GP10: J2.14, U5.14 (GPIO10)
/GP11: J2.15, U5.15 (GPIO11)
/GP12: J2.16, U5.16 (GPIO12)
/GP13: J2.17, U5.17 (GPIO13)
/GP14: J2.18, U5.18 (GPIO14)
/GP15: J3.4, U5.19 (GPIO15)
/GP16: J3.5, U5.27 (GPIO16)
/GP17: J3.6, U5.28 (GPIO17)
/GP18: J3.7, U5.29 (GPIO18)
/GP19: J3.8, U5.31 (GPIO19)
/GP20: J3.9, U5.32 (GPIO20)
/GP21: J3.10, U5.33 (GPIO21)
/GP22: J3.11, U5.34 (GPIO22)
/GP23: J3.12, U5.35 (GPIO23)
/GP24: J3.13, U5.36 (GPIO24)
/GP25: J3.14, R12.2, U5.37 (GPIO25)
/GP26: J3.15, U5.40 (GPIO26/ADC0)
/GP27: J3.16, U5.41 (GPIO27/ADC1)
/GP28: J3.17, U5.42 (GPIO28/ADC2)
/GP29: J3.18, U5.43 (GPIO29/ADC3)
/HD_DIR: R37.1, U2.11 (DIR)
/HD_VBUS_DET: R36.2, U2.5 (VBUS_DET)
/LED_3A: D3.1 (K), U2.26 (SCL/OUT2)
/LED_3A_A: D3.2 (A), R39.1
/LED_GP25: D2.2 (A), R12.1
/LED_PWR: D1.2 (A), R44.1
/MCU_BOOT_CTL: R11.1, U1.AA31 (EXT_GPIO_2), U8.2
/MCU_DM: R7.1, U5.51 (USB_DM)
/MCU_DP: R6.1, U5.52 (USB_DP)
/MCU_RUN: J3.2, R8.1, SW3.1, U5.26 (RUN), U7.4
/MCU_RUN_CTL: R10.1, U1.AA30 (EXT_GPIO_1), U7.2
/MCU_USB_N: R7.2, U1.AB23 (USB1_HS_DM)
/MCU_USB_P: R6.2, U1.AC22 (USB1_HS_DP)
/QSPI_SCLK: U5.56 (QSPI_SCLK), U6.6 (CLK)
/QSPI_SD0: U5.57 (QSPI_SD0), U6.5 (DI/IO_{0})
/QSPI_SD1: U5.59 (QSPI_SD1), U6.2 (DO/IO_{1})
/QSPI_SD2: U5.58 (QSPI_SD2), U6.3 (~WP/IO_{2})
/QSPI_SD3: U5.55 (QSPI_SD3), U6.7 (~HOLD/~RESET/IO_{3})
/QSPI_SS: R4.1, R9.1, U5.60 (~QSPI_SS), U6.1 (~CS)
/SD_CLK: J4.5 (CLK), U1.F21 (SDC2_CLK)
/SD_CMD: J4.3 (CMD), U1.E20 (SDC2_CMD)
/SD_D0: J4.7 (DAT0), R18.1, U1.G20 (SDC2_DATA_0)
/SD_D1: J4.8 (DAT1), R19.1, U1.G21 (SDC2_DATA_1)
/SD_D2: J4.1 (DAT2), R20.1, U1.H20 (SDC2_DATA_2)
/SD_D3: J4.2 (DAT3/CD), R21.1, U1.H21 (SDC2_DATA_3)
/SD_DET_N: J4.9 (DET_B), U1.J21 (SD_CARD_DET_N)
/SOM_GPIO3: J2.27, U1.AH32 (EXT_GPIO_3)
/SOM_GPIO4: J2.28, U1.AH33 (EXT_GPIO_4)
/SOM_I2C2_SCL: J2.26, R43.1, U1.AJ33 (EXT_I2C2_SCL)
/SOM_I2C2_SDA: J2.25, R42.1, U1.AJ32 (EXT_I2C2_SDA)
/SOM_I2C_SCL: J2.24, R41.1, U1.AA15 (APPS_I2C_SCL)
/SOM_I2C_SDA: J2.23, R40.1, U1.AA16 (APPS_I2C_SDA)
/SOM_PWR_N: J2.29, SW1.1, U1.AA9 (PWR_BTN#)
/SOM_REC_N: J3.26, SW5.1, U1.T17 (FORCE_RECOVERY#)
/SOM_RST_N: J3.25, SW4.1, U1.U17 (SYS_RST#)
/SOM_RTC: J3.27, U1.W17 (RTC_PWR)
/SOM_SPI_CS: J3.21, U1.Y15 (SPI_A_CS0#)
/SOM_SPI_SCK: J3.22, U1.U16 (SPI_A_SCK)
/SOM_SPI_SDI: J3.23, U1.U15 (SPI_A_SDI)
/SOM_SPI_SDO: J3.24, U1.V15 (SPI_A_SDO)
/SOM_UART_RX: J2.22, U1.D22 (UART_DEBUG_RXD)
/SOM_UART_TX: J2.21, U1.D23 (UART_DEBUG_TXD)
/SOM_VBUS_DET: R38.2, U1.C9 (USB-C_VBUS_DET)
/SS_RX1_N: J1.B10 (RX1-), U2.14 (RX1n)
/SS_RX1_P: J1.B11 (RX1+), U2.15 (RX1p)
/SS_RX2_N: J1.A10 (RX2-), U2.18 (RX2n)
/SS_RX2_P: J1.A11 (RX2+), U2.19 (RX2p)
/SS_RX_N: U1.B11 (USB0_SS_RX0_M), U2.10 (RXn)
/SS_RX_P: U1.B10 (USB0_SS_RX0_P), U2.9 (RXp)
/SS_TX1_N: J1.A2 (TX1+), U2.16 (TX1n)
/SS_TX1_P: J1.A3 (TX1-), U2.17 (TX1p)
/SS_TX2_N: J1.B3 (TX2-), U2.20 (TX2n)
/SS_TX2_P: J1.B2 (TX2+), U2.21 (TX2p)
/SS_TXC_N: C48.2, U1.A9 (USB0_SS_TX0_M)
/SS_TXC_P: C47.2, U1.A8 (USB0_SS_TX0_P)
/SS_TX_N: C48.1, U2.7 (TXn)
/SS_TX_P: C47.1, U2.6 (TXp)
/SWCLK: TP1.1, U5.24 (SWCLK)
/SWDIO: TP2.1, U5.25 (SWDIO)
/USB_CC1: J1.A5 (CC1), U2.2 (CC1)
/USB_CC2: J1.B5 (CC2), U2.1 (CC2)
/USB_D_N: J1.A7 (D-), J1.B7 (D-), U1.D11 (USB0_HS_DM), U9.3 (I/O2), U9.4 (I/O2)
/USB_D_P: J1.A6 (D+), J1.B6 (D+), U1.D10 (USB0_HS_DP), U9.1 (I/O1), U9.6 (I/O1)
/VREG_LX: L2.1, U5.48 (VREG_LX)
/XIN: C20.1, U5.21 (XIN), Y1.1
/XOUT: R5.2, U5.22 (XOUT)
/XTAL_O: C21.1, R5.1, Y1.3
GND: C9.2, C10.2, C11.2, C12.2, C13.2, C14.2, C15.2, C16.2, C17.2, C18.2, C19.2, C20.2, C21.2, C22.2, C23.2, C24.2, C30.2, C31.2, C32.2, C33.2, C34.2, C35.2, C36.2, C37.2, C40.2, C41.2, C43.2, C44.2, C45.2, C46.2, C49.2, C50.2, C51.2, D1.1 (K), D2.1 (K), J1.A1 (GND), J1.A12 (GND), J1.B1 (GND), J1.B12 (GND), J1.SH (SHIELD), J2.1, J2.19, J2.30, J3.1, J3.19, J3.28, J3.30, J4.6 (VSS), J4.10 (DET_A), J4.SH (SHIELD), R10.2, R11.2, R31.2, R33.1, R35.2, R45.2, SW1.2, SW2.2, SW3.2, SW4.2, SW5.2, U1.A4 (GND), U1.A7 (GND), U1.A10 (GND), U1.A26 (GND), U1.A29 (GND), U1.A32 (GND), U1.AA1 (GND), U1.AA4 (GND), U1.AA7 (GND), U1.AA8 (GND), U1.AA10 (GND), U1.AA11 (GND), U1.AA14 (GND), U1.AA17 (GND), U1.AA19 (GND), U1.AA22 (GND), U1.AA25 (GND), U1.AA26 (GND), U1.AA27 (GND), U1.AA28 (GND), U1.AA32 (GND), U1.AB3 (GND), U1.AB6 (GND), U1.AB9 (GND), U1.AB15 (GND), U1.AB21 (GND), U1.AB28 (GND), U1.AB31 (GND), U1.AB34 (GND), U1.AC4 (GND), U1.AC7 (GND), U1.AC10 (GND), U1.AC27 (GND), U1.AC30 (GND), U1.AC33 (GND), U1.AE2 (GND), U1.AE34 (GND), U1.AF35 (GND), U1.AG3 (GND), U1.AH2 (GND), U1.AH34 (GND), U1.AJ35 (GND), U1.AK3 (GND), U1.AL2 (GND), U1.AL34 (GND), U1.AM13 (GND), U1.AM16 (GND), U1.AM19 (GND), U1.AM22 (GND), U1.AM35 (GND), U1.AN3 (GND), U1.AN6 (GND), U1.AN9 (GND), U1.AN11 (GND), U1.AN15 (GND), U1.AN18 (GND), U1.AN21 (GND), U1.AN33 (GND), U1.AP2 (GND), U1.AP5 (GND), U1.AP8 (GND), U1.AP13 (GND), U1.AP16 (GND), U1.AP19 (GND), U1.AP22 (GND), U1.AP25 (GND), U1.AP28 (GND), U1.AP31 (GND), U1.AP34 (GND), U1.AR14 (GND), U1.AR17 (GND), U1.AR20 (GND), U1.AR26 (GND), U1.AR29 (GND), U1.AR32 (GND), U1.B2 (GND), U1.B5 (GND), U1.B8 (GND), U1.B9 (GND), U1.B27 (GND), U1.B28 (GND), U1.B30 (GND), U1.B33 (GND), U1.C11 (GND), U1.C25 (GND), U1.C32 (GND), U1.C35 (GND), U1.D1 (GND), U1.D5 (GND), U1.D8 (GND), U1.D18 (GND), U1.D28 (GND), U1.D34 (GND), U1.E2 (GND), U1.E15 (GND), U1.E21 (GND), U1.F16 (GND), U1.F20 (GND), U1.F33 (GND), U1.F35 (GND), U1.G34 (GND), U1.H2 (GND), U1.H4 (GND), U1.H32 (GND), U1.J16 (GND), U1.J20 (GND), U1.J33 (GND), U1.J35 (GND), U1.K32 (GND), U1.K34 (GND), U1.L2 (GND), U1.L4 (GND), U1.L18 (GND), U1.M16 (GND), U1.M20 (GND), U1.M32 (GND), U1.M35 (GND), U1.N34 (GND), U1.P2 (GND), U1.P4 (GND), U1.P18 (GND), U1.R1 (GND), U1.R16 (GND), U1.R20 (GND), U1.R32 (GND), U1.T34 (GND), U1.U2 (GND), U1.U4 (GND), U1.V1 (GND), U1.V16 (GND), U1.V20 (GND), U1.W3 (GND), U1.W34 (GND), U1.Y2 (GND), U1.Y18 (GND), U2.4 (PORT), U2.12 (ENn_MUX), U2.13 (GND), U2.28 (GND), U2.29 (ENn_CC), U2.31 (EP), U3.5 (DITH/SYNC), U3.9 (PGND), U3.17 (AGND), U4.2 (GND), U5.47 (VREG_PGND), U5.61 (GND), U6.4 (GND), U6.9 (EP), U7.3 (GND), U8.3 (GND), U9.2 (GND), Y1.2 (G), Y1.4 (G)
SD_VDD: C23.1, J4.4 (VDD), U1.D21 (VREG_L9C_2P96)
SD_VIO: C24.1, R18.2, R19.2, R20.2, R21.2, U1.C20 (SDC2_VDDIO)
VBUS: C30.1, C31.1, C32.1, C42.1, J1.A4 (VBUS), J1.A9 (VBUS), J1.B4 (VBUS), J1.B9 (VBUS), J2.2, R34.1, R36.1, R38.1, U3.7 (VIN), U9.5 (VBUS)
VREG_AVDD: C11.1, R3.2, U5.46 (VREG_AVDD)

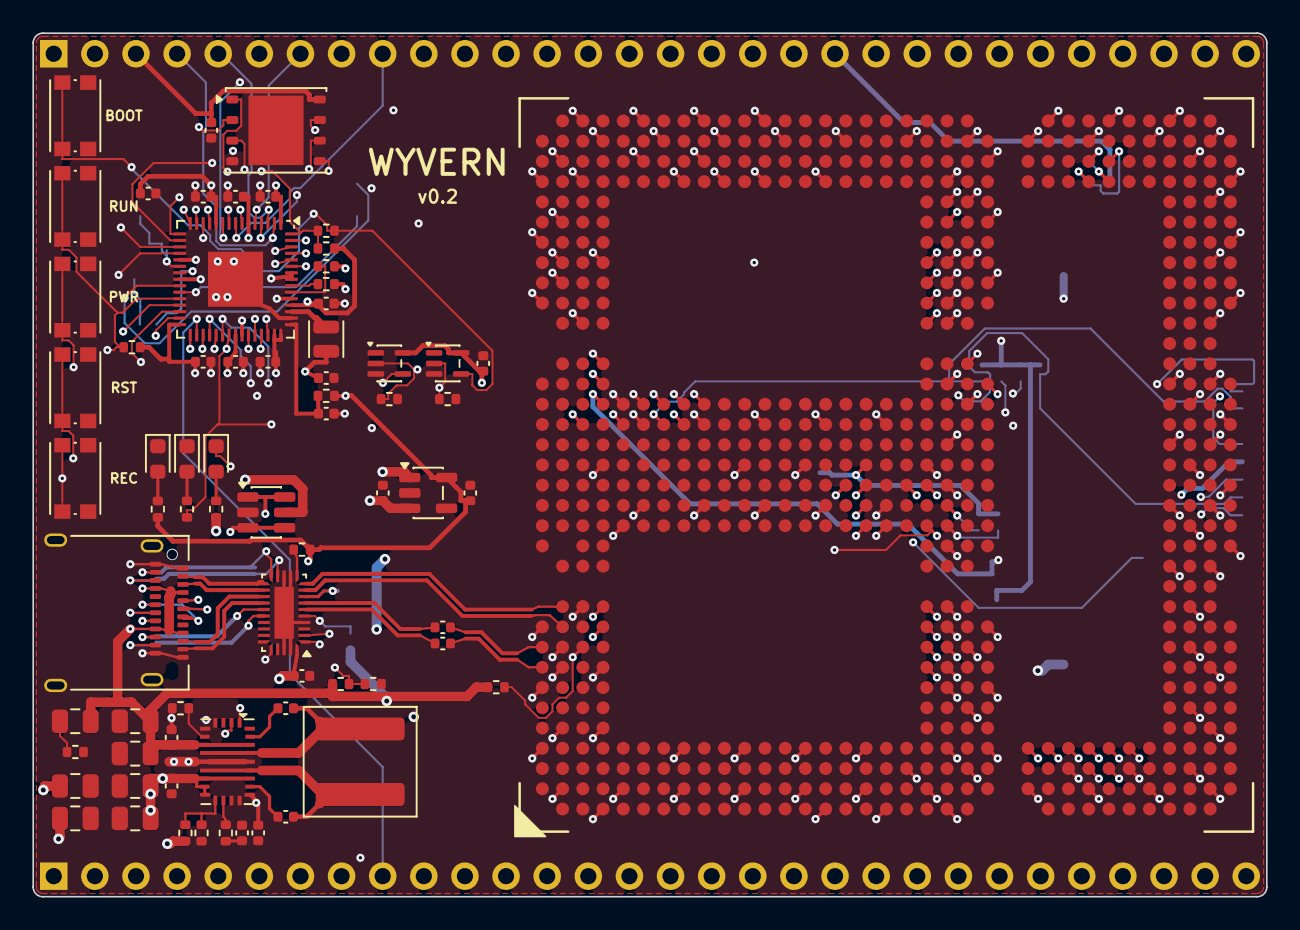
[picture p231: board examples/snapdragon-dev-board/v0.2/wyvern.kicad_pcb from above]

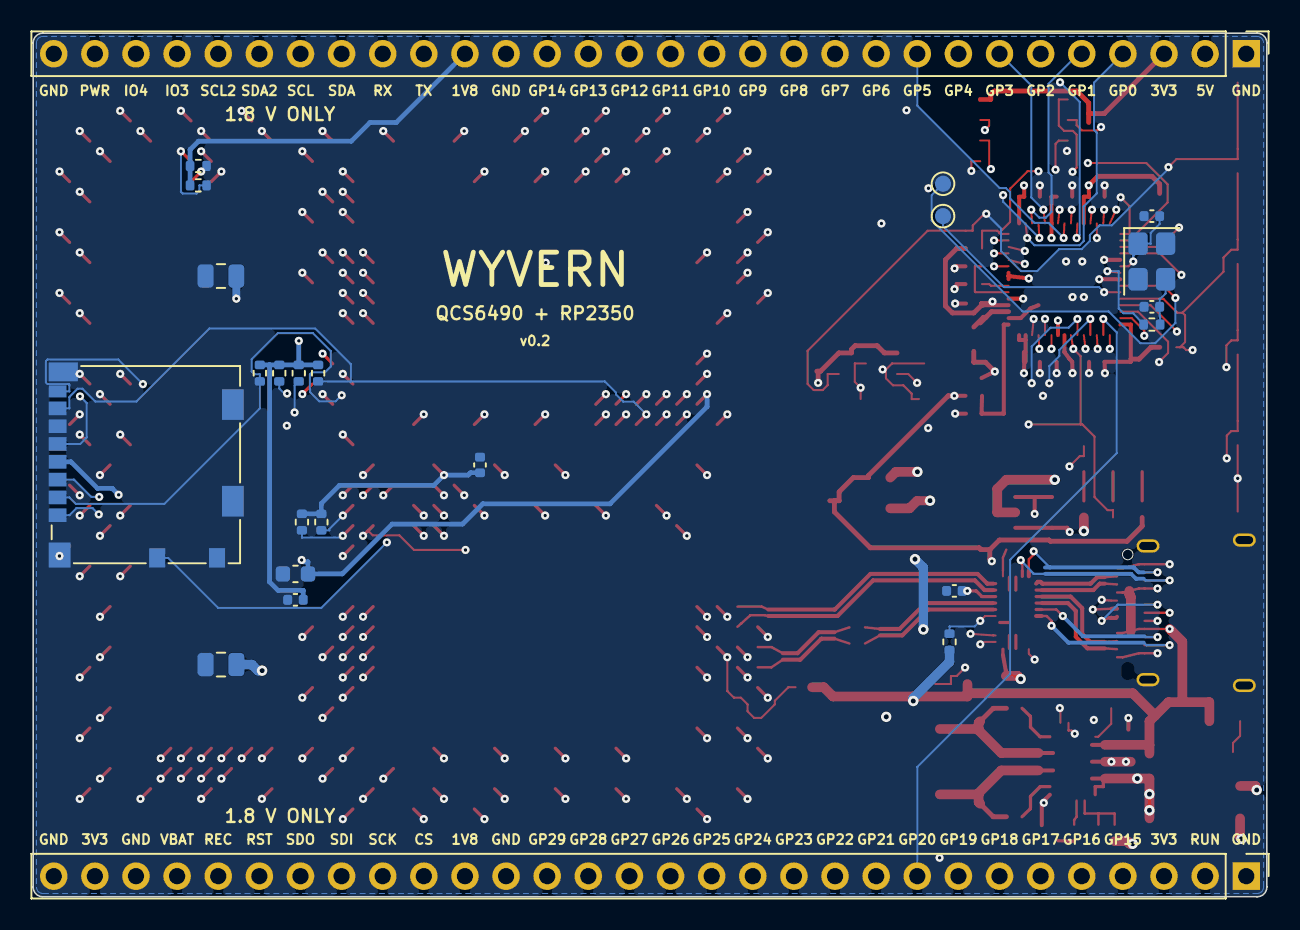
[picture p232: board examples/snapdragon-dev-board/v0.2/wyvern.kicad_pcb from below]

Board: 6 copper layers, 76.2 x 53.3 mm, 94 parts (24 on the bottom side), 118 nets.
