ThyFriendlyFox/via/examples/ring-mouse/v0.2/motion/signet_motion.kicad_pcb

## KiCad design examples/ring-mouse/v0.2/motion/signet_motion.kicad_pcb (2026-11-14, an earlier design)

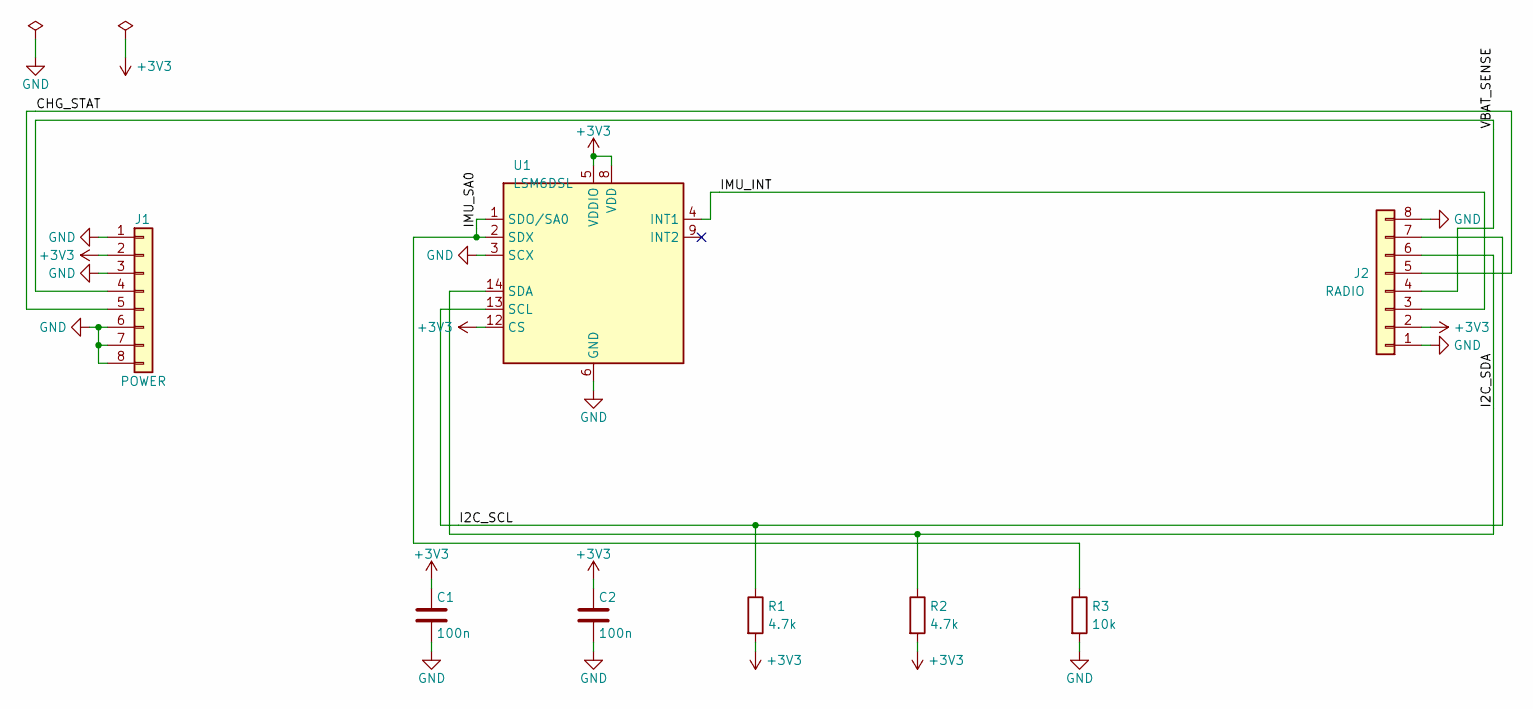
[picture p233: schematic signet_motion.kicad_sch]

Parts:
C1, C2: 100n; C_0402_1005Metric
J1: POWER; Joint_Edge_1x08_P1.3mm
J2: RADIO; Joint_Edge_1x08_P1.3mm
R1, R2: 4.7k; R_0402_1005Metric
R3: 10k; R_0402_1005Metric
U1: LSM6DSL; LGA-14_3x2.5mm_P0.5mm_LayoutBorder3x4y

Connections:
+3V3: C1.1, C2.1, J1.2, J2.2, R1.2, R2.2, U1.5 (VDDIO), U1.8 (VDD), U1.12 (CS)
/CHG_STAT: J1.5, J2.5
/I2C_SCL: J2.7, R1.1, U1.13 (SCL)
/I2C_SDA: J2.6, R2.1, U1.14 (SDA)
/IMU_INT: J2.3, U1.4 (INT1)
/IMU_SA0: R3.1, U1.1 (SDO/SA0), U1.2 (SDX)
/VBAT_SENSE: J1.4, J2.4
GND: C1.2, C2.2, J1.1, J1.3, J1.6, J1.7, J1.8, J2.1, J2.8, R3.2, U1.3 (SCX), U1.6 (GND), U1.7 (GND)

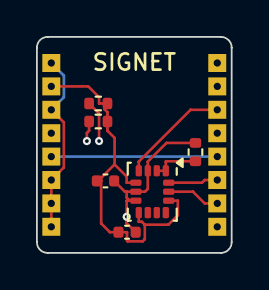
[picture p234: board signet_motion.kicad_pcb from above]

Board: 4 copper layers, 10.8 x 12.0 mm, 8 parts (0 on the bottom side), 8 nets.
