ThyFriendlyFox/via/examples/universal-controller/v0.2/rosetta.kicad_pcb

## KiCad design examples/universal-controller/v0.2/rosetta.kicad_pcb (2026-11-14)

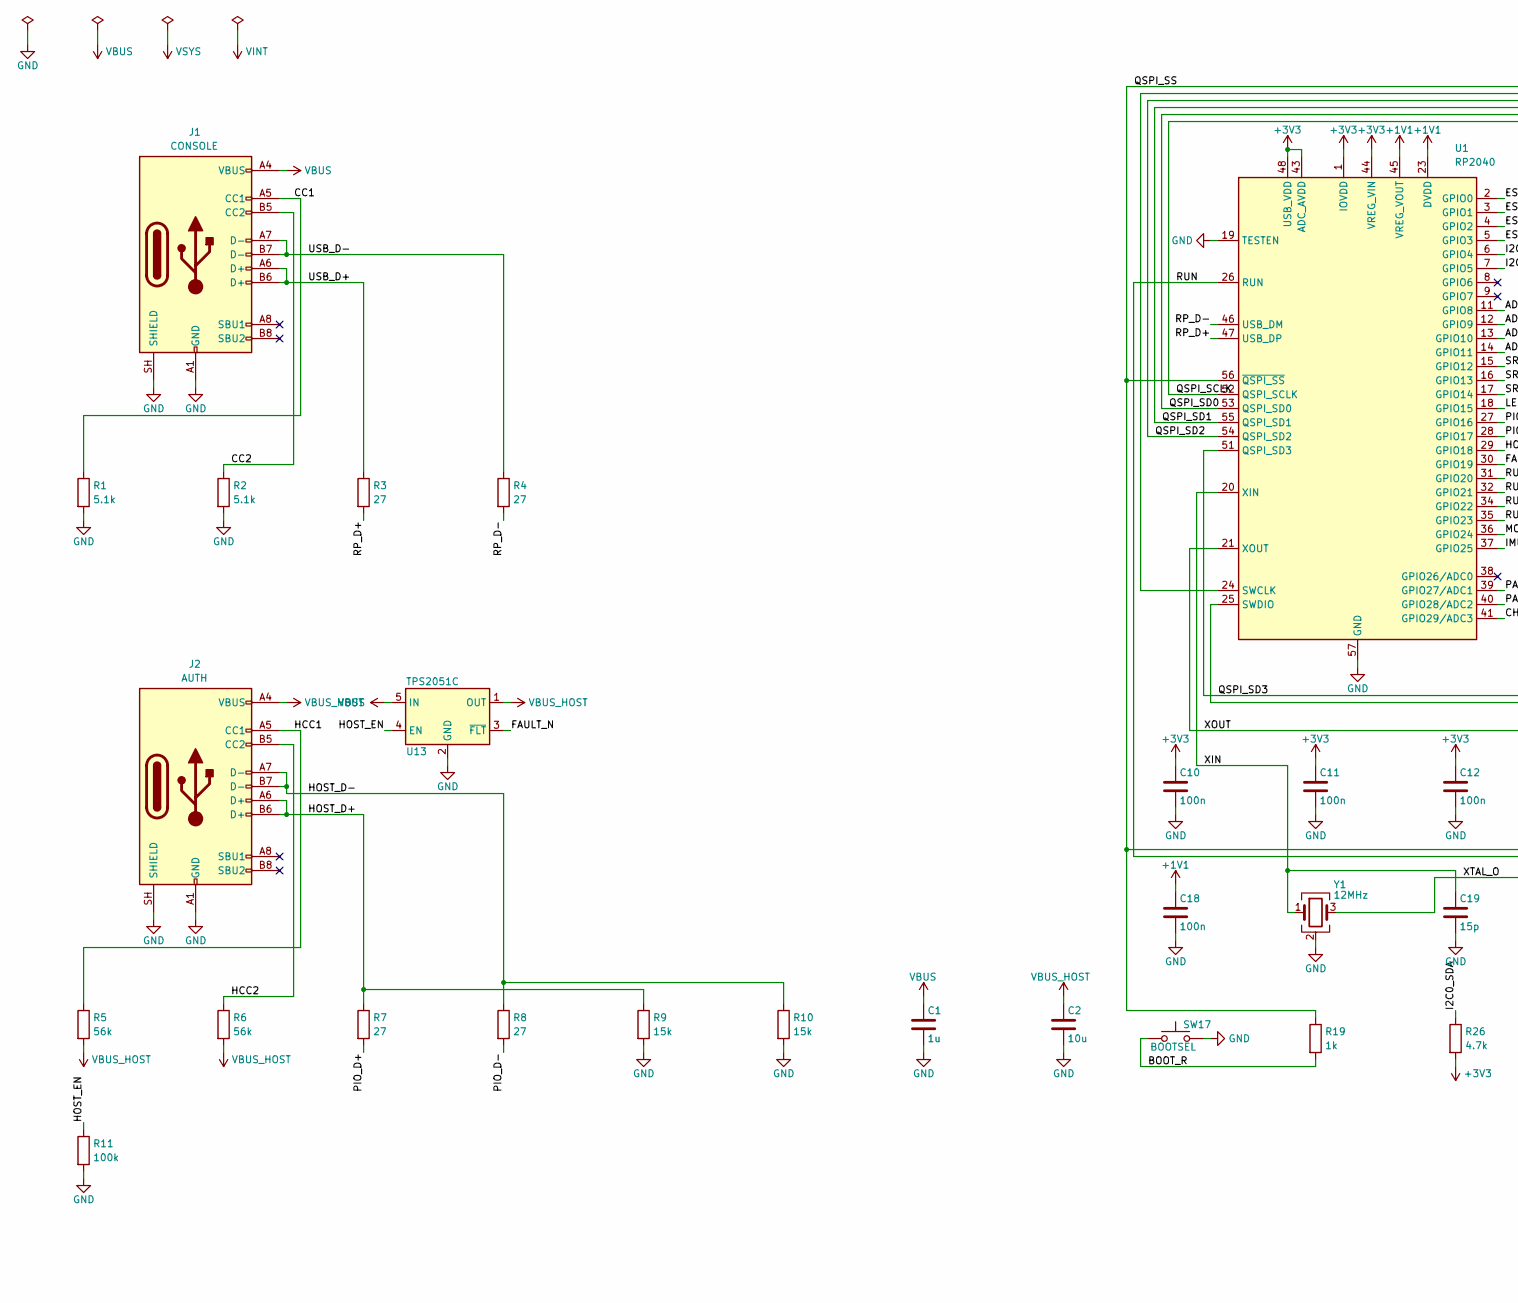
[picture p235: schematic rosetta.kicad_sch, part in row 1, column 1]

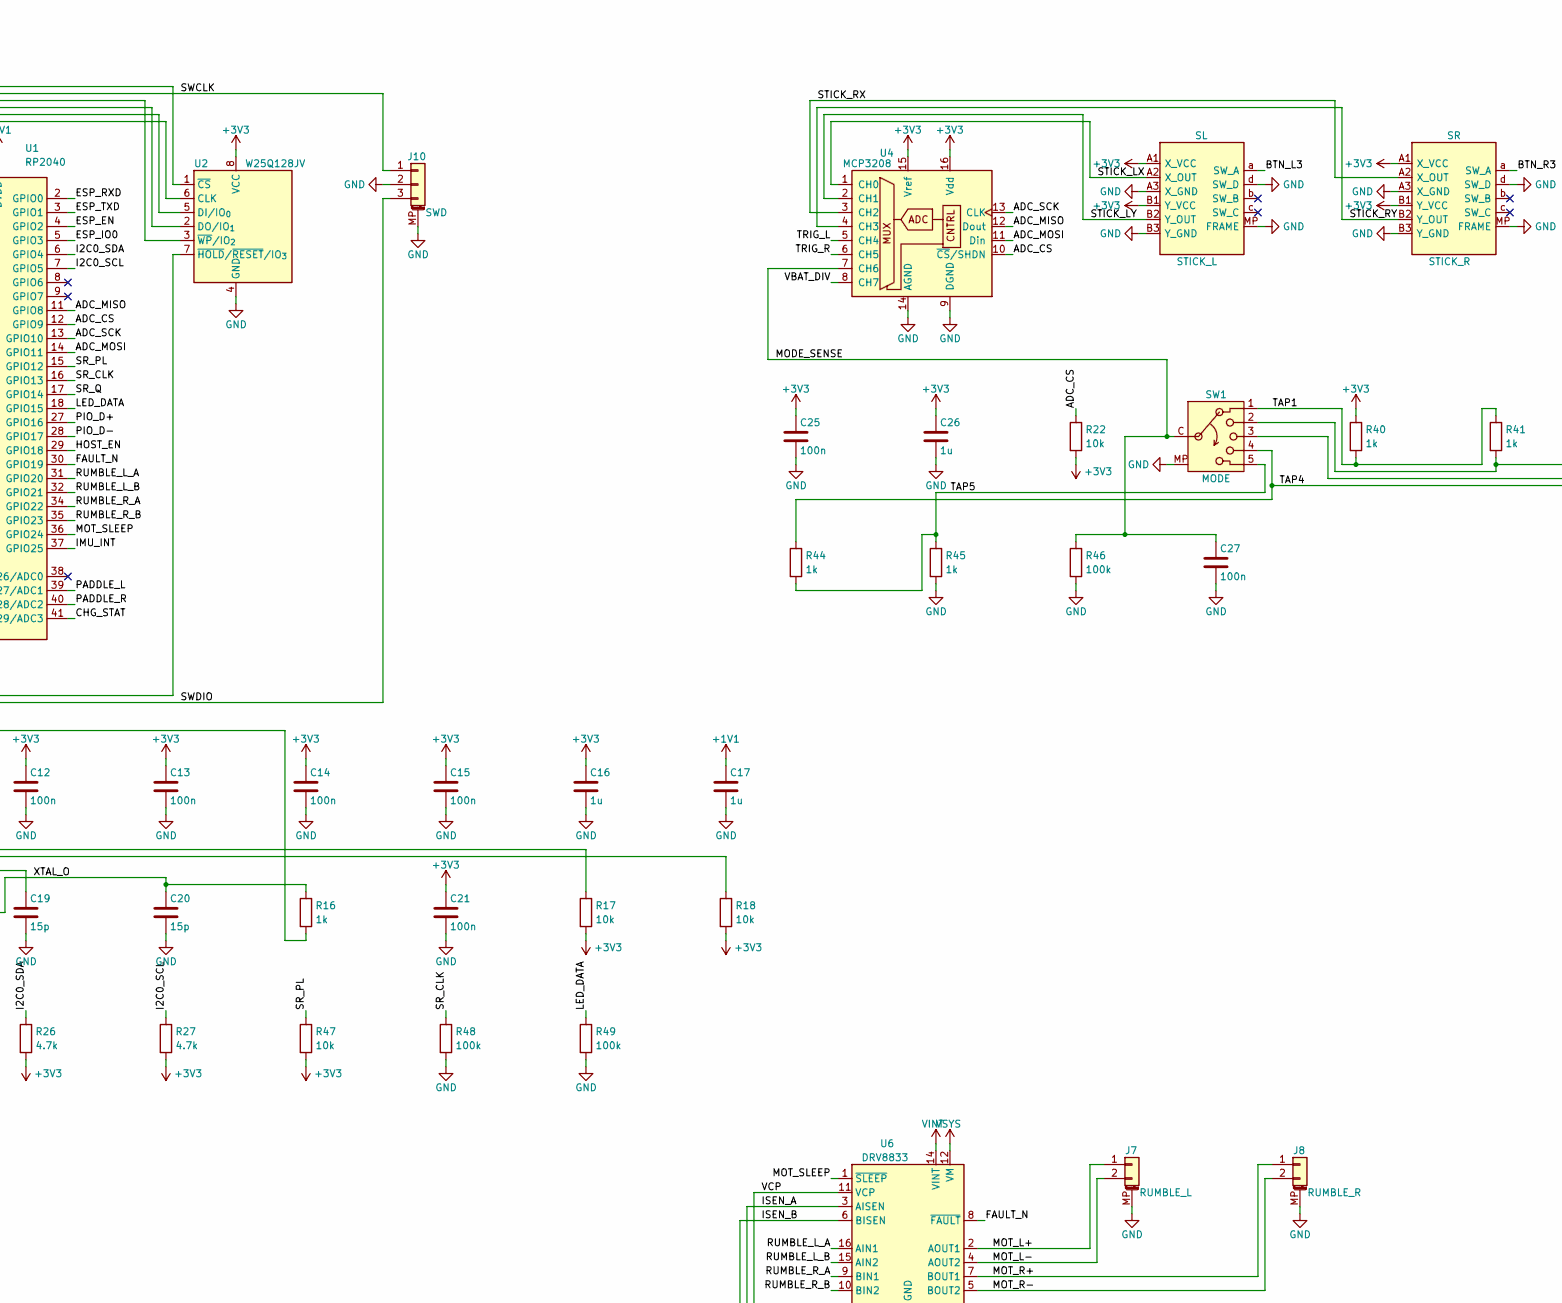
[picture p236: schematic rosetta.kicad_sch, part in row 1, column 2]

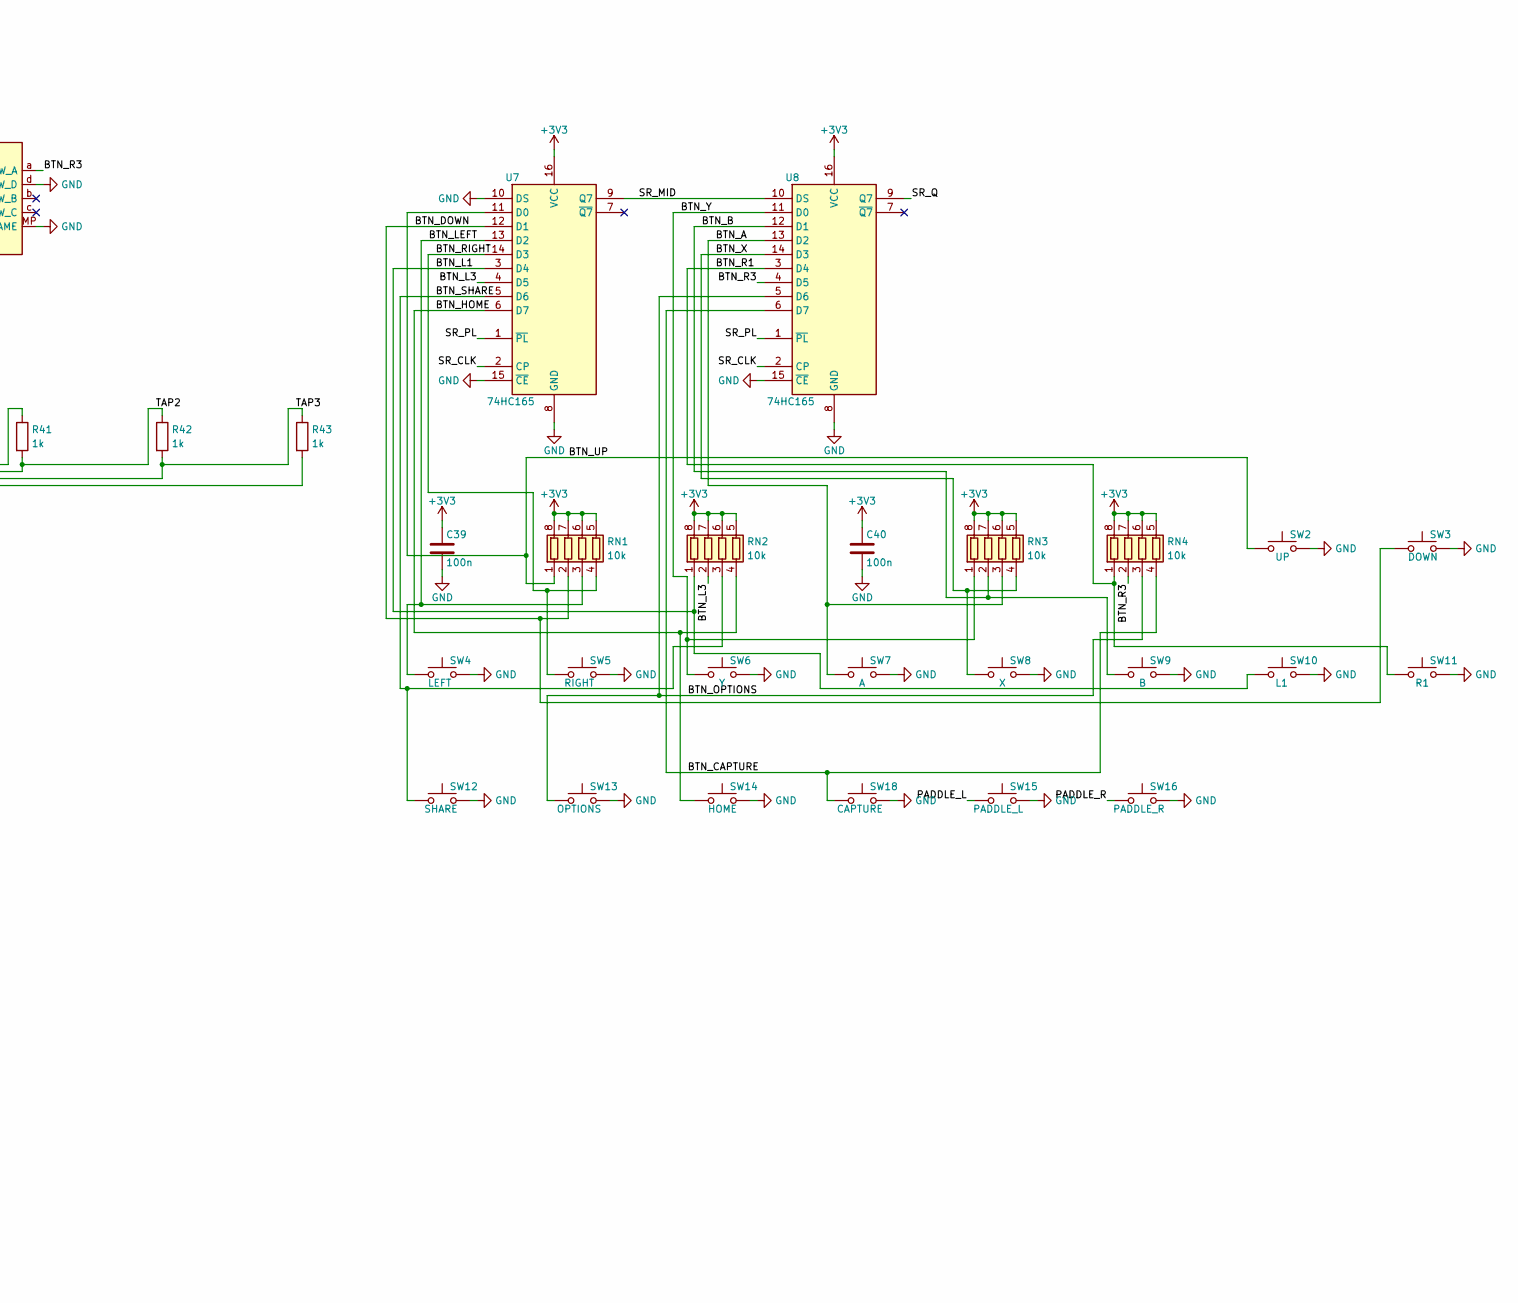
[picture p237: schematic rosetta.kicad_sch, part in row 1, column 3]

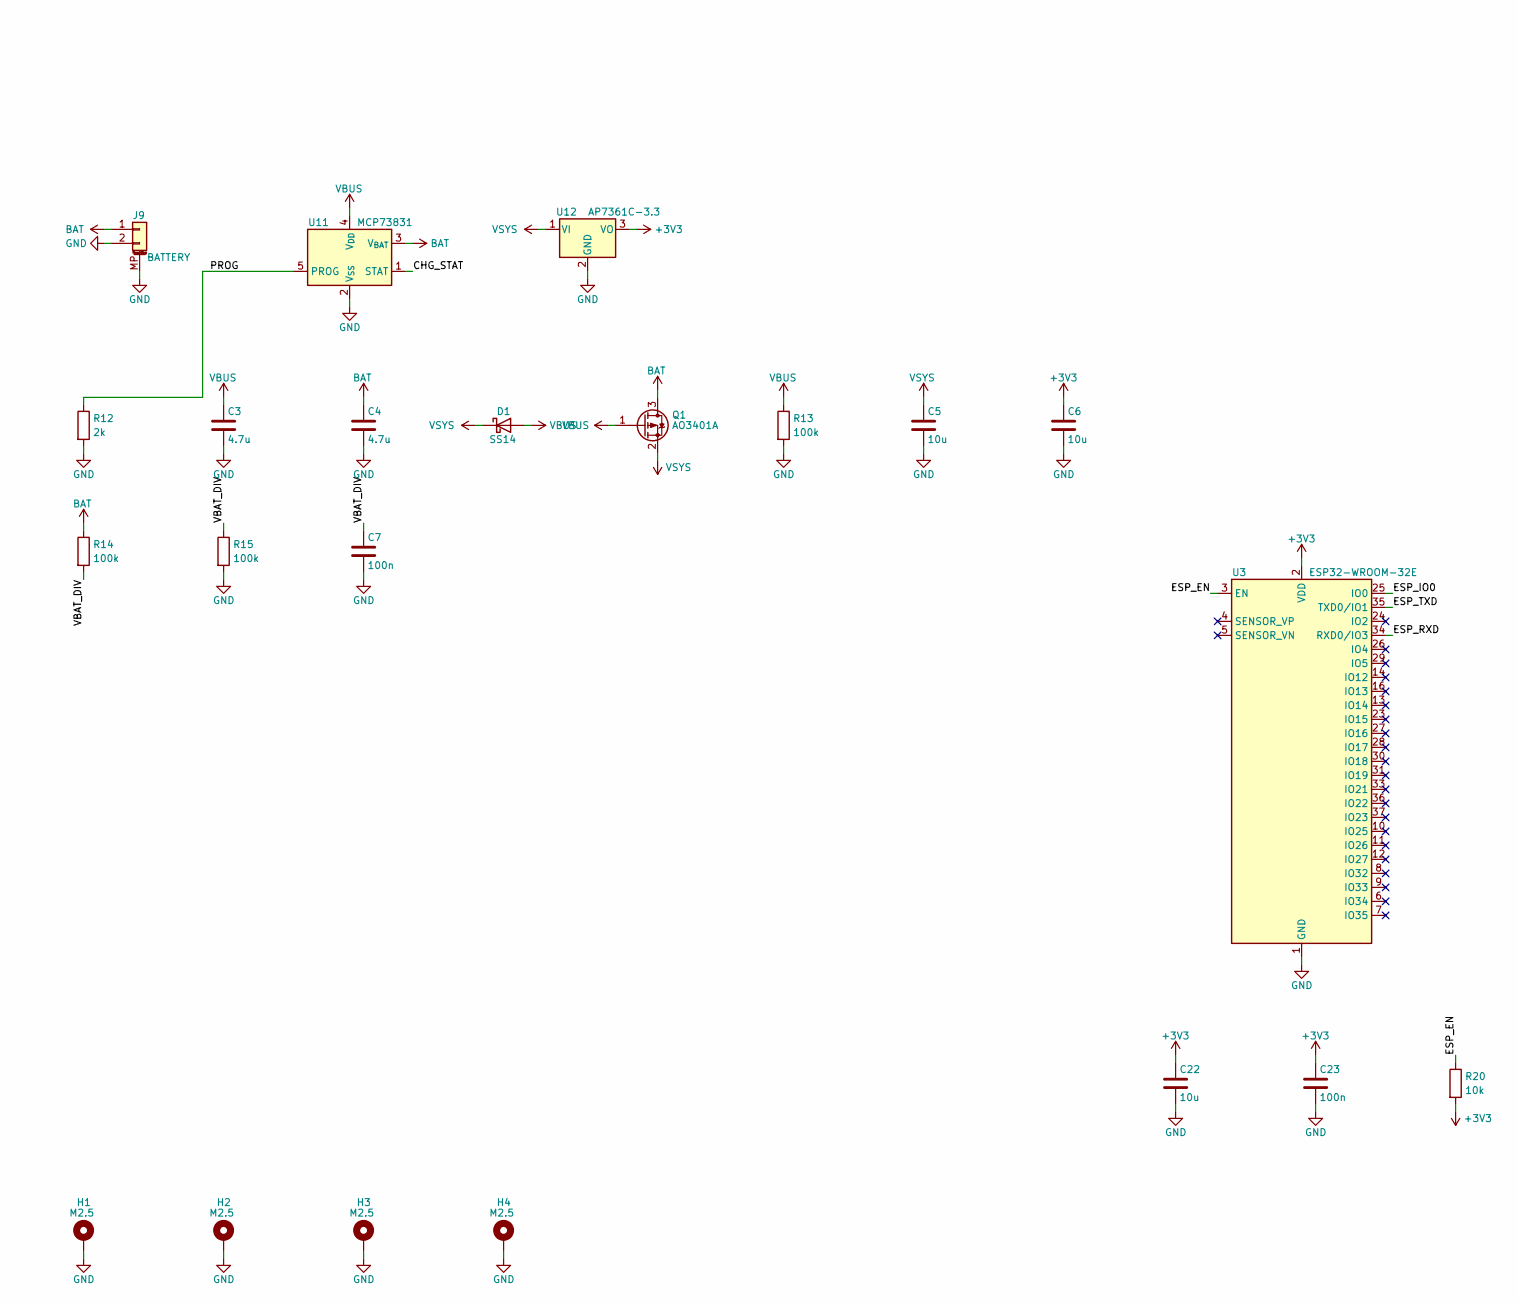
[picture p238: schematic rosetta.kicad_sch, part in row 2, column 1]

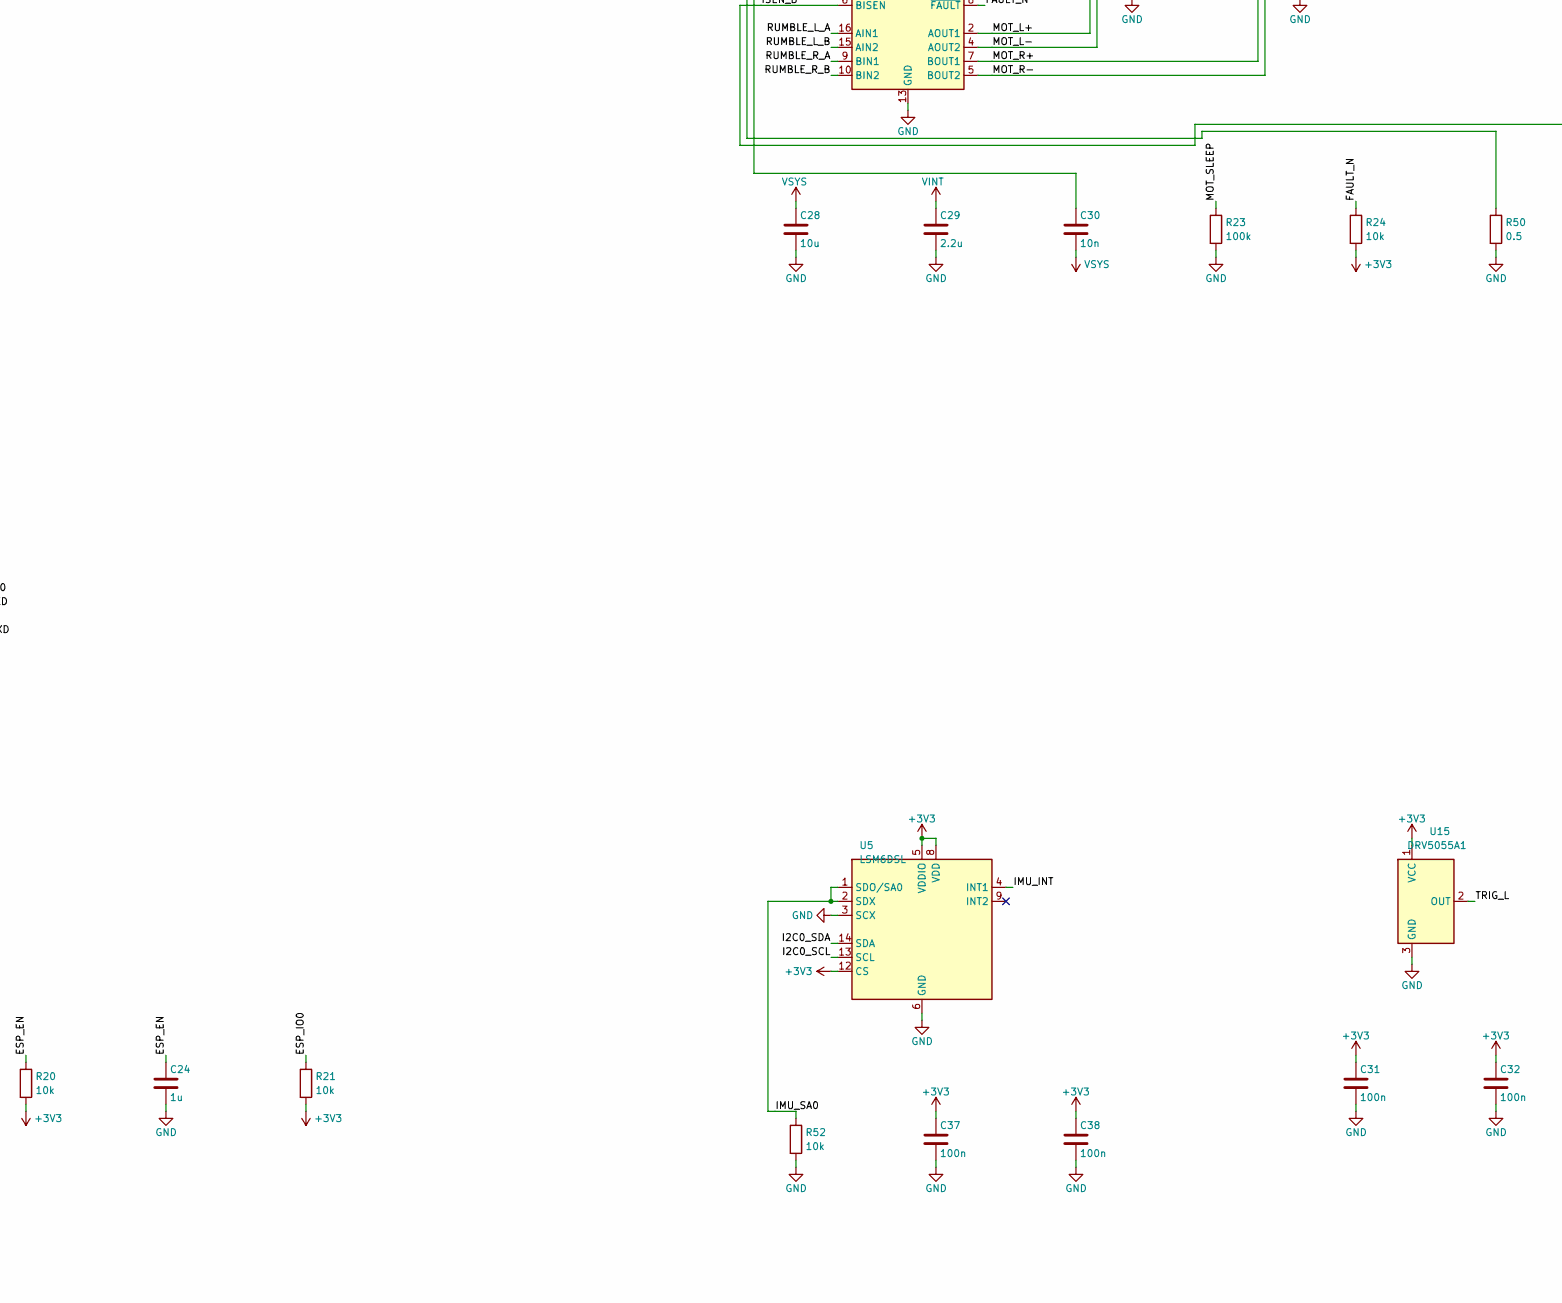
[picture p239: schematic rosetta.kicad_sch, part in row 2, column 2]

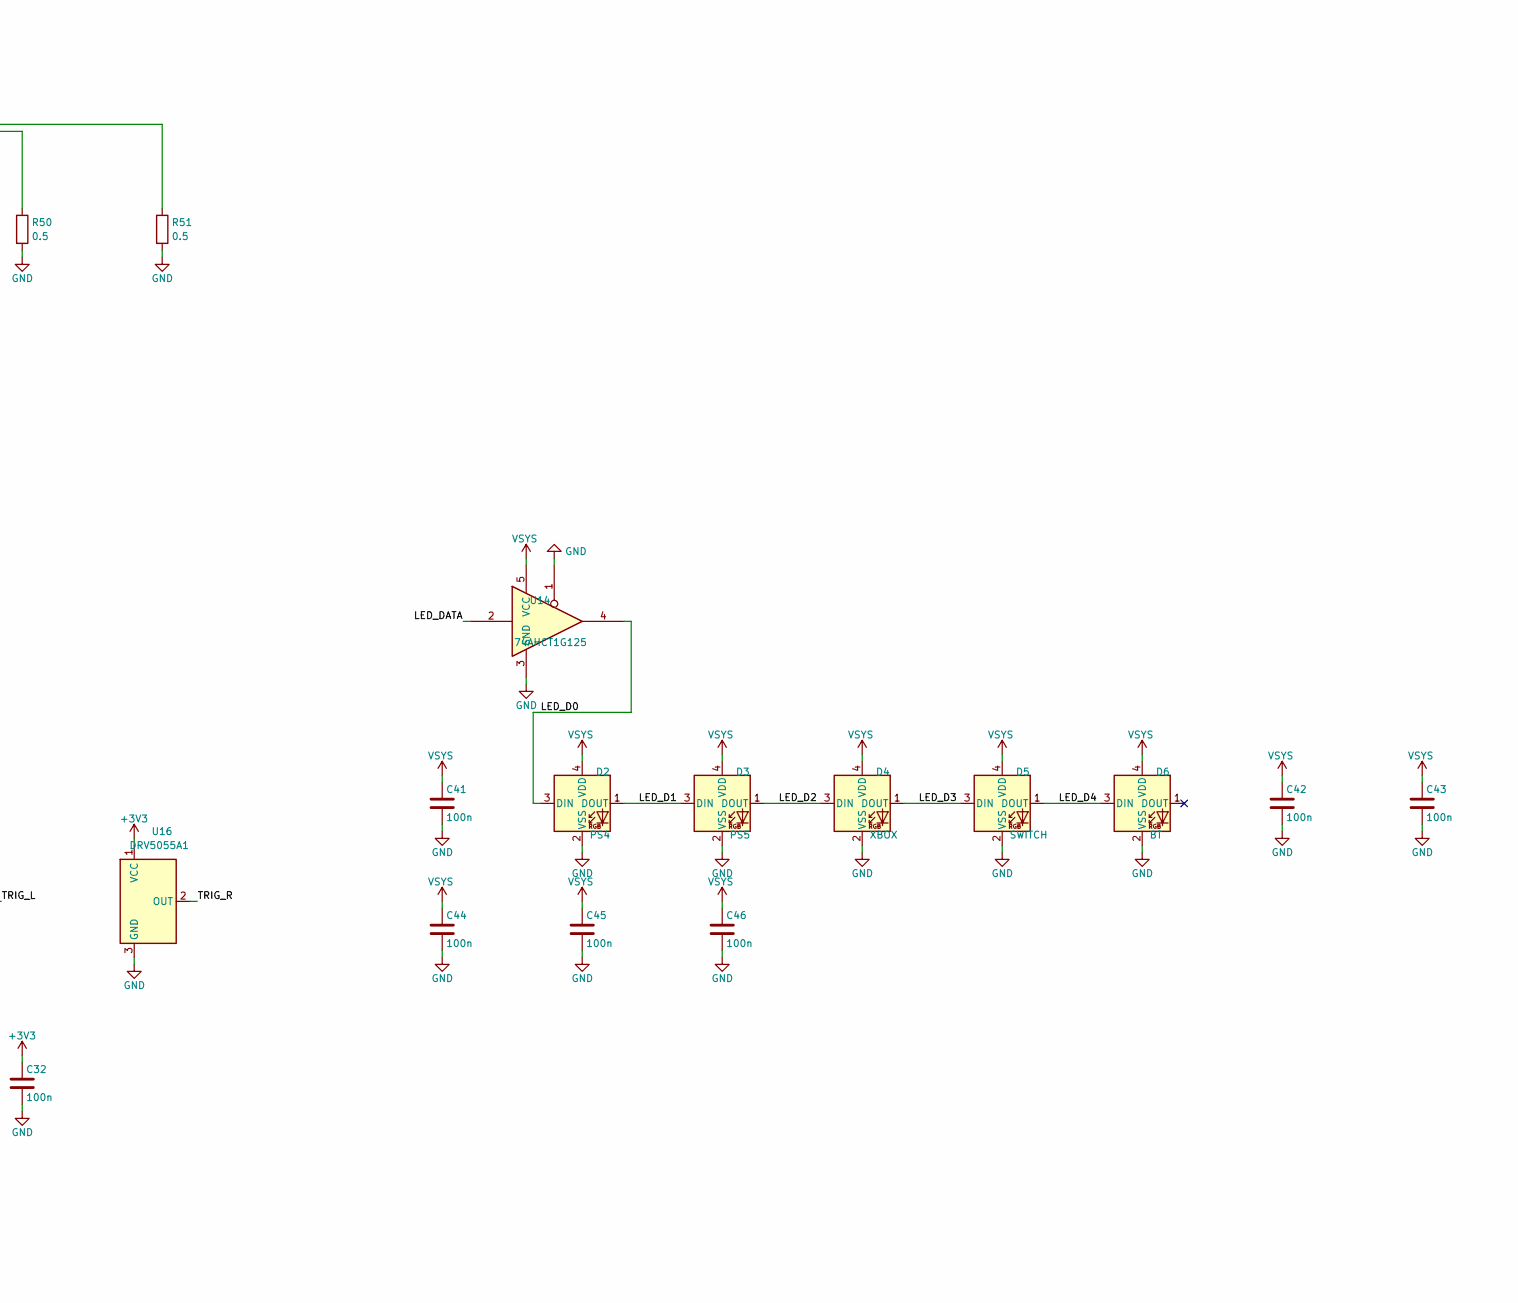
[picture p240: schematic rosetta.kicad_sch, part in row 2, column 3]

Parts:
C1, C16, C17, C24, C26: 1u; C_0603_1608Metric
C2, C5, C6, C22, C28: 10u; C_0805_2012Metric
C3, C4: 4.7u; C_0805_2012Metric
C7, C10, C11, C12, C13, C14, C15, C18, C21, C23, C25, C27, C31, C32, C37, C38, C39, C40, C41, C42, C43, C44, C45, C46: 100n; C_0603_1608Metric
C19, C20: 15p; C_0603_1608Metric
C29: 2.2u; C_0603_1608Metric
C30: 10n; C_0603_1608Metric
D1: SS14; D_SOD-123
D2: PS4; LED_WS2812B-2020_PLCC4_2.0x2.0mm
D3: PS5; LED_WS2812B-2020_PLCC4_2.0x2.0mm
D4: XBOX; LED_WS2812B-2020_PLCC4_2.0x2.0mm
D5: SWITCH; LED_WS2812B-2020_PLCC4_2.0x2.0mm
D6: BT; LED_WS2812B-2020_PLCC4_2.0x2.0mm
H1, H2, H3, H4: M2.5; MountingHole_2.5mm_Pad
J1: CONSOLE; USB_C_Receptacle_GCT_USB4085
J2: AUTH; USB_C_Receptacle_GCT_USB4085
J7: RUMBLE_L; JST_SH_SM02B-SRSS-TB_1x02-1MP_P1.00mm_Horizontal
J8: RUMBLE_R; JST_SH_SM02B-SRSS-TB_1x02-1MP_P1.00mm_Horizontal
J9: BATTERY; JST_PH_S2B-PH-SM4-TB_1x02-1MP_P2.00mm_Horizontal
J10: SWD; JST_SH_SM03B-SRSS-TB_1x03-1MP_P1.00mm_Horizontal
Q1: AO3401A; SOT-23
R1, R2: 5.1k; R_0603_1608Metric
R3, R4, R7, R8: 27; R_0603_1608Metric
R5, R6: 56k; R_0603_1608Metric
R9, R10: 15k; R_0603_1608Metric
R11, R13, R14, R15, R23, R46, R48, R49: 100k; R_0603_1608Metric
R12: 2k; R_0603_1608Metric
R16, R19, R40, R41, R42, R43, R44, R45: 1k; R_0603_1608Metric
R17, R18, R20, R21, R22, R24, R47, R52: 10k; R_0603_1608Metric
R26, R27: 4.7k; R_0603_1608Metric
R50, R51: 0.5; R_0603_1608Metric
RN1, RN2, RN3, RN4: 10k; R_Array_Convex_4x0603
SL: STICK_L; Thumbstick_ALPS_RKJXV122400R
SR: STICK_R; Thumbstick_ALPS_RKJXV122400R
SW1: MODE; SW_NKK_NR01
SW2: UP; SW_SPST_TL3342
SW3: DOWN; SW_SPST_TL3342
SW4: LEFT; SW_SPST_TL3342
SW5: RIGHT; SW_SPST_TL3342
SW6: Y; SW_SPST_TL3342
SW7: A; SW_SPST_TL3342
SW8: X; SW_SPST_TL3342
SW9: B; SW_SPST_TL3342
SW10: L1; SW_Tactile_SPST_Angled_PTS645Vx31-2LFS
SW11: R1; SW_Tactile_SPST_Angled_PTS645Vx31-2LFS
SW12: SHARE; SW_SPST_PTS810
SW13: OPTIONS; SW_SPST_PTS810
SW14: HOME; SW_SPST_PTS810
SW15: PADDLE_L; SW_SPST_TL3342
SW16: PADDLE_R; SW_SPST_TL3342
SW17: BOOTSEL; SW_SPST_PTS810
SW18: CAPTURE; SW_SPST_PTS810
U1: RP2040; QFN-56-1EP_7x7mm_P0.4mm_EP3.2x3.2mm
U2: W25Q128JV; SOIC-8_5.3x5.3mm_P1.27mm
U3: ESP32-WROOM-32E
U4: MCP3208; SOIC-16_3.9x9.9mm_P1.27mm
U5: LSM6DSL; LGA-14_3x2.5mm_P0.5mm_LayoutBorder3x4y
U6: DRV8833; TSSOP-16_4.4x5mm_P0.65mm
U7, U8: 74HC165; SOIC-16_3.9x9.9mm_P1.27mm
U11: MCP73831; SOT-23-5
U12: AP7361C-3.3; SOT-223-3_TabPin2
U13: TPS2051C; SOT-23-5
U14: 74AHCT1G125; SOT-23-5
U15, U16: DRV5055A1; SOT-23
Y1: 12MHz; Crystal_SMD_3225-4Pin_3.2x2.5mm

Connections:
+1V1: C17.1, C18.1, U1.23 (DVDD), U1.45 (VREG_VOUT), U1.50 (DVDD)
+3V3: C6.1, C10.1, C11.1, C12.1, C13.1, C14.1, C15.1, C16.1, C21.1, C22.1, C23.1, C25.1, C26.1, C31.1, C32.1, C37.1, C38.1, C39.1, C40.1, R17.2, R18.2, R20.2, R21.2, R22.2, R24.2, R26.2, R27.2, R40.1, R47.2, RN1.5 (R4.2), RN1.6 (R3.2), RN1.7 (R2.2), RN1.8 (R1.2), RN2.5 (R4.2), RN2.6 (R3.2), RN2.7 (R2.2), RN2.8 (R1.2), RN3.5 (R4.2), RN3.6 (R3.2), RN3.7 (R2.2), RN3.8 (R1.2), RN4.5 (R4.2), RN4.6 (R3.2), RN4.7 (R2.2), RN4.8 (R1.2), SL.A1 (X_VCC), SL.B1 (Y_VCC), SR.A1 (X_VCC), SR.B1 (Y_VCC), U1.1 (IOVDD), U1.10 (IOVDD), U1.22 (IOVDD), U1.33 (IOVDD), U1.42 (IOVDD), U1.43 (ADC_AVDD), U1.44 (VREG_VIN), U1.48 (USB_VDD), U1.49 (IOVDD), U2.8 (VCC), U3.2 (VDD), U4.15 (Vref), U4.16 (Vdd), U5.5 (VDDIO), U5.8 (VDD), U5.12 (CS), U7.16 (VCC), U8.16 (VCC), U12.3 (VO), U15.1 (VCC), U16.1 (VCC)
/ADC_CS: R22.1, U1.12 (GPIO9), U4.10 (~CS/SHDN)
/ADC_MISO: U1.11 (GPIO8), U4.12 (Dout)
/ADC_MOSI: U1.14 (GPIO11), U4.11 (Din)
/ADC_SCK: U1.13 (GPIO10), U4.13 (CLK)
/BOOT_R: R19.2, SW17.1
/BTN_A: RN3.3 (R3.1), SW7.1, U8.13 (D2)
/BTN_B: RN3.2 (R2.1), SW9.1, U8.12 (D1)
/BTN_CAPTURE: RN4.4 (R4.1), SW18.1, U8.6 (D7)
/BTN_DOWN: RN1.2 (R2.1), SW3.1, U7.12 (D1)
/BTN_HOME: RN2.4 (R4.1), SW14.1, U7.6 (D7)
/BTN_L1: RN2.1 (R1.1), SW10.1, U7.3 (D4)
/BTN_L3: RN2.2 (R2.1), SL.a (SW_A), U7.4 (D5)
/BTN_LEFT: RN1.3 (R3.1), SW4.1, U7.13 (D2)
/BTN_OPTIONS: RN4.3 (R3.1), SW13.1, U8.5 (D6)
/BTN_R1: RN4.1 (R1.1), SW11.1, U8.3 (D4)
/BTN_R3: RN4.2 (R2.1), SR.a (SW_A), U8.4 (D5)
/BTN_RIGHT: RN1.4 (R4.1), SW5.1, U7.14 (D3)
/BTN_SHARE: RN2.3 (R3.1), SW12.1, U7.5 (D6)
/BTN_UP: RN1.1 (R1.1), SW2.1, U7.11 (D0)
/BTN_X: RN3.4 (R4.1), SW8.1, U8.14 (D3)
/BTN_Y: RN3.1 (R1.1), SW6.1, U8.11 (D0)
/CC1: J1.A5 (CC1), R1.1
/CC2: J1.B5 (CC2), R2.1
/CHG_STAT: U1.41 (GPIO29/ADC3), U11.1 (STAT)
/ESP_EN: C24.1, R20.1, U1.4 (GPIO2), U3.3 (EN)
/ESP_IO0: R21.1, U1.5 (GPIO3), U3.25 (IO0)
/ESP_RXD: U1.2 (GPIO0), U3.34 (RXD0/IO3)
/ESP_TXD: U1.3 (GPIO1), U3.35 (TXD0/IO1)
/FAULT_N: R24.1, U1.30 (GPIO19), U6.8 (~FAULT), U13.3 (~FLT)
/HCC1: J2.A5 (CC1), R5.1
/HCC2: J2.B5 (CC2), R6.1
/HOST_D+: J2.A6 (D+), J2.B6 (D+), R7.1, R9.1
/HOST_D-: J2.A7 (D-), J2.B7 (D-), R8.1, R10.1
/HOST_EN: R11.1, U1.29 (GPIO18), U13.4 (EN)
/I2C0_SCL: R27.1, U1.7 (GPIO5), U5.13 (SCL)
/I2C0_SDA: R26.1, U1.6 (GPIO4), U5.14 (SDA)
/IMU_INT: U1.37 (GPIO25), U5.4 (INT1)
/IMU_SA0: R52.1, U5.1 (SDO/SA0), U5.2 (SDX)
/ISEN_A: R50.1, U6.3 (AISEN)
/ISEN_B: R51.1, U6.6 (BISEN)
/LED_D0: D2.3 (DIN), U14.4
/LED_D1: D2.1 (DOUT), D3.3 (DIN)
/LED_D2: D3.1 (DOUT), D4.3 (DIN)
/LED_D3: D4.1 (DOUT), D5.3 (DIN)
/LED_D4: D5.1 (DOUT), D6.3 (DIN)
/LED_DATA: R49.1, U1.18 (GPIO15), U14.2
/MODE_SENSE: C27.1, R46.1, SW1.C (Common), U4.7 (CH6)
/MOT_L+: J7.1, U6.2 (AOUT1)
/MOT_L-: J7.2, U6.4 (AOUT2)
/MOT_R+: J8.1, U6.7 (BOUT1)
/MOT_R-: J8.2, U6.5 (BOUT2)
/MOT_SLEEP: R23.1, U1.36 (GPIO24), U6.1 (~SLEEP)
/PADDLE_L: SW15.1, U1.39 (GPIO27/ADC1)
/PADDLE_R: SW16.1, U1.40 (GPIO28/ADC2)
/PIO_D+: R7.2, U1.27 (GPIO16)
/PIO_D-: R8.2, U1.28 (GPIO17)
/PROG: R12.1, U11.5 (PROG)
/QSPI_SCLK: U1.52 (QSPI_SCLK), U2.6 (CLK)
/QSPI_SD0: U1.53 (QSPI_SD0), U2.5 (DI/IO_{0})
/QSPI_SD1: U1.55 (QSPI_SD1), U2.2 (DO/IO_{1})
/QSPI_SD2: U1.54 (QSPI_SD2), U2.3 (~WP/IO_{2})
/QSPI_SD3: U1.51 (QSPI_SD3), U2.7 (~HOLD/~RESET/IO_{3})
/QSPI_SS: R17.1, R19.1, U1.56 (~QSPI_SS), U2.1 (~CS)
/RP_D+: R3.2, U1.47 (USB_DP)
/RP_D-: R4.2, U1.46 (USB_DM)
/RUMBLE_L_A: U1.31 (GPIO20), U6.16 (AIN1)
/RUMBLE_L_B: U1.32 (GPIO21), U6.15 (AIN2)
/RUMBLE_R_A: U1.34 (GPIO22), U6.9 (BIN1)
/RUMBLE_R_B: U1.35 (GPIO23), U6.10 (BIN2)
/RUN: R18.1, U1.26 (RUN)
/SR_CLK: R48.1, U1.16 (GPIO13), U7.2 (CP), U8.2 (CP)
/SR_MID: U7.9 (Q7), U8.10 (DS)
/SR_PL: R47.1, U1.15 (GPIO12), U7.1 (~PL), U8.1 (~PL)
/SR_Q: U1.17 (GPIO14), U8.9 (Q7)
/STICK_LX: SL.A2 (X_OUT), U4.1 (CH0)
/STICK_LY: SL.B2 (Y_OUT), U4.2 (CH1)
/STICK_RX: SR.A2 (X_OUT), U4.3 (CH2)
/STICK_RY: SR.B2 (Y_OUT), U4.4 (CH3)
/SWCLK: J10.1, U1.24 (SWCLK)
/SWDIO: J10.3, U1.25 (SWDIO)
/TAP1: R40.2, R41.1, SW1.1
/TAP2: R41.2, R42.1, SW1.2
/TAP3: R42.2, R43.1, SW1.3
/TAP4: R43.2, R44.1, SW1.4
/TAP5: R44.2, R45.1, SW1.5
/TRIG_L: U4.5 (CH4), U15.2 (OUT)
/TRIG_R: U4.6 (CH5), U16.2 (OUT)
/USB_D+: J1.A6 (D+), J1.B6 (D+), R3.1
/USB_D-: J1.A7 (D-), J1.B7 (D-), R4.1
/VBAT_DIV: C7.1, R14.2, R15.1, U4.8 (CH7)
/VCP: C30.1, U6.11 (VCP)
/XIN: C19.1, U1.20 (XIN), Y1.1
/XOUT: R16.2, U1.21 (XOUT)
/XTAL_O: C20.1, R16.1, Y1.3
BAT: C4.1, J9.1, Q1.3 (D), R14.1, U11.3 (V_{BAT})
GND: C1.2, C2.2, C3.2, C4.2, C5.2, C6.2, C7.2, C10.2, C11.2, C12.2, C13.2, C14.2, C15.2, C16.2, C17.2, C18.2, C19.2, C20.2, C21.2, C22.2, C23.2, C24.2, C25.2, C26.2, C27.2, C28.2, C29.2, C31.2, C32.2, C37.2, C38.2, C39.2, C40.2, C41.2, C42.2, C43.2, C44.2, C45.2, C46.2, D2.2 (VSS), D3.2 (VSS), D4.2 (VSS), D5.2 (VSS), D6.2 (VSS), H1.1, H2.1, H3.1, H4.1, J1.A1 (GND), J1.A12 (GND), J1.B1 (GND), J1.B12 (GND), J1.SH (SHIELD), J2.A1 (GND), J2.A12 (GND), J2.B1 (GND), J2.B12 (GND), J2.SH (SHIELD), J7.MP (MountPin), J8.MP (MountPin), J9.2, J9.MP (MountPin), J10.2, J10.MP (MountPin), R1.2, R2.2, R9.2, R10.2, R11.2, R12.2, R13.2, R15.2, R23.2, R45.2, R46.2, R48.2, R49.2, R50.2, R51.2, R52.2, SL.A3 (X_GND), SL.B3 (Y_GND), SL.MP (FRAME), SL.d (SW_D), SR.A3 (X_GND), SR.B3 (Y_GND), SR.MP (FRAME), SR.d (SW_D), SW1.MP, SW2.2, SW3.2, SW4.2, SW5.2, SW6.2, SW7.2, SW8.2, SW9.2, SW10.2, SW11.2, SW12.2, SW13.2, SW14.2, SW15.2, SW16.2, SW17.2, SW18.2, U1.19 (TESTEN), U1.57 (GND), U2.4 (GND), U3.1 (GND), U3.15 (GND), U3.38 (GND), U3.39 (GND), U4.9 (DGND), U4.14 (AGND), U5.3 (SCX), U5.6 (GND), U5.7 (GND), U6.13 (GND), U7.8 (GND), U7.10 (DS), U7.15 (~CE), U8.8 (GND), U8.15 (~CE), U11.2 (V_{SS}), U12.2 (GND), U13.2 (GND), U14.1, U14.3 (GND), U15.3 (GND), U16.3 (GND), Y1.2 (G), Y1.4 (G)
VBUS: C1.1, C3.1, D1.2 (A), J1.A4 (VBUS), J1.A9 (VBUS), J1.B4 (VBUS), J1.B9 (VBUS), Q1.1 (G), R13.1, U11.4 (V_{DD}), U13.5 (IN)
VBUS_HOST: C2.1, J2.A4 (VBUS), J2.A9 (VBUS), J2.B4 (VBUS), J2.B9 (VBUS), R5.2, R6.2, U13.1 (OUT)
VINT: C29.1, U6.14 (VINT)
VSYS: C5.1, C28.1, C30.2, C41.1, C42.1, C43.1, C44.1, C45.1, C46.1, D1.1 (K), D2.4 (VDD), D3.4 (VDD), D4.4 (VDD), D5.4 (VDD), D6.4 (VDD), Q1.2 (S), U6.12 (VM), U12.1 (VI), U14.5 (VCC)

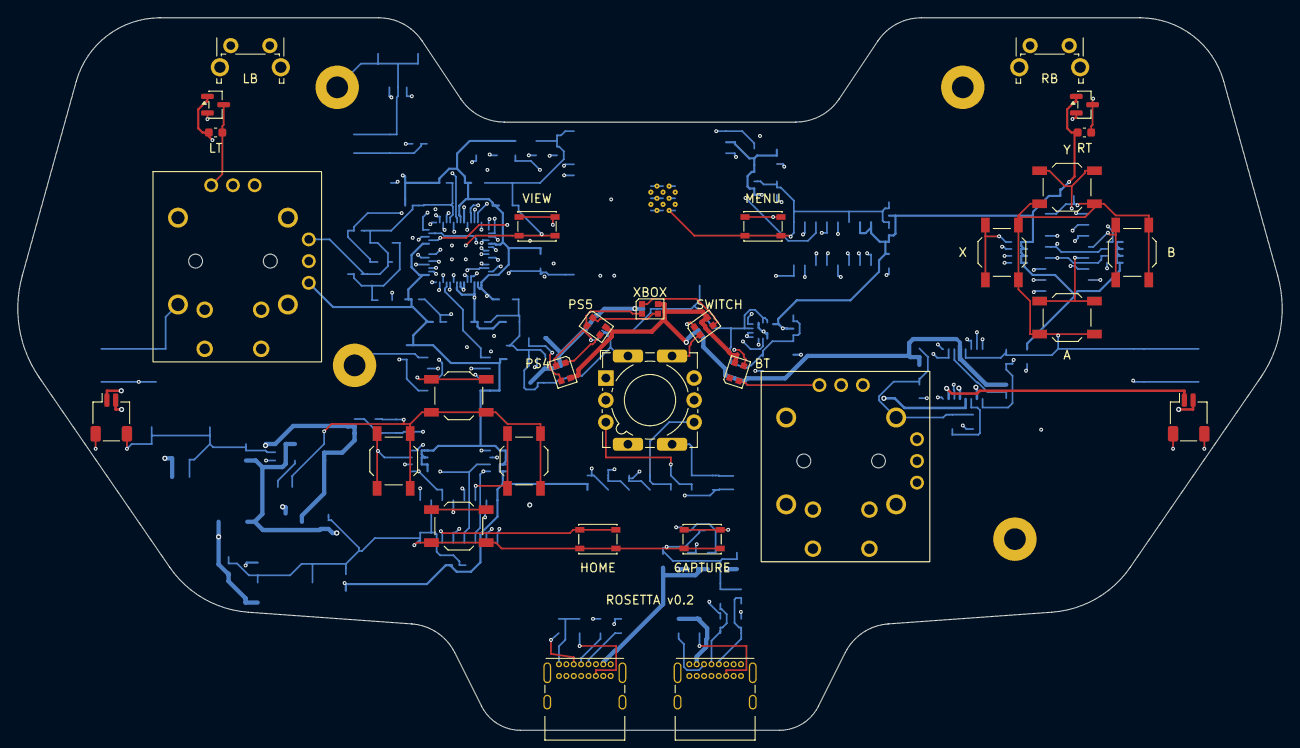
[picture p241: board rosetta.kicad_pcb from above]

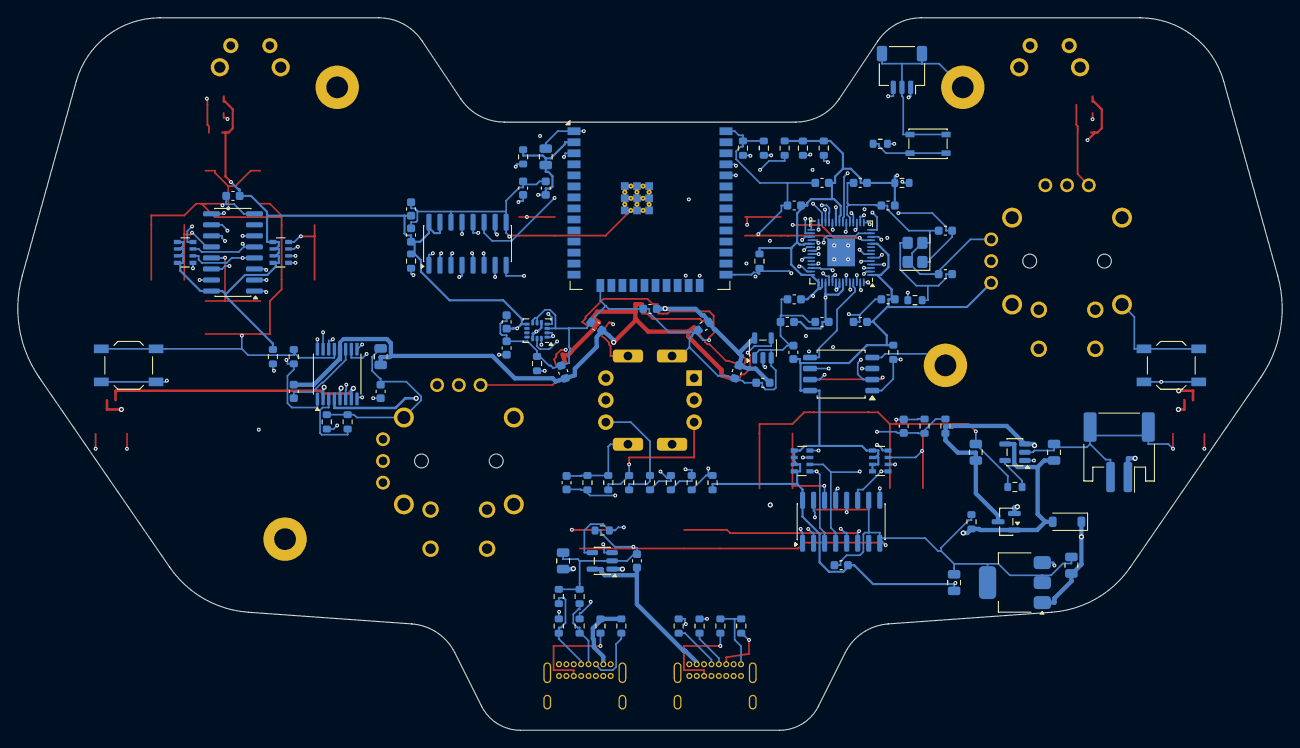
[picture p242: board rosetta.kicad_pcb from below]

Board: 6 copper layers, 145.5 x 82.0 mm, 135 parts (101 on the bottom side), 102 nets.
