ThyFriendlyFox/via/examples/ring-mouse/v0.3/cell/signet_cell.kicad_pcb

## KiCad design examples/ring-mouse/v0.3/cell/signet_cell.kicad_pcb (2026-11-14, an earlier design)

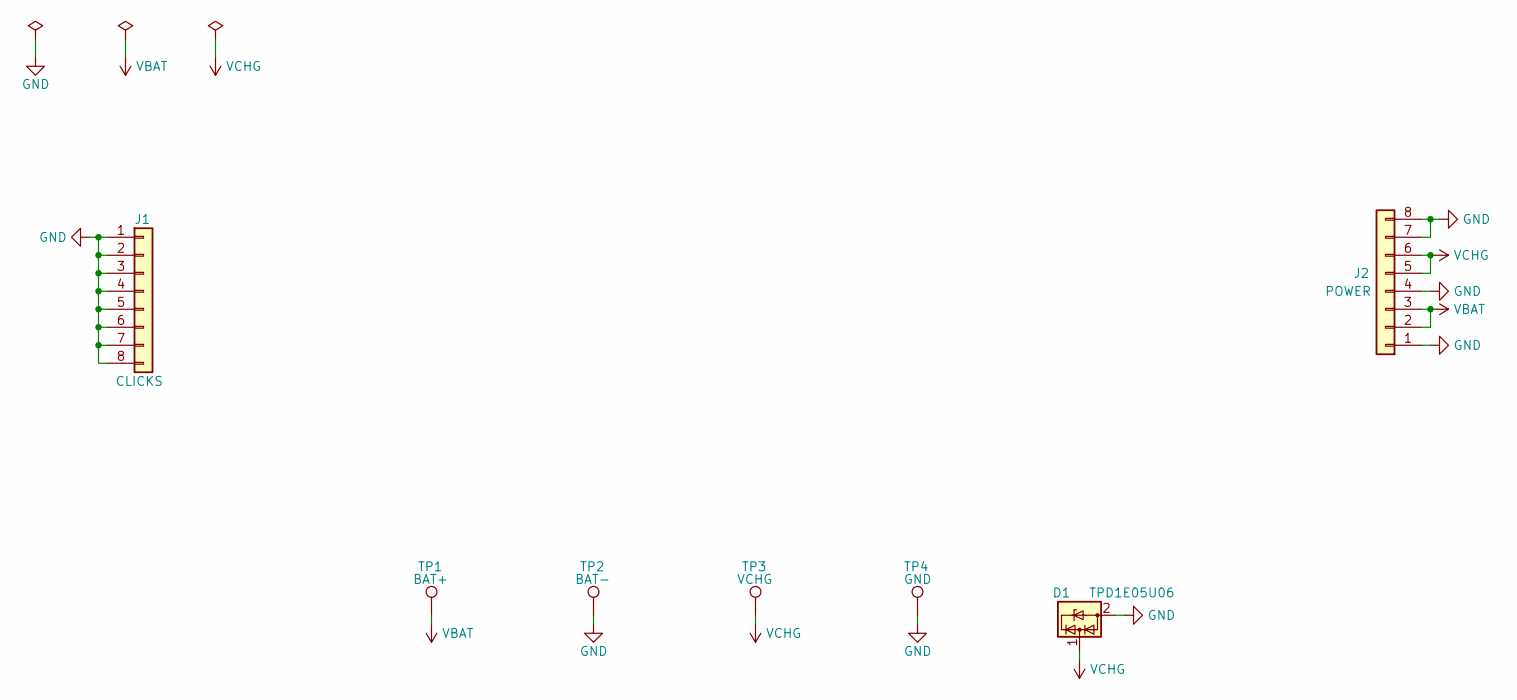
[picture p243: schematic signet_cell.kicad_sch]

Parts:
D1: TPD1E05U06; D_SOD-523
J1: CLICKS; Joint_Edge_1x08_P1.3mm
J2: POWER; Joint_Edge_1x08_P1.3mm
TP1: BAT+; TestPoint_Pad_1.5x1.5mm
TP2: BAT-; TestPoint_Pad_1.5x1.5mm
TP3: VCHG; TestPoint_Pad_D2.0mm
TP4: GND; TestPoint_Pad_D2.0mm

Connections:
GND: D1.2 (GND), J1.1, J1.2, J1.3, J1.4, J1.5, J1.6, J1.7, J1.8, J2.1, J2.4, J2.7, J2.8, TP2.1, TP4.1
VBAT: J2.2, J2.3, TP1.1
VCHG: D1.1 (I/O), J2.5, J2.6, TP3.1

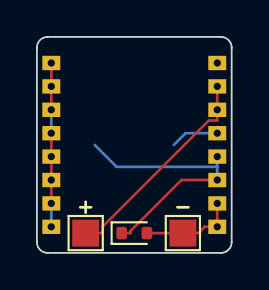
[picture p244: board examples/ring-mouse/v0.3/cell/signet_cell.kicad_pcb from above]

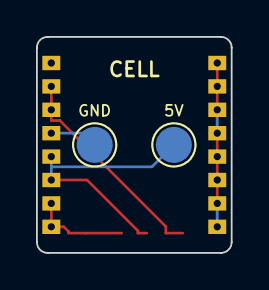
[picture p245: board examples/ring-mouse/v0.3/cell/signet_cell.kicad_pcb from below]

Board: 4 copper layers, 10.8 x 12.0 mm, 7 parts (2 on the bottom side), 3 nets.
