ThyFriendlyFox/via/examples/anc-speaker/v0.1/hush.kicad_pcb

## KiCad design examples/anc-speaker/v0.1/hush.kicad_pcb (2026-11-14)

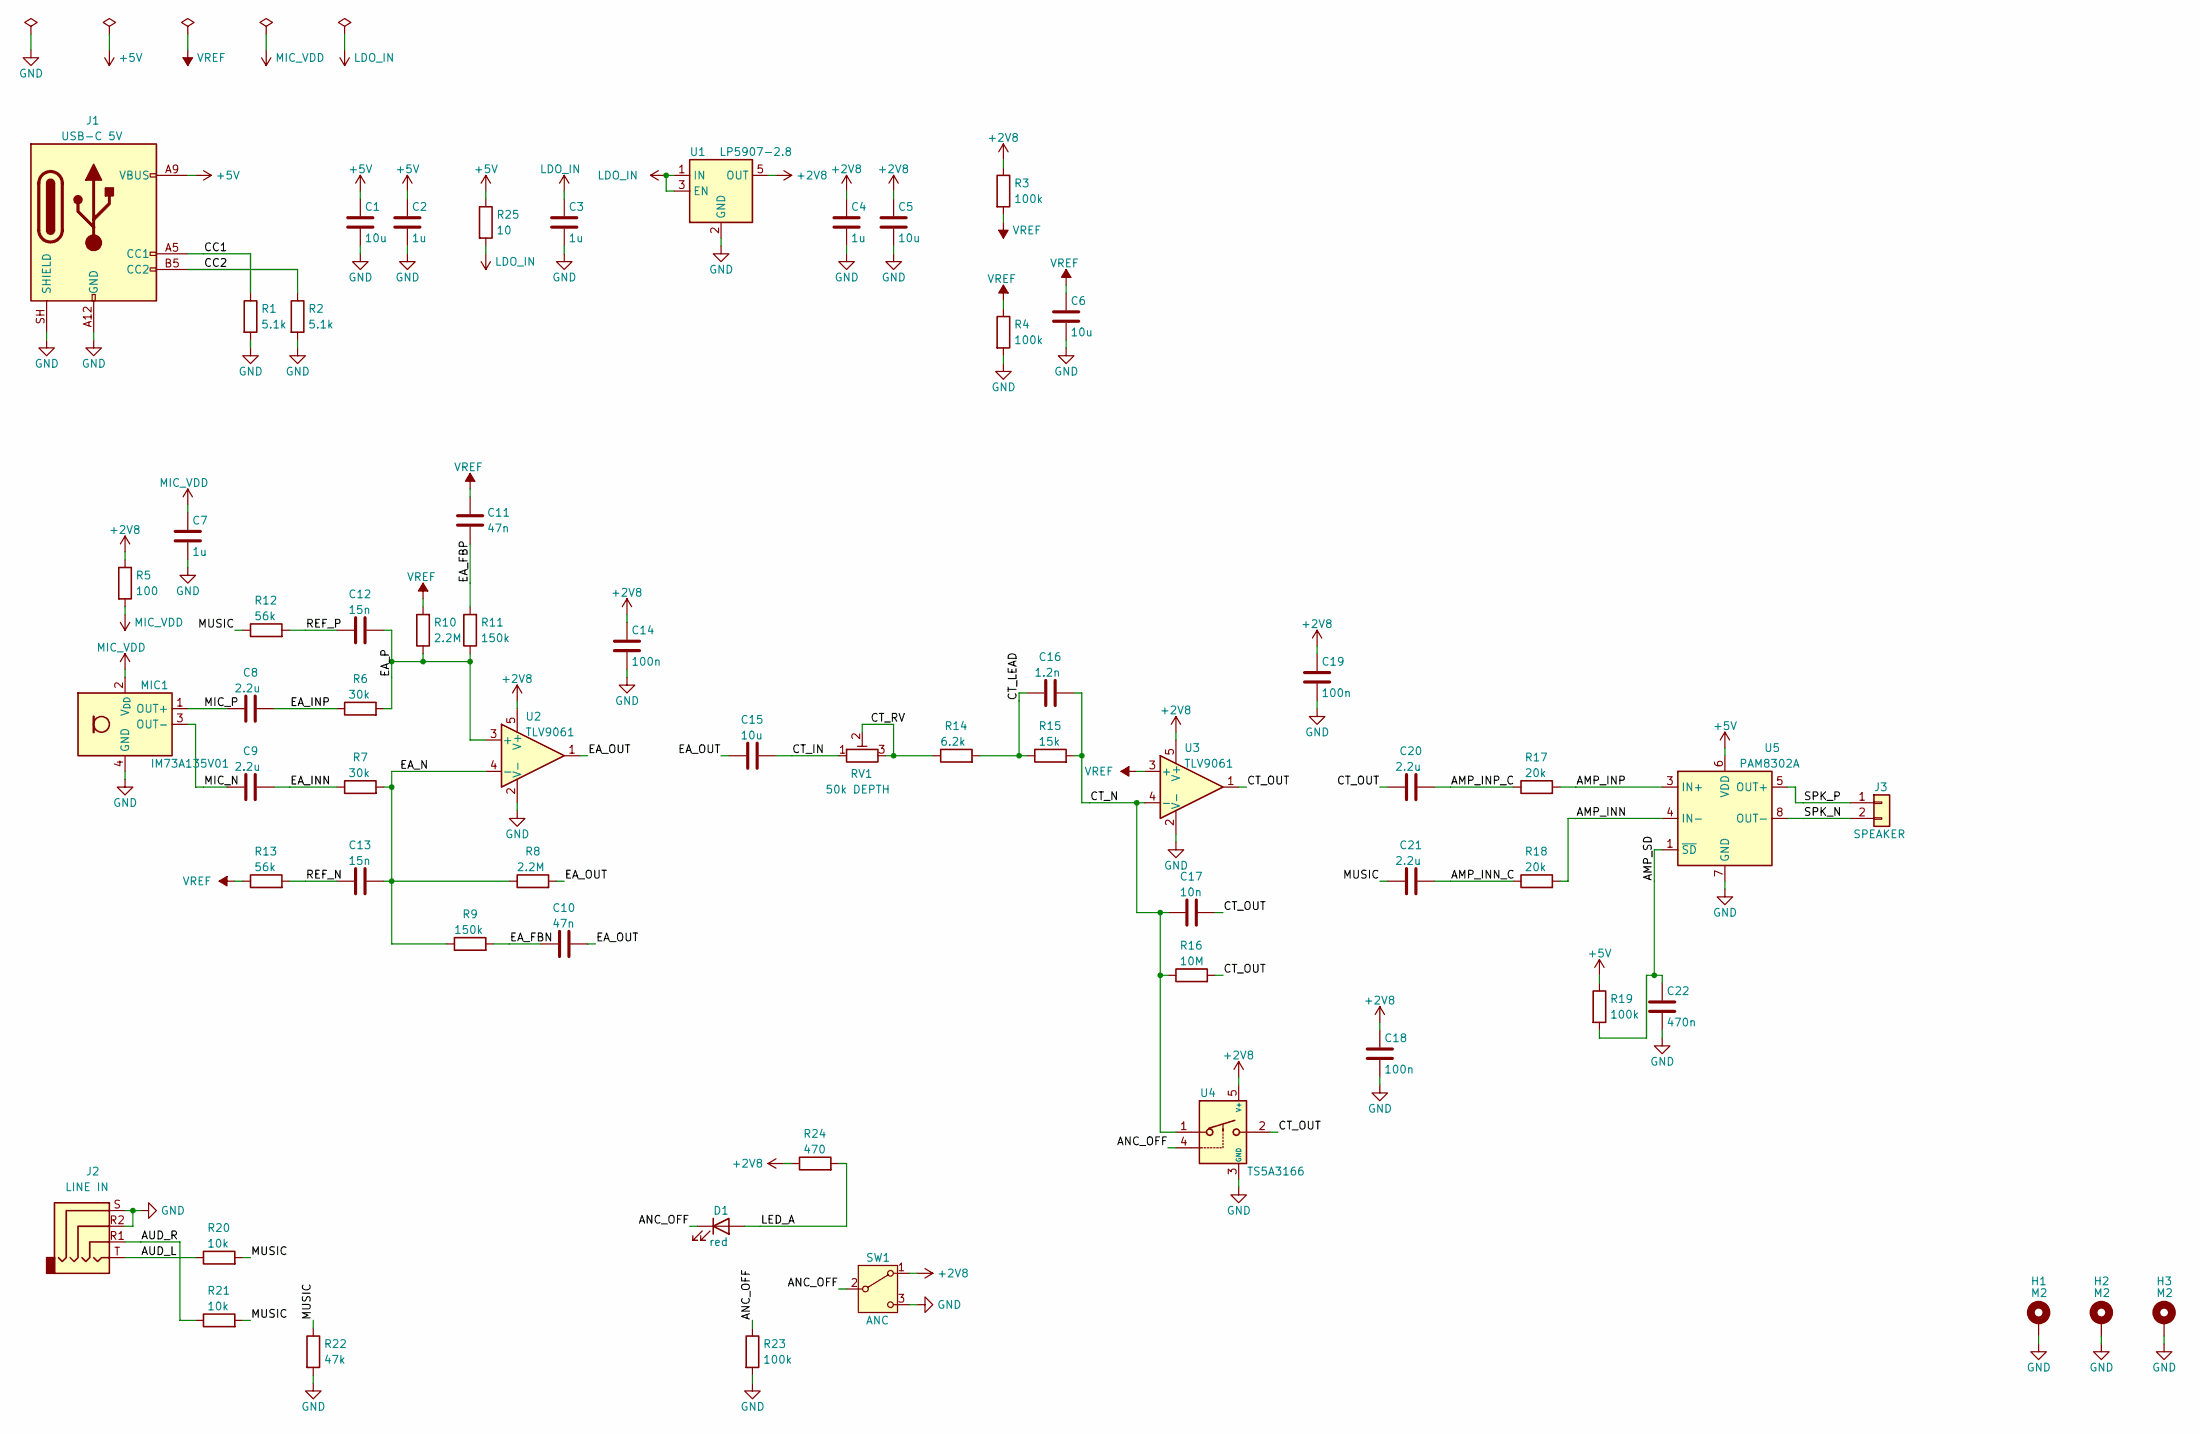
[picture p246: schematic hush.kicad_sch]

Parts:
C1: 10u; C_0805_2012Metric
C2, C3, C4, C7: 1u; C_0402_1005Metric
C5, C6, C15: 10u; C_0603_1608Metric
C8, C9, C20, C21: 2.2u; C_0402_1005Metric
C10, C11: 47n; C_0603_1608Metric
C12, C13: 15n; C_0402_1005Metric
C14, C18, C19: 100n; C_0402_1005Metric
C16: 1.2n; C_0402_1005Metric
C17: 10n; C_0402_1005Metric
C22: 470n; C_0402_1005Metric
D1: red; LED_0603_1608Metric
H1, H2, H3: M2; MountingHole_2.2mm_M2_ISO7380_Pad
J1: USB-C 5V; USB_C_Receptacle_GCT_USB4125-xx-x_6P_TopMnt_Horizontal
J2: LINE IN; Jack_3.5mm_PJ320D_Horizontal
J3: SPEAKER; SolderWire-0.25sqmm_1x02_P4.2mm_D0.65mm_OD1.7mm
MIC1: IM73A135V01; Infineon_PG-LLGA-5-2
R1, R2: 5.1k; R_0402_1005Metric
R3, R4, R19, R23: 100k; R_0402_1005Metric
R5: 100; R_0402_1005Metric
R6, R7: 30k; R_0402_1005Metric
R8, R10: 2.2M; R_0402_1005Metric
R9, R11: 150k; R_0402_1005Metric
R12, R13: 56k; R_0402_1005Metric
R14: 6.2k; R_0402_1005Metric
R15: 15k; R_0402_1005Metric
R16: 10M; R_0402_1005Metric
R17, R18: 20k; R_0402_1005Metric
R20, R21: 10k; R_0402_1005Metric
R22: 47k; R_0402_1005Metric
R24: 470; R_0402_1005Metric
R25: 10; R_0402_1005Metric
RV1: 50k DEPTH; Potentiometer_Bourns_TC33X_Vertical
SW1: ANC; SW_SPDT_PCM12
U1: LP5907-2.8; SOT-23-5
U2, U3: TLV9061; SOT-23-5
U4: TS5A3166; SOT-353_SC-70-5
U5: PAM8302A; MSOP-8_3x3mm_P0.65mm

Connections:
+2V8: C4.1, C5.1, C14.1, C18.1, C19.1, R3.1, R5.1, R24.1, SW1.1 (A), U1.5 (OUT), U2.5 (V+), U3.5 (V+), U4.5 (V+)
+5V: C1.1, C2.1, J1.A9 (VBUS), J1.B9 (VBUS), R19.1, R25.1, U5.6 (VDD)
/AMP_INN: R18.2, U5.4 (IN-)
/AMP_INN_C: C21.2, R18.1
/AMP_INP: R17.2, U5.3 (IN+)
/AMP_INP_C: C20.2, R17.1
/AMP_SD: C22.1, R19.2, U5.1 (~SD)
/ANC_OFF: D1.1 (K), R23.1, SW1.2 (B), U4.4
/AUD_L: J2.T, R20.1
/AUD_R: J2.R1, R21.1
/CC1: J1.A5 (CC1), R1.1
/CC2: J1.B5 (CC2), R2.1
/CT_IN: C15.2, RV1.1
/CT_LEAD: C16.1, R14.2, R15.1
/CT_N: C16.2, C17.1, R15.2, R16.1, U3.4 (-), U4.1
/CT_OUT: C17.2, C20.1, R16.2, U3.1, U4.2
/CT_RV: R14.1, RV1.2, RV1.3
/EA_FBN: C10.1, R9.2
/EA_FBP: C11.1, R11.2
/EA_INN: C9.2, R7.1
/EA_INP: C8.2, R6.1
/EA_N: C13.2, R7.2, R8.1, R9.1, U2.4 (-)
/EA_OUT: C10.2, C15.1, R8.2, U2.1
/EA_P: C12.2, R6.2, R10.1, R11.1, U2.3 (+)
/LED_A: D1.2 (A), R24.2
/MIC_N: C9.1, MIC1.3 (OUT-)
/MIC_P: C8.1, MIC1.1 (OUT+)
/MUSIC: C21.1, R12.1, R20.2, R21.2, R22.1
/REF_N: C13.1, R13.2
/REF_P: C12.1, R12.2
/SPK_N: J3.2, U5.8 (OUT-)
/SPK_P: J3.1, U5.5 (OUT+)
GND: C1.2, C2.2, C3.2, C4.2, C5.2, C6.2, C7.2, C14.2, C18.2, C19.2, C22.2, H1.1, H2.1, H3.1, J1.A12 (GND), J1.B12 (GND), J1.SH (SHIELD), J2.R2, J2.S, MIC1.4 (GND), MIC1.5 (GND), R1.2, R2.2, R4.2, R22.2, R23.2, SW1.3 (C), U1.2 (GND), U2.2 (V-), U3.2 (V-), U4.3 (GND), U5.7 (GND)
LDO_IN: C3.1, R25.2, U1.1 (IN), U1.3 (EN)
MIC_VDD: C7.1, MIC1.2 (V_{DD}), R5.2
VREF: C6.1, C11.2, R3.2, R4.1, R10.2, R13.1, U3.3 (+)

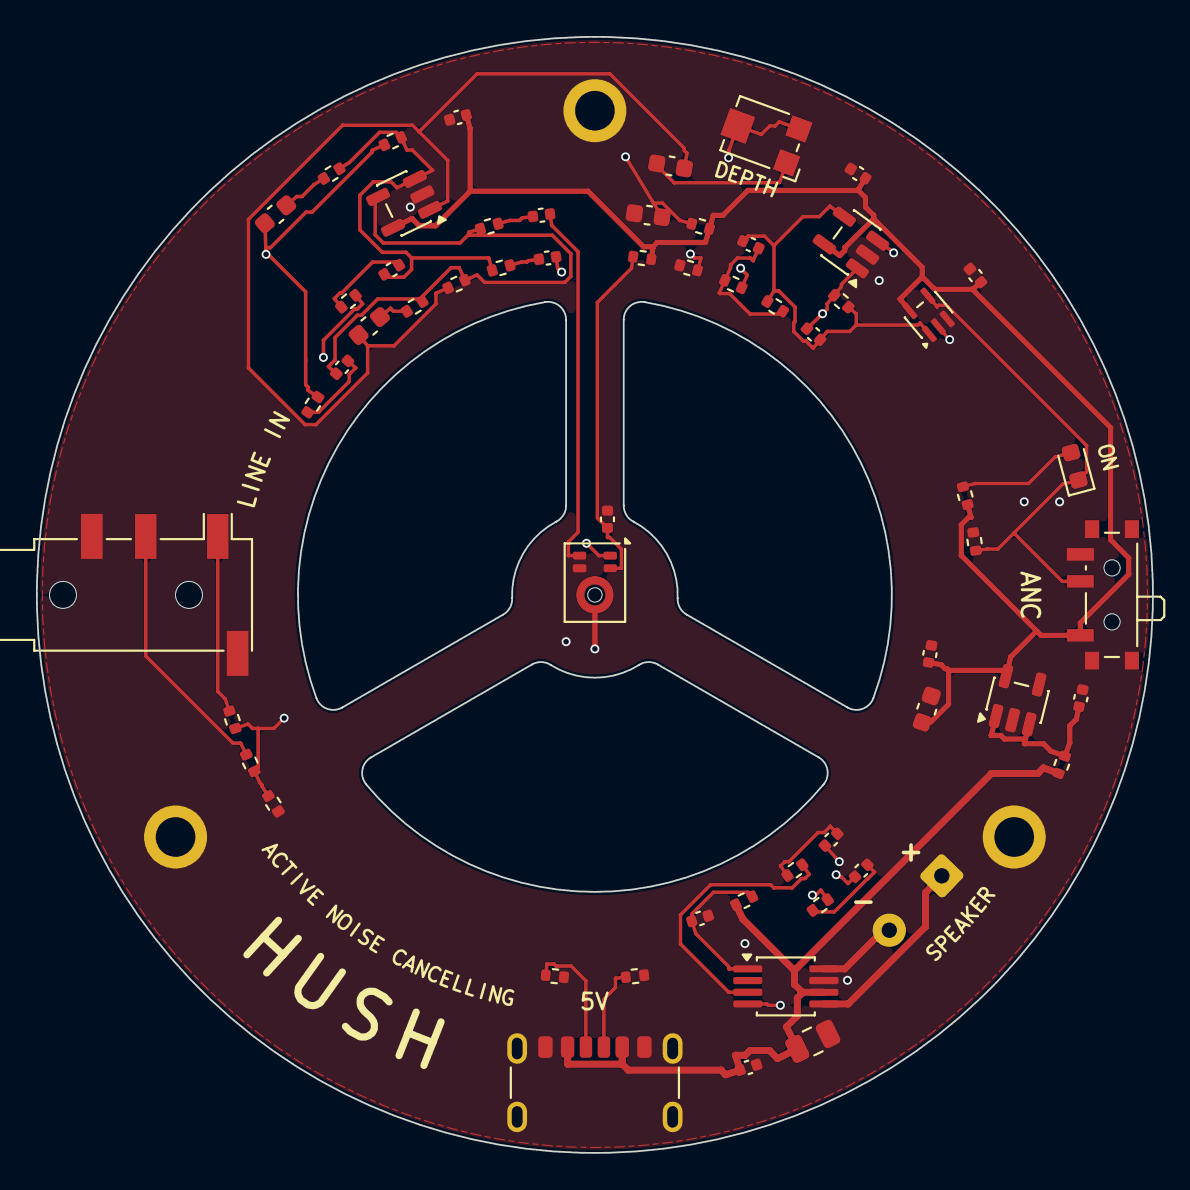
[picture p247: board hush.kicad_pcb from above]

Board: 4 copper layers, 62.0 x 62.0 mm, 62 parts (0 on the bottom side), 36 nets.
