ThyFriendlyFox/via/examples/ring-mouse/v0.3/touch/signet_touch.kicad_pcb

## KiCad design examples/ring-mouse/v0.3/touch/signet_touch.kicad_pcb (2026-11-14, an earlier design)

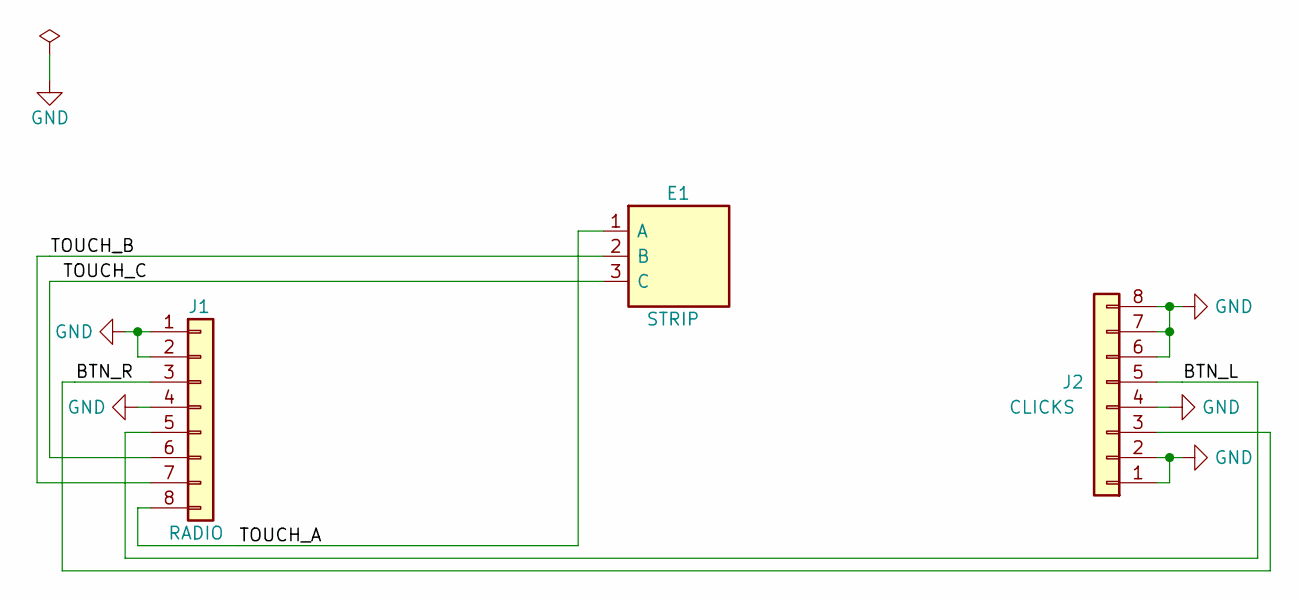
[picture p248: schematic signet_touch.kicad_sch]

Parts:
E1: STRIP; TouchStrip_3ch_6x
J1: RADIO; Joint_Edge_1x08_P1.3mm
J2: CLICKS; Joint_Edge_1x08_P1.3mm

Connections:
/BTN_L: J1.5, J2.5
/BTN_R: J1.3, J2.3
/TOUCH_A: E1.1 (A), J1.8
/TOUCH_B: E1.2 (B), J1.7
/TOUCH_C: E1.3 (C), J1.6
GND: J1.1, J1.2, J1.4, J2.1, J2.2, J2.4, J2.6, J2.7, J2.8

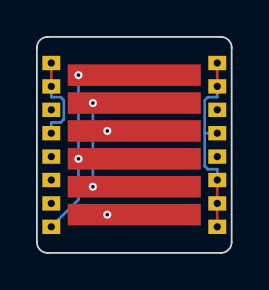
[picture p249: board signet_touch.kicad_pcb from above]

Board: 4 copper layers, 10.8 x 12.0 mm, 3 parts (0 on the bottom side), 6 nets.
