ThyFriendlyFox/via/tests/boards/pass-first-design/divider.kicad_pcb

## KiCad design tests/boards/pass-first-design/divider.kicad_pcb (2026-11-14)

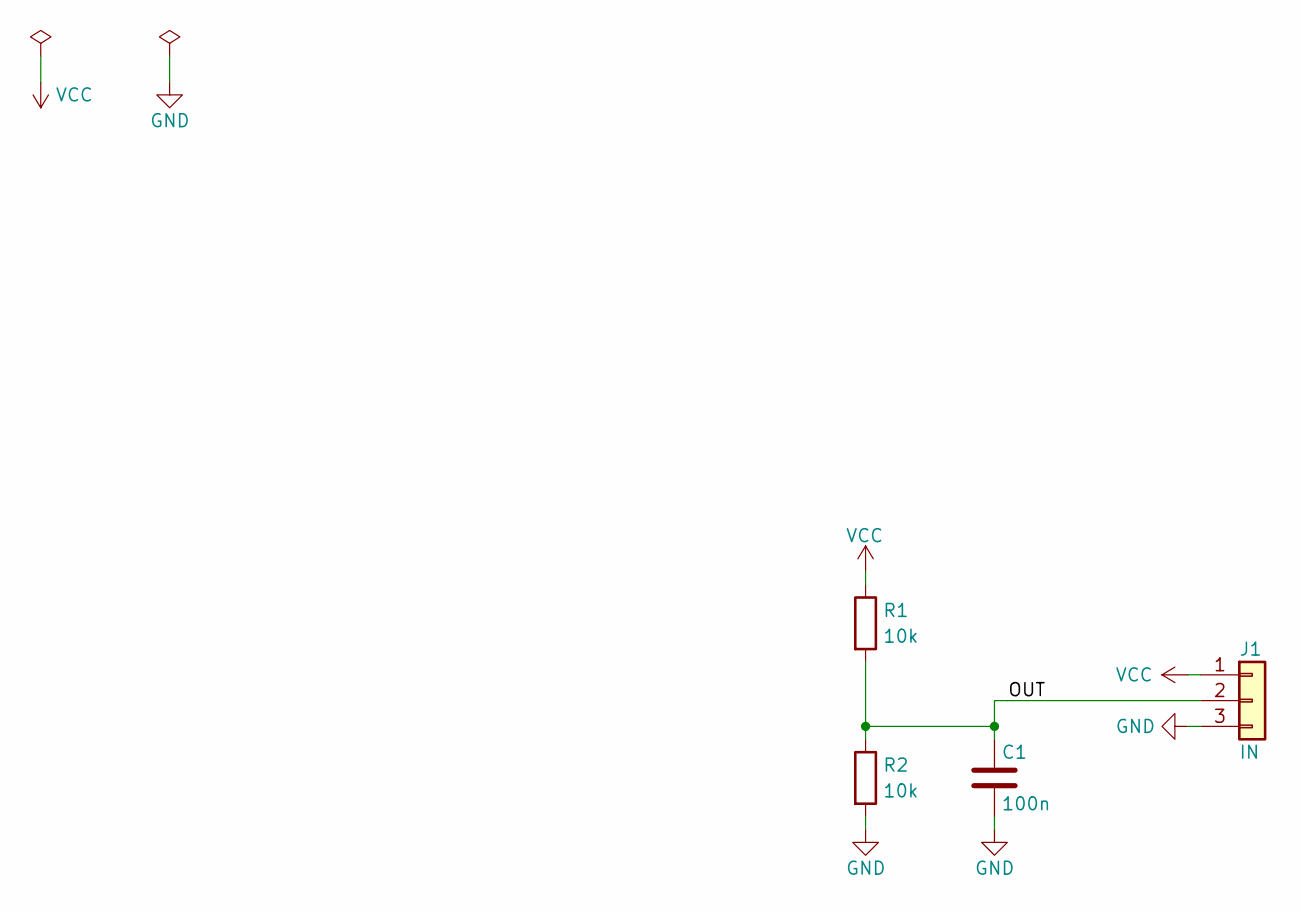
[picture p250: schematic divider.kicad_sch]

Parts:
C1: 100n; C_0603_1608Metric
J1: IN; PinHeader_1x03_P2.54mm_Vertical
R1, R2: 10k; R_0603_1608Metric

Connections:
/OUT: C1.1, J1.2, R1.2, R2.1
GND: C1.2, J1.3, R2.2
VCC: J1.1, R1.1

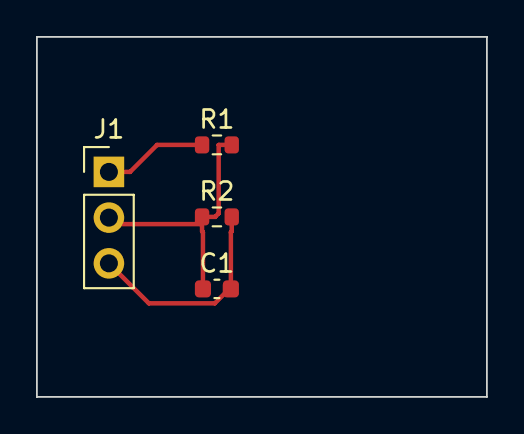
[picture p251: board divider.kicad_pcb from above]

Board: 2 copper layers, 25.0 x 20.0 mm, 4 parts (0 on the bottom side), 3 nets.
