ThyFriendlyFox/via/examples/snapdragon-dev-board/v0.1/wyvern.kicad_pcb

## KiCad design examples/snapdragon-dev-board/v0.1/wyvern.kicad_pcb (2026-11-14, an earlier design)

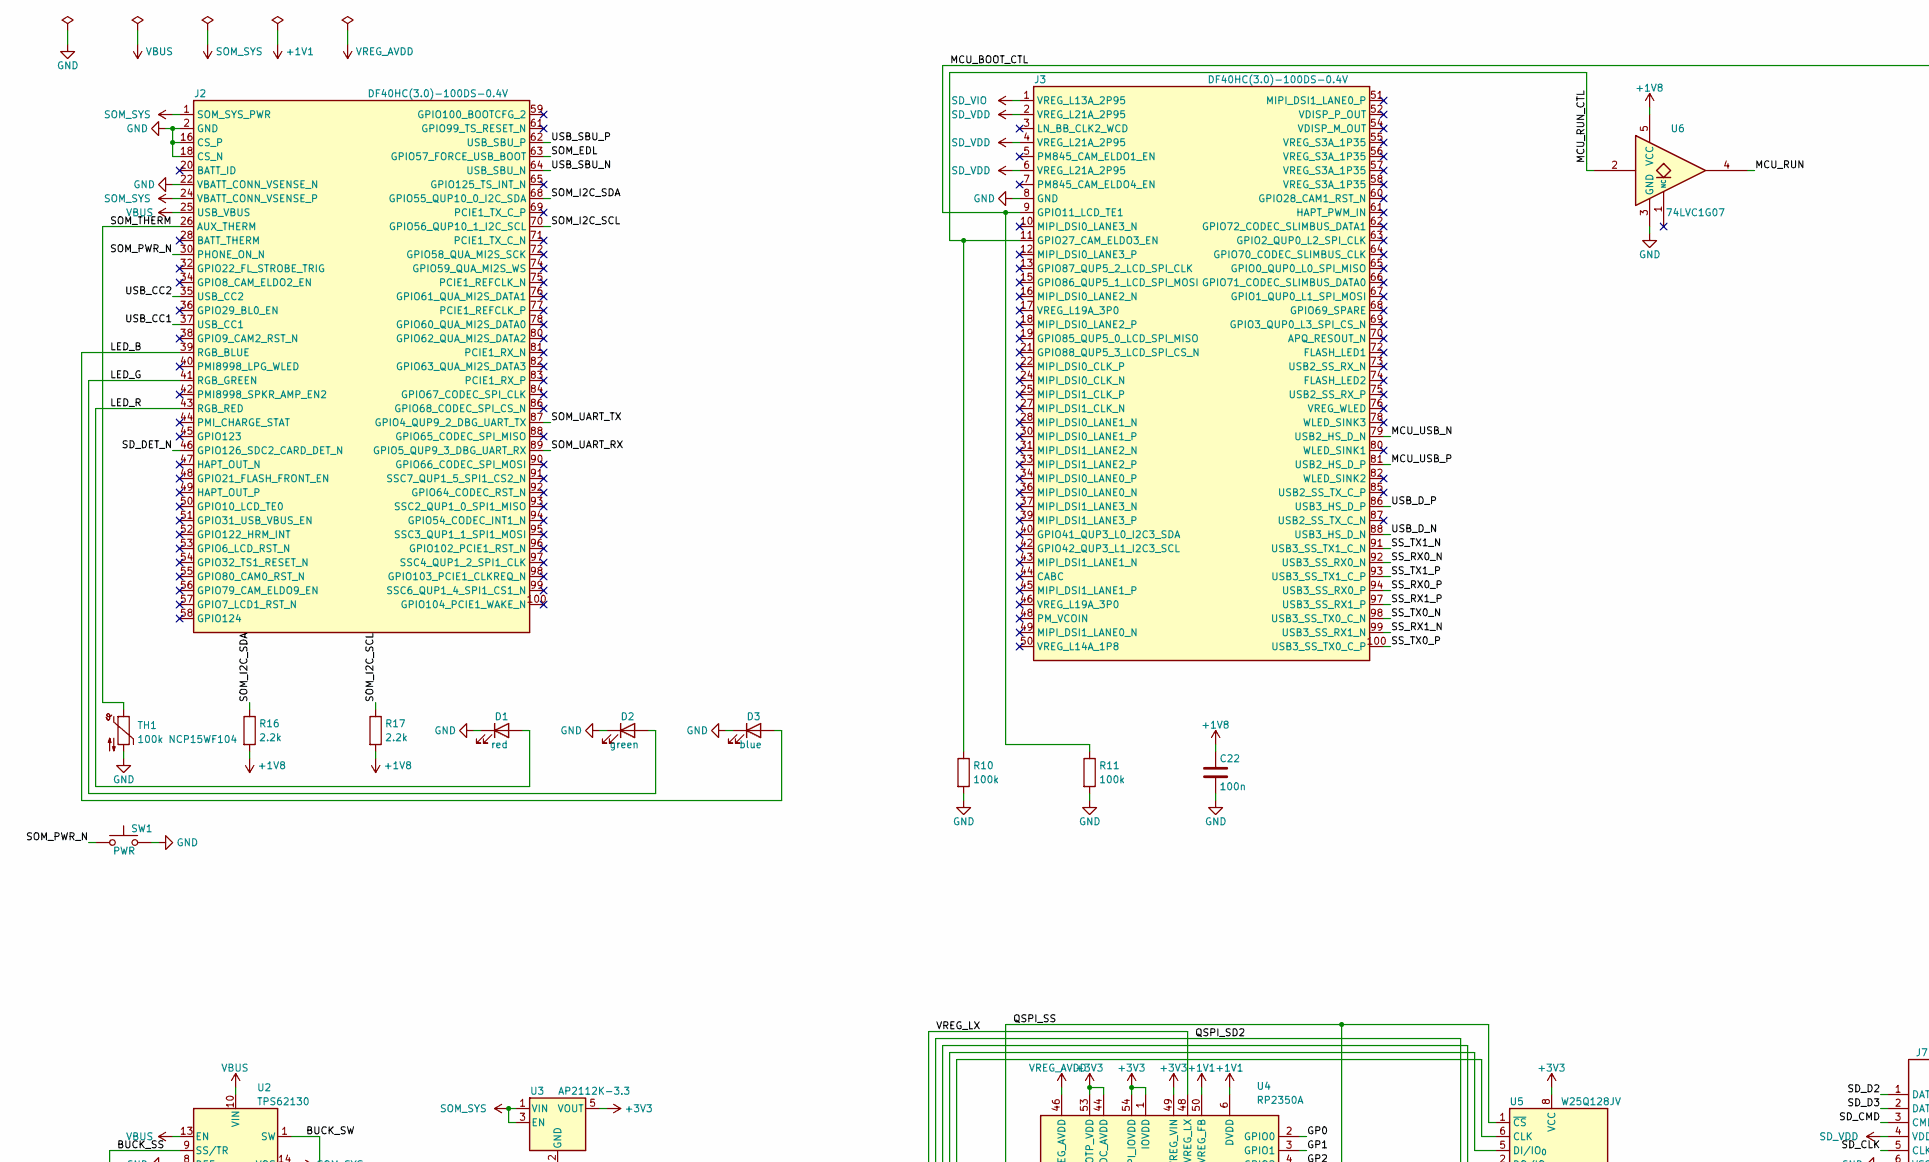
[picture p252: schematic wyvern.kicad_sch, part in row 1, column 1]

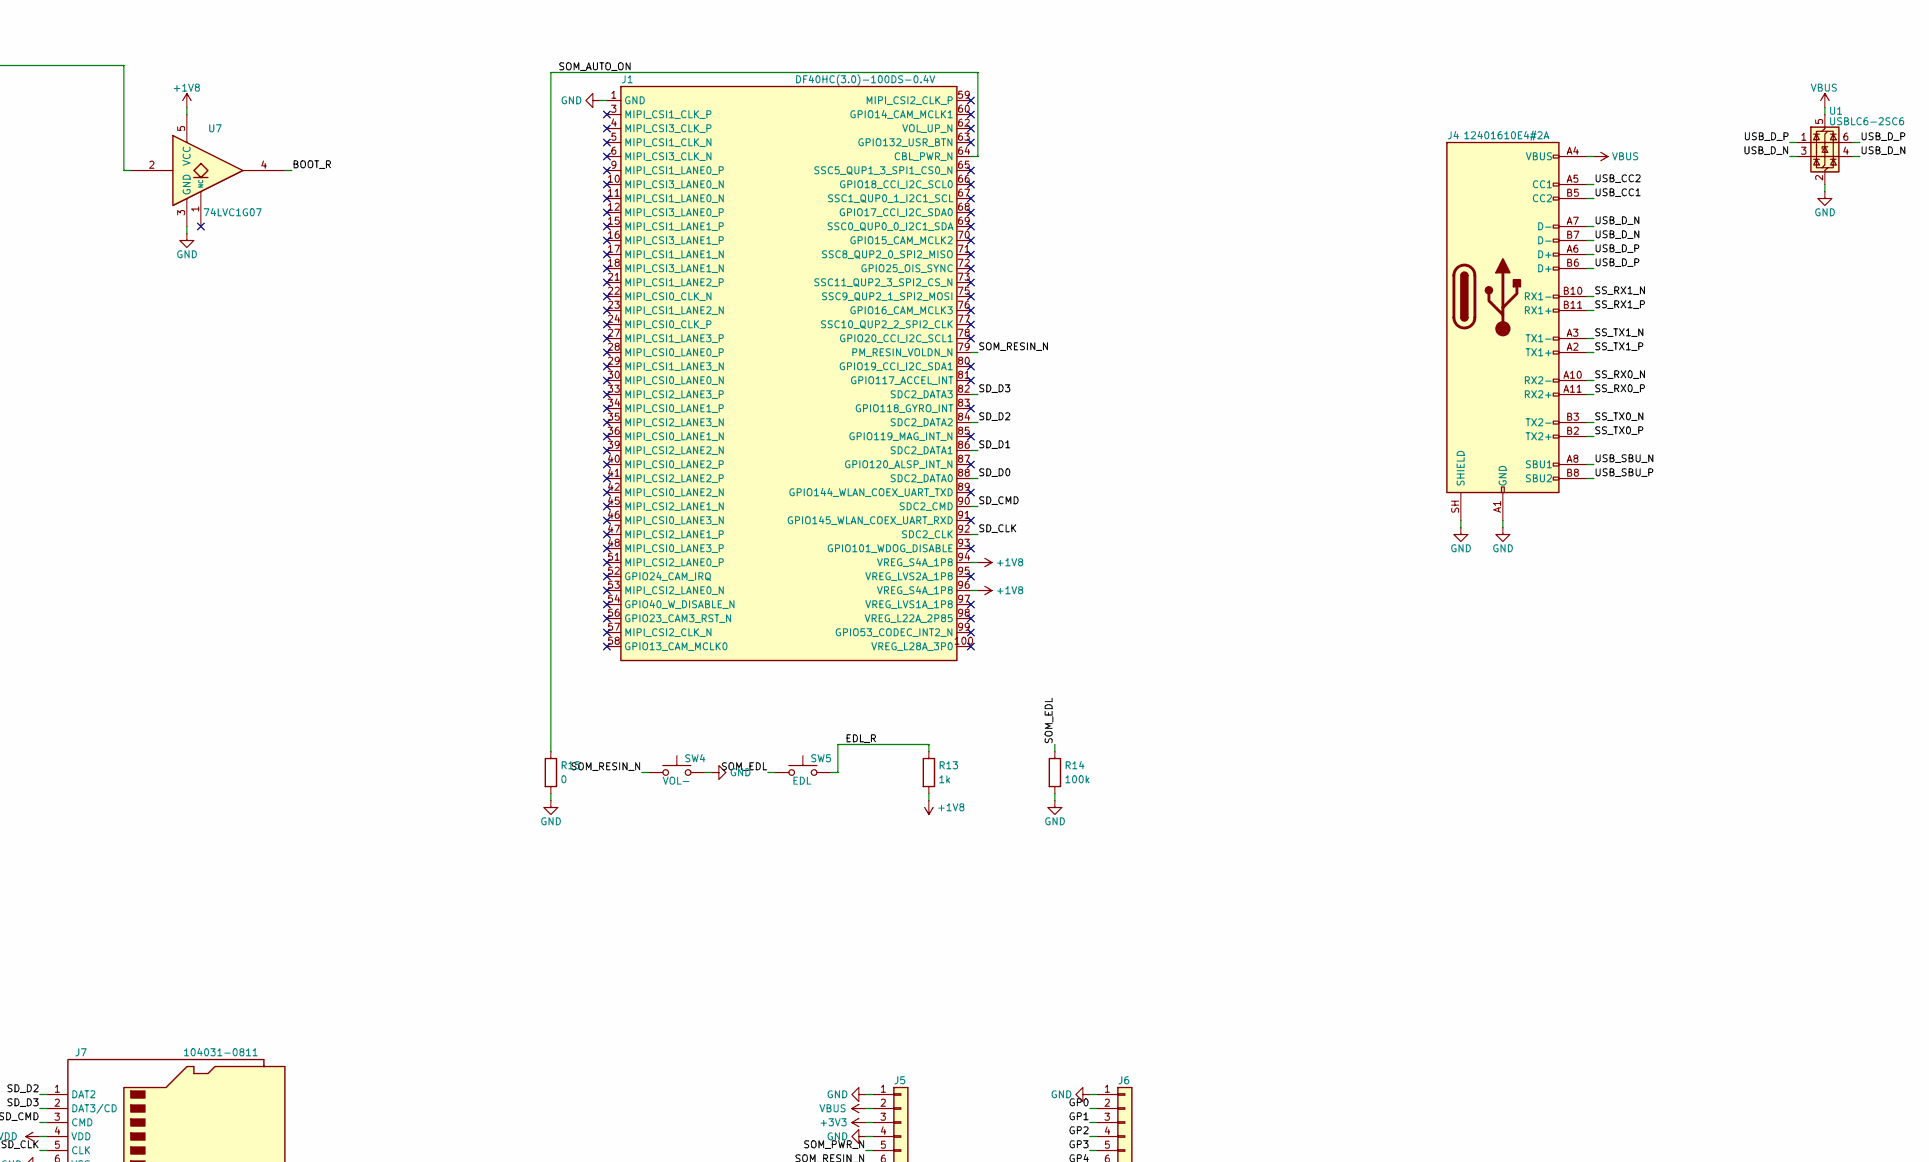
[picture p253: schematic wyvern.kicad_sch, part in row 1, column 2]

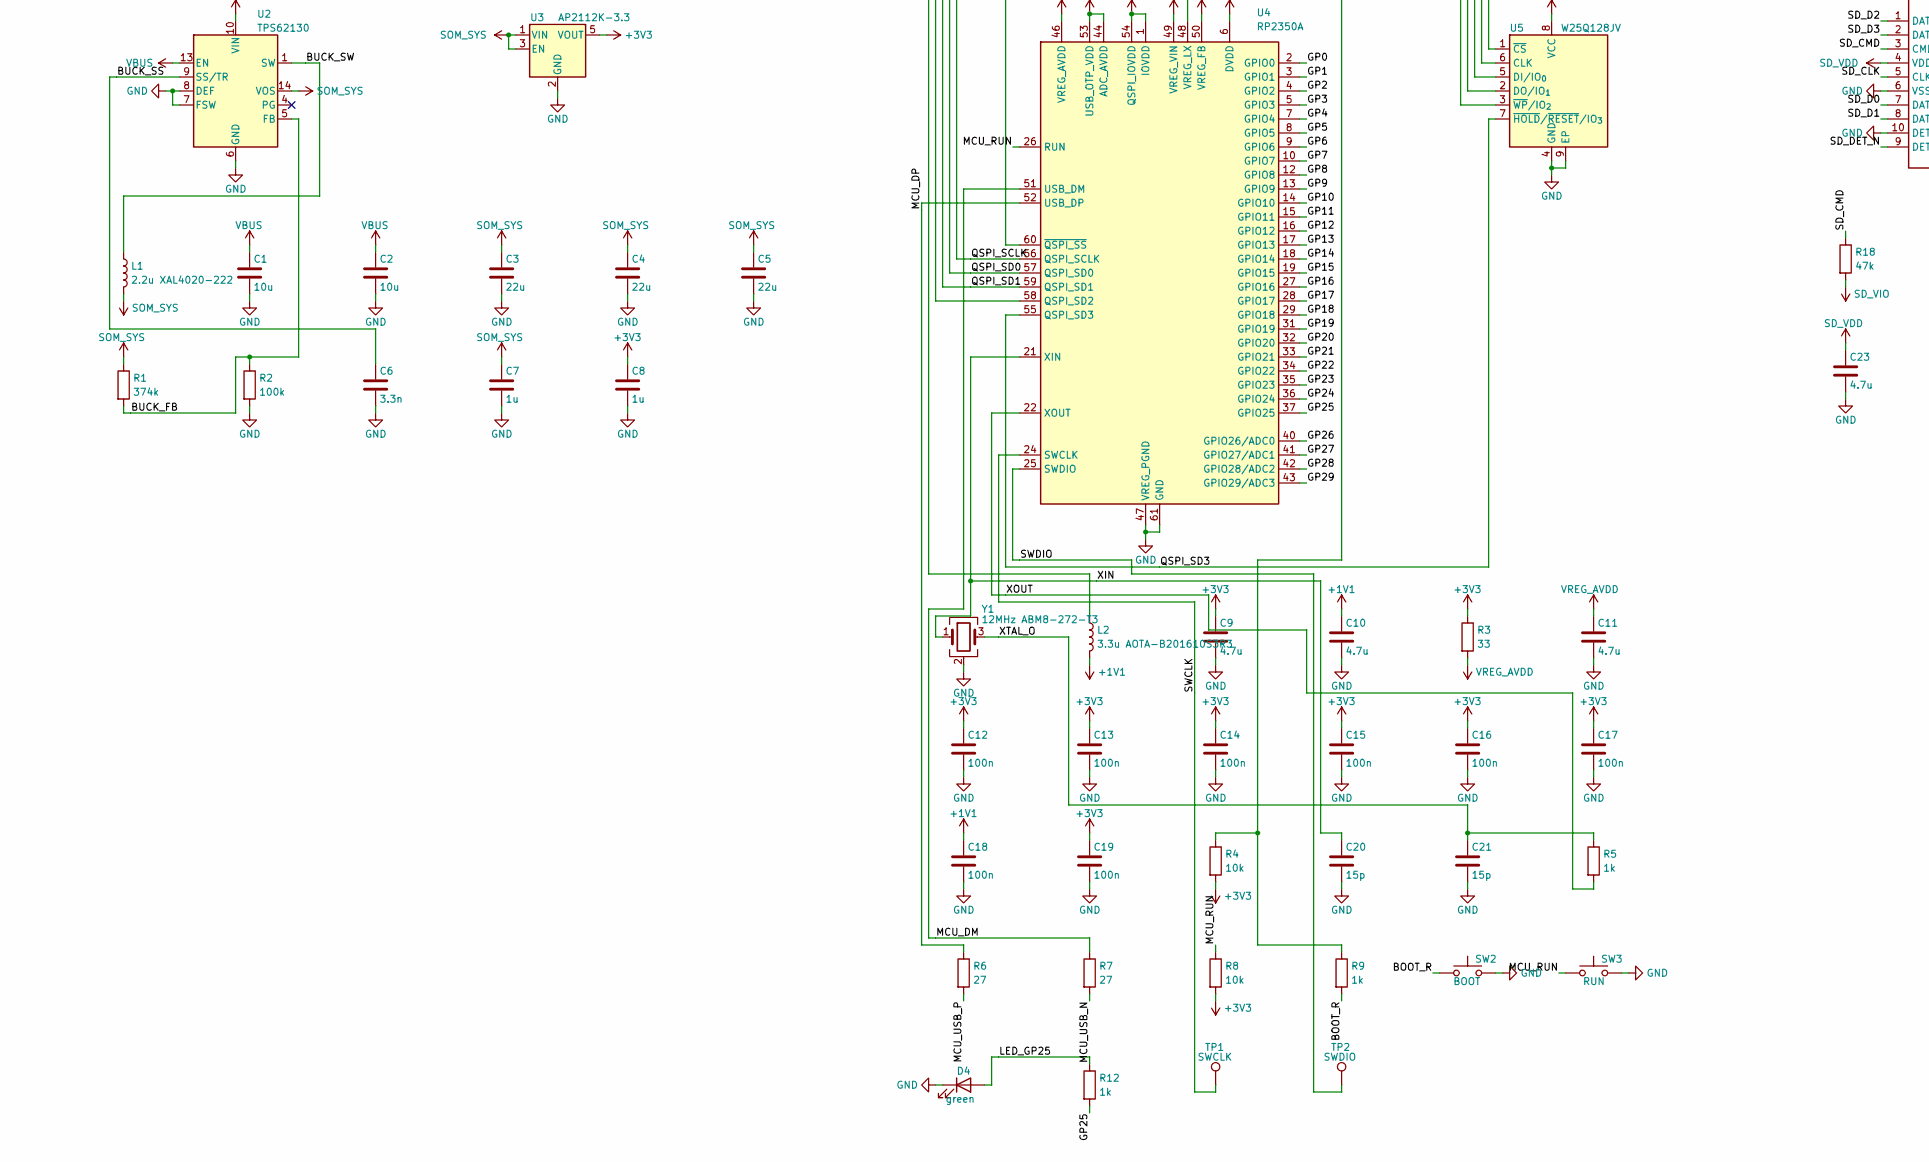
[picture p254: schematic wyvern.kicad_sch, part in row 2, column 1]

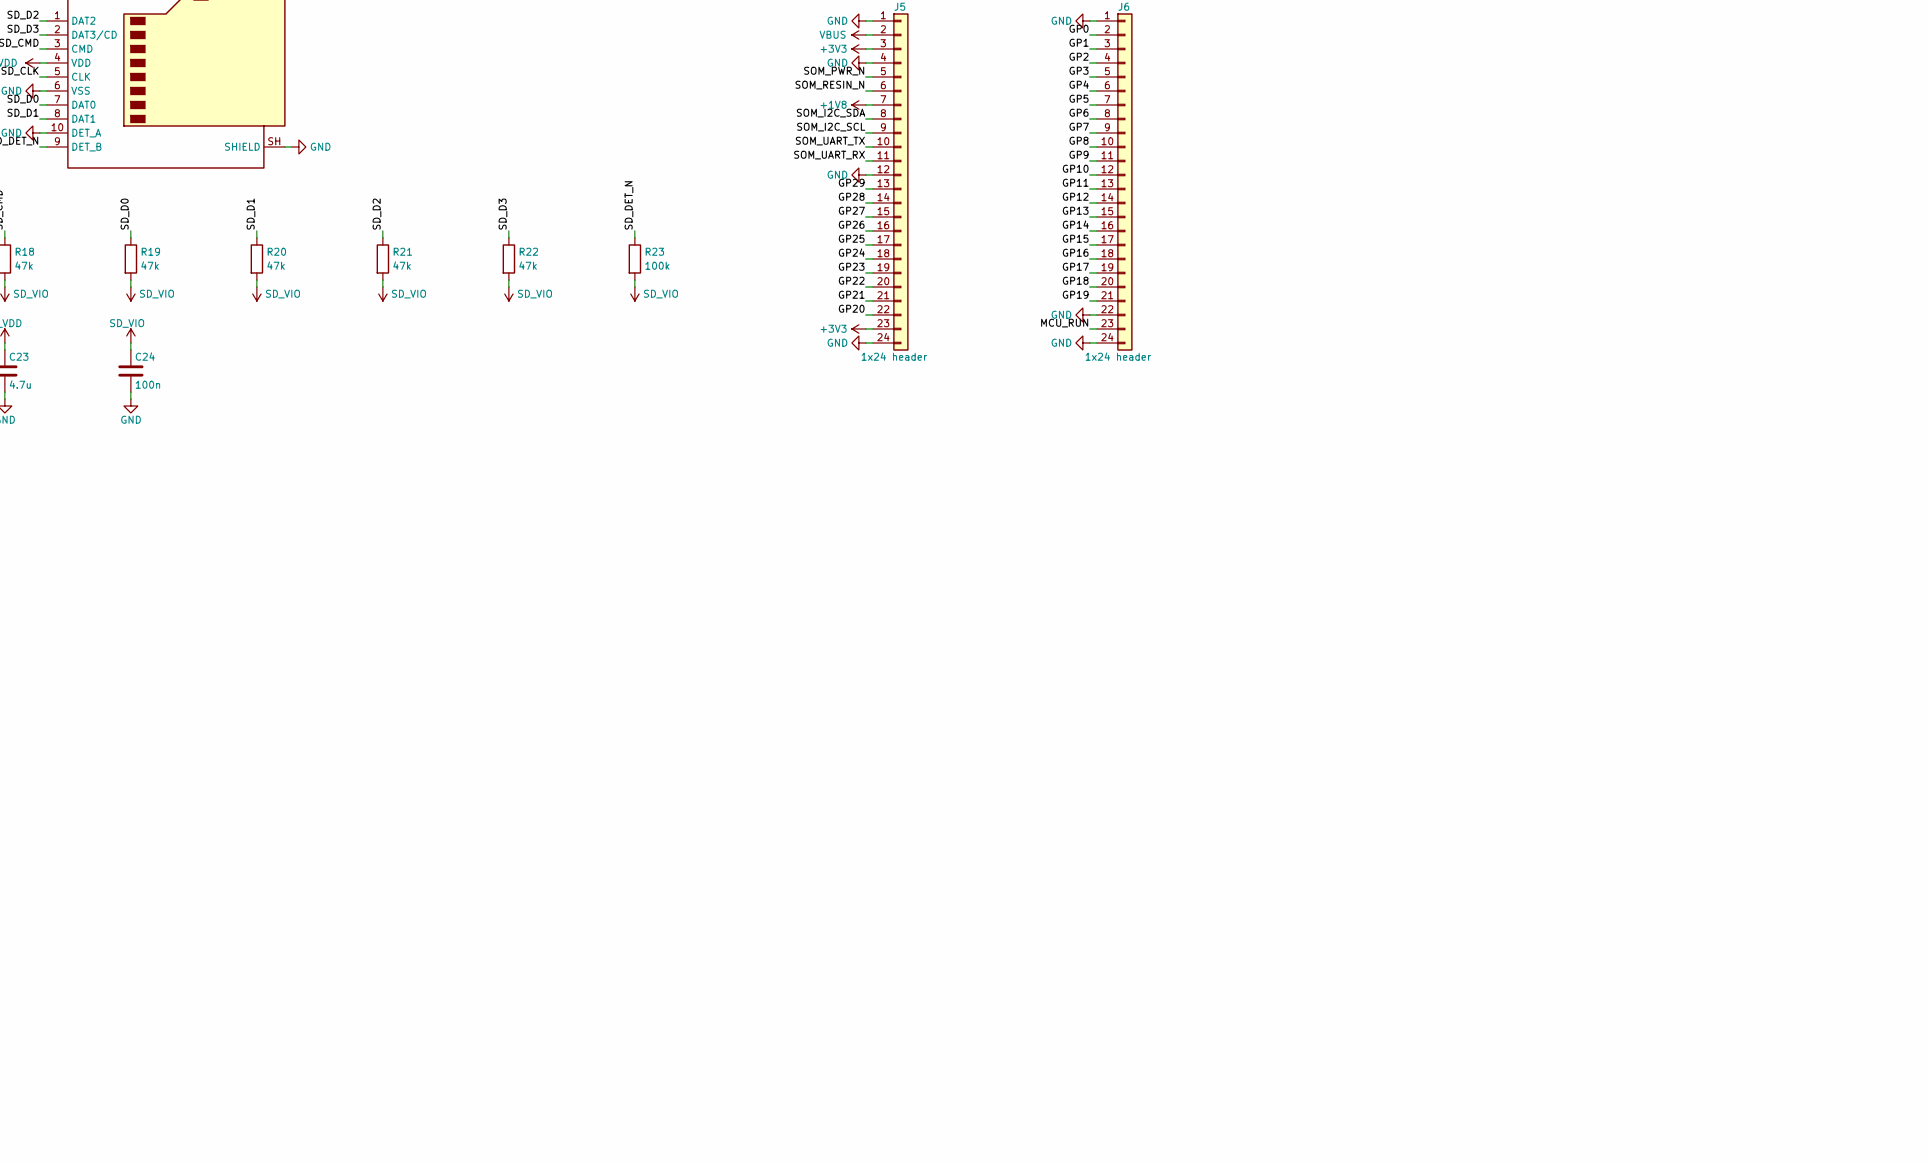
[picture p255: schematic wyvern.kicad_sch, part in row 2, column 2]

Parts:
C1, C2: 10u; C_0805_2012Metric
C3, C4, C5: 22u; C_0805_2012Metric
C6: 3.3n; C_0402_1005Metric
C7, C8: 1u; C_0402_1005Metric
C9, C10, C11: 4.7u; C_0402_1005Metric
C12, C13, C14, C15, C16, C17, C18, C19, C22, C24: 100n; C_0402_1005Metric
C20, C21: 15p; C_0402_1005Metric
C23: 4.7u; C_0603_1608Metric
D1: red; LED_0603_1608Metric
D2, D4: green; LED_0603_1608Metric
D3: blue; LED_0603_1608Metric
J1, J2, J3: DF40HC(3.0)-100DS-0.4V; Hirose_DF40HC(3.0)-100DS-0.4V_2x50_P0.4mm_SOM
J4: 12401610E4#2A; USB_C_Receptacle_Amphenol_12401610E4-2A_Ring6mil
J5, J6: 1x24 header; PinHeader_1x24_P2.54mm_Vertical
J7: 104031-0811; microSD_HC_Molex_104031-0811
L1: 2.2u XAL4020-222; L_Coilcraft_XAL4020-XXX
L2: 3.3u AOTA-B201610S3R3; L_Abracon_AOTA-B201610S
R1: 374k; R_0402_1005Metric
R2, R10, R11, R14, R23: 100k; R_0402_1005Metric
R3: 33; R_0402_1005Metric
R4, R8: 10k; R_0402_1005Metric
R5, R9, R12, R13: 1k; R_0402_1005Metric
R6, R7: 27; R_0402_1005Metric
R15: 0; R_0402_1005Metric
R16, R17: 2.2k; R_0402_1005Metric
R18, R19, R20, R21, R22: 47k; R_0402_1005Metric
SW1: PWR; SW_Push_1P1T_NO_CK_KMR2
SW2: BOOT; SW_Push_1P1T_NO_CK_KMR2
SW3: RUN; SW_Push_1P1T_NO_CK_KMR2
SW4: VOL-; SW_Push_1P1T_NO_CK_KMR2
SW5: EDL; SW_Push_1P1T_NO_CK_KMR2
TH1: 100k NCP15WF104; R_0402_1005Metric
TP1: SWCLK; TestPoint_Pad_D1.0mm
TP2: SWDIO; TestPoint_Pad_D1.0mm
U1: USBLC6-2SC6; SOT-23-6
U2: TPS62130; VQFN-16-1EP_3x3mm_P0.5mm_EP1.68x1.68mm
U3: AP2112K-3.3; SOT-23-5
U4: RP2350A; QFN-60-1EP_7x7mm_P0.4mm_EP3.4x3.4mm
U5: W25Q128JV; WSON-8-1EP_6x5mm_P1.27mm_EP3.4x4.3mm
U6, U7: 74LVC1G07; SOT-353_SC-70-5
Y1: 12MHz ABM8-272-T3; Crystal_SMD_3225-4Pin_3.2x2.5mm

Connections:
+1V1: C10.1, C18.1, L2.2, U4.6 (DVDD), U4.23 (DVDD), U4.39 (DVDD), U4.50 (VREG_FB)
+1V8: C22.1, J1.94 (VREG_S4A_1P8), J1.96 (VREG_S4A_1P8), J5.7, R13.2, R16.2, R17.2, U6.5 (VCC), U7.5 (VCC)
+3V3: C8.1, C9.1, C12.1, C13.1, C14.1, C15.1, C16.1, C17.1, C19.1, J5.3, J5.23, R3.1, R4.2, R8.2, U3.5 (VOUT), U4.1 (IOVDD), U4.11 (IOVDD), U4.20 (IOVDD), U4.30 (IOVDD), U4.38 (IOVDD), U4.44 (ADC_AVDD), U4.45 (IOVDD), U4.49 (VREG_VIN), U4.53 (USB_OTP_VDD), U4.54 (QSPI_IOVDD), U5.8 (VCC)
/BOOT_R: R9.2, SW2.1, U7.4
/BUCK_FB: R1.2, R2.1, U2.5 (FB)
/BUCK_SS: C6.1, U2.9 (SS/TR)
/BUCK_SW: L1.1, U2.1 (SW), U2.2 (SW), U2.3 (SW)
/EDL_R: R13.1, SW5.2
/GP0: J6.2, U4.2 (GPIO0)
/GP1: J6.3, U4.3 (GPIO1)
/GP2: J6.4, U4.4 (GPIO2)
/GP3: J6.5, U4.5 (GPIO3)
/GP4: J6.6, U4.7 (GPIO4)
/GP5: J6.7, U4.8 (GPIO5)
/GP6: J6.8, U4.9 (GPIO6)
/GP7: J6.9, U4.10 (GPIO7)
/GP8: J6.10, U4.12 (GPIO8)
/GP9: J6.11, U4.13 (GPIO9)
/GP10: J6.12, U4.14 (GPIO10)
/GP11: J6.13, U4.15 (GPIO11)
/GP12: J6.14, U4.16 (GPIO12)
/GP13: J6.15, U4.17 (GPIO13)
/GP14: J6.16, U4.18 (GPIO14)
/GP15: J6.17, U4.19 (GPIO15)
/GP16: J6.18, U4.27 (GPIO16)
/GP17: J6.19, U4.28 (GPIO17)
/GP18: J6.20, U4.29 (GPIO18)
/GP19: J6.21, U4.31 (GPIO19)
/GP20: J5.22, U4.32 (GPIO20)
/GP21: J5.21, U4.33 (GPIO21)
/GP22: J5.20, U4.34 (GPIO22)
/GP23: J5.19, U4.35 (GPIO23)
/GP24: J5.18, U4.36 (GPIO24)
/GP25: J5.17, R12.2, U4.37 (GPIO25)
/GP26: J5.16, U4.40 (GPIO26/ADC0)
/GP27: J5.15, U4.41 (GPIO27/ADC1)
/GP28: J5.14, U4.42 (GPIO28/ADC2)
/GP29: J5.13, U4.43 (GPIO29/ADC3)
/LED_B: D3.2 (A), J2.39 (RGB_BLUE)
/LED_G: D2.2 (A), J2.41 (RGB_GREEN)
/LED_GP25: D4.2 (A), R12.1
/LED_R: D1.2 (A), J2.43 (RGB_RED)
/MCU_BOOT_CTL: J3.9 (GPIO11_LCD_TE1), R11.1, U7.2
/MCU_DM: R7.1, U4.51 (USB_DM)
/MCU_DP: R6.1, U4.52 (USB_DP)
/MCU_RUN: J6.23, R8.1, SW3.1, U4.26 (RUN), U6.4
/MCU_RUN_CTL: J3.11 (GPIO27_CAM_ELDO3_EN), R10.1, U6.2
/MCU_USB_N: J3.79 (USB2_HS_D_N), R7.2
/MCU_USB_P: J3.81 (USB2_HS_D_P), R6.2
/QSPI_SCLK: U4.56 (QSPI_SCLK), U5.6 (CLK)
/QSPI_SD0: U4.57 (QSPI_SD0), U5.5 (DI/IO_{0})
/QSPI_SD1: U4.59 (QSPI_SD1), U5.2 (DO/IO_{1})
/QSPI_SD2: U4.58 (QSPI_SD2), U5.3 (~WP/IO_{2})
/QSPI_SD3: U4.55 (QSPI_SD3), U5.7 (~HOLD/~RESET/IO_{3})
/QSPI_SS: R4.1, R9.1, U4.60 (~QSPI_SS), U5.1 (~CS)
/SD_CLK: J1.92 (SDC2_CLK), J7.5 (CLK)
/SD_CMD: J1.90 (SDC2_CMD), J7.3 (CMD), R18.1
/SD_D0: J1.88 (SDC2_DATA0), J7.7 (DAT0), R19.1
/SD_D1: J1.86 (SDC2_DATA1), J7.8 (DAT1), R20.1
/SD_D2: J1.84 (SDC2_DATA2), J7.1 (DAT2), R21.1
/SD_D3: J1.82 (SDC2_DATA3), J7.2 (DAT3/CD), R22.1
/SD_DET_N: J2.46 (GPIO126_SDC2_CARD_DET_N), J7.9 (DET_B), R23.1
/SOM_AUTO_ON: J1.64 (CBL_PWR_N), R15.1
/SOM_EDL: J2.63 (GPIO57_FORCE_USB_BOOT), R14.1, SW5.1
/SOM_I2C_SCL: J2.70 (GPIO56_QUP10_1_I2C_SCL), J5.9, R17.1
/SOM_I2C_SDA: J2.68 (GPIO55_QUP10_0_I2C_SDA), J5.8, R16.1
/SOM_PWR_N: J2.30 (PHONE_ON_N), J5.5, SW1.1
/SOM_RESIN_N: J1.79 (PM_RESIN_VOLDN_N), J5.6, SW4.1
/SOM_THERM: J2.26 (AUX_THERM), TH1.1
/SOM_UART_RX: J2.89 (GPIO5_QUP9_3_DBG_UART_RX), J5.11
/SOM_UART_TX: J2.87 (GPIO4_QUP9_2_DBG_UART_TX), J5.10
/SS_RX0_N: J3.92 (USB3_SS_RX0_N), J4.A10 (RX2-)
/SS_RX0_P: J3.94 (USB3_SS_RX0_P), J4.A11 (RX2+)
/SS_RX1_N: J3.99 (USB3_SS_RX1_N), J4.B10 (RX1-)
/SS_RX1_P: J3.97 (USB3_SS_RX1_P), J4.B11 (RX1+)
/SS_TX0_N: J3.98 (USB3_SS_TX0_C_N), J4.B3 (TX2-)
/SS_TX0_P: J3.100 (USB3_SS_TX0_C_P), J4.B2 (TX2+)
/SS_TX1_N: J3.91 (USB3_SS_TX1_C_N), J4.A3 (TX1-)
/SS_TX1_P: J3.93 (USB3_SS_TX1_C_P), J4.A2 (TX1+)
/SWCLK: TP1.1, U4.24 (SWCLK)
/SWDIO: TP2.1, U4.25 (SWDIO)
/USB_CC1: J2.37 (USB_CC1), J4.B5 (CC2)
/USB_CC2: J2.35 (USB_CC2), J4.A5 (CC1)
/USB_D_N: J3.88 (USB3_HS_D_N), J4.A7 (D-), J4.B7 (D-), U1.3 (I/O2), U1.4 (I/O2)
/USB_D_P: J3.86 (USB3_HS_D_P), J4.A6 (D+), J4.B6 (D+), U1.1 (I/O1), U1.6 (I/O1)
/USB_SBU_N: J2.64 (USB_SBU_N), J4.A8 (SBU1)
/USB_SBU_P: J2.62 (USB_SBU_P), J4.B8 (SBU2)
/VREG_LX: L2.1, U4.48 (VREG_LX)
/XIN: C20.1, U4.21 (XIN), Y1.1
/XOUT: R5.2, U4.22 (XOUT)
/XTAL_O: C21.1, R5.1, Y1.3
GND: C1.2, C2.2, C3.2, C4.2, C5.2, C6.2, C7.2, C8.2, C9.2, C10.2, C11.2, C12.2, C13.2, C14.2, C15.2, C16.2, C17.2, C18.2, C19.2, C20.2, C21.2, C22.2, C23.2, C24.2, D1.1 (K), D2.1 (K), D3.1 (K), D4.1 (K), J1.1 (GND), J1.2 (GND), J1.7 (GND), J1.8 (GND), J1.13 (GND), J1.14 (GND), J1.19 (GND), J1.20 (GND), J1.25 (GND), J1.26 (GND), J1.31 (GND), J1.32 (GND), J1.37 (GND), J1.38 (GND), J1.43 (GND), J1.44 (GND), J1.49 (GND), J1.50 (GND), J1.55 (GND), J1.61 (GND), J1.74 (GND), J2.2 (GND), J2.4 (GND), J2.16 (CS_P), J2.18 (CS_N), J2.22 (VBATT_CONN_VSENSE_N), J2.60 (GND), J2.66 (GND), J2.67 (GND), J2.73 (GND), J2.79 (GND), J2.85 (GND), J3.8 (GND), J3.14 (GND), J3.20 (GND), J3.23 (GND), J3.26 (GND), J3.29 (GND), J3.32 (GND), J3.35 (GND), J3.38 (GND), J3.41 (GND), J3.47 (GND), J3.53 (GND), J3.59 (GND), J3.71 (GND), J3.77 (GND), J3.83 (GND), J3.84 (GND), J3.89 (GND), J3.90 (GND), J3.95 (GND), J3.96 (GND), J4.A1 (GND), J4.A12 (GND), J4.B1 (GND), J4.B12 (GND), J4.SH (SHIELD), J5.1, J5.4, J5.12, J5.24, J6.1, J6.22, J6.24, J7.6 (VSS), J7.10 (DET_A), J7.SH (SHIELD), R2.2, R10.2, R11.2, R14.2, R15.2, SW1.2, SW2.2, SW3.2, SW4.2, TH1.2, U1.2 (GND), U2.6 (GND), U2.7 (FSW), U2.8 (DEF), U2.15 (GND), U2.16 (GND), U2.17 (GND), U3.2 (GND), U4.47 (VREG_PGND), U4.61 (GND), U5.4 (GND), U5.9 (EP), U6.3 (GND), U7.3 (GND), Y1.2 (G), Y1.4 (G)
SD_VDD: C23.1, J3.2 (VREG_L21A_2P95), J3.4 (VREG_L21A_2P95), J3.6 (VREG_L21A_2P95), J7.4 (VDD)
SD_VIO: C24.1, J3.1 (VREG_L13A_2P95), R18.2, R19.2, R20.2, R21.2, R22.2, R23.2
SOM_SYS: C3.1, C4.1, C5.1, C7.1, J2.1 (SOM_SYS_PWR), J2.3 (SOM_SYS_PWR), J2.5 (SOM_SYS_PWR), J2.6 (SOM_SYS_PWR), J2.7 (SOM_SYS_PWR), J2.8 (SOM_SYS_PWR), J2.9 (SOM_SYS_PWR), J2.10 (SOM_SYS_PWR), J2.11 (SOM_SYS_PWR), J2.12 (SOM_SYS_PWR), J2.13 (SOM_SYS_PWR), J2.14 (SOM_SYS_PWR), J2.15 (SOM_SYS_PWR), J2.17 (SOM_SYS_PWR), J2.19 (SOM_SYS_PWR), J2.21 (SOM_SYS_PWR), J2.23 (SOM_SYS_PWR), J2.24 (VBATT_CONN_VSENSE_P), L1.2, R1.1, U2.14 (VOS), U3.1 (VIN), U3.3 (EN)
VBUS: C1.1, C2.1, J2.25 (USB_VBUS), J2.27 (USB_VBUS), J2.29 (USB_VBUS), J2.31 (USB_VBUS), J2.33 (USB_VBUS), J4.A4 (VBUS), J4.A9 (VBUS), J4.B4 (VBUS), J4.B9 (VBUS), J5.2, U1.5 (VBUS), U2.10 (VIN), U2.11 (VIN), U2.12 (VIN), U2.13 (EN)
VREG_AVDD: C11.1, R3.2, U4.46 (VREG_AVDD)
