ThyFriendlyFox/via/examples/snapdragon-dev-board/v0.1/wyvern.kicad_pcb

## KiCad design examples/snapdragon-dev-board/v0.1/wyvern.kicad_pcb (continued)

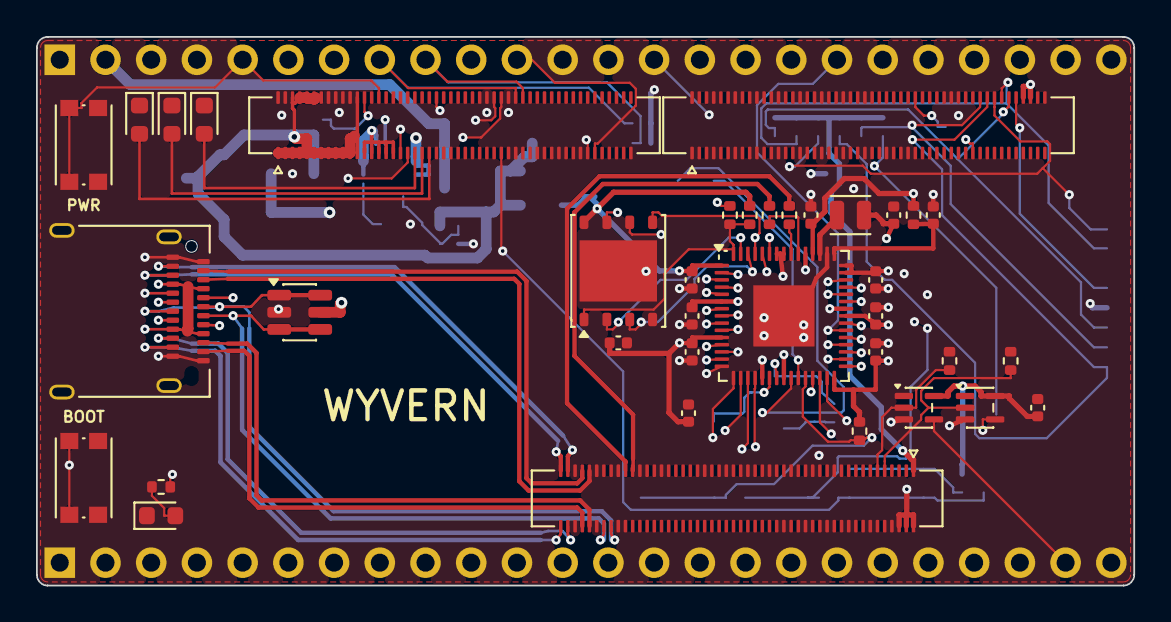
[picture p256: board examples/snapdragon-dev-board/v0.1/wyvern.kicad_pcb from above]

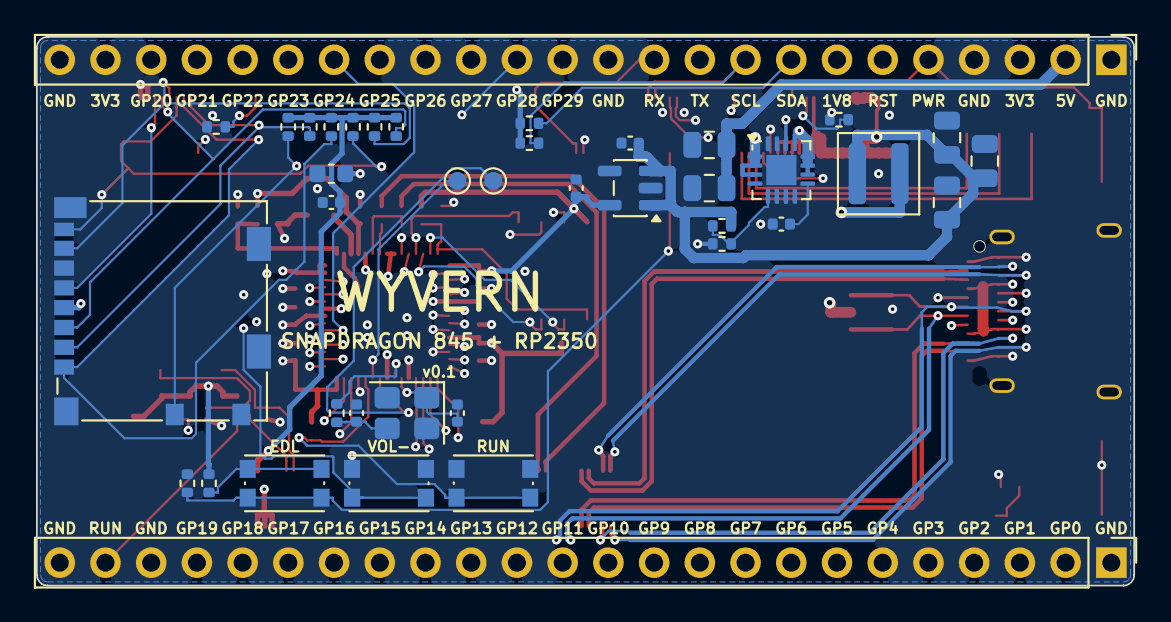
[picture p257: board examples/snapdragon-dev-board/v0.1/wyvern.kicad_pcb from below]

Board: 6 copper layers, 61.0 x 30.5 mm, 76 parts (39 on the bottom side), 97 nets.
