ThyFriendlyFox/via/examples/fire-alarm-communicator/v0.1/herald.kicad_pcb

## KiCad design examples/fire-alarm-communicator/v0.1/herald.kicad_pcb (2026-11-14)

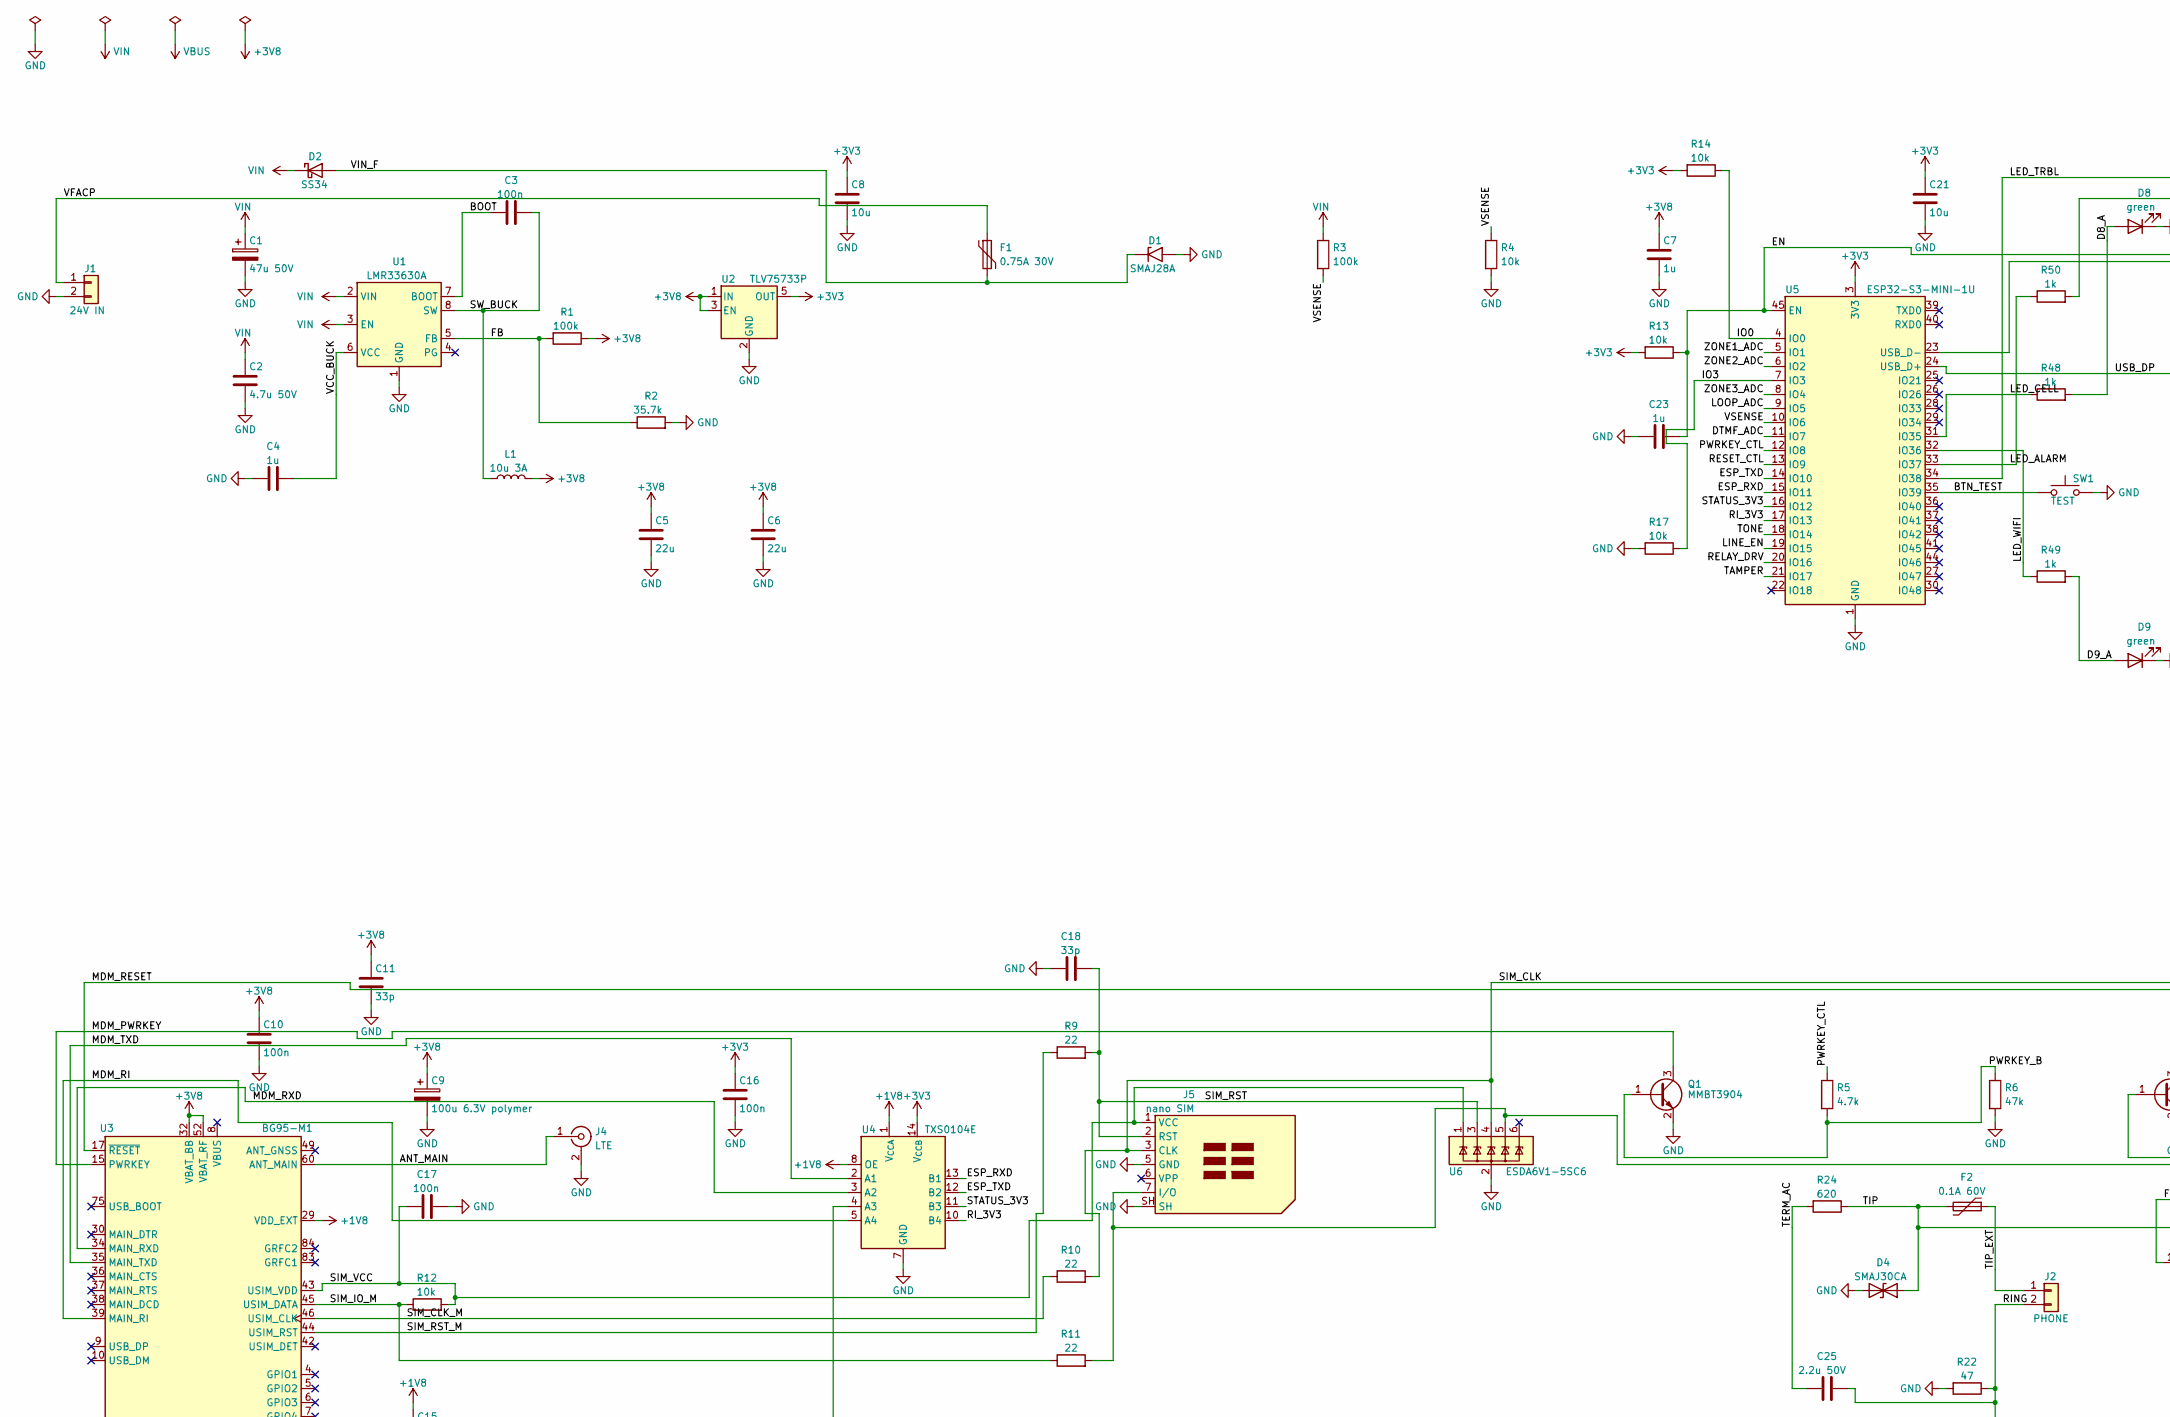
[picture p258: schematic herald.kicad_sch, part in row 1, column 1]

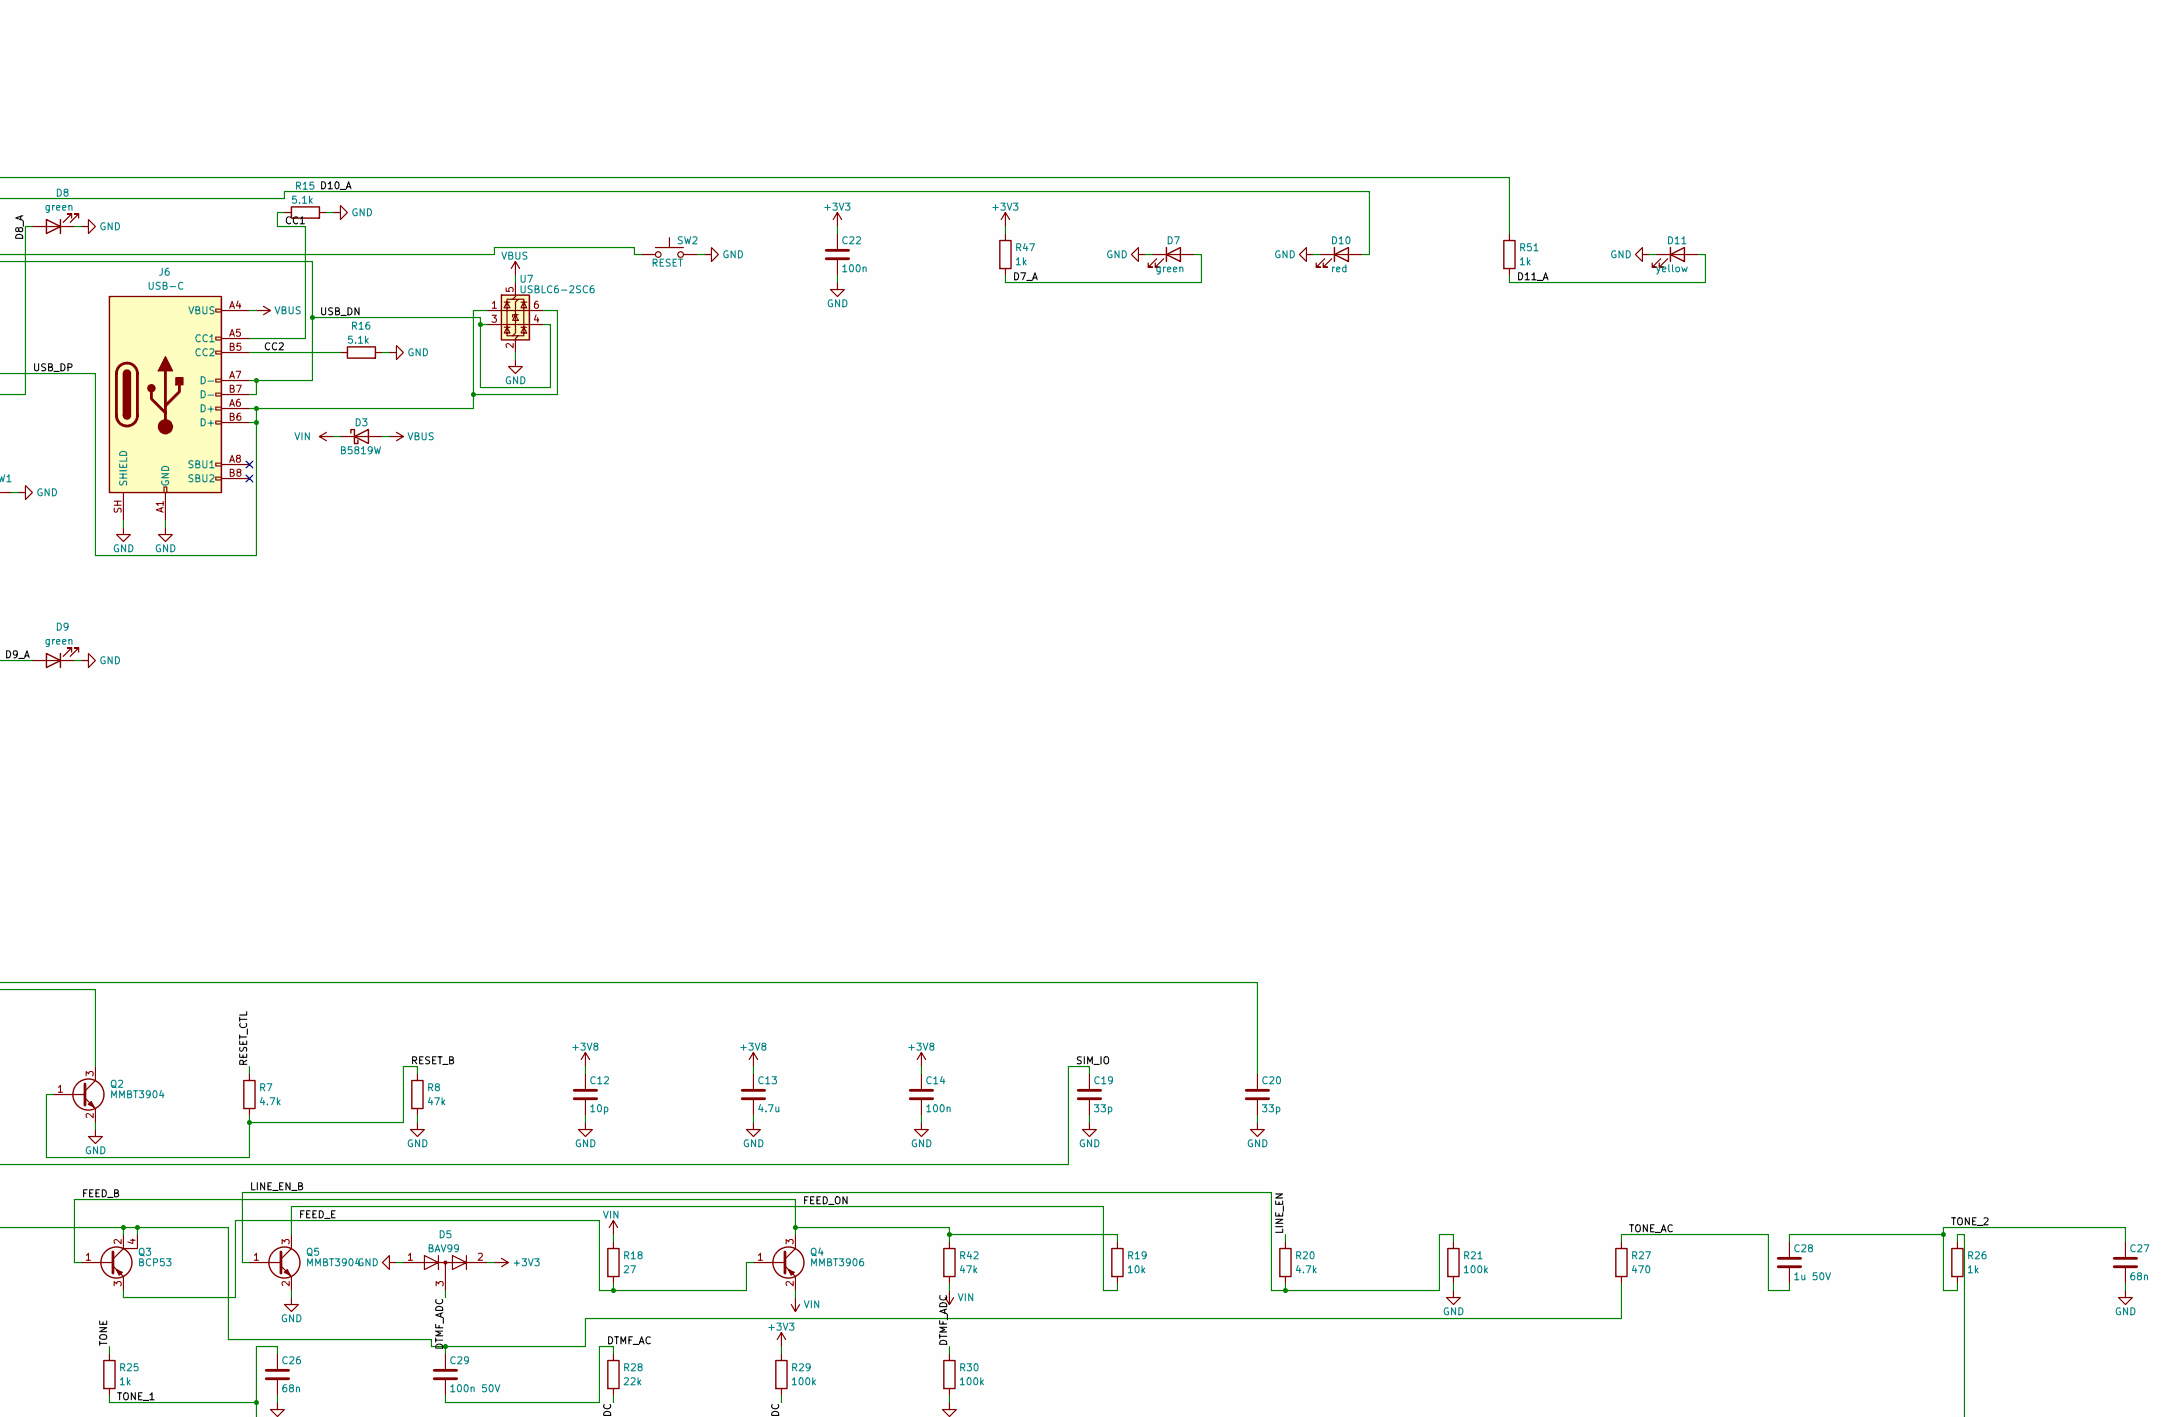
[picture p259: schematic herald.kicad_sch, part in row 1, column 2]

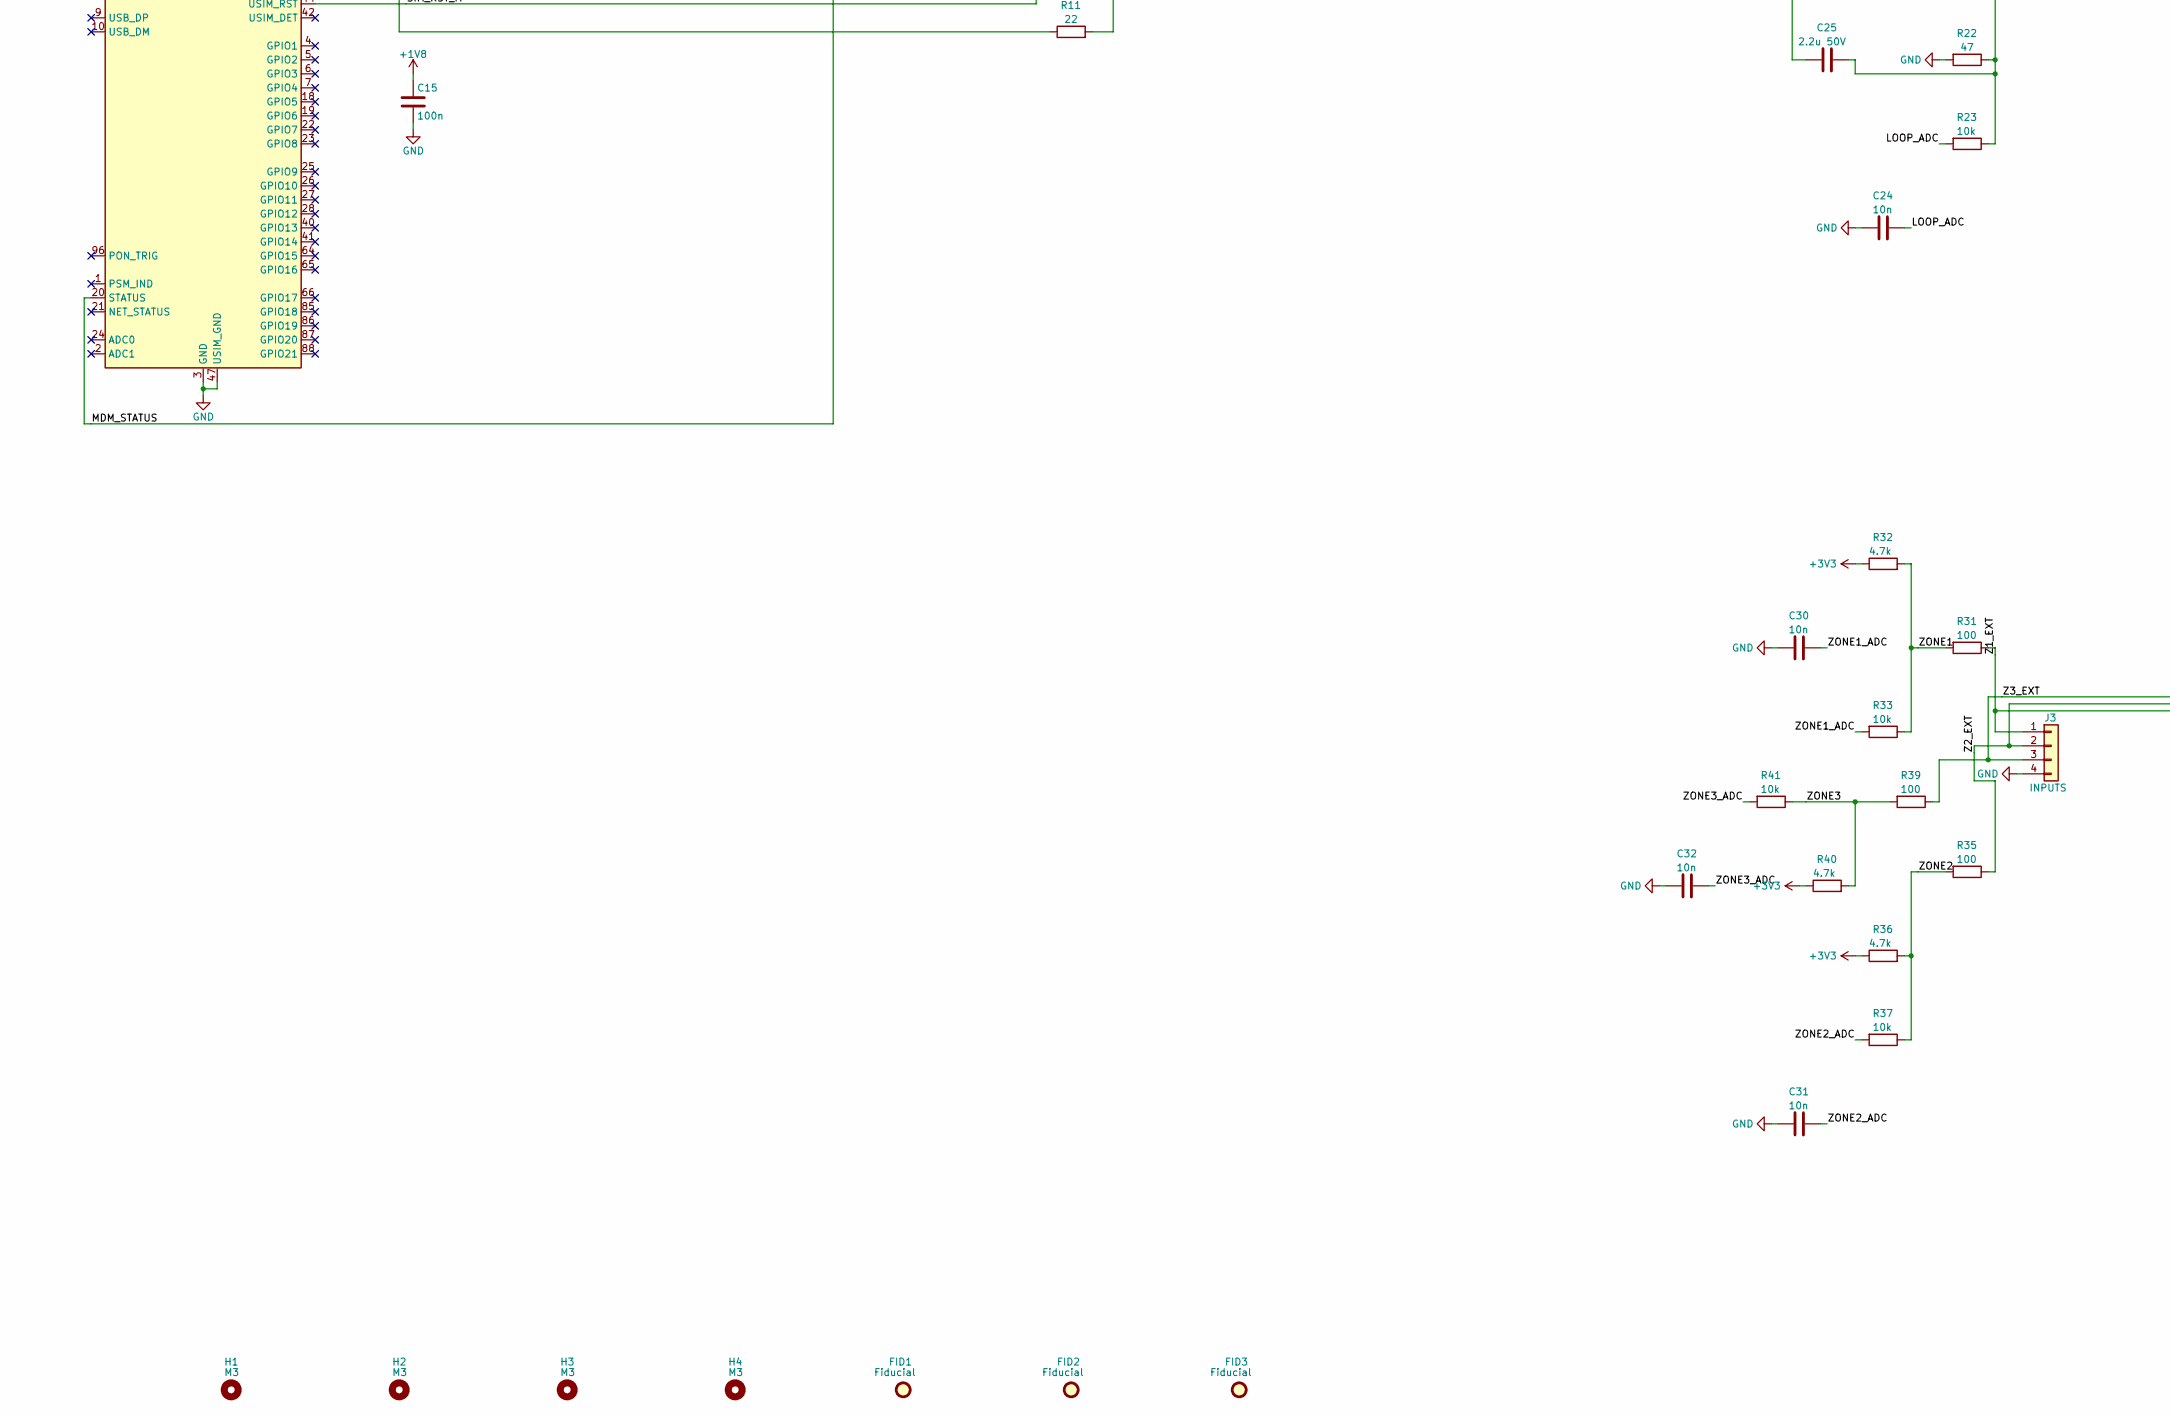
[picture p260: schematic herald.kicad_sch, part in row 2, column 1]

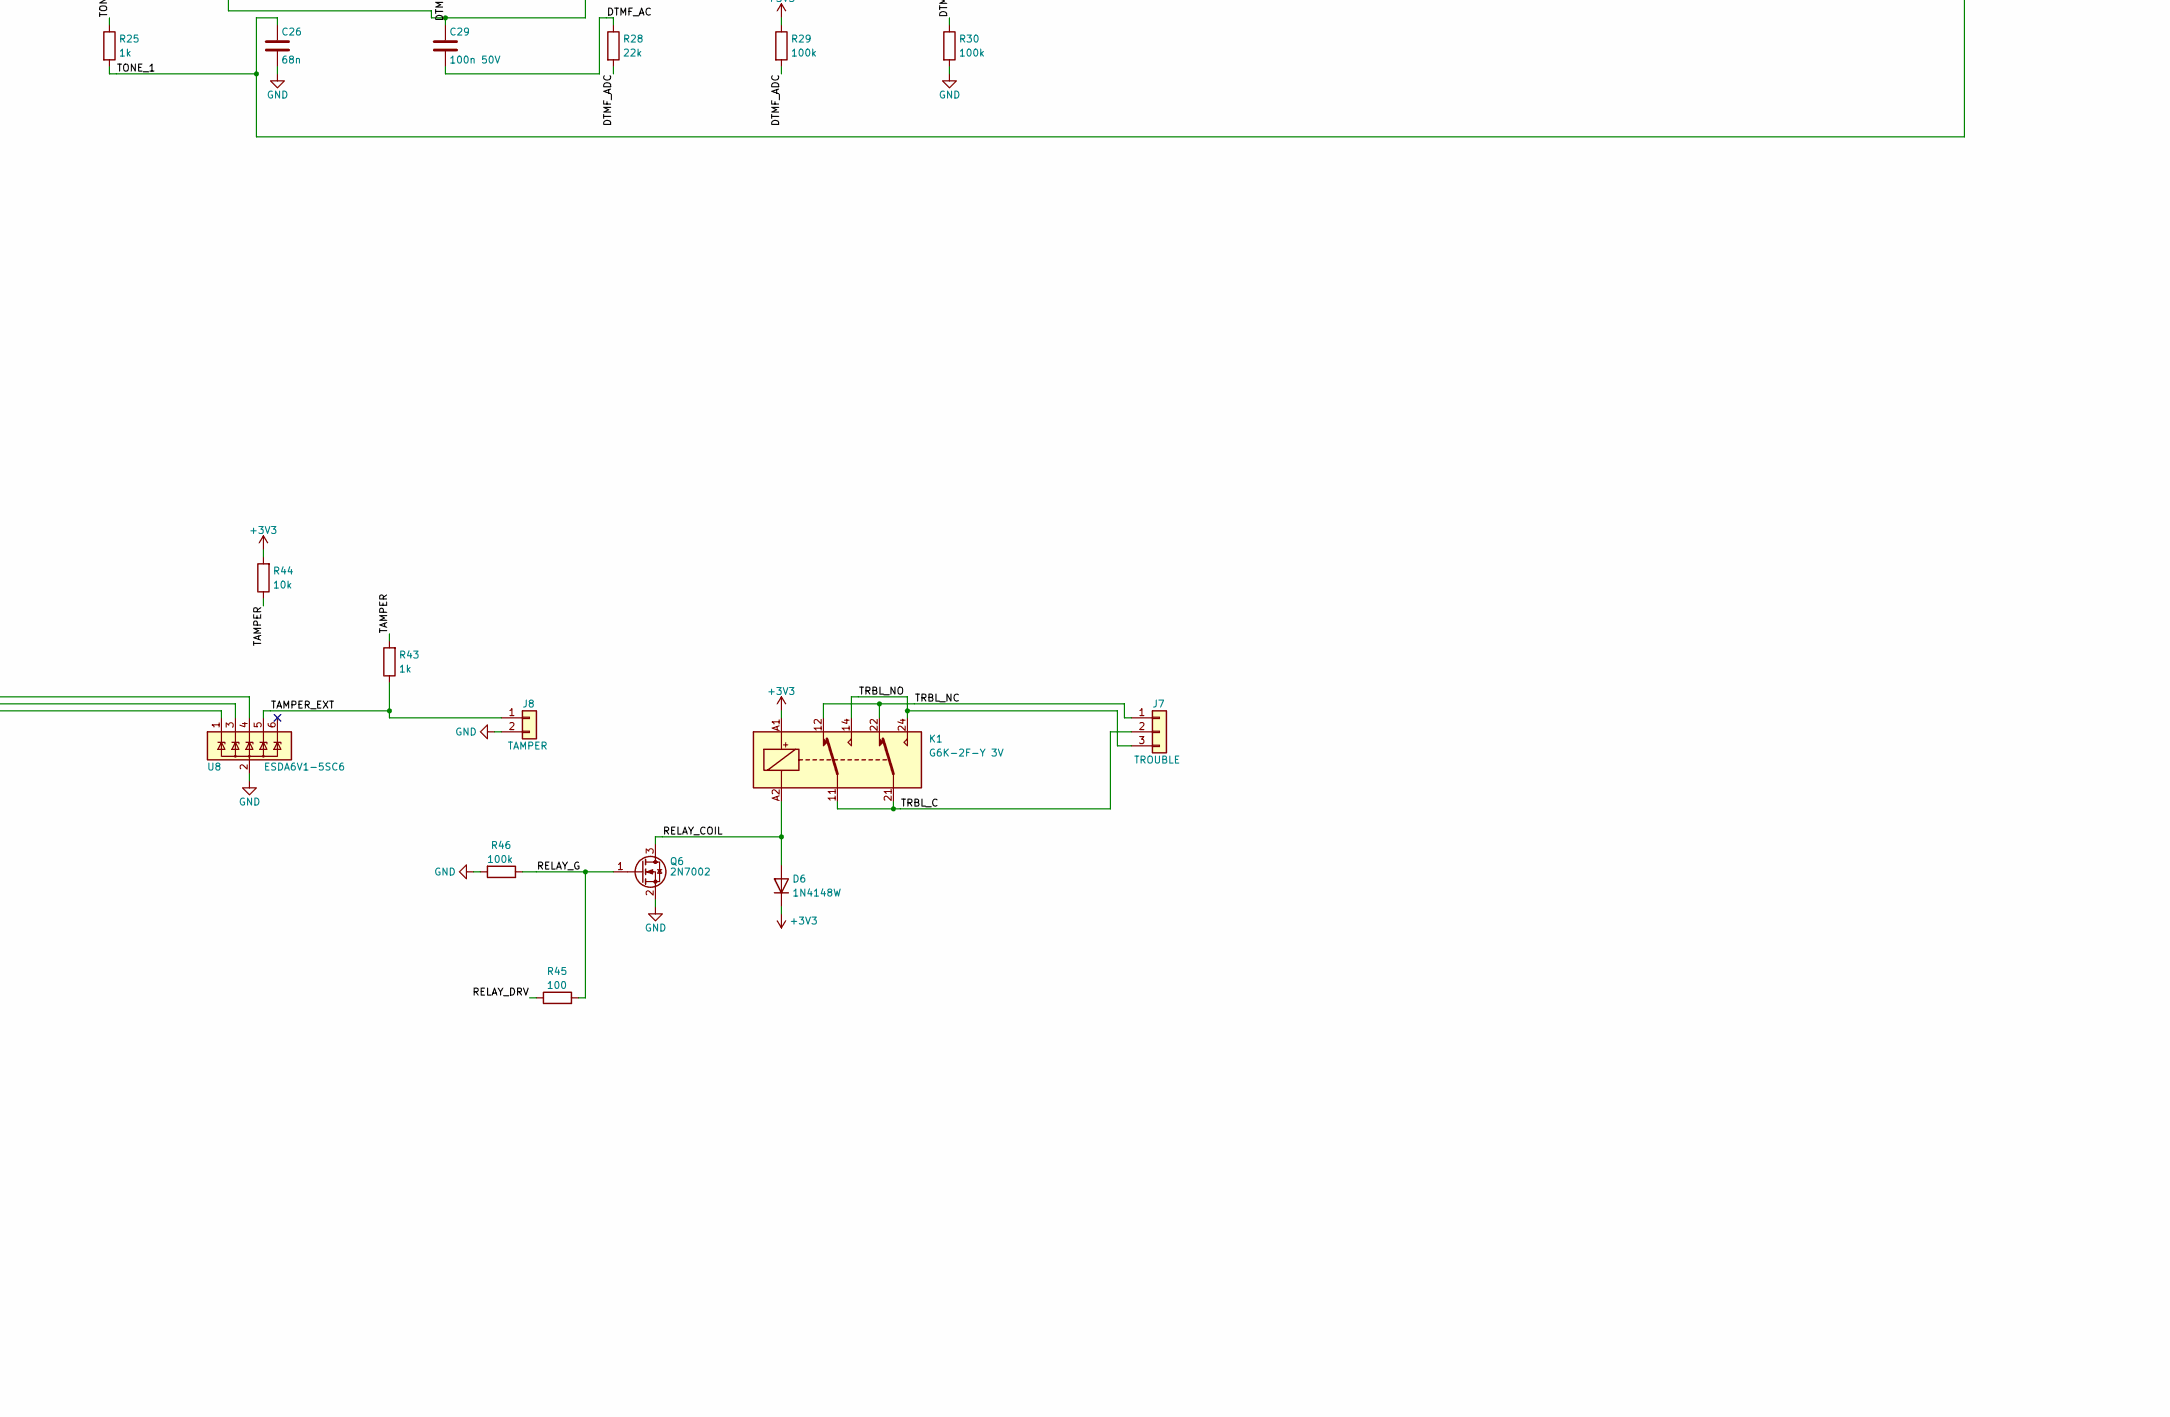
[picture p261: schematic herald.kicad_sch, part in row 2, column 2]

Parts:
C1: 47u 50V; CP_Elec_6.3x7.7
C2: 4.7u 50V; C_1210_3225Metric
C3, C10, C14, C15, C16, C17, C22: 100n; C_0402_1005Metric
C4, C7, C23: 1u; C_0402_1005Metric
C5, C6: 22u; C_0805_2012Metric
C8, C21: 10u; C_0603_1608Metric
C9: 100u 6.3V polymer; CP_EIA-3528-21_Kemet-B
C11, C18, C19, C20: 33p; C_0402_1005Metric
C12: 10p; C_0402_1005Metric
C13: 4.7u; C_0603_1608Metric
C24, C30, C31, C32: 10n; C_0402_1005Metric
C25: 2.2u 50V; C_1206_3216Metric
C26, C27: 68n; C_0402_1005Metric
C28: 1u 50V; C_0805_2012Metric
C29: 100n 50V; C_0603_1608Metric
D1: SMAJ28A; D_SMA
D2: SS34; D_SMA
D3: B5819W; D_SOD-123
D4: SMAJ30CA; D_SMA
D5: BAV99; SOT-23
D6: 1N4148W; D_SOD-123
D7, D8, D9: green; LED_0603_1608Metric
D10: red; LED_0603_1608Metric
D11: yellow; LED_0603_1608Metric
F1: 0.75A 30V; Fuse_1206_3216Metric
F2: 0.1A 60V; Fuse_1206_3216Metric
FID1, FID2, FID3: Fiducial; Fiducial_1mm_Mask2mm
H1, H2, H3, H4: M3; MountingHole_3.2mm_M3
J1: 24V IN; TerminalBlock_Phoenix_PT-1,5-2-3.5-H_1x02_P3.50mm_Horizontal
J2: PHONE; TerminalBlock_Phoenix_PT-1,5-2-3.5-H_1x02_P3.50mm_Horizontal
J3: INPUTS; TerminalBlock_Phoenix_PT-1,5-4-3.5-H_1x04_P3.50mm_Horizontal
J4: LTE; U.FL_Hirose_U.FL-R-SMT-1_Vertical
J5: nano SIM; nanoSIM_Hinged_CUI_NSIM-2-C
J6: USB-C; USB_C_Receptacle_GCT_USB4085
J7: TROUBLE; TerminalBlock_Phoenix_PT-1,5-3-3.5-H_1x03_P3.50mm_Horizontal
J8: TAMPER; TerminalBlock_Phoenix_PT-1,5-2-3.5-H_1x02_P3.50mm_Horizontal
K1: G6K-2F-Y 3V; Relay_DPDT_Omron_G6K-2F-Y
L1: 10u 3A; L_Bourns_SRN6045TA
Q1, Q2, Q5: MMBT3904; SOT-23
Q3: BCP53; SOT-223
Q4: MMBT3906; SOT-23
Q6: 2N7002; SOT-23
R1, R3, R21, R29, R30, R46: 100k; R_0402_1005Metric
R2: 35.7k; R_0402_1005Metric
R4, R12, R13, R14, R17, R23, R33, R37, R41, R44: 10k; R_0402_1005Metric
R5, R7, R20, R32, R36, R40: 4.7k; R_0402_1005Metric
R6, R8, R42: 47k; R_0402_1005Metric
R9, R10, R11: 22; R_0402_1005Metric
R15, R16: 5.1k; R_0402_1005Metric
R18: 27; R_0805_2012Metric
R19: 10k; R_0603_1608Metric
R22: 47; R_0805_2012Metric
R24: 620; R_0805_2012Metric
R25, R26, R43, R47, R48, R49, R50, R51: 1k; R_0402_1005Metric
R27: 470; R_0603_1608Metric
R28: 22k; R_0402_1005Metric
R31, R35, R39: 100; R_0603_1608Metric
R45: 100; R_0402_1005Metric
SW1: TEST; SW_SPST_PTS810
SW2: RESET; SW_SPST_PTS810
U1: LMR33630A; HSOP-8-1EP_3.9x4.9mm_P1.27mm_EP2.41x3.1mm
U2: TLV75733P; SOT-23-5
U3: BG95-M1; Quectel_BG95
U4: TXS0104E; TSSOP-14_4.4x5mm_P0.65mm
U5: ESP32-S3-MINI-1U; ESP32-S2-MINI-1U
U6, U8: ESDA6V1-5SC6; SOT-23-6
U7: USBLC6-2SC6; SOT-23-6

Connections:
+1V8: C15.1, U3.29 (VDD_EXT), U4.1 (V_{CCA}), U4.8 (OE)
+3V3: C8.1, C16.1, C21.1, C22.1, D5.2 (A), D6.1 (K), K1.A1, R13.2, R14.2, R29.1, R32.1, R36.1, R40.1, R44.2, R47.1, U2.5 (OUT), U4.14 (V_{CCB}), U5.3 (3V3)
+3V8: C5.1, C6.1, C7.1, C9.1, C10.1, C11.1, C12.1, C13.1, C14.1, L1.2, R1.1, U2.1 (IN), U2.3 (EN), U3.32 (VBAT_BB), U3.33 (VBAT_BB), U3.52 (VBAT_RF), U3.53 (VBAT_RF)
/ANT_MAIN: J4.1 (In), U3.60 (ANT_MAIN)
/BOOT: C3.1, U1.7 (BOOT)
/BTN_TEST: SW1.1, U5.35 (IO39)
/CC1: J6.A5 (CC1), R15.1
/CC2: J6.B5 (CC2), R16.1
/D7_A: D7.2 (A), R47.2
/D8_A: D8.2 (A), R48.2
/D9_A: D9.2 (A), R49.2
/D10_A: D10.2 (A), R50.2
/D11_A: D11.2 (A), R51.2
/DTMF_AC: C29.2, R28.1
/DTMF_ADC: D5.3 (K), R28.2, R29.2, R30.1, U5.11 (IO7)
/EN: C23.1, R13.1, SW2.1, U5.45 (EN)
/ESP_RXD: U4.13 (B1), U5.15 (IO11)
/ESP_TXD: U4.12 (B2), U5.14 (IO10)
/FB: R1.2, R2.1, U1.5 (FB)
/FEED_B: Q3.1 (B), Q4.3 (C), R19.1, R42.1
/FEED_E: Q3.3 (E), Q4.1 (B), R18.2
/FEED_ON: Q5.3 (C), R19.2
/IO0: R14.1, U5.4 (IO0)
/IO3: R17.1, U5.7 (IO3)
/LED_ALARM: R50.1, U5.33 (IO37)
/LED_CELL: R48.1, U5.31 (IO35)
/LED_TRBL: R51.1, U5.34 (IO38)
/LED_WIFI: R49.1, U5.32 (IO36)
/LINE_EN: R20.1, U5.19 (IO15)
/LINE_EN_B: Q5.1 (B), R20.2, R21.1
/LOOP_ADC: C24.1, R23.2, U5.9 (IO5)
/MDM_PWRKEY: Q1.3 (C), U3.15 (PWRKEY)
/MDM_RESET: Q2.3 (C), U3.17 (~RESET)
/MDM_RI: U3.39 (MAIN_RI), U4.5 (A4)
/MDM_RXD: U3.34 (MAIN_RXD), U4.3 (A2)
/MDM_STATUS: U3.20 (STATUS), U4.4 (A3)
/MDM_TXD: U3.35 (MAIN_TXD), U4.2 (A1)
/PWRKEY_B: Q1.1 (B), R5.2, R6.1
/PWRKEY_CTL: R5.1, U5.12 (IO8)
/RELAY_COIL: D6.2 (A), K1.A2, Q6.3 (D)
/RELAY_DRV: R45.1, U5.20 (IO16)
/RELAY_G: Q6.1 (G), R45.2, R46.1
/RESET_B: Q2.1 (B), R7.2, R8.1
/RESET_CTL: R7.1, U5.13 (IO9)
/RING: C25.2, J2.2, R22.1, R23.1
/RI_3V3: U4.10 (B4), U5.17 (IO13)
/SIM_CLK: C20.1, J5.3 (CLK), R10.2, U6.4 (IO3)
/SIM_CLK_M: R10.1, U3.46 (USIM_CLK)
/SIM_IO: C19.1, J5.7 (I/O), R11.2, U6.5 (IO4)
/SIM_IO_M: R11.1, R12.1, U3.45 (USIM_DATA)
/SIM_RST: C18.1, J5.2 (RST), R9.2, U6.3 (IO2)
/SIM_RST_M: R9.1, U3.44 (USIM_RST)
/SIM_VCC: C17.1, J5.1 (VCC), R12.2, U3.43 (USIM_VDD), U6.1 (IO1)
/STATUS_3V3: U4.11 (B3), U5.16 (IO12)
/SW_BUCK: C3.2, L1.1, U1.8 (SW)
/TAMPER: R43.2, R44.1, U5.21 (IO17)
/TAMPER_EXT: J8.1, R43.1, U8.5 (IO4)
/TERM_AC: C25.1, R24.2
/TIP: C29.1, D4.1 (A1), F2.2, Q3.2 (C), Q3.4 (C), R24.1, R27.2
/TIP_EXT: F2.1, J2.1
/TONE: R25.1, U5.18 (IO14)
/TONE_1: C26.1, R25.2, R26.1
/TONE_2: C27.1, C28.1, R26.2
/TONE_AC: C28.2, R27.1
/TRBL_C: J7.2, K1.11, K1.21
/TRBL_NC: J7.1, K1.12, K1.22
/TRBL_NO: J7.3, K1.14, K1.24
/USB_DN: J6.A7 (D-), J6.B7 (D-), U5.23 (USB_D-), U7.3 (I/O2), U7.4 (I/O2)
/USB_DP: J6.A6 (D+), J6.B6 (D+), U5.24 (USB_D+), U7.1 (I/O1), U7.6 (I/O1)
/VCC_BUCK: C4.1, U1.6 (VCC)
/VFACP: F1.1, J1.1
/VIN_F: D1.1 (A1), D2.2 (A), F1.2
/VSENSE: R3.2, R4.1, U5.10 (IO6)
/Z1_EXT: J3.1, R31.1, U8.1 (IO1)
/Z2_EXT: J3.2, R35.1, U8.3 (IO2)
/Z3_EXT: J3.3, R39.1, U8.4 (IO3)
/ZONE1: R31.2, R32.2, R33.1
/ZONE1_ADC: C30.1, R33.2, U5.5 (IO1)
/ZONE2: R35.2, R36.2, R37.1
/ZONE2_ADC: C31.1, R37.2, U5.6 (IO2)
/ZONE3: R39.2, R40.2, R41.1
/ZONE3_ADC: C32.1, R41.2, U5.8 (IO4)
GND: C1.2, C2.2, C4.2, C5.2, C6.2, C7.2, C8.2, C9.2, C10.2, C11.2, C12.2, C13.2, C14.2, C15.2, C16.2, C17.2, C18.2, C19.2, C20.2, C21.2, C22.2, C23.2, C24.2, C26.2, C27.2, C30.2, C31.2, C32.2, D1.2 (A2), D4.2 (A2), D5.1 (K), D7.1 (K), D8.1 (K), D9.1 (K), D10.1 (K), D11.1 (K), J1.2, J3.4, J4.2 (Ext), J5.5 (GND), J5.SH, J6.A1 (GND), J6.A12 (GND), J6.B1 (GND), J6.B12 (GND), J6.SH (SHIELD), J8.2, Q1.2 (E), Q2.2 (E), Q5.2 (E), Q6.2 (S), R2.2, R4.2, R6.2, R8.2, R15.2, R16.2, R17.2, R21.2, R22.2, R30.2, R46.2, SW1.2, SW2.2, U1.1 (GND), U1.9 (GND), U2.2 (GND), U3.3 (GND), U3.31 (GND), U3.47 (USIM_GND), U3.48 (GND), U3.50 (GND), U3.54 (GND), U3.55 (GND), U3.58 (GND), U3.59 (GND), U3.61 (GND), U3.62 (GND), U3.67 (GND), U3.68 (GND), U3.69 (GND), U3.70 (GND), U3.71 (GND), U3.72 (GND), U3.73 (GND), U3.74 (GND), U3.79 (GND), U3.80 (GND), U3.81 (GND), U3.82 (GND), U3.89 (GND), U3.90 (GND), U3.91 (GND), U3.100 (GND), U3.101 (GND), U3.102 (GND), U4.7 (GND), U5.1 (GND), U5.2 (GND), U5.42 (GND), U5.43 (GND), U5.46 (GND), U5.47 (GND), U5.48 (GND), U5.49 (GND), U5.50 (GND), U5.51 (GND), U5.52 (GND), U5.53 (GND), U5.54 (GND), U5.55 (GND), U5.56 (GND), U5.57 (GND), U5.58 (GND), U5.59 (GND), U5.60 (GND), U5.61 (GND), U5.62 (GND), U5.63 (GND), U5.64 (GND), U5.65 (GND), U6.2 (GND), U7.2 (GND), U8.2 (GND)
VBUS: D3.2 (A), J6.A4 (VBUS), J6.A9 (VBUS), J6.B4 (VBUS), J6.B9 (VBUS), U7.5 (VBUS)
VIN: C1.1, C2.1, D2.1 (K), D3.1 (K), Q4.2 (E), R3.1, R18.1, R42.2, U1.2 (VIN), U1.3 (EN)

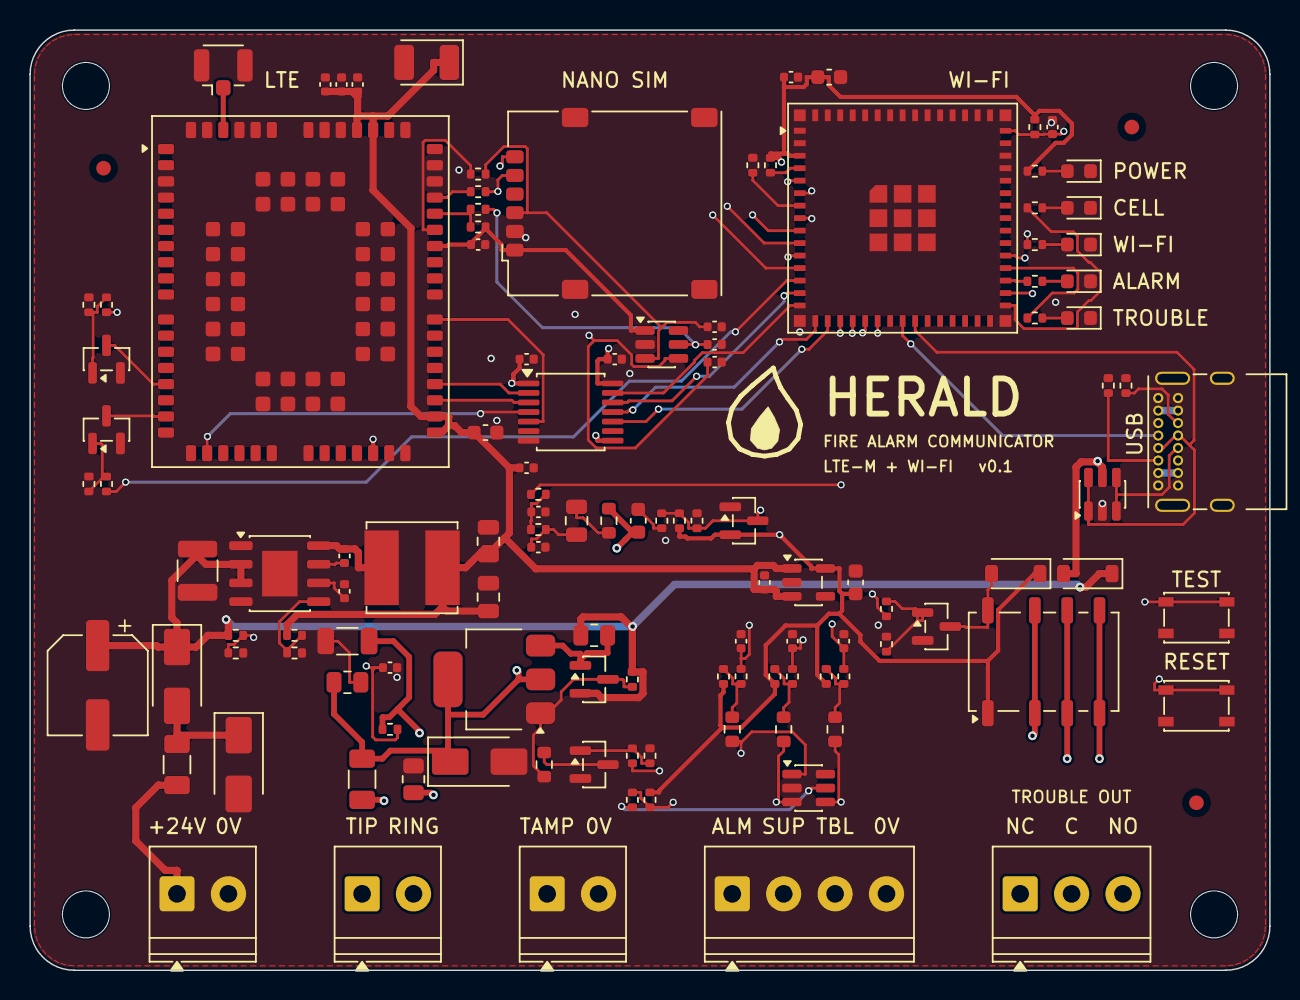
[picture p262: board herald.kicad_pcb from above]

Board: 4 copper layers, 84.4 x 64.0 mm, 127 parts (0 on the bottom side), 85 nets.
