ThyFriendlyFox/via/tests/test_chipguide.py

"""`workcenter next` on a chip project: the one next step (tools/chipguide.py).

Most tests write the gates report a chip project would have, by hand, and read the step the command
gives for it. They need no engine: `next` asks only whether each engine and the process kit are there,
and a folder of empty files stands in for them. One test walks a project from the template to GREEN
with the engines themselves, and skips by name where they are absent. One holds every hint to the
document it points at, and one holds every sentence of an answer to its count of words.
"""

from __future__ import annotations

import ast
import json
import os
import re
import shlex
import shutil
import subprocess
import sys
import time
from pathlib import Path

import pytest

ROOT = Path(__file__).resolve().parents[1]
CLI = ROOT / "tools" / "workcenter"
sys.path.insert(0, str(ROOT / "tools"))
sys.path.insert(0, str(ROOT / "tests"))
import chipflow  # noqa: E402
import chipfront  # noqa: E402
import chipguide  # noqa: E402
from test_chipflow import VERSION, command, fill, load_cli  # noqa: E402
from test_chips import EVERY, needs  # noqa: E402

DESIGN = ".claude/skills/chip-design/SKILL.md"
GATES = ".claude/skills/chip-gates/SKILL.md"


def toolchain(folder: Path, *without: str) -> dict[str, str]:
    """The environment of a machine that has every chip engine and the process kit, but for `without`:
    empty files under their names. `next` starts none of them."""
    for name, (where, _, _) in chipflow.ENGINES.items():
        if name in without:
            continue
        path = folder / ("chip/bin" if where == "chip" else "bin") / name
        path.parent.mkdir(parents=True, exist_ok=True)
        path.write_text("", encoding="utf-8")
        path.chmod(0o755)
    (folder / "bin").mkdir(parents=True, exist_ok=True)
    if "kit" not in without:
        stated = chipflow.read_table("sky130A")[0]["version"]["file"]
        tech = folder / "chip" / "pdk" / "sky130A" / stated
        tech.parent.mkdir(parents=True, exist_ok=True)
        tech.write_text(f"version\n version {VERSION}\n", encoding="utf-8")
    return {"WORKCENTER_CHIP_TOOLS": str(folder / "chip"), "PATH": str(folder / "bin")}


def ask(project: Path, env: dict[str, str]) -> tuple[int, dict]:
    proc = subprocess.run(
        [sys.executable, str(CLI), "--json", "next", str(project)],
        capture_output=True,
        text=True,
        check=False,
        env={**os.environ, **env},
    )
    assert proc.stdout, proc.stderr
    return proc.returncode, json.loads(proc.stdout)


OWN = "// the project's own: no longer the file `chip init` wrote\n"


def a_project(tmp_path: Path) -> Path:
    """A project past its first files: chip.json and the constraints filled, the RTL and the bench the
    project's own (the template's register with 1 line more), the README written."""
    folder = tmp_path / "reg8"
    assert command("chip", "init", folder, "--top", "reg8").returncode == 0
    fill(folder)
    for name in ("rtl/reg8.v", "tb/tb_reg8.v"):
        with (folder / name).open("a", encoding="utf-8") as fh:
            fh.write(OWN)
    (folder / "README.md").write_text("# reg8\n\nAn 8-bit register with an enable.\n", encoding="utf-8")
    return folder


def record(gate: str, status: str = "pass", failures=(), warnings=(), **details) -> dict:
    return {
        "gate": gate,
        "status": status,
        "summary": f"{len(failures)} failures",
        "details": {**details, "failures": list(failures), "warnings": list(warnings)},
        "artifacts": [],
        "seconds": 0.1,
    }
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
