ThyFriendlyFox/via/(commit log)

2026-10-22 chore: install ee-agent-kit and build the EE Workcenter (#1)
    install.sh (KiCad 10 PPA, ngspice, Java 21, FreeRouting 2.1.0 pinned),
    the workcenter CLI with gates ERC, DRC, SIM, EXPORT, 3 fixture boards,
    5 skills, ee-agent-kit with a 4-item provisional roadmap, CI, the cloud
    environment setup script, and a Dockerfile on kicad/kicad:10.0.
    Evidence: CI run 1 green (verify, 69 s); make verify green locally,
    12 tests passed.
    [rc_divider.kicad_pcb, rc_divider.kicad_sch]
2026-10-23 feat: kicadgen design generator, design and render commands (#7)
    tools/kicadgen.py builds a KiCad 10 schematic, board, and project from a
    Python design that names parts from the installed libraries, writes a
    Specctra DSN, and merges the routed session back. `workcenter design
    <design.py> [--route]` and `workcenter render <project>` drive it. New
    board-design skill; install.sh adds librsvg and pins FreeRouting 1.9.0
    (2.1.0 never finishes a job behind a proxy).
    Evidence: CI green (verify, 84 s); make verify green locally with 22
    tests including a routed round trip that ends with DRC GREEN.
2026-10-23 kicadgen: copper pours, hand routes, pour-island stitching; visible install (#8)
    Built while shrinking the first board to 1 x 0.5 in with parts on both
    faces, where routed ground alone filled the board and FreeRouting gave
    up on links a person can see.
    - d.zone(): copper pours, filled headless on write; planes in the DSN.
    - d.track() / d.via(): hand-routed copper, fixed wiring for the router;
    merge_ses drops the router's echoes and splits T-junctions.
    - stitch_zones(): pour islands read with KiCad's pcbnew module and
    stitched with vias; `workcenter design --route --rounds` reserves a
    via beside what is left and routes again.
    - pcb_layer, d.text, d.rules, zone_connect from the two-side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
    [test_kicadgen.py]
2026-10-23 Add MISTAKES.md and PROCESSES.md; verify checks their link (#9)
    Every mistake from the first two days (M1 to M18) now has an entry with
    its cost and root cause, and points at one of fourteen binding
    checklists (P1 to P14). ROUTING.md, AGENTS.md and CLAUDE.md point at
    them; verify.sh fails on a mistake with no existing process or a process
    with no "Done when" line. A new test asserts pcbnew imports where KiCad
    is installed so the pour tests cannot skip in silence (M17).
    Evidence: make verify VERIFY GREEN, 29 passed, 0 skipped; CI run 13 green.
    [test_kicadgen.py]
2026-10-24 MISTAKES.md M19, M20 and PROCESSES.md P15 (#10)
    M19: a question that revealed a design mismatch was answered, not acted
    on; P15 makes such a reply carry the change or a direct question. M20: a
    push was gated on a look at the verify log, not its verdict; P14 chains
    the push behind the verdict and P8 names make -C and git -C over cd.
    Evidence: make -C verify VERIFY GREEN, 29 passed; CI verify green.
2026-10-24 kicadgen: rounded corners and per-part 3D bodies; wrlgen; bottom 3D render (#11)
    Design.corner_radius rounds the board (Edge.Cuts arcs, polygon boundary
    in the DSN, rounded default pour, corner-aware via check). Design.model()
    attaches a 3D body to a part's footprint. tools/wrlgen.py writes
    parametric VRML bodies in KiCad's 0.1 inch unit: a vertical USB-C
    receptacle and a threaded contact stud. workcenter render adds the
    bottom 3D view. Kit docs, M21, M22, P6 and P8 updated.
    Evidence: make -C verify VERIFY GREEN, 33 passed; CI verify green.
2026-10-24 kicadgen: project footprints, stadium outlines, keep-outs; wrlgen 510 presets (#12)
    Project footprint libraries (Design.footprint_dirs, fp-lib-table, footprint --lib), stadium outlines, keep-out areas (KiCad rule area, Specctra keepout, via check), non-plated holes as board edge in the via check, circle courtyards, wrlgen 510/cartridge/cell/display presets. Kit: M23 to M29 with P16, P17 and extended P1, P7, P9, P11.
2026-10-24 kicadgen: keepouts in island stitching, NPTH edge clearance for the router; no-cd hook; P18 (#13)
    Island stitching after routing keeps vias out of keepouts (one Design.in_keepout check for both via placers, M30). The router's obstacle for a non-plated hole grows to the board-edge clearance the DRC applies (M33). A PreToolUse hook refuses Bash commands that run cd (P8, M31). Kit: M30 to M34, P17 and P14 extended, new P18 (firmware that drives power); board-design skill: ground corridors.
    [test_kicadgen.py]
2026-10-24 kicadgen: four-layer boards with inner planes; stitching once per net (M37) (#15)
    Design.copper_layers adds In1.Cu.. and a 1.6 mm stackup; Design.plane_layers
    gives an inner layer whole to a pour that the router never sees. Through pads
    and vias carry copper on every routing layer in the DSN. Island stitching lands
    vias on any layer and keeps clear of other nets' copper on the layers a via
    passes. Two-layer output is byte-identical to before.
2026-10-24 kicadgen: custom pads mirrored onto the bottom face and sized from their shapes (M38); P19, P20 (#16)
    _flip walks a custom pad's primitives, so a bottom-face QFN keeps its corner
    chamfers facing the corner; a custom pad's size is the extent of its shapes,
    not its anchor. Records M38 and M39 (the 10440 board's charge current) with
    P19 (footprint geometry the generator transforms) and P20 (swapping a part).
    [test_kicadgen.py]
2026-10-24 kicadgen: hand vias checked before routing (M40, M41); hook against scripted test edits (M43) (#17)
    Design.check_vias() names what every via hits: another net's pad or track on
    any layer, another via, a keep-out, the board edge. workcenter design prints
    the list and exits 1 when it is not empty. Pad boxes leave out paste-only
    apertures and measure round pads as circles. A PreToolUse hook refuses Bash
    commands that write under tests/ (P9 step 6). M40 to M43 with P1 step 6,
    P3 step 4, P7 step 4 and the P9 machine check.
2026-10-24 PROCESSES.md P21: moving files in a project (M44) (#18)
    M44: moving the Last Hit board into v0.6/ broke assembly.py's path to the workcenter checkout; CI never runs the script. P21: list self-relative paths before a move, run every README command after it, diff each folder against its source commit. STATUS.md mistake and process ranges brought up to M44 and P21.
2026-10-24 kicadgen: a radius per corner and a board thickness (M45) (#19)
    Design.corner_radius takes four radii (top-left, top-right, bottom-right, bottom-left): a board can be a half circle at one end and flat at the other. Design.thickness sets the finished board and writes a stackup on two layers too. M45 and P9 step 7: test geometry computed before it is written. make verify GREEN, 69 passed.
2026-10-24 kicadgen: via sizes checked against the board's rules before routing (M46); model rotation convention written down (M47) (#20)
    M46: the Last Hit v0.7 display board set 0.5 / 0.25 mm vias under the 0.3 mm
    minimum hole the generator writes. The unrouted DRC had no via to see; the
    router placed nine and the DRC refused them after the route.
    Design.check_via_rules() compares the default via, each net class's and
    each hand via with the board's minimum hole, via and annular ring, and
    `workcenter design` runs it before routing and exits 1. Design.board_rules()
    is the rule set the project file carries, in the same key order, so every
    generated project is byte-identical.
    M47: the v0.7 assembly attac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
2026-10-24 PROCESSES.md P22: every new feature is a new version folder (M48) (#21)
    M48: after Last Hit v0.7 was pushed, the seventh joint pad (the cell's
    voltage to the panel) was built inside v0.7/; the user stopped it: every
    new feature is a new version. P22 says when a project gets a new version
    (any feature, before the first edit), what the latest version may still
    take, and how to show the previous folder is untouched.
2026-10-24 PROCESSES.md: P22's check allows the banner it asks for; P13 walks a new process through its case (M49) (#22)
    P22 (merged in #21) asked in step 2 for the previous version's README
    banner to say archived, and in step 4 for `git status` on that folder to
    print nothing: the case it was written for fails step 4 by following step
    2. Step 4 now compares the folder with its last commit and expects the one
    banner line. P13 step 2 now walks a new or changed process through the
    case that caused it before the PR.
2026-10-24 workcenter render: every layer as its own image, and a turning 3D GIF on request (#23)
    - Every layer with something on it, one PNG each with the board outline
    (bottom layers mirrored, as seen from below), in build/render/layers/,
    and an overview sheet, build/render/layers.png. Copper layers come from
    the board's layer table, so inner layers appear on four-layer boards;
    a layer is skipped when it draws nothing without drill holes. The sheet
    is an SVG that rsvg-convert flattens, so the CLI stays standard library.
    - --views spin writes build/render/board-spin.gif: kicad-cli 3D frames
    turned about the board's normal, joined by FFmpeg with a palette from
    the frames; --spin-frames, -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
    [test_gates.py]
2026-10-24 P23: pictures of a finished board version; M50: the configuration table (#24)
    P23 makes layer sheets and turning GIFs a step of every finished board version. M50: render's flags and --rounds added to docs/CONFIGURATION.md, its workcenter table made whole, and test_every_cli_flag_is_in_the_configuration_table checks every flag against it.
2026-10-27 kicadgen: wired schematics; render names parts drawn without a 3D body (#25)
    Wired schematics (M51, P24): Design.sch_wires turns on SchRouter, a grid
    router that draws each net's wires round the parts on the 1.27 mm grid,
    junctions at tees, power symbols pointing away from their pins (moved out
    along the pin when their drawing would land on a neighbour), and each
    net's name once along its wire so the board's net names survive (no
    parity warning). sch_rot turns symbols; field text stays level (KiCad adds
    a field's angle to the symbol's and flips its justification at 90 and
    180, read from its plots). Off by default: all twelve committed Last Hit
    schematics regenerate byte for byte.
    render nam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
    [test_gates.py, test_kicadgen.py]
2026-10-27 procure: a parts list you can order, priced for 1 and N units; procurement skill (#26)
    `workcenter procure <project> --parts <csv>` exports the schematic's BOM
    grouped by value and footprint, matches each line to a row in one or more
    parts files (manufacturer, MPN, supplier, supplier number, pack, price
    breaks, stock, date checked), adds the rows with no footprint as items
    off the board, and writes build/procure/parts.csv and parts.md. Each line
    is bought at the cheapest quantity that covers it: at least the first
    break, in whole packs, or a higher break when that costs less. Money is
    Decimal. It fails on a line with no row or no price; --strict also fails
    on short stock and on prices older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
    [test_gates.py]
2026-10-29 kicadgen: project symbol libraries; P20 asks what a swapped part did (M56) (#27)
    `Design.symbol_dirs = {"Name": path}` names a project `.kicad_sym` file;
    `"Name:Symbol"` then loads from it, the schematic embeds it as it does
    every symbol, and the project gets a `sym-lib-table`. `pins --lib
    NAME=FILE` reads one. It is for a part the KiCad library lacks or draws
    only in several units, which the generator does not place: the Last Hit's
    battery protection needs a dual common-drain MOSFET (FDMB2307NZ), and
    KiCad draws dual MOSFETs as two units. The test runs ERC on a schematic
    that uses a project symbol.
    M56: the Last Hit's v0.6 swapped a protected pouch with a plug for a bare
    10440 and recomput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
    [test_kicadgen.py]
2026-10-29 kistack: vendored KiCad skills, routed by a skill; placement checks headless (#28)
    The user asked for kistack (American Embedded's KiCad agent skills) in the
    workflow. Every SKILL.md and script was read before it went in.
    - third_party/kistack/: upstream 641ade9 byte for byte, without the logo
    the licence keeps; VENDORED.md says where from and how to update.
    - .claude/skills/kistack: which kistack skill to read at which step, and
    where the workcenter wins (no getting round bot protection, the design
    file is the source of truth, FreeRouting routes, gates decide done).
    - tools/kistack_board.py + `workcenter placement <check> <board> [args]`:
    kistack's layout-placement checks need a Ki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
2026-10-29 autoroute: FreeRouting shifts with every hand track; M53 sixth cd (#29)
    The autoroute skill now says what Last Hit v0.11 showed: one added hand
    track (+BATT along the front edge) made FreeRouting drop three nets on
    the other side of the board. Find the culprit on a scratch copy, and
    copy a routing run's own tracks for a net the next run drops.
    M53 records a sixth `cd`, into the board repo in front of a `git -C`
    status check.
2026-10-29 Fab rule sets: Sierra Circuits' Web PCB limits in the DRC (#30)
    rules/sierra-circuits-web.kicad_dru holds Sierra Circuits' published Web
    PCB limits as KiCad design rules, each with the words it came from:
    4 mil trace and gap, 6 mil finished hole and annular ring, 13 mil inner
    drill to copper, 5 mil legend text. rules/README.md lists what Sierra
    publishes that KiCad cannot check here, and what Sierra does not publish.
    - `workcenter drc --fab NAME` and `gates --fab NAME` check a project
    against a rule set on a copy, laid over the project's own rules.
    - `kicadgen.Design.fab` writes the set into the project as
    <name>.kicad_dru and raises the board's own minimums to its board-wide
    ones, so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
    [rc_divider.kicad_pcb, rc_divider.kicad_sch]
2026-10-29 Pull-resistor check: every control input held while the MCU is in reset (#31)
    An MCU pin is high-impedance until firmware sets it, so a gate, an enable,
    a switch or an I2C line that only an MCU pin drives floats in reset.
    kicadgen.Design.undefined_inputs() reads the schematic's pin types and
    reports each net with such an input, no output on it, and no resistor to
    a rail (or, for a gate, to its own source). `workcenter design` prints
    them as `pull:` lines and fails on them when the design sets check_pulls;
    defined_nets names a net held elsewhere with the reason. Off by default,
    so archived boards regenerate as they were. PROCESSES.md P16 step 5.
    On Last Hit v0.11 it reports the button (the M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
2026-10-29 MISTAKES M57 to M61 and M53's 7th and 8th cd; P1 step 7, P9 steps 7 and 8, P26 (#32)
    From the Last Hit's v0.12 (USB-C firmware upload on an STM32C071):
    - M57: a peg slot's keep-out drawn across the slot; P1 step 7 reads a
    slot's long axis from the placed board, turned by the footprint's
    rotation.
    - M58: an update path no user could reach (a button held at power-up on
    a board whose built-in cell never powers it down, and a jump that would
    carry the watchdog into the ROM's DFU session); new P26, a feature the
    user reaches, walked from the device's own state.
    - M59: a CRLF catalogue rewritten whole by Python's csv module; P9 step 8.
    - M60: a test's timing counted from the wrong tick;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
2026-10-29 Fab rules only add floors; the via check follows the net classes (M62) (#33)
    In KiCad a custom rule overrides every net class's clearance, so the Sierra set's board-wide rules had loosened boards. A fab's board-wide limits are now the board's own minimums and only its layer and condition rules are copied, each raised to the board's own setting; check_vias holds two nets to the larger of their net classes' clearances. MISTAKES M62, PROCESSES P3 step 6.
    [test_kicadgen.py]
2026-10-29 Part sources: datasheets, SPICE models and 3D bodies in a library; the SIM gate runs vendor models (#34)
    workcenter sources checks every part on a schematic against library/sources.csv: a datasheet for each, a model or a note for each U, Q and D, each file unchanged and printing its revision, each model loading in ngspice; --fetch rereads under the workcenter's own name. The SIM gate runs listed vendor models translated into build/ (PSpice RES models, tolerances, ps mode) and warn bounds hold a model to its datasheet. PROCESSES P27, the simulate skill, MISTAKES M63 and M64.
    [test_sources.py]
2026-11-05 Verification packages: workcenter verify, P28 and the verification skill (#36)
    The user asked, after an engineer's review of the Last Hit board, for a
    method in the workcenter: requirements from expected and unexpected
    conditions, fit for a MIL-STD or DO-160 style inspection; ngspice
    calculations traced to the requirements' sources; every value justified by
    the datasheet figure or table, or the engineering convention, it rests on;
    and a layout a reviewer can read: a block diagram with how charge moves in
    each mode, one writeup per simulation with its inputs, outputs, expected
    and actual values, why it is or is not required, and step-by-step nodal
    analysis with cited equations.
    - `workcenter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
2026-11-05 Mistakes from Last Hit v0.15 (M74 to M84), and the processes that prevent them (#38)
    v0.15 of the Last Hit board (ThyFriendlyFox/vape-prototype ad9d8c4) ran
    into eleven mistakes. Each is in MISTAKES.md with its process:
    - M74, M75: `cd` again, and a `pgrep -f` wait loop that matched its own
    shell (P8 names `pgrep -f` beside `pkill -f`).
    - M76, M77: a CSV rewritten through a writer that failed, and a scripted
    stretch that skipped the far end (P9: write to a new file first, read a
    script's ranges from the file it edits). `workcenter sources` now
    refuses a row with more fields than its header instead of dropping them.
    - M78, M80: ngspice vectors read where they do not exist, and a corn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
    [test_sources.py]
2026-11-05 M85: a design step's exit 1 read as a warning (#39)
    `workcenter design --route` for Last Hit v0.15 printed a refused hand via
    and exited 1, but wrote every file; the gates passed (the DRC's rounded
    pad corner cleared the via by 1 um, the generator's box check did not), and
    the run was taken as good. The board's CI regenerates every project and
    failed on the exit. P4 now reads a route's verdict from the exit code, and
    P14 runs a board repository's own CI checks locally before the push.
2026-11-05 install.sh: apt progress that reaches the log, and a timeout on a silent mirror (M86) (#40)
    The board's CI install hung twice in three runs inside `apt-get install`
    (12 and 50 minutes) with no `[apt]` line in the log. M12's filter piped
    apt through grep and sed, which buffer 4 KB into a pipe, and its pattern
    wanted a space after `Get:` where apt prints `Get:1 http...`. Now:
    `grep --line-buffered` matching `Get:[0-9]+`, `sed -u`, and
    `Acquire::http(s)::Timeout=60` beside the existing three retries. Checked
    with a slow producer: each line arrives as it is printed.
2026-11-07 feat: workcenter inspect, parts keep-outs, stretch.py; P29 and M87 to M91 (#43)
    workcenter inspect reads a board with KiCad's own geometry; the CLI
    parses the arguments and runs tools/inspect_board.py under the venv's
    Python (pcbnew, Pillow). Seven views:
    - map: one PNG per copper layer of a window, back and inner layers
    seen from the top.
    - list: pads, tracks, vias, courtyards and keep-outs in a window.
    - probe: a via, a track or a part (a new one with --footprint) against
    the board's clearances, the project's .kicad_dru layer rules, hole to
    hole, the edge, courtyards and keep-outs by name (M90, M91).
    - net: a net's connected groups. islands: a pour's pieces (M88).
    - resistance: a pat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
    [four_layer.kicad_pcb, four_layer.kicad_sch]
2026-11-07 feat: datasheet, simulation and CI tools from the Last Hit work (#41)
    The owner asked for every tool the Last Hit work built outside the
    workcenter to move into it. This is stream 2: datasheets, simulation, CI.
    - workcenter fetch URL --to LIB/MAKER/FILE [--mpn --kind --member --row]:
    one request under the workcenter's own name, the file kept, its
    sources.csv row printed; --row appends it in the file's own line ends
    and refuses a second row of one kind for one part, before any request.
    - workcenter curve PDF --page N [--frame --x --y --paths --at --at-y]:
    a page's vector paths grouped by stroke, candidate frames and labels;
    each curve inside a frame on the plot's axes, a filled out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
2026-11-07 feat: document tools — docs, costs, pictures, gates --report, version new, diagram, scene.py (#44)
    The owner asked for every tool of the Last Hit work in the workcenter.
    This brings its document scripts in as commands with tests:
    - workcenter docs <version>: CONTENTS.md and datasheets/ (version_docs.py)
    - workcenter costs <repo>: every board priced, lists in parts/lists/,
    totals in every <!-- workcenter costs --> block (build.sh, summary.py;
    M97)
    - workcenter pictures <version>: P23 from pictures.json, --frames N for
    the framing check (pics16.sh, copy_docs_v016.sh)
    - tools/scene.py: the general part of assembly.py
    - workcenter gates <project> --report <file>: the gates tables and de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
2026-11-07 feat(design): route from a seed board, keep inner hole clearance (#45)
    Four gaps in the router and the generator, from the Last Hit work.
    workcenter design --route --seed <board>: a previous board's router
    tracks and vias become the router's starting wiring
    (kicadgen.board_copper, Design.seed_wiring). Hand copper, stitching
    vias, lost nets and arcs are left out; copper that now meets another
    net's pad or copper, a keepout or the board edge is dropped; each is
    counted on a seed: line. Connected seed copper goes in as
    (type shove_fixed), loose ends with no type. Without --seed the DSN
    has no seed wiring.
    Inner hole clearance (M79): Design.hole_clearances reads each layer's
    rule from the fab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
    [test_routing.py]
2026-11-07 feat(verify): owner decisions; version and helper templates; M92 to M102 (#42)
    workcenter verify reads the owner's decisions: a Withdrawn table for withdrawn requirements and "the owner's decision of <date>" in a restated requirement's Source. Templates for a version's README and gates report, and for helpers' briefs and facts files. P8, P18, P22, P23, P27 and P28 gain the steps from the Last Hit v0.16 mistakes M92 to M102.
    [test_verify.py]
2026-11-07 fix(docs): list the mutation list and pictures.json in CONTENTS.md (#46)
    `workcenter docs` lists a firmware's mutation list (firmware/mutations.py or .json, what `workcenter mutate` runs) and the version's pictures.json in CONTENTS.md; both were left out, found moving Last Hit v0.16 onto the workcenter's commands.
    [test_doctools.py]
2026-11-10 SIM gate: corners, a frequency plan, bundles, honest verdicts
    Checkpoint, not yet the whole change: the documents follow in this
    branch.
    The SIM gate ran each deck once, at 27 C with every part at its written
    value. It now runs every deck at the corners sim/corners.json names
    (temperature, part tolerance, the worst case of each bound, Monte Carlo)
    and holds each bound at all of them. A full run judges
    sim/frequency-plan.json: a source's harmonic in a resonance's band, or
    two sources at one frequency, needs a bounded deck that drives it.
    `sim --bundle DIR` writes each deck as a folder plain ngspice runs
    anywhere and checks that it prints the gate's numbers.
    Defects fixed: an analysis ngspic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
    [test_corners.py, test_doctools.py, test_freqplan.py, test_simgate.py, test_sources.py]
2026-11-11 Add `workcenter next`, a root AGENTS.md, and tests that hold the documents
    `workcenter next <project>` names the one next step for a project: what to
    do, the command, why, the section to read, and when the step is done. It
    reads the folder's state and its last gate run, and answers the first
    failure or warning with its fix.
    The root AGENTS.md carries CLAUDE.md's text for a host that reads that
    name; `make verify` holds the 2 files equal. tests/test_docs.py fails when
    a command, a skill, a tool file or a fixture is missing from the documents
    that list them, and when a document gives a command a flag it does not
    take.
    `--json` is read on either side of the command. The board-gates skill
    wrot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
    [test_corners.py, test_docs.py, test_freqplan.py, test_gates.py, test_guide.py]
2026-11-11 A generated schematic that simulates; a small model's frictions closed
    kicadgen: a design file says how each part simulates. `d.sim` binds a
    part to a `.subckt` or a `.model` in a file with a map from every pin to
    a node, or gives it a value of its own; `d.no_sim` leaves it out with the
    reason; `d.sim_directives` puts SPICE lines on the sheet. The generator
    writes KiCad's Sim fields, so `kicad-cli sch export netlist --format
    spice` gives a netlist ngspice runs. KiCad 10.0.8 binds a node a map
    leaves out by position with exit code 0; `Design.sim_problems()` refuses
    such a map, and `workcenter design` prints each problem as a `sim:` line
    and exits 1. A design that says nothing regenerates byte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
    [test_corners.py, test_docs.py, test_guide.py, test_simfields.py, test_simgate.py]
2026-11-11 Corners read a value on a continuation line, behind r=, and in atto
    First fixes from the electrical review of the corner code, each
    reproduced on the reviewer's own decks:
    - An element's value on a `+` line, or written `r=10k`, `c = 10u`, was
    never moved: a 5 % divider that reaches 2.375 V passed [2.42, 2.58].
    - `5a` is 5e-18 to ngspice 42 and was read as 5: the corner wrote 5.05
    for a part of 5e-18.
    - A part with `temp=27` on its line, or `alter d1 temp=27`, stayed at
    27 C in the run ngspice labels 85 C, and the corner passed. Such a
    deck now fails its temperature corners.
    - ngspice reads `4k7` as 4k and says nothing: the deck fails on it.
    kicadgen: pin numbers given as numbers ar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
    [test_corners.py, test_guide.py, test_simfields.py, test_simgate.py]
2026-11-11 Corners: parts move apart, every end is tried, a peak inside a range is found
    Fixes from the 2 reviews of the gate change, each reproduced on the
    reviewers' own projects before and after.
    Wrong verdicts closed in the corner code:
    - 2 parts written from 1 `.param` moved as 1 part, so their ratio never
    changed. An element written as an expression or from a parameter is
    now scaled where it stands (`{(rdiv)*1.05}`).
    - `alter` was read in 1 spelling; `alter @r2[resistance] = 10k`, `alter
    r2 resistance = 10k`, `alterparam`, a `;` chain and a `$ ` comment put
    the part back to its exact value at every corner. A value a corner
    cannot scale (`alter r2 = $&rv`) fails the deck.
    - `tolerance.p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
    [test_corners.py, test_doctools.py, test_simgate.py, test_sources.py, test_verify.py]
2026-11-11 Hold the review findings with tests; a bundle carries the files beside its deck
    2 reviews of the SIM gate found verdicts that were wrong or could not be
    read. The fixes are in ae53f5d. This commit adds 1 test for each finding in
    tests/test_corners.py and tests/test_simgate.py: 120 tests pass in the 2
    files.
    A deck that reads a file beside it (`source print_it.sp`, a file source)
    ran at its corners and failed in its bundle from another folder: a nested
    `source` is read against the working directory. A bundle now holds the
    other files of the deck's folder, and its run.sp changes to its own folder
    before it reads the deck.
    [test_corners.py, test_simgate.py]
2026-11-11 A first design file starts from a template; each trap says what to write; `next` always gives a command that runs
    A small model built a filter board with `workcenter next` alone and met 4
    traps in its first design file. Each one now stops with a line that says
    what to write:
    - `Design("name")` without a namespace, or with a string, names the call
    to write with a new UUID.
    - `power_nets` as a list, a flagged net that `power_nets` does not name and
    a power symbol the library lacks each name the entry to write.
    - A part with every pad outside the outline is a `part:` line with the
    place in board coordinates, and exit 1.
    - A route that joins nothing is "N unrouted" and exit 1. FreeRouting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
2026-11-11 Hold the plan and verify findings with tests; the record names the L against C sweep
    Tests for what the reviews found in the frequency plan and in verify. Each
    expected line comes from a run, and each test was seen to fail: 6 on code
    broken for the purpose, 4 on the commit from before the fixes (dd6a4fa).
    - A source is read in every form a deck writes it (SINE, a braced argument
    with spaces or parentheses, a comment that holds another stimulus) and is
    named when its frequency is no number in the text.
    - A resonance that meets the clock between the ends of its parts is found:
    22.0 mV against a 17 mV bound, where every combination of the ends gives
    13.2 mV at most.
    - A resonance read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
    [test_freqplan.py, test_simgate.py, test_verify.py]
2026-11-11 Documents follow the review fixes; the template asks each part's model
    The documents say what the gates do after the review fixes: the simulate
    skill's "Corners", "The frequency plan" and "A deck on another machine",
    the verification and board-gates skills, WORKCENTER.md, CONFIGURATION.md,
    README.md, the fixtures' table.
    templates/project/design.py turns check_sim on. A small model proved a
    filter with its op-amp written as 2 sources in the deck, and every gate
    passed. A part added to the template now says how it simulates, or why it
    does not, before a file is written.
    tools/hooks/install_hooks.py installs both agent hooks into a user's
    settings. It knew only the no-cd hook, so a session w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
    [design.py, test_designfile.py, test_freqplan.py, test_kicadgen.py]
2026-11-11 A website, a mark and an Open Graph image for the repository
    The owner asked for a professional open-source face that relies on the
    kit, and for a site in the look of the apparatus site.
    - site/: 1 static page (index.html, site.css, site.js), the mark as
    favicon.svg, 404.html, og.html and its captures og.png and og-dark.png
    (1280 x 640), Inter's latin file with its license, build.sh for any
    static host, vercel.json for Vercel. No install step.
    - README.md opens with the picture, 2 runs on fixture boards and 2
    badges. It gains The website, Where things stand and License.
    - tests/test_docs.py goes from 9 to 14 tests: each run a document shows
    against a fresh run of its command, ever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
    [test_docs.py]
2026-11-11 The site says the project's aim, with its evidence and what is open
    A section "Any agent": the aim that a small model reaches the same
    working board as a large one, the small model's run of 2026-11-11 (38
    tool calls, 8 traps, each but 1 now a line to write), the engineer's
    85 C finding that became the corners, and the trap that has no gate
    yet. Each sentence is from DEVLOG.md or ROADMAP.md.
    CI.md names the Vercel setting that skips a push which leaves site/
    unchanged. The link guard in tests/test_docs.py follows a fresh count:
    13 links to the repository, 8 into the page.
    Evidence: tests/test_docs.py, 14 passed.
    [test_docs.py]
2026-11-11 The page and the README say what the contract says, no more
    I read each sentence of the page against WORKCENTER.md and the
    simulate skill. 4 said more than the code does:
    - "A gate that did not run is never a pass": a gate with nothing to
    run does not stop GREEN. The contract's line is about an absent
    engine, and the page now says that.
    - SIM holds a value "as written and at each corner", as the skill says.
    - The tolerance card: both ends and half-way, every combination up to
    64 runs, a worst case above that, and the Monte Carlo draws the
    project names. The README's bullet says the same now.
    - The command line is not 1 file. It needs only the standard library.
    README.md and site/RE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
2026-11-11 Commits name the owner alone; the rule, its test and the record
    The owner had every branch collapsed into main and every commit name
    the owner as its author.
    - tests/test_docs.py: a test fails on a commit of the checkout that
    names an assistant as author or committer, or whose message credits
    one. It proves itself first on a history it builds: 4 credits found
    in 5 commits, none in the 2 that only name a file or a person.
    - AGENTS.md and CLAUDE.md at the root, ee-agent-kit/AGENTS.md,
    CONTRIBUTING.md and TONE.md state the rule.
    - P33: rewriting a history that is already pushed. M123: the first
    rewrite added a newline to 1 message that had no line to lose.
    - STATUS, ROADMAP, CHANGELO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
    [test_docs.py]
2026-11-11 M124: the machine ran out of memory under my own jobs; P31 step 6
    The health gate, 2 helpers that ran chip engines and a browser ran
    together on a machine with 15 GB of memory. It restarted. No file and
    no push was lost; the gate and both helpers started again.
    P31 step 6: count the machine's memory too. The health gate that
    gates a push runs alone.
    Evidence: the restart at 06:39 UTC on 2026-11-11; the gate then ran
    alone and printed VERIFY GREEN with 527 tests.
2026-11-11 The README and the site open with a board, built from a design file
    The owner asked again for the repository to look good. The README's
    first screen was text under 1 banner. It now shows a board: lines of a
    design file, the schematic and the routed board that `workcenter design`
    writes from the file, 2 runs of the gates, the board turning and its
    layers. What the workcenter does is a table, the diagram shows a run,
    the quick start takes a first board from the template to its gates, and
    the 24 commands and the repository map fold away.
    The board is a new fixture, tests/boards/pass-first-design: the
    template's design file, built, with a deck of 2 bounds. It is the first
    fixture that goes from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
    [divider.kicad_pcb, divider.kicad_sch]
2026-11-11 An example project, Rosetta, and a site that moves
    Rosetta (examples/universal-controller/v0.1) is a game controller whose
    5-position knob picks a PS4, a PS5, an Xbox, a Switch or Bluetooth: a routed
    4-layer board in a controller's outline, 140 parts. An RP2040 runs a second
    USB port in software to relay a console's signature to a licensed donor; an
    ESP32 hangs its antenna over the gap between the grips; Hall-effect sticks
    and triggers on a 12-bit ADC, trigger motors, 2 haptic drivers, an IMU, a
    ring of RGB LEDs round the knob.
    Evidence: `workcenter gates examples/universal-controller/v0.1` GREEN with
    5 warnings (silkscreen of the receptacles and the module over the edge they
    hang past); 6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
    [rosetta.kicad_pcb, rosetta.kicad_sch]
2026-11-11 The favicon is the site's wordmark
    The favicon was the old mark, a via in cross-section. The header, the
    footer and the Open Graph image moved to the wordmark in logo.svg; the
    favicon stayed behind.
    favicon.svg now holds the paths of logo.svg in a square viewBox
    (283 73 394 394), with the same light and dark colours. favicon-32.png
    and apple-touch-icon.png are drawn again from it. The touch icon's
    wordmark is 148 px wide on its 180 px square; at 112 px, the old
    size, it read small. site/README.md gives the new rsvg-convert sizes.
    Evidence: tests/test_docs.py 15 passed, 1 skipped (it needs kicad-cli
    and ngspice). site/build.sh copies the new favicon.svg. I drew the PNGs
    with the session's h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
2026-11-11 Signet v0.1: a mouse worn as a ring, on 6 tiles round the finger
    A new example project, examples/ring-mouse, kept as version folders the way
    Last Hit keeps its prototypes. v0.1 is 6 small boards on the faces of a
    hexagonal ring that touches a 20 mm cylinder: radio (STM32WB5MMG, 4 layers,
    15.6 mm wide), touch (a 3-channel scroll strip, 4 layers), clicks (2 KMR2),
    cell (the pouch's tabs; charging pads on the inner face), power (MCP73831,
    TPS7A0533, the cell's gauge) and motion (LSM6DSL). Each tile is a nested
    project built from its design.py on a shared ring.py; neighbours join through
    8 plated edge pads whose nets both tiles read from one list.
    Evidence: every tile GREEN (radio with 2 legend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
    [signet_cell.kicad_pcb, signet_cell.kicad_sch, signet_clicks.kicad_pcb, signet_clicks.kicad_sch, signet_motion.kicad_pcb, signet_motion.kicad_sch, signet_power.kicad_pcb, signet_power.kicad_sch]
2026-11-11 Signet v0.2: black faces, solder in the joints, the cursor
    The first pass of the loop (examples/ring-mouse/LOOP.md) judged v0.1: the
    2-layer tiles poured ground on both faces, which showed olive through the
    black mask; the joints held no solder in the pictures and the cell was a
    white block; the outer faces said nothing; nothing turned the gyro into
    cursor motion. v0.2 makes every tile 4 layers with ground only on In1,
    draws a fillet over each of the 48 joint pads and a foil pouch with its
    Kapton band and tabs, marks L and R and the name, and adds
    firmware/src/air.c: the reading turned back from the motion tile's -66.36
    degrees, a deadband, a gain and the strip as a clutch.
    Evidence: every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
    [signet_cell.kicad_pcb, signet_cell.kicad_sch, signet_clicks.kicad_pcb, signet_clicks.kicad_sch, signet_motion.kicad_pcb, signet_motion.kicad_sch, signet_power.kicad_pcb, signet_power.kicad_sch]
2026-11-11 Signet v0.3: a light the wearer sees, a guard on the charging pads
    The second pass of the loop judged v0.2: the light sat on the touch tile
    under the thumb; the joint pads stood 0.3 mm apart along the edge, close
    enough for a fillet to bridge; the charging pads touch the world on the
    ring's inside with nothing to take a static discharge; the solder beads
    read as dark spikes. v0.3 moves the light to the motion tile by the name,
    driven from PA1 through the motion-radio joint; makes the joint pads
    0.8 mm along the edge; adds D1, a TPD1E05U06, between VCHG and ground on
    the cell tile; and draws smaller beads. On the power tile VBAT is drawn
    by hand: with the new pads the router left it in 2 piec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
    [signet_cell.kicad_pcb, signet_cell.kicad_sch, signet_clicks.kicad_pcb, signet_clicks.kicad_sch, signet_motion.kicad_pcb, signet_motion.kicad_sch, signet_power.kicad_pcb, signet_power.kicad_sch]
2026-11-11 Signet v0.4: a ring that closes
    The third pass of the loop measured the assembly against the boards'
    geometry. The radio tile's 2 joints did not close: a hexagon whose faces
    all touch the finger closes only when its alternate faces add up equally,
    and with the radio at 15.6 mm and 5 equal tiles its corners stood 1.3 mm
    out from its neighbours'. v0.4 gives each joint 1 tangent length, from the
    shared corner to where either face touches the finger: the radio's and
    the cell's are half their widths and the 2 between close the circle. The
    touch and motion tiles grow to 12.176 mm, the clicks and power tiles
    narrow to 9.786 mm, and ring.py refuses to load if any 2 neighbours miss
    their shared corne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
    [signet_cell.kicad_pcb, signet_cell.kicad_sch, signet_clicks.kicad_pcb, signet_clicks.kicad_sch, signet_motion.kicad_pcb, signet_motion.kicad_sch, signet_power.kicad_pcb, signet_power.kicad_sch]
2026-11-11 Signet in the README; renders in the stackup's colours; P34
    The root README shows the second example project, Signet
    (examples/ring-mouse), turning. Its work found 3 things in the
    workcenter:
    - workcenter render and tools/scene.py drew every board in kicad-cli's
    preset green with tin pads, whatever its stackup named: kicad-cli takes
    the board's colours only with --use-board-stackup-colors. Both pass it
    now, and a test in tests/test_gates.py holds every 3D render the gate
    asks for to the flag (it failed before the fix).
    - install.sh fetched the KiCad PPA's key from keyserver.ubuntu.com alone;
    some proxies reset every connection there. It falls back to
    Launchpad's API, and the fin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
    [test_gates.py]
2026-11-11 Rosetta v0.2: the controller on an Xbox 360-style board
    The example controller as a controller's own main board, 148 x 82 mm, 6 layers, 135 parts.
    Thumbsticks solder on through a project footprint written from ALPS's mounting-hole drawing for
    the RKJXV122400R, which Hall-effect sticks share; the drawing's prohibited wiring area is a
    keep-out. Linear Hall sensors read the triggers on the shoulder horns, right-angle bumpers stand
    on the horns' edge, 2 rumble motors plug in at the grips, both USB-C ports open through a tab at
    the bottom, and the ESP32's antenna hangs past the dip between the horns. 5 links are drawn by
    hand, each probed clear.
    Evidence: `workcenter gates examples/universal-con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
    [rosetta.kicad_pcb, rosetta.kicad_sch, thumbstick_pins.csv]
2026-11-11 kicadgen wires banked symbols on an A0 sheet and checks vias on a grid
    A motherboard's processor has thousands of pins, drawn as banks side by
    side on one A0 sheet. The wiring blocked the banks' whole bounding box,
    so a pin facing the next bank had no free cell and the sheet stopped
    ("cell beside its end is taken"). symbol_banks() finds 2 or more body
    rectangles that touch nothing else and the wiring blocks each on its
    own; any other symbol keeps its one box. kicadgen writes an A0 sheet.
    Design.check_vias held every via to every pad, via and track: a socket's
    3457 vias took 63 s. Each item is now filed in a grid within the
    farthest distance any rule asks of a via, and each via is held to th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
2026-11-11 Basalt v0.1: a microATX Threadripper board's floor plan and power
    An example of what the workcenter makes: Basalt, a microATX (244 x 244
    mm) motherboard for an AMD Threadripper 7000 or 9000 on sTR5, kept as a
    prototype series in examples/threadripper-matx/ and built in a loop
    logged in its LOOP.md.
    v0.1 places every part the ATX 2.2 and CEM 4.0 drawings fix: the
    socket's 4844 lands on a stand-in pin map (AMD's is under NDA), 4 DDR5
    RDIMM slots, 3 PCI Express x16 slots, 2 M.2 sockets, the 24-pin and 2
    EPS connectors, the rear I/O under a grooved cover, 9 mounting holes.
    14 phases of TI CSD95490Q5MC stages and XAL1010 chokes, drawn from the
    stage's land pattern. Every supply is drawn as a mot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
    [basalt.kicad_pcb, basalt.kicad_sch, csd95490q5mc.csv, csd95490q5mc_land.csv, ddr5_rdimm.csv, jk0654219nl.csv, m2_key_m.csv, pcie_x16.csv]
2026-11-11 A third example: Herald, a fire alarm communicator
    examples/fire-alarm-communicator/v0.1: an 84.4 x 64 mm 4-layer board,
    127 parts, every part on the front, red with a white legend and black
    terminals. It answers a fire panel's dialer as its phone line (loop
    feed, off-hook sense, tones from a PWM pin, DTMF read by an ADC),
    reads 3 supervised inputs, holds a fail-safe trouble relay, and
    reports over a Quectel BG95-M1 (LTE-M) with an ESP32-S3's Wi-Fi as
    the second path.
    Gates GREEN with 7 warnings (terminal and USB silkscreen at the edge):
    ERC 0, DRC 0 errors and 0 unconnected, 8 decks and 573 corner runs,
    24 gerbers. The firmware's zone classifier, hook, Goertzel DTMF decoder
    held to ITU-T Q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
    [herald.kicad_pcb, herald.kicad_sch, pt15_2_bk.step, pt15_3_bk.step, pt15_4_bk.step]
2026-11-11 Basalt v0.2: the DDR5 buses, drawn by rule
    v0.2 joins the processor's 4 memory channels to their slots: 576
    traces, 144 a layer on F.Cu, In2, In3 and In6, drawn by buses.py from 4
    rules (lands and pins paired in order on each layer, a 45 degree escape
    into the gap below each land's row, a comb column of its own beside the
    socket, a lane half a pin pitch off the pin's line through the slots'
    vias). 864 bus vias; the memory bands' unused lands are ground. Lengths
    15.8 to 68.7 mm; inside a byte lane the spread is 0.5 mm at the median
    and 12.3 mm at most, not tuned yet. The bus nets are labels on the
    sheet. v0.1's banner says it is archived.
    Evidence: workcenter gates v0.2 GREEN with no warning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
    [basalt.kicad_pcb, basalt.kicad_sch, csd95490q5mc.csv, csd95490q5mc_land.csv, ddr5_rdimm.csv, jk0654219nl.csv, m2_key_m.csv, pcie_x16.csv]
2026-11-11 Hush: a speaker that cancels noise (examples/anc-speaker/v0.1) (#49)
    examples/anc-speaker/v0.1 is another example project: a ring 62 mm
    across on the face of a 40 mm speaker driver, a MEMS mic on its hub
    4 mm from the cone, and an analog feedback loop that plays the inverse
    wave. Music from a line input plays through the loop as its target.
    4 layers, 62 parts on the front; the back draws the noise and its
    inverse meeting as one line, with gold rims round the windows.
    workcenter gates: GREEN with 6 warnings. 7 decks, 986 corner runs:
    3.0 dB less noise at 50 Hz and 12.2 dB at 300 Hz at the worst corner.
    Polished in a Ralph loop of 3 iterations and 2 fresh review rounds
    (examples/anc-speaker/L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
    [hush.kicad_pcb, hush.kicad_sch]
2026-11-12 Wyvern: a Teensy with a Snapdragon (examples/snapdragon-dev-board/v0.1) (#50)
    A fifth example project, examples/snapdragon-dev-board: Wyvern, a
    development board the size of a Teensy (60.96 x 30.48 mm, 2 rows of 24
    pins) with a Snapdragon 845 on Lantronix's Open-Q 845 uSOM on 3 DF40
    sockets. An RP2350 under the module drives the pins at 3.3 V; the
    Snapdragon resets and flashes it over USB. One USB-C port carries power,
    USB 3.1 and DisplayPort over 5 hand-drawn 90 ohm pairs that never cross.
    6 layers, black mask, ENIG. Laid out as a board repository: series
    README, version folder, parts/ priced, library/sources.csv, CONTENTS.md,
    docs/gates.md, pictures with the module on its sockets.
    workcen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
    [catalog.csv, v0.1.csv, wyvern.kicad_pcb, wyvern.kicad_sch]
2026-11-12 Basalt v0.3: the ports and headers a modern board carries
    The owner asked midway for "I/O, M.2, SSD, RGB light controller, fan
    speed port ... CMOS battery". v0.3 adds 77 parts in the right column and
    along the bottom edge (ports.py): 4 right-angle SATA plugs on the right
    edge (Adam Tech SATA-A-PL-SMT-K, a project footprint and body), 5 fan
    headers driven by a Microchip EMC2305 at SMBus 0x2C, an ARGB header
    through a 74AHCT1G125 and a 12 V RGB header on 3 AO3400A, an STM32G0B1
    board controller with its pin plan from ST's pin data, 4 status LEDs, a
    W25Q128 BIOS flash, power and reset buttons with a 3.3 V standby rail
    from +5VSB, the CMOS battery with its BAT54C and clear jumper, the
    front pane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
    [argb_header.csv, basalt.kicad_pcb, basalt.kicad_sch, csd95490q5mc.csv, csd95490q5mc_land.csv, ddr5_rdimm.csv, jk0654219nl.csv, m2_key_m.csv]
2026-11-12 Basalt in the README, the devlog and the status; M133 and M134
    The root README shows Basalt's v0.3 from the slots' corner and says what
    each version added. STATUS, CHANGELOG, ROADMAP and the devlog name the
    example and what is open: the PCI Express and M.2 lanes.
    M133: a render stopped by the background job limit; P23 step 7.
    M134: 11 courtyard overlaps in a first placement read as routing
    failures; P4 step 4.
    Evidence: make verify, run after this commit.
2026-11-12 Herald is the site's example, copper first; cards for the examples (#52)
    The section after the hero is Herald's, where Rosetta's was. Its board is
    drawn from its design file and routed board, the copper first: every
    track of its 3 signal layers in copper on a deep red, swept in a layer
    at a time, the parts as faint outlines. 5 signals each light their
    parts, their path and their status light, beside the reading its deck
    measured at every corner and the firmware's threshold. 8 hard parts, its
    renders, its layers and its gates run follow, and the page says what the
    firmware does not do yet.
    The section of boards built with Via holds Herald, Hush, Signet,
    Rosetta, Wyvern, Agentcast and the fix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
    [test_docs.py]
2026-11-12 The site speaks to its reader; Herald's parts each labelled (#53)
    Every headline is 1 plain sentence that says what the reader gets, with
    no slogans, and the text names each check by what it does. The fixture
    boards left the page: the hero shows Herald, design as code shows
    Herald's supervised inputs as code, schematic and routed board, and the
    gallery holds the 6 example boards. og.png carries the new headline and
    Herald; docs/STYLE.md gains a website section.
    The invented signal paths are gone. Each of Herald's 127 parts is
    labelled in turn, 4 or fewer at a time, with a leader to a label built
    from Via's own files: the design file, KiCad's library, the README and
    the gates' report.
    The c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
    [test_docs.py]
2026-11-12 The README after a review; the router starts at once; doctor names what is absent
    A reader who had not written the README's front page checked each
    sentence of it by a command: 32 findings, 4 of them false statements
    (M160). This commit stands on main as it was on 2026-11-12, 21 commits
    after the tree the review read. The site's page was written anew there,
    so the findings about the old page are gone with it.
    Tools:
    - `design --route` and `autoroute` start FreeRouting with `-dct 0`.
    Release 1.9.0 waited 20 s before each route for a click on a dialog.
    The session file is the same; the template routes in 6 s, not 25 s.
    - The session merge writes a segment 1 time where 2 wires of the
    rou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
    [divider.kicad_pcb]
2026-11-12 The website, redrawn: drawings, the agents, a page per example
    The owner asked for the site to look better, with the text-to-cad site
    as the reference, and to see it on a branch.
    The home page opens with the wordmark built as a board is: sketched,
    its corners set, its copper laid, its traces run. Under it are the
    install line and a strip of the 21 agents text-to-cad lists, which
    drifts and which a mouse, a swipe or the arrow keys move. The gates
    are 6 drawings in ink on dotted paper, each of a board in the
    repository that a gate stopped, with the numbers its run printed. The
    examples are cards in 3D. The page has 7 sections where it had 11, and
    the accent is a steel blue.
    Each example has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
    [test_docs.py]
2026-11-12 The site: Herald in 3D, its labels 1 every 3 seconds, the owner's headline (#59)
    Herald's render becomes a 3D model the reader turns: KiCad's VRML export
    of the routed board, a 0.6 MB meshopt GLB written by make_glb.mjs, shown
    with model-viewer 4.4.0. The page loads neither until the reader comes
    within 600 px; the render stands in until the model draws.
    The labels come in 1 every 3 seconds, each leader a diagonal then a level
    line, with the first page of the part's datasheet where its maker serves
    the PDF (datasheets.py). The status line and the pause buttons are gone.
    On a phone the labels stack in their turn's order.
    The hero reads "Circuit Boards / From / AI", the footer says the site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
2026-11-12 Wyvern v0.2: one flat board with a QCS6490 module soldered on (#60)
    examples/snapdragon-dev-board/v0.2: one board, 76.2 x 53.34 mm, 6 layers,
    2 rows of 30 pins. Vantron's VOSM6490 (QCS6490) is soldered on by its 662
    OSM Size-L pads, generated from SGET's contact map and equal to Antmicro's
    open footprint; its symbol draws the pins as 13 banks. A TPS552892
    buck-boost holds the module's 4.8 to 5.2 V from any USB-C cable (4.86 to
    5.17 V at every corner), an HD3SS3220 owns CC and switches the module's
    SuperSpeed lane, and v0.1's RP2350 block is turned a quarter turn.
    `workcenter gates v0.2` GREEN with 16 warnings: DRC 0 errors, 0
    unconnected, 0 parity; 7 decks, 397 corner runs. The router drew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
    [catalog.csv, osm_l_pins.csv, v0.1.csv, v0.2.csv, wyvern.kicad_pcb, wyvern.kicad_sch]
2026-11-12 Install the chip engines on request (INSTALL_CHIP=1)
    First commit of the chip branch (ROADMAP item 1: a chip from RTL to a
    mask layout). A board needs none of these engines, so the step is opt-in:
    `sudo INSTALL_CHIP=1 ./install.sh`, or `sudo ./install.sh --chip` for the
    step alone.
    It installs Yosys, Icarus Verilog, Verilator and KLayout from Ubuntu's
    archive, and under $WORKCENTER_ROOT/chip: OpenROAD f12e2f47 with OpenSTA
    2.3.1, Magic 8.3.465 and Netgen 1.5.272 from conda lock files, and the
    sky130A process kit at open_pdks commit 6d4d117 through ciel 3.2.0. Every
    download is pinned. The step makes stable names for the gates: chip/bin/
    for the 4 engines, chip/pdk/sky130A for the kit.
    Run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
2026-11-12 Chip spine: readers, process table, corners, driver, chip init
    tools/chipflow.py is what the 10 chip gates share (ROADMAP item 1). The
    gates themselves come next; a gate that is not built is skipped, and a
    chip run with a gate that did not run is SKIPPED with exit code 2.
    - chip.json is read against the keys it may hold: an unknown key, a number
    without its source and text the template left as `fill:` are each a
    problem line.
    - The constraints are Tcl, so they are read against a list: 12 commands,
    7 queries in brackets, no variable, no second command on a line, a
    source on each line with a number, 1 clock, a delay for each port.
    - pdks/sky130A.json holds everything a gate needs from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
    [__TOP__.v, tb___TOP__.v, test_chipflow.py]
2026-11-12 Chip gates LINT, SIM, SYNTH and GLSIM
    tools/chipfront.py holds the 4 front gates. Each is a judge that reads
    what an engine wrote and a runner that starts the engine through the
    spine. The judges are held to real reports in tests/chips/samples/front/.
    - LINT: Verilator. 13 warning classes fail (a latch, 2 drivers, a loop,
    an open net, a width cut); every other class is a warning. A comment
    that turns off a failing class fails: Verilator obeys it and prints
    nothing. The top module's ports are read from Verilator's XML and held
    to the constraints: each port has its delay.
    - SIM: Icarus Verilog. A bench passes when it reaches $finish and prints
    errors 0, x_outputs 0 and checks made;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
    [test_chipflow.py, test_chipfront.py]
2026-11-12 Chip gates LAYOUT, STA, DRC, ANTENNA, LVS and EXPORT: first version
    tools/chipback.py holds the 6 gates behind SYNTH, and
    tools/chipscripts/ their engine scripts: OpenROAD for the floorplan,
    the supply grid, placement, the clock tree and routing; Magic for the
    GDS, the DRC and the extraction; KLayout for the second DRC deck;
    OpenSTA at every selected corner; Netgen for LVS. EXPORT copies what
    the gates judged into chip/tapeout with a manifest of hashes.
    The supply grid's pitch follows the core where the table's pitch is
    larger than the core, and the build checks the grid: 1 stripe on a
    23 um core left a rail open and LVS failed on the pin match.
    GLSIM no longer reports the simulator's note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
    [test_chipfront.py]
2026-11-12 Chip back gates: a record of each pass, judges held to real reports, chip render
    The first version of LAYOUT, STA, DRC, ANTENNA, LVS and EXPORT had no
    tests. A helper rebuilt them against the engines and found that they
    passed what they should fail:
    - LVS red on swapped nets, then `chip export` passed and the run was
    GREEN. DRC red on 2 boxes, then EXPORT passed. Each back gate now
    writes chip/<gate>/passed.json only on a pass, with the hash of each
    file it judged, and EXPORT copies a file only when every gate that
    judges it holds such a record for those bytes.
    - A report with a part left out passed: no area line, no nets line, no
    skew. Each absent part now fails.
    - Netgen's final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
    [test_chipback.py, test_chipflow.py]
2026-11-12 Fixture chips: a counter, 7 chips with 1 fault each, the 8-bit processor
    tests/chips/ gains 9 projects, and tests/test_chips.py holds each to
    its run:
    - pass-counter: GREEN with --strict; its GDS is the one its gates judged.
    - 7 failing chips, each the counter but for the files of 1 fault, each
    red at 1 gate with every gate before it passing: LINT (a latch; a
    second clock), SIM, SYNTH (a flop with no reset), LAYOUT (a die too
    small), STA (a slow corner), GLSIM (an X at an output).
    - pass-acc8: the acceptance processor, 770 cells, 4 programs in a ROM,
    5 benches with 1098 checks. LINT, SIM, SYNTH and LAYOUT pass. STA
    fails at 13 of 15 corners, because the build repairs no slew. The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
    [acc8.v, acc8_core.v, acc8_regfile.v, counter.v]
2026-11-12 Chip round 1 in the kit's record; 6 landmine rows on the chip engines
    The roadmap's item 1 said that the chip gates were not built. They run,
    and tests hold each. STATUS.md gains the row, with what is open; the
    changelog and the devlog tell the round. WORKCENTER.md names what a
    chip project's output folder holds.
    The landmine map gains 6 rows that the back gates' samples prove, each
    a way an engine lets a fault read as none: OpenSTA's read_spef and its
    digits, OpenROAD's link_design and report_design_area, Magic's exit
    code, Netgen's final result.
    tests/chips/README.md: runs in tests/test_chipback.py hold what EXPORT
    refuses; no sample does (a checker's note).
    The 2 mistakes of this round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
2026-11-12 The processor is GREEN: a build that repairs, records of every file, true counts
    The acceptance processor passes all 10 chip gates with --strict: 760
    cells and 132 flops on a die of 152.38 um by 152.38 um, a 40 ns clock,
    least setup slack 25.1717 ns at max_ss_n40C_1v60, least hold slack
    0.2974 ns at min_ff_n40C_1v95, 217 s on 4 processors. In round 1 STA
    failed 13 of 15 corners, KLayout's deck counted 8 items and 1 net
    collected too much charge. The gates were right and the build was short.
    The build:
    - SYNTH maps without the cells the process kit lists as not to use
    (mapping.lib: Yosys 0.33 has no flag for it).
    - LAYOUT reads every library corner the project's ranges select and
    repairs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
    [test_chipback.py, test_chipflow.py, test_chipfront.py, test_chips.py]
2026-11-12 A chip's one next step; SIM proves the benches with the list of changes
    `workcenter next <project>` answers for a chip project, a folder with
    chip.json, as it does for a board: what to do, the command, why, what to
    read, when the step is done. tools/chipguide.py reads chip.json, the
    engines and the process kit, the RTL, a bench, the gates' report, its
    first failure and its first warning, and starts no engine. In a test its
    answers alone take the template from `chip init` to `GREEN: reg8` with
    --strict.
    2 skills hold the procedure: chip-design writes the project (chip.json,
    the RTL, a bench, the constraints, the list of changes), and chip-gates
    drives the 10 gates, with a table of lines and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
    [test_chipfront.py, test_chipguide.py, test_chips.py, test_guide.py]
2026-11-12 The chip guide after a small model's run: the example files, the 2 limits, the README
    A small model built a chip of its own, an 8-bit PWM, with `workcenter
    next` alone: 12 answers, 11 runs of the gates, about 5 minutes. All 10
    gates passed. SIM's list of changes did its work on the way: 5 of the
    model's 9 changes survived its first bench, and it wrote the checks that
    caught them. It stopped at --strict, on the one answer it could not
    follow: "Name a limit for the clock skew", with no word on where such a
    number comes from. It did not invent one.
    What its log showed, and what changed:
    - `chip init` writes a working register and its bench as examples, and
    the first answer was "Run the chip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
2026-11-12 A reviewer's 15 cases against the chip gates, each a test; the chip work ships
    A reader who had not written the chip gates built cases they must fail
    (P14 step 6) and found 15 in 36 minutes. 7 times a gate passed what it
    must fail, 2 times EXPORT handed out the old layout after a file had
    changed, 1 record named a clock period the engines did not take, 3 times a
    gate failed a sound project, and 2 answers of `workcenter next` were
    false. Each case is a test now, and each test failed on the code before.
    The gates ask the engine what it read:
    - A header named `` `include"x.vh" `` with no space, or through a macro,
    was in no record. Verilator lists each file in its XML, Icarus Verilog
    with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
    [test_chipback.py, test_chipflow.py, test_chipfront.py, test_chipguide.py]
2026-11-13 Last Hit v0.17's mistakes (M171 to M180); the SIM gate fails a crowded altermod (#57)
    Last Hit v0.17 made 10 mistakes, now M171 to M180. 2 asked for checks:
    - ngspice 42 applies only the first parameter of an `altermod` line and
    drops the rest with exit 0. Last Hit's heater deck switched its
    protection switch to the maximum model with 5 parameters on 1 line
    from v0.14 to v0.16, so the "maximum" case moved the threshold only
    (M172). `simcorners.crowded_altermods` names such a line; the SIM gate
    fails its deck, `workcenter next` points at the simulate skill's rule,
    and the landmine map has the row.
    - `workcenter costs` failed on a board repository's CLAUDE.md, whose
    sentence nam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
    [test_corners.py, test_doctools.py, test_guide.py, test_simgate.py]
2026-11-14 Site: lighter example pictures, Hush's openings clear, Signet led by its card
    Each example picture is written in 256 colours with a clear palette slot,
    at most twice as wide as a page shows it: a card is 23 to 78 KB, from up to
    944 KB, and iso.png, which no page showed, is gone. A board with openings of
    25 mm² or more through its outline has the backdrop it encloses taken out,
    with the shadow round it, so Hush's ring shows the page through its
    windows. A turning render whose frames cut the thing off is left out, and
    the card's picture leads the page instead (Signet).
2026-11-14 Site: Herald's labels 4 at a time, 1 swapped every 3 s; the owner's words
    The owner asked for Herald's labels to show 4 at all times and swap 1 for
    the next every few seconds. 2 stand on each side; the sides take turns,
    and a side's older label gives way to its next part, which takes its
    number. A side's labels stand in the order of their parts down the board,
    or the other way up where their leaders would cross. The label that stays
    slides with its leader, and the stage grows below the board for 2 tall
    labels, so the board never moves. A label's number now orders it only
    where the labels stack under the board: beside it, the number had put
    label 1 on top whatever its part's place.
    The hero'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
2026-11-14 Site: Herald's labels end in an ellipsis where they would not fit
    The owner asked for a label too tall for its place to end in an ellipsis.
    Beside the board a label stands at most half the board's height: where its
    room ends, its text keeps the lines that fit and ends in an ellipsis, and
    the rows under it and the datasheet's link are left out (its picture still
    links it). Where no line of a row fits, the row goes and the text above it
    ends in an ellipsis. A side's 2 labels always fit beside the board, so the
    stage keeps its height and the board never moves: all 127 labels, brought
    in 1 by 1, keep the stage at 451 px at 1280 px wide and 373 px at 1100.
    Stacked under the board on a narrow scre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
2026-11-14 The day's record: the site's pictures, Herald's labels, the owner's words
    The devlog's entry for 2026-11-14 gains the work after the merge: the pictures in 256 colours, Hush's openings, Signet led by its card, Herald's 4 labels with 1 swapped every 3 s and cut with an ellipsis, and the owner's words on the page. It says where the backdrop opening runs now, and what the tests and Chromium showed.
2026-11-14 The Open Graph image shows Herald's board as the page draws it
    The owner asked for the share card to show the board's layers on the
    page's own paper, not the 3D render. og.html holds the drawing the home
    page shows, from Herald's file, its copper over the board, with no frame,
    and og.png is drawn from it again (1280 x 640, 199 KB). draw_face.py
    writes the drawing into og.html as well as index.html, without the labels'
    data; written again from the current drawing, both pages come back byte
    for byte. showcase/herald.png, which only og.html showed, is gone.
