ThyFriendlyFox/via/(notices)

Notices in the files:
examples/fire-alarm-communicator/v0.1/models/pt15_2_bk.step:
Recoloured from KiCad's TerminalBlock_Phoenix_PT-1,5-2-3.5-H_1x02_P3.50mm_Horizontal.step: the body black (PT 1,5 ... BK). CC-BY-SA 4.0, as below.
Copyright (C) 2026, KiCAD
This work is licensed under the
[Creative Commons CC-BY-SA 4.0 License](https://creativecommons.org/licenses/by-sa/4.0/legalcode),
with the following exception:
project files under this or any other license agreement. However, if you wish to distribute
examples/fire-alarm-communicator/v0.1/models/pt15_3_bk.step:
Recoloured from KiCad's TerminalBlock_Phoenix_PT-1,5-3-3.5-H_1x03_P3.50mm_Horizontal.step: the body black (PT 1,5 ... BK). CC-BY-SA 4.0, as below.
examples/fire-alarm-communicator/v0.1/models/pt15_4_bk.step:
Recoloured from KiCad's TerminalBlock_Phoenix_PT-1,5-4-3.5-H_1x04_P3.50mm_Horizontal.step: the body black (PT 1,5 ... BK). CC-BY-SA 4.0, as below.
